ProtoControl/ProtoControl/38_ProtoControl_SD_Fall2023/Software Files/ProtoControlTraining/test/images/IMG_0676_jpg.rf.61e201d2a6559030aaa2d4f4d18f1fff.jpg

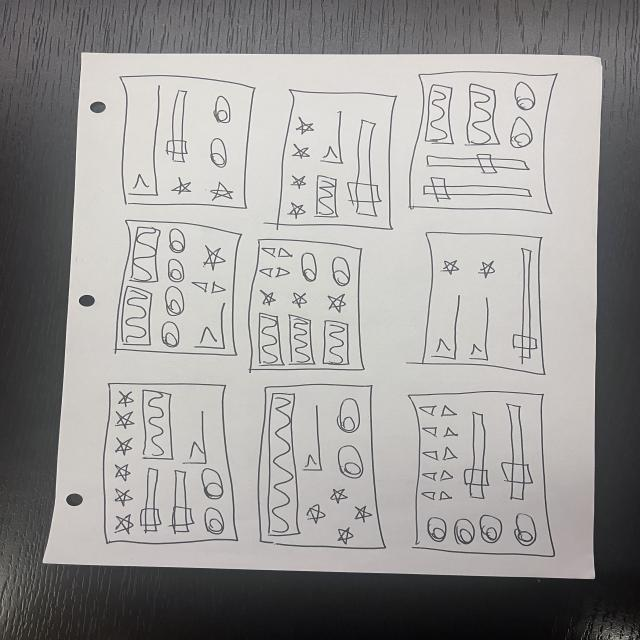
38_ProtoControl_SD_Fall2023/Software Files/ProtoControlTraining/test/images/IMG_0676_jpg.rf.61e201d2a6559030aaa2d4f4d18f1fff.jpg
