ProtoControl/ProtoControl/38_ProtoControl_SD_Fall2023/Software Files/ProtoControlTraining/train/images/IMG_0674_jpg.rf.0b7a89d2eb10f9125c6ddc7b88505ba1.jpg

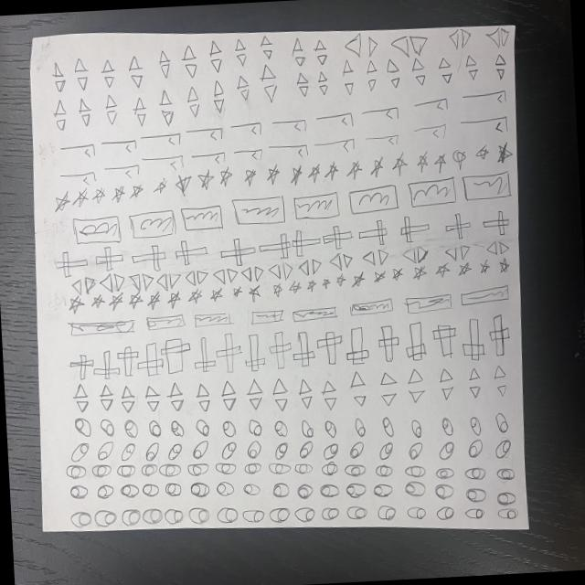
38_ProtoControl_SD_Fall2023/Software Files/ProtoControlTraining/train/images/IMG_0674_jpg.rf.0b7a89d2eb10f9125c6ddc7b88505ba1.jpg
