ProtoControl/ProtoControl/38-Protocontrol-main/SEM 1/README.md

**ProtoControl Website**
- Current Features:
    - Basic HTML/CSS/JS webpage to serve as proof of concept
    - Angular app in early stages of development
