ProtoControl/ProtoControl/38-Protocontrol-main/SEM 1/BasicSite/v1/README.md

*Currently a work in progress!!*
- Canvas logic needs polishing
- Exists to serve as proof of concept
