ProtoControl/ProtoControl/38_ProtoControl_SD_Fall2023/DEMO DAY POSTER/Poster_485_38_Protocontrol.pptx

Problem Statement

User Interfaces are one of the most expensive and time-consuming part of product development and have a steep learning curve.

A plug and play panel with a start-to-finish user interface development experience
Team: Parker Sexton, Kelly Mae Allen, Will Wood, Nida Kosedagi, Abisha Fenn
Mentors: Professor Jim Carlson

System Requirements

- Two wire user interface
- Touchscreen Display
- Interchangeable tactile buttons, knobs, and sliders
- Protective enclosure
- Wide MCU compatibility
- Custom PCB for Main Board and Peripherals
- Cost ~ $100

User Flow

User Designs Layout

Website Generates String

Device requests profile

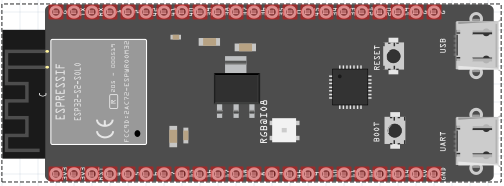
[picture p8: figure]

ESP 32

String decoded into components

User
System

System Architecture Diagram

Draw components from website

Register input from i2c and touchscreen

Send output data

Receive input data

Send status over UART

Website

Design Challenges

- Dynamic Code Structure
- Customizability
- Sharing Profile over Wifi
- Refreshing Profiles on Touchscreen
- Minimal/Intuitive Coding for User
- Hot Swapability of I2C Components
- Compatibility of Arduino Libraries
- Pogo Pin Enclosure

UART

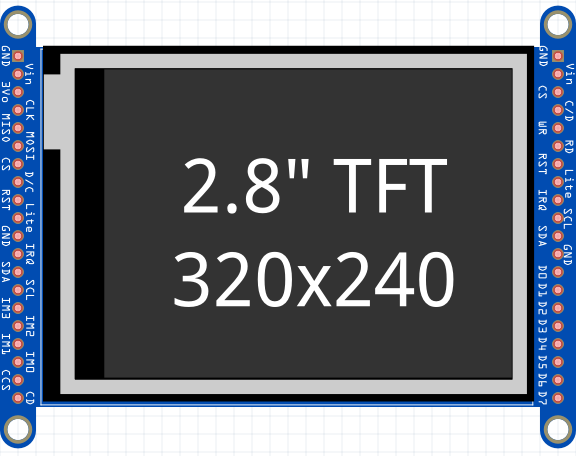
[picture p9: figure]

Peripherals

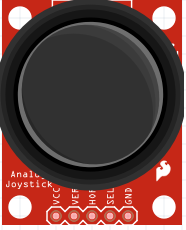
[picture p10: figure]
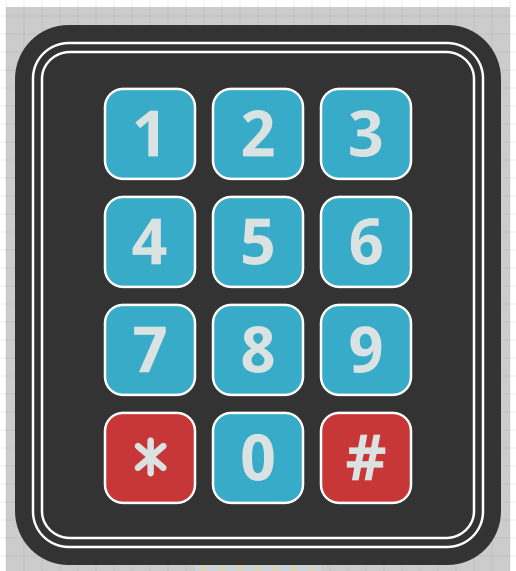
[picture p11: figure]

Embedded System

Notes:
Key Features → System Requirements
