ProtoControl/ProtoControl/38_ProtoControl_SD_Fall2023/Hardware Files/Peripheral Panels Documentation.docx

### Rotary Encoder

Trial 1:

Chip: PCF8574

Arduino Library: (library name)

Breadboard schematic: (fritzing file name)

Arduino Script Name:

References:

Results:

Conclusion:

Trial 2:

Holding all things the same since trial 1

Change:

References:

Results:

Conclusions:
