ProtoControl/ProtoControl/38_ProtoControl_SD_Fall2023/Review-Demos Presentations/HoF Poster Layout.pptx

A plug and play panel with a start-to-finish user interface development experience

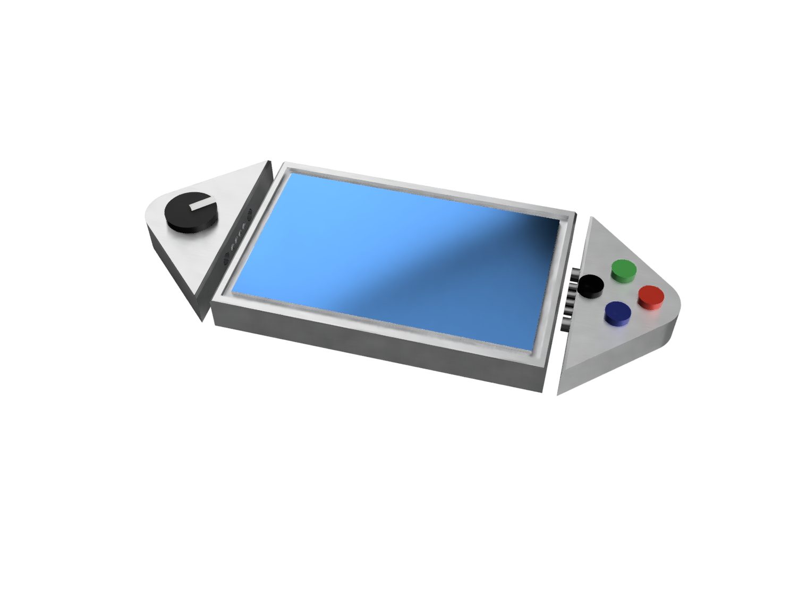
[picture p15: figure]

Key features
- Napkin-to-UI
- No embedded knowledge needed
- Plug and Play design
- Serial communication protocol
- Interchangeable tactile buttons, knobs, and sliders
- Dedicated power supply

Software Support

User Designs Layout

Convert to embedded code

Communicate with device

Interface with user

Design Challenges
- Compatibility with multiple MCUs
- Generating working embedded code
- Controlling user system

Embedded System

Init Components

Draw Static Images

Init Components

Poll Auxiliary Components

Update Console
