ProtoControl/ProtoControl/38_ProtoControl_SD_Fall2023/IDEAS.docx

IDEAS

- Power consumption control by putting processor to sleep 😴
- Custom cable and port design for UART port
- App for UI design
- Output i2c components
