ProtoControl/ProtoControl/38_ProtoControl_SD_Fall2023/TEAM 33 System reqs and utilized features.docx

Parker Sexton

Team 33 colab

Overall system design:

What they need out of a UI:

Multiple profiles

Pic32 mz wfi3e01

5 buttons for pins

Test start button

Pinch test

Slider for cat weight - 0 - 20 - display slider value on slider

Profiles

Using: buttons, sliders, UART,
