ProtoControl/ProtoControl/38_ProtoControl_SD_Fall2023/Serial Communication/Criteria and Constraints.docx

What must the chip + pcb do

- Regular i/o components (not i2c qwicc, no breakout board) must connect to the chip + pcb
- Each input must be addressable once connected to the chip + pcb
  - Can we buy registers/memory
  - Do we want to control which component goes with which address
- If we have a set of 4 components
  - We need to identify which component has control of the sda/scl
- We only need to create the peripheral part of i2c (the master is the mcu)

Links because I can’t find anything on Chrome any more

- https://ww1.microchip.com/downloads/aemDocuments/documents/APID/ProductDocuments/DataSheets/MCP23017-Data-Sheet-DS20001952.pdf
- https://www.microchip.com/en-us/product/mcp23017
- https://www.microchip.com/en-us/products/memory
- https://www.microchip.com/en-us/search?searchQuery=memory&category=ALL&fq=start%3D0%26rows%3D10
- https://www.digikey.com/en/products/detail/adafruit-industries-llc/4648/12751859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
- https://www.digikey.com/en/products/detail/microchip-technology/MCP3427-E-UN/2179259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
- https://www.iascaled.com/store/I2C-MCP3427
- https://ww1.microchip.com/downloads/en/DeviceDoc/22226a.pdf

Resources Document

Parts Spreadsheet

List of Questions and Answers

List of Ideas

List of Tasks presented neatly

Immediate

Long term

Depdendencies

Tabs (10/23)

- https://github.com/adafruit/Adafruit-MCP23017-Arduino-Library/blob/master/examples/mcp23xxx_interrupt/mcp23xxx_interrupt.ino
- https://github.com/adafruit/Adafruit-MCP23017-Arduino-Library/issues/58
- https://github.com/mathertel/RotaryEncoder/blob/master/examples/SimplePollRotator/SimplePollRotator.ino
- https://stackoverflow.com/questions/53457467/arduino-uno-serial-monitor-printing-garbage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,the%20COM%20port%20at%20speed.
- https://www.circuitbasics.com/programming-with-classes-and-objects-on-the-arduino/
- https://forum.arduino.cc/t/how-to-use-pin-4-and-5-for-rotary-encoder-in-arduino-ono/1111326/5
- https://github.com/maxgerhardt/rotary-encoder-over-mcp23017/commit/1699a61b68c2da5667a394357467b778fea39044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
- https://github.com/maxgerhardt/rotary-encoder-over-mcp23017
- https://github.com/maxgerhardt/rotary-encoder-over-mcp23017/blob/master/lib/Rotary-master/Rotary.h
- https://www.simplilearn.com/tutorials/cpp-tutorial/guide-to-understand-cpp-header-files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,cpp%20extension.
