ProtoControl/ProtoControl/38_ProtoControl_SD_Fall2023/Serial Communication/PCF8574 Resources.docx

https://github.com/MSZ98/PCF8574

https://www.instructables.com/PCF8574-GPIO-Extender-With-Arduino-and-NodeMCU/#imadeits

https://github.com/RobTillaart/PCF8574

https://learn.adafruit.com/adafruit-pcf8574/arduino

https://chat.openai.com/c/f145367c-0152-4f5f-8561-aa4d82802014

https://forum.arduino.cc/t/pcf8574a-pushbutton-current-consumption/961533

https://rocelec.widen.net/view/pdf/zsmwgcsqj9/scps068j.pdf?t.download=true&u=5oefqw

https://www.digikey.com/en/products/detail/texas-instruments/PCF8574N/484957

https://learn.adafruit.com/adafruit-pcf8574/downloads
