ProtoControl/ProtoControl/38_ProtoControl_SD_Fall2023/Software Files/Website Update.docx

Add two distinct fields for the user to input

Device Name - a text box for the user to input their custom name for their device, which we have stored on flash memory, gotten from wifi setup via access point

Profile # - a drop down menu (for now) with 1 - 5 options that selects which profile on a given device that you are creating

Example string

Device name - “WillsUI”

Profile - selected 3

String - “WillsUI,3,component_name,component id, etc

The red is the string as is

No new endpoint needed yet, just append to the beginning of the string we already have. We will only change the device profile if we see a matching device name, and will update all profiles at once
