ProtoControl/ProtoControl/38_ProtoControl_SD_Fall2023/UserDocumentation/DemoDayOutline.docx

Intro (Parker)

- Introduce self as Sponsor and assembling the team
- The need for the project
- Engineering Tool!

Everyone Introduces Themselves (Parker → Kelly Mae → Whoever)

Basic Difference b/w User System and ProtoControl (3D Printer Demo) (Kelly Mae)

User Flow (Abisha)

- Device connects to wi-fi
- Drag and Drop (up to 5 profiles)
- Hot Swappable (Prototyping)
- Process the String
- Power

Website (Will)

- Visual Aid of going through the steps of creating a profile

Embedded (Parker)

Hardware Peripherals–Embedded Side (Abisha)

PCB Design (Nida)

Integration (Kelly Mae)

- Testing with Brendan
- Team 33
- Team 18

End with a Demo (Arduino or 306 Car or SPIFFS)

Next Steps
