ProtoControl/ProtoControl/38_ProtoControl_SD_Fall2023/UserDocumentation/Protocontrol Wiki - Planning and Brainstorming.docx

Deliverables:

- User guide/manual
  - Would be provided to every user
  - Covers everything needed to know to use protocontrol
  - Needs to be able to be embedded within website, but also a physical copy should be a priority
  - Iteration 2: Fritzing Diagram,
- Technical Documentation
  - Contains very technical explanations & documentation
  - Wouldn’t be provided standard to users
  - Is useful for providing to instructors, judges, etc., to provide a highly technical overview
  - Shouldn’t be nearly as wordy as the user guide, because it should be largely graphic (UML diagrams, table, schematics, drawings, design justifications)
  - Dimensions/2D CAD Drawings for all the enclosures DONE
  - PCB schematic x2 DONE
  - Fritzing Diagram of what ProtoControl is made of (Main Board + Digital Hardware + Analog Hardware) (SKIP)
  - BILL OF MATERIALS DONE

User Manual Notes:

1. I think one example system that is built on throughout the manual is the best option. But it is important that this system exhibits a need for all the features it will be used to demonstrate. We shouldn't have to force features to work with/be necessary in the demo system
2. The organization of the manual is subject to change, but for now, the overall structure is to begin with all the general info (Part 1), organized chronologically by when it would be relevant to a user, then the second and final 30-50% of the book should be the actual step by step setup guide (Part 2)
3. For sections such as troubleshooting info, this is relevant for each section but doesn’t need to be included in each section. Most users won’t need to troubleshoot in regular use cases, so we should probably just have one section dedicated to all of troubleshooting, and we simply reference that section/subsection throughout the manual whenever it may be helpful

### User Manual:

Sections:

1. Preface
  a. Title Pages
  b. Table of Contents
2. Getting Started (about Protocontrol)
  a. What is needed from the user
  b. What is provided by protocontrol
  c. How it works
  d. Example system??
3. The Web interface
  a. Designing a layout
    i. What are the components
    ii. How to place/configure components
    iii. Example System??
  b. Generating a layout
    i. Image processing overview
    ii. Load previous layout (feature is WIP)
    iii. Generate current design
4. The Protocontrol system
  a. Overview
    i. Brief description of parts
    ii. Protocontrol Setup (Wifi, power, etc.)
  b. Assembling Physical components
    i. What are the components
    ii. Limitations
    iii. Example System??
  c. Retrieving your layout
