ProtoControl/ProtoControl/38_ProtoControl_SD_Fall2023/UserDocumentation/BoM.pdf

Bill of Materials
Part description | Part number | Footprint | Qty | Unit Price | Total Price | Vendor | Link
PCBs [1]
Main PCB | -- | | 1 | $1.40 | $1.40 | JLCPCB | https://jlcpcb.com/user-center/orders/?url=https%3A%2F%2Fjlcpcb.com%2Fuser-center%2Forders%2F&_t=1701177920164
Compinent PCB | -- | | 4 | $1.40 | $5.60 | JCLPCB | https://jlcpcb.com/user-center/orders/?url=https%3A%2F%2Fjlcpcb.com%2Fuser-center%2Forders%2F&_t=1701177920164
ICs
PCF8574 SM Chip | 296-13108-1-ND - Cut Tape (CT) | | 3 | $1.86 | $5.58 | Digikey | https://www.digikey.com/en/products/detail/texas-instruments/PCF8574DWR/484579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
ADS1115 Chip | 1528-1461-ND | | 1 | $14.95 | $14.95 | Digikey | https://www.digikey.com/en/products/detail/adafruit-industries-llc/1085/5761229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
Enclosure
Magnetic Connectors | 5358 | | 2 | $6.50 | $13.00 | Adafruit | https://www.adafruit.com/product/5358
Pogo Pins | ED8180-ND | | 16 | $0.42 | $6.72 | Digikey | https://www.digikey.com/en/products/detail/mill-max-manufacturing-corp/0906-0-15-20-76-14-11-0/1147048
3D Print (Main Board,
Joystick, Keypad, Rotary
Encoder) | -- | | 0.33 | $30.00 | $9.90 | Prusament | https://prusament.com/materials/pla/
Solder | KE1101-ND | | 0.3 | $54.00 | $16.20 | Digikey | https://www.digikey.com/en/products/detail/kester-solder/24-6337-0039/31099
Stranded Wire | 1175-1015-24-1-2000-004-1-TS-DS-ND | | 1 | $0.58 | $0.58 | Digikey | https://www.digikey.com/en/products/detail/cnc-tech/1015-24-1-2000-004-1-TS/17799199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
Crimp | WM18889TR-ND - Tape & Reel (TR) | | 4 | $0.08 | $0.31 | Digikey | https://www.digikey.com/en/products/detail/molex/0008701039/765268
Main Panel
ESP 32-S3 | 5477 | https://learn.adafruit.com/adafruit-esp32-s3-feather/downloads 1 | $19.95 | $19.95 | Digikey | https://www.adafruit.com/product/5477
Capacitive Touchscreen | 1528-2848-ND | | 1 | $29.95 | $29.95 | Digikey | https://www.digikey.com/en/products/detail/adafruit-industries-llc/2090/9919535
LED | 732-5008-ND | | 1 | $0.15 | $0.15 | Digikey | https://www.digikey.com/en/products/detail/w%C3%BCrth-elektronik/151031VS06000/4489988
Buttons | EG5455-ND | | 2 | $0.36 | $0.72 | Digikey | https://www.digikey.com/en/products/detail/e-switch/TL1105YF160Q/514438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
Barrel Jack Connector | 839-54-00166-ND | | 1 | $0.74 | $0.74 | Digikey | https://www.digikey.com/en/products/detail/tensility-international-corp/54-00166/10459294
4x1 Header, | S1131EC-20-ND | | 1 | $0.56 | $0.56 | Digikey | https://www.digikey.com/en/products/detail/sullins-connector-solutions/PRPC020SACN-RC/2776086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
20x1 Header | 732-61302011821-ND | | 2 | $0.93 | $1.86 | Digikey | https://www.digikey.com/en/products/detail/w%C3%BCrth-elektronik/61302011821/16608603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
I2C Components
Rotary Encoder | 377 | | 1 | $4.50 | $4.50 | Adafruit | https://www.adafruit.com/product/377
Keypad | 3845 | | 1 | $6.50 | $6.50 | Adafruit | https://www.adafruit.com/product/3845
Joystick | 512 | | 1 | $5.95 | $5.95 | Adafruit | https://www.adafruit.com/product/512
Wiring
Barrel Jack to USB Cable | 1528-2429-ND | | 1 | $6.50 | $6.50 | Digikey | https://www.digikey.com/en/products/detail/adafruit-industries-llc/2777/7807992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
UART (4-wire) Cable* | -- | | 1 | $1.00 | $1.00 | Custom
Total Cost: | | | | | $152.62

[1] These are example categories. Look at the example.
