ProtoControl/ProtoControl/38_ProtoControl_SD_Fall2023/Design Documents/Protocontrol V1 Action Items _ tasks.xlsx

Hardware
Embedded code for Cap screen | Getting screen to display interactable icons, defining reigons of touch, and creating an interactable demo
Panel Interface | Passthrough panel that sits between the screen and arduino, intercepting unused digital pins to allow for additonal hardware components
Enclosure | 3D printed enclosure that holds the screen and provides sockets for physical hardware components from panel
Example device | Creation of an example device that uses the protocontrol user interface to demonstrate its functionality. possibly a tempreture monitor, or servo array, must feature digital and analog outputs
Software
YOLO (Multiple Object Detection Algorithm)\ | Local program that can identify UI components from a list of pre defined and trained drawings
Web Drag and Drop interface | One stop shop website with intuitive navigation that hosts the angular algoritham and walkthrough guides, schematics, datasheets and tutorials
Other
PDF guides | High level walkthrough of how to assemble and implement protocontrol
Video walkthrough | Full low level stepthrough at a middle school level
