ProtoControl/ProtoControl/38_ProtoControl_SD_Fall2023/Review-Demos Presentations/Poster for Hall of Fame.pptx

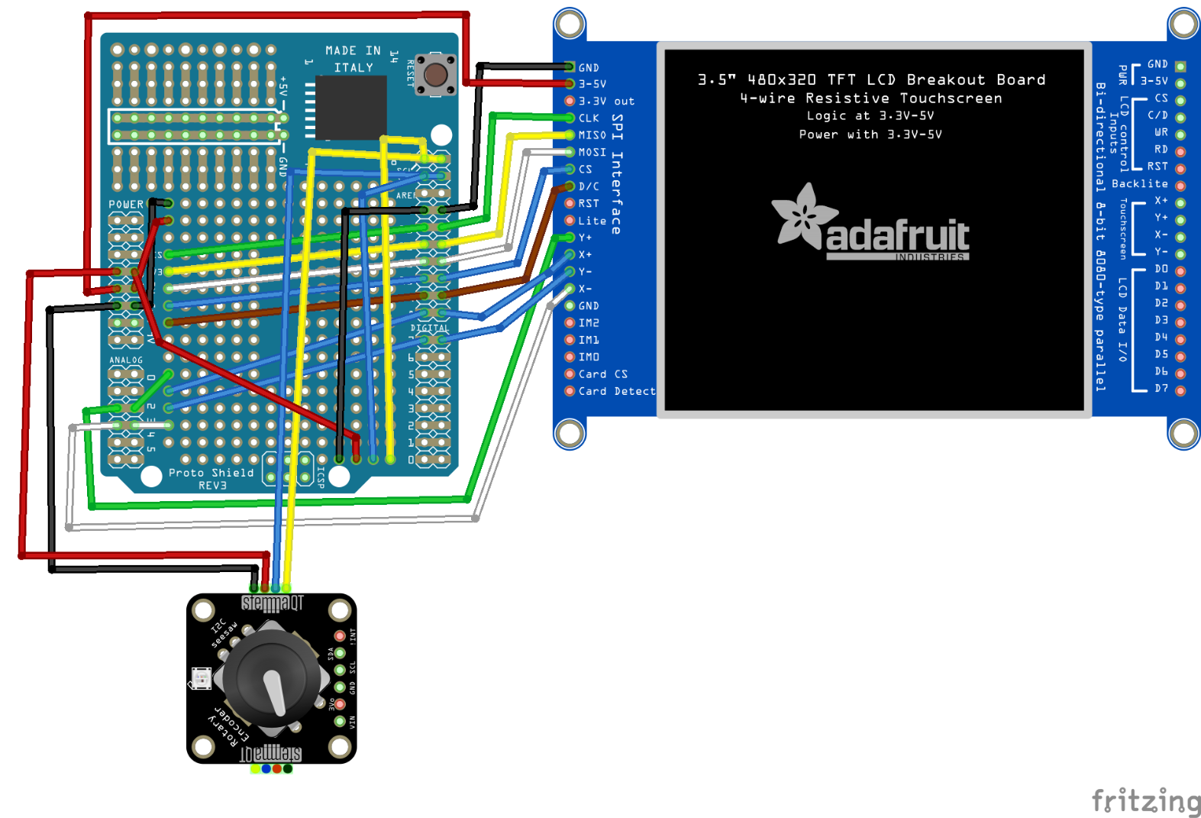
[picture p26: figure]
