ProtoControl/ProtoControl/38_ProtoControl_SD_Fall2023/Serial Communication/Design Principles & Ideas to Incorporate.docx

- Pipeline Control to be more efficient
- Have resources busy each clock cycle
- Identify Critical BottleNecks, synthesize and see what we can need clock-wise; check data sheets
- Make smaller, parameterized modules (for the sake of re-usability)
  - -include a file that includes all parameters
- Would we ever need to switch clocks midway (for reset purposes)?
- Keep always @ posedge clocks block with reset separate from those without reset
