ProtoControl/ProtoControl/38_ProtoControl_SD_Fall2023/Review-Demos Presentations/PDR/PLAYGROUND_ Preliminary_Design_Review_ProtoControl_Group_38.pptx

## ProtoControl

Kelly Mae Allen, Abisha Fenn, Nida Kosedagi, Parker Sexton, William Wood

## Overview

I. Project Introduction
II. System Design
III. Tech Demo Plans
IV. Project Plan
V. Mock-up/ Product Demo

Notes: https://24slides.com/templates/view/corporate-business-models/company-profile-presentation-template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

https://24slides.com/templates/view/corporate-business-models/strategic-action-plan-ppt-template

https://24slides.com/templates/featured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

## What is PROTOControl?

## System Design

## System Concept Drawing

## System Functional Block Diagram

## User Flow Chart

## Software

## Software Introduction

3 prong approach to software:
1. Website - Angular, Front End, User Interface
2. AI/Cloud Computing - Back End, AWS, YOLOv5
3. Embedded Code - Auto generated, Design UI for ProtoControl

## Website

## Software Introduction

3 prong approach to software:
1. Website - Angular, Front End, User Interface
2. AI/Cloud Computing - Back End, AWS, YOLOv5
3. Embedded Code - Auto generated, Design UI for ProtoControl

## Slide 12

## AI/Cloud Computing

## Software Introduction

3 prong approach to software:
1. Website - Angular, Front End, User Interface
2. AI/Cloud Computing - Back End, AWS, YOLOv5
3. Embedded Code - Auto generated, Design UI for ProtoControl

## Embedded Code Generation

## Embedded Software

## ProtoPad Icons

Pre defined functions

Press

Off

## Custom PCB Design

## Serial Communication IC and Physical Connection

## Enclosure Modeling + Aesthetics

## Tech Demo Plans

## Project Plan

## Roles and Responsibilities

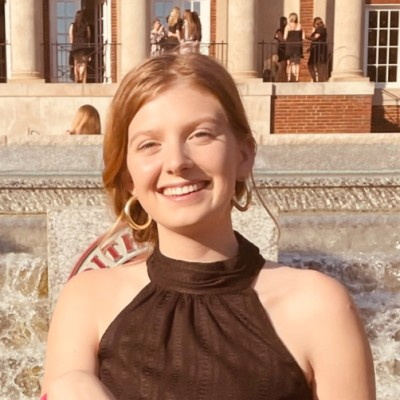
[picture p27: figure]

Kelly Mae Allen (Project Lead)
Primary:
Secondary:

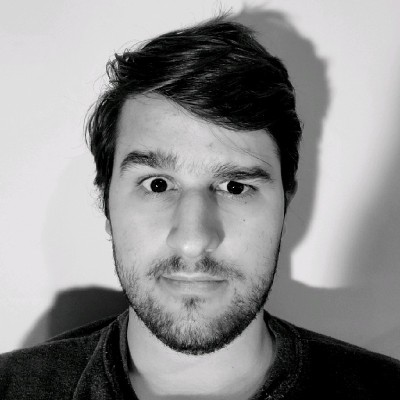
[picture p28: figure]

Parker Sexton (Project Sponsor)
Primary
Secondary

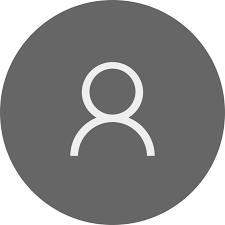
[picture p29: figure]

Will Wood
Primary
Secondary

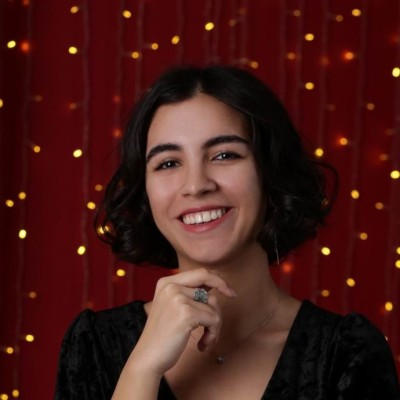
[picture p30: figure]

Nida Kosedagi
Primary
Secondary

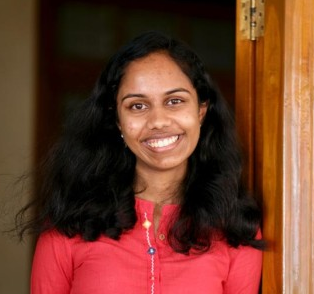
[picture p31: figure]

Abisha Fenn
Primary
Secondary

## Project Timeline

## Cost Estimate

## Mock-up and Product Demo

## Slide 27

## Slide 28
