ProtoControl/ProtoControl/38_ProtoControl_SD_Fall2023/Branding/TEMPLATE.pptx

## THIS IS YOUR PRESENTATION TITLE

Notes: https://24slides.com/presentbetter/ultimate-powerpoint-template-guide

https://blog.hubspot.com/blog/tabid/6307/bid/6012/17-examples-of-great-presentation-design.aspx

## Instructions for use

EDIT IN POWERPOINT®
Click on the button under the presentation preview that says "Download as PowerPoint template". You will get a .pptx file that you can edit in PowerPoint.
Remember to download and install the fonts used in this presentation (you’ll find the links to the font files needed in the Presentation design slide)

EDIT IN GOOGLE SLIDES
Click on the button under the presentation preview that says "Use as Google Slides Theme".
You will get a copy of this document on your Google Drive and will be able to edit, add or delete slides.
You have to be signed in to your Google account.

More info on how to use this template at www.slidescarnival.com/help-use-presentation-template
This template is free to use under Creative Commons Attribution license (http://www.slidescarnival.com/copyright-and-legal-information). You can keep the Credits slide or mention SlidesCarnival and other resources used in a slide footer.

## HELLO!

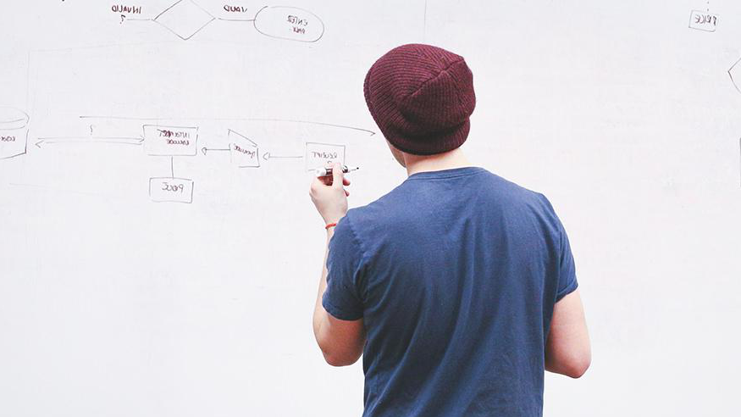
[picture p32: figure]

I am Jayden Smith
I am here because I love to give presentations.
You can find me at @username

## Slide 4

## 1. Transition headline

Let’s start with the first set of slides

## Slide 6

Quotations are commonly printed as a means of inspiration and to invoke philosophical thoughts from the reader.

## This is a slide title

- Here you have a list of items
- And some text
- But remember not to overload your slides with content
Your audience will listen to you or read the content, but won’t do both.

## BIG CONCEPT

Bring the attention of your audience over a key concept using icons or illustrations

## You can also split your content

White
Is the color of milk and fresh snow, the color produced by the combination of all the colors of the visible spectrum.

Black
Is the color of ebony and of outer space. It has been the symbolic color of elegance, solemnity and authority.

## In two or three columns

Yellow
Is the color of gold, butter and ripe lemons. In the spectrum of visible light, yellow is found between green and orange.

Blue
Is the colour of the clear sky and the deep sea. It is located between violet and green on the optical spectrum.

Red
Is the color of blood, and because of this it has historically been associated with sacrifice, danger and courage.

## Slide 11

## A picture is worth a thousand words

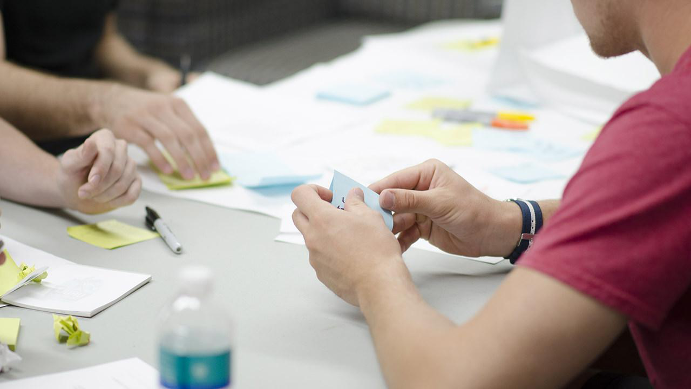
[picture p33: figure]

A complex idea can be conveyed with just a single still image, namely making it possible to absorb large amounts of data quickly.

## Want big impact? USE BIG IMAGE

## Use charts to explain your ideas

White

Gray

Black

## And tables to compare data

| A | B | C
Yellow | 10 | 20 | 7
Blue | 30 | 15 | 10
Orange | 5 | 24 | 16

## Maps

our office

## 89,526,124

Whoa! That’s a big number, aren’t you proud?

## 89,526,124$ 100% 185,244 users

That’s a lot of money

And a lot of users

Total success!

## Our process is easy

first

second

last

## Let’s review some concepts

Yellow
Is the color of gold, butter and ripe lemons. In the spectrum of visible light, yellow is found between green and orange.

Blue
Is the colour of the clear sky and the deep sea. It is located between violet and green on the optical spectrum.

Red
Is the color of blood, and because of this it has historically been associated with sacrifice, danger and courage.

Yellow
Is the color of gold, butter and ripe lemons. In the spectrum of visible light, yellow is found between green and orange.

Blue
Is the colour of the clear sky and the deep sea. It is located between violet and green on the optical spectrum.

Red
Is the color of blood, and because of this it has historically been associated with sacrifice, danger and courage.

## Slide 21

4000
3000
2000
1000
0

You can insert graphs from Excel and Google Sheets

## Slide 22

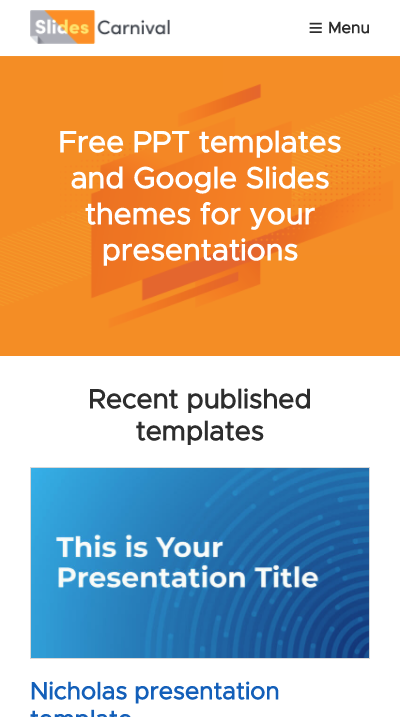
[picture p34: figure]

MOBILE
PROJECT
Show and explain your web, app or software projects using these gadget templates.

## Slide 23

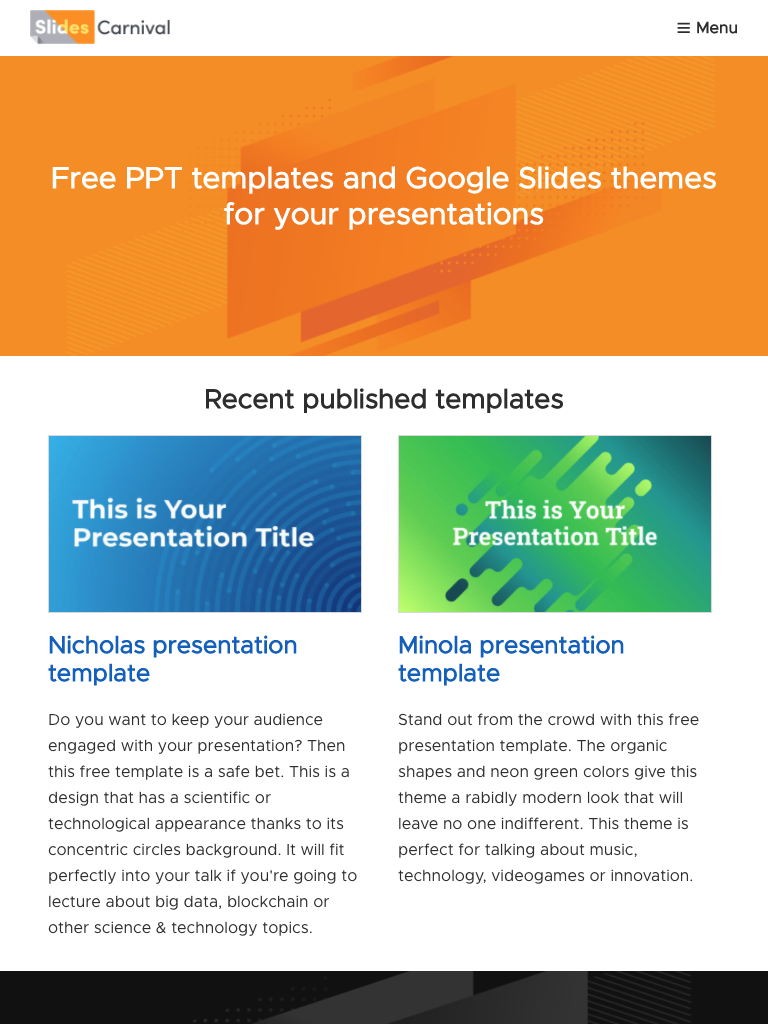
[picture p35: figure]

TABLET
PROJECT
Show and explain your web, app or software projects using these gadget templates.

## Slide 24

DESKTOP PROJECT
Show and explain your web, app or software projects using these gadget templates.

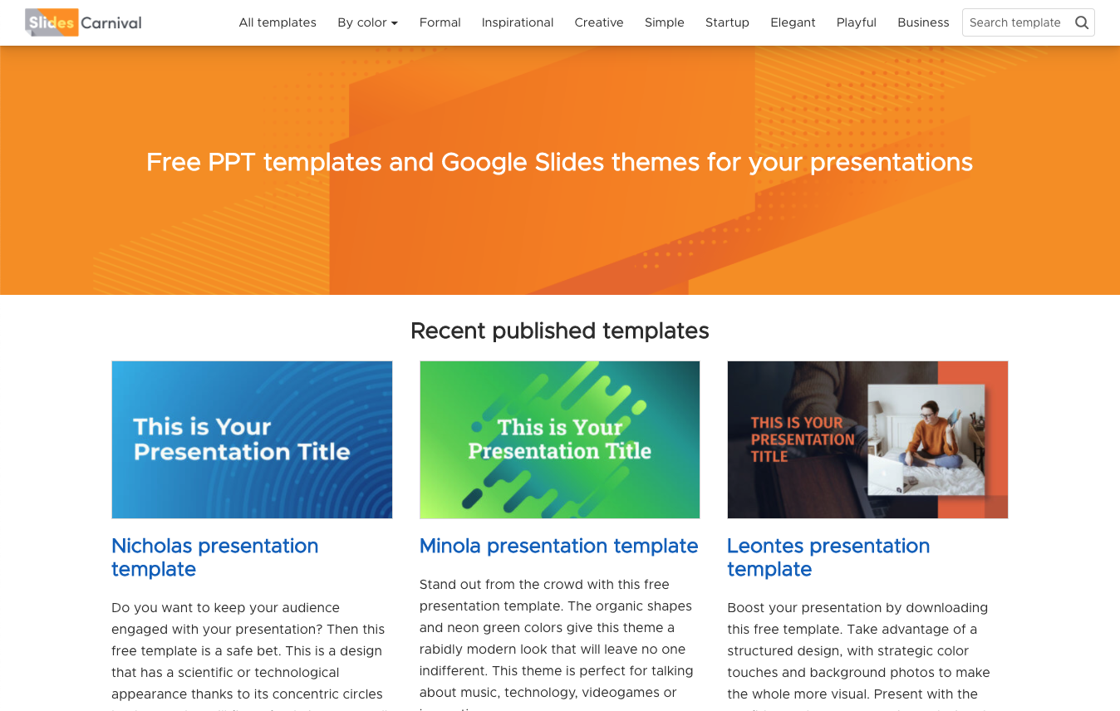
[picture p36: figure]

## THANKS!

Any questions?
You can find me at @username & user@mail.me

## Credits

Special thanks to all the people who made and released these awesome resources for free:
- Presentation template by SlidesCarnival (http://www.slidescarnival.com/)
- Photographs by Startupstockphotos (http://startupstockphotos.com/)

## Presentation design

This presentation uses the following typographies and colors:
- Titles: Dosis
- Body copy: Roboto
You can download the fonts on these pages:
https://www.fontsquirrel.com/fonts/dosis
https://material.google.com/resources/roboto-noto-fonts.html
- Orange #ff8700

You don’t need to keep this slide in your presentation. It’s only here to serve you as a design guide if you need to create new slides or download the fonts to edit the presentation in PowerPoint®

## 2. Extra Resources

For Business Plans, Marketing Plans, Project Proposals, Lessons, etc

## Timeline

Blue is the colour of the clear sky and the deep sea

Red is the colour of danger and courage

Black is the color of ebony and of outer space

Yellow is the color of gold, butter and ripe lemons

White is the color of milk and fresh snow

Blue is the colour of the clear sky and the deep sea

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
Yellow is the color of gold, butter and ripe lemons

White is the color of milk and fresh snow

Blue is the colour of the clear sky and the deep sea

Red is the colour of danger and courage

Black is the color of ebony and of outer space

Yellow is the color of gold, butter and ripe lemons

## Roadmap

Blue is the colour of the clear sky and the deep sea

Red is the colour of danger and courage

Black is the color of ebony and of outer space

1

3

5

2

4

6

Yellow is the color of gold, butter and ripe lemons

White is the color of milk and fresh snow

Blue is the colour of the clear sky and the deep sea

## Gantt chart

| Week 1 | | | | | | | Week 2
| 1 | 2 | 3 | 4 | 5 | 6 | 7 | 8 | 9 | 10 | 11 | 12 | 13 | 14
Task 1
Task 2 | | | | | | ◆
Task 3
Task 4 | | | | | | | | | | | ◆
Task 5 | | | | | | | | | ◆
Task 6
Task 7
Task 8

## SWOT Analysis

STRENGTHS
Blue is the colour of the clear sky and the deep sea

Black is the color of ebony and of outer space
OPPORTUNITIES

WEAKNESSES
Yellow is the color of gold, butter and ripe lemons

White is the color of milk and fresh snow
THREATS

S

W

O

T

## Business Model Canvas

Key Partners
Insert your content

Key Activities
Insert your content

Key Resources
Insert your content

Value Propositions
Insert your content

Customer Relationships
Insert your content

Channels
Insert your content

Customer Segments
Insert your content

Cost Structure
Insert your content

Revenue Streams
Insert your content

## Funnel

AWARENESS

DISCOVERY

EVALUATION

INTENT

PURCHASE

LOYALTY

Insert your content

Insert your content

Insert your content

Insert your content

Insert your content

Insert your content

## Team Presentation

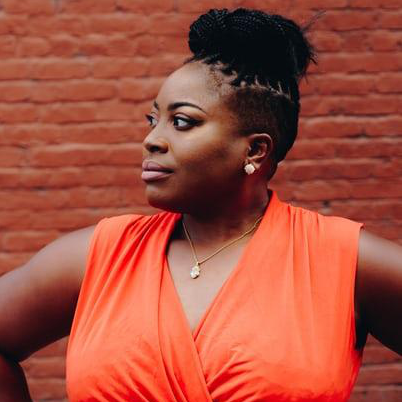
[picture p37: figure]

Imani Jackson
JOB TITLE
Blue is the colour of the clear sky and the deep sea

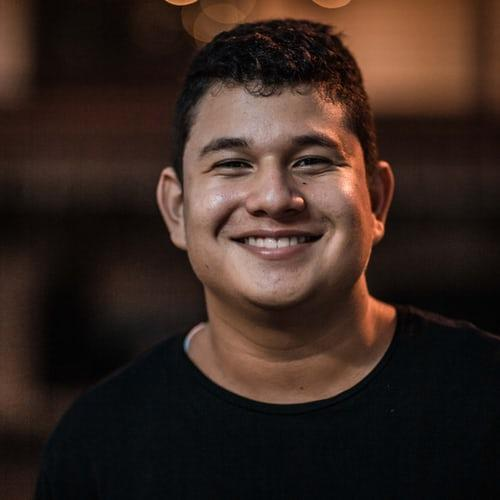
[picture p38: figure]

Marcos Galán
JOB TITLE
Blue is the colour of the clear sky and the deep sea

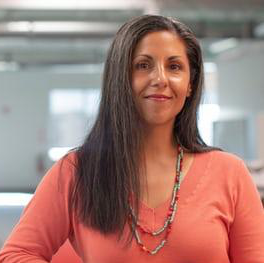
[picture p39: figure]

Ixchel Valdía
JOB TITLE
Blue is the colour of the clear sky and the deep sea

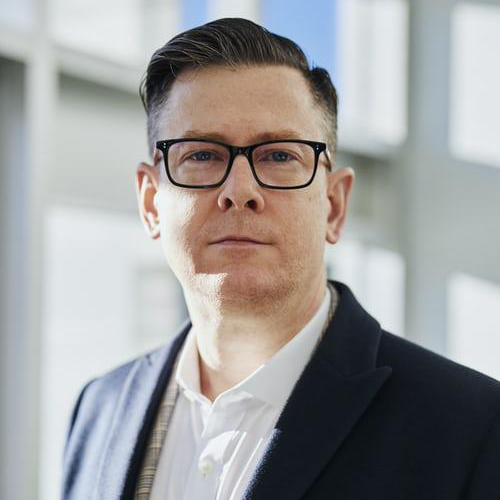
[picture p40: figure]

Nils Årud
JOB TITLE
Blue is the colour of the clear sky and the deep sea

## Competitor Matrix

HIGH VALUE 2

Competitor

Competitor

Our company

Competitor

LOW VALUE 1

HIGH VALUE 1

Competitor

Competitor

Competitor

LOW VALUE 2

## Weekly Planner

| SUNDAY | MONDAY | TUESDAY | WEDNESDAY | THURSDAY | FRIDAY | SATURDAY
9:00 - 9:45 | Task | Task | Task | Task | Task | Task | Task
10:00 - 10:45 | Task | Task | Task | Task | Task | Task | Task
11:00 - 11:45 | Task | Task | Task | Task | Task | Task | Task
12:00 - 13:15 | ✔ Free time | ✔ Free time | ✔ Free time | ✔ Free time | ✔ Free time | ✔ Free time | ✔ Free time
13:30 - 14:15 | Task | Task | Task | Task | Task | Task | Task
14:30 - 15:15 | Task | Task | Task | Task | Task | Task | Task
15:30 - 16:15 | Task | Task | Task | Task | Task | Task | Task

## Slide 38

SlidesCarnival icons are editable shapes.
This means that you can:
- Resize them without losing quality.
- Change line color, width and style.
Isn’t that nice? :)
Examples:

## Diagrams and infographics

## Slide 40

You can also use any emoji as an icon!
And of course it resizes without losing quality.
How? Follow Google instructions https://twitter.com/googledocs/status/730087240156643328

✋👆👉👍👤👦👧👨👩👪💃🏃💑❤😂😉😋😒😭👶😸🐟🍒🍔💣📌📖🔨🎃🎈🎨🏈🏰🌏🔌🔑 and many more...

## Slide 41

Free templates for all your presentation needs

For PowerPoint and Google Slides

100% free for personal or commercial use

Ready to use, professional and customizable

Blow your audience away with attractive visuals

## Slide 42

## Slide 43

## Slide 44

## Slide 45

## Slide 46

## Slide 47

## Slide 48

## Slide 49

## Slide 50

## Slide 51

## Slide 52

## Slide 53

1

Lorem ipsum dolor sit amet nec at adipiscing

- Lorem ipsum dolor sit
- amet nec at adipiscing
- risus at dolor porta

1

Lorem ipsum dolor sit amet nec at adipiscing

- Lorem ipsum dolor sit
- amet nec at adipiscing
- risus at dolor porta

Lorem ipsum

Lorem ipsum

Dolor nec

Dolor nec

Ipsum dolor amet dolor

Ipsum dolor amet dolor

2

Lorem ipsum dolor sit amet nec at adipiscing

- Lorem ipsum dolor sit
- amet nec at adipiscing
- risus at dolor porta

2

Lorem ipsum dolor sit amet nec at adipiscing

- Lorem ipsum dolor sit
- amet nec at adipiscing
- risus at dolor porta

3

Lorem ipsum dolor sit amet nec at adipiscing

- Lorem ipsum dolor sit
- amet nec at adipiscing
- risus at dolor porta

3

Lorem ipsum dolor sit amet nec at adipiscing

- Lorem ipsum dolor sit
- amet nec at adipiscing
- risus at dolor porta

## Slide 54

Lorem ipsum

Lorem ipsum

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
Lorem ipsum

Lorem ipsum

Lorem ipsum

LOREM

## Slide 55

07

W1

W2

W3

W4

Lorem ipsum

08

W1

W2

W3

W4

Lorem ipsum

09

W1

W2

W3

W4

Lorem ipsum

10

W1

W2

W3

W4

Lorem ipsum

Lorem ipsum

LOREM

## Slide 56

## Slide 57
