ProtoControl/ProtoControl/38_ProtoControl_SD_Fall2023/Review-Demos Presentations/Project Introduction_38Protocontrol_Fall_2023.pptx

## Project Introduction <Project number> <Project Title>, <team members>, <sponsors>

Project Need:
- Consistent and easy way to inspect
- Automated and better way to detect faults
- Easy way to log and learn from faults
Key Requirements:
- Inexpensive
- Easy to Reproduce
- Automated
- Efficient
Target Customer:
How will they use it
Basic system design / operation

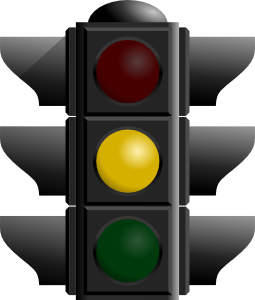
[picture p44: figure]
Traffic Light: Yellow Clip Art

Concept Drawing/ Picture / Video which can be used as a prop to explain your project.

Notes: Think of describing the problem and what you are doing, to someone of a non-technical background. Think of a way to tell a short story that engages the audience. This speaks to the validating the Project Need, then Key Requirements, followed by your customers and how they use it, and finally a brief high level description of how the system works. Try to refrain from “Jargon.” This is all supported by the “Cartoon.”Remember that this is also getting you ready for Design Day when you have just a few minutes to describe your project to the judges/public.

Notes: Think of describing the problem and what you are doing to someone of a non-technical background. Think of a way to tell a short story that engages the audience. This speaks to the validating the Project Need, then Key Requirements, followed by your customers and how they use it, and finally a brief high level description of how the system works. Try to refrain from “Jargon.” This is all supported by the “Cartoon.”
Remember that this is also getting you ready for Design Day when you have just a few minutes to describe your project to the judges/public.
