ProtoControl/ProtoControl/38_ProtoControl_SD_Fall2023/Review-Demos Presentations/Program Reviews/NOtes.docx

NOtes

Need:

Block digram (system)

Introduction slides

Link to team charter

TODO

Update project abstract - parker

Update subsystem timeline - all

B,C,D,E,F everyone add one line to the team charter

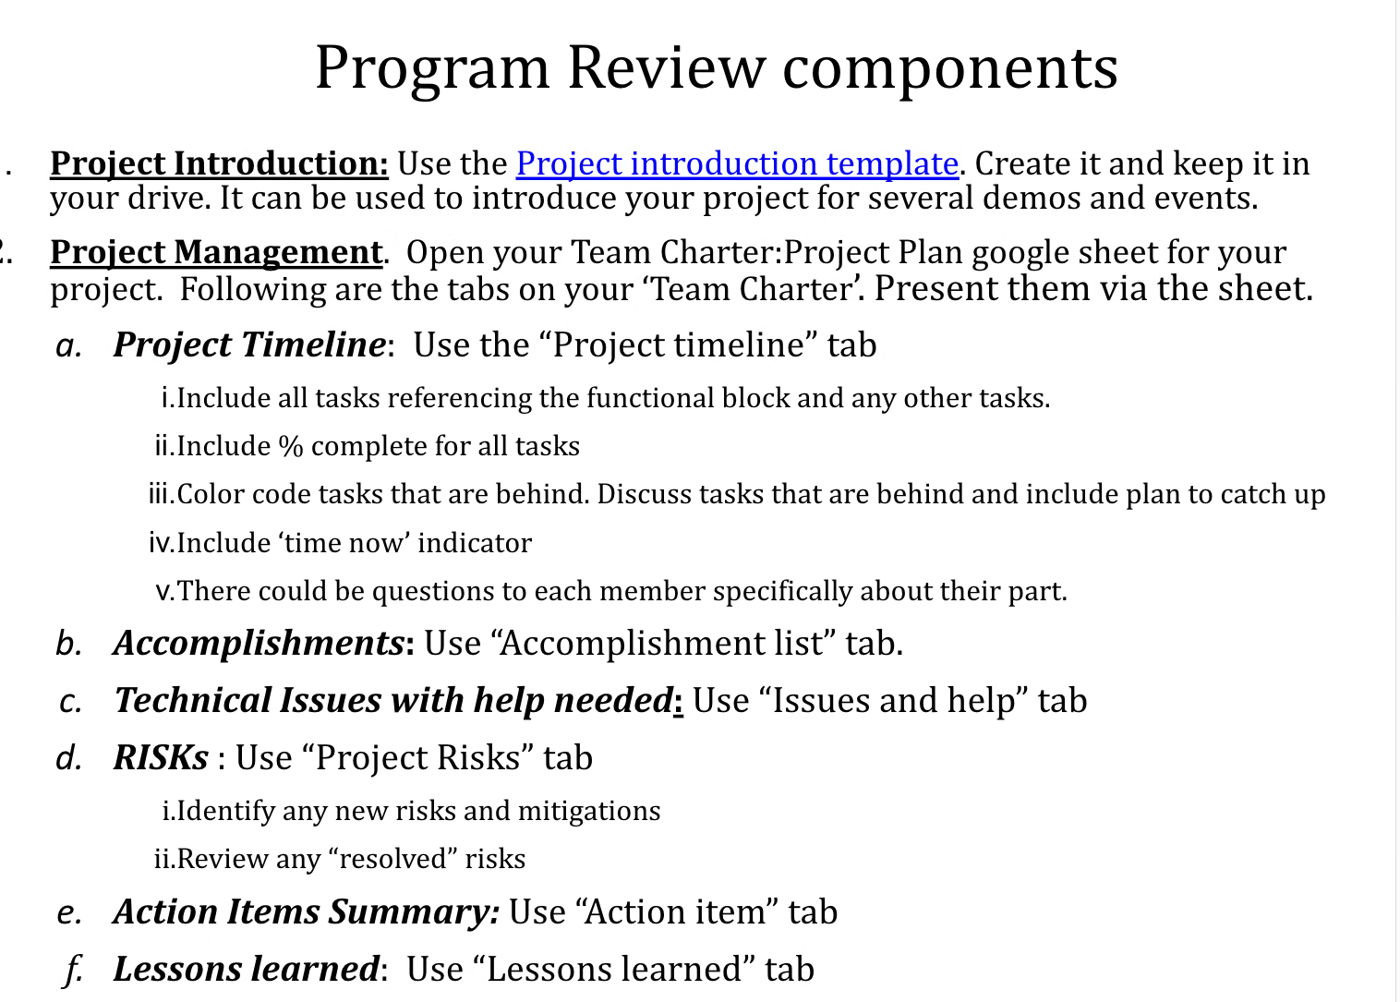
[picture p45: figure]
