ProtoControl/ProtoControl/38-Protocontrol-main/SEM 1/Proto_white.jpg

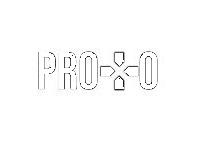
38-Protocontrol-main/SEM 1/Proto_white.jpg
