ProtoControl/ProtoControl/38_ProtoControl_SD_Fall2023/Branding/Color Scheme (9-30).jpg

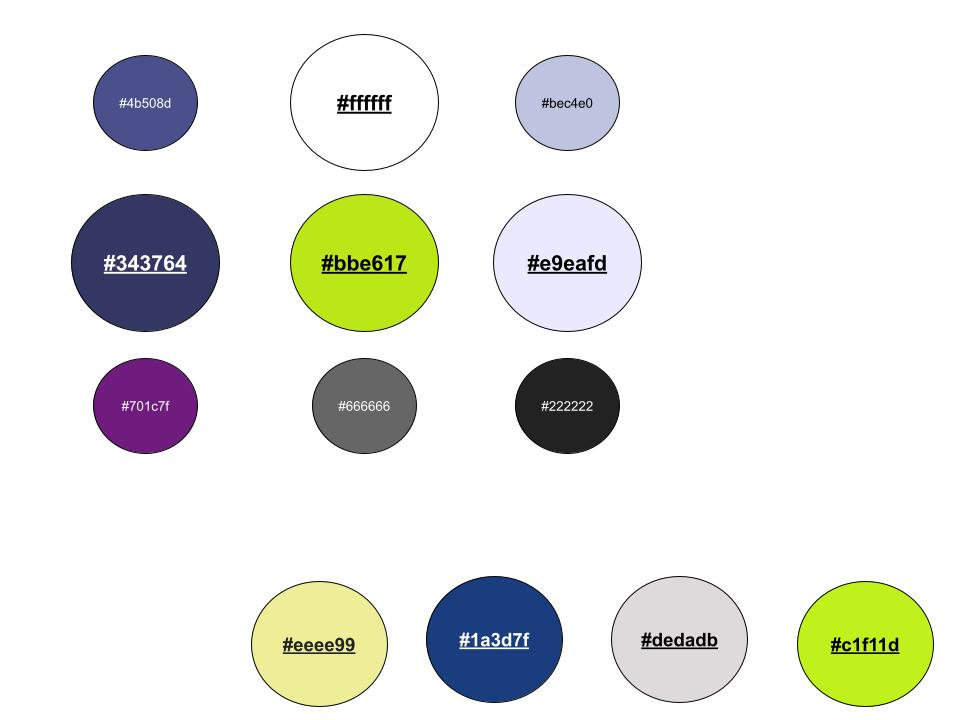
38_ProtoControl_SD_Fall2023/Branding/Color Scheme (9-30).jpg
