ProtoControl/ProtoControl/38_ProtoControl_SD_Fall2023/DEMO DAY POSTER/Poster_485_38_Protocontrol (1).jpg

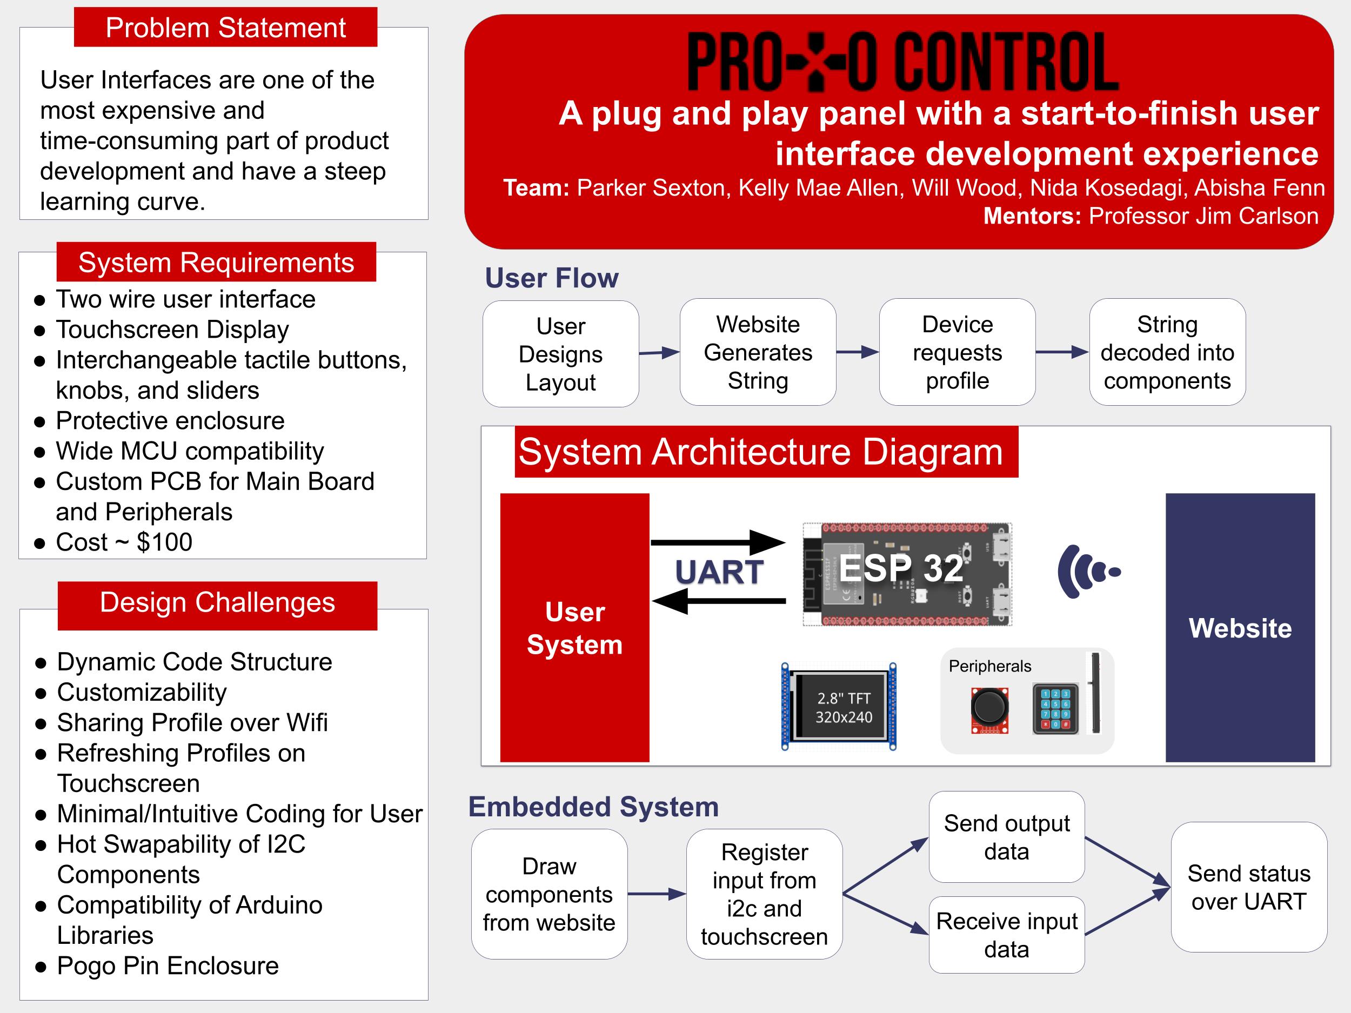
38_ProtoControl_SD_Fall2023/DEMO DAY POSTER/Poster_485_38_Protocontrol (1).jpg
