ProtoControl/ProtoControl/38_ProtoControl_SD_Fall2023/Design Documents/System Architecture Drawings-Diagrams/SystemArchitectureDiagrams-Functional Block Diagram 2.jpg

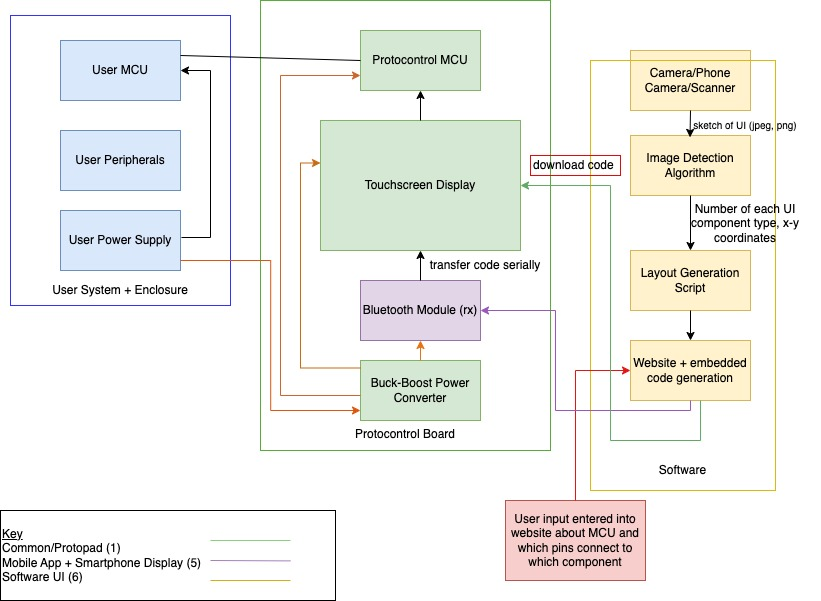
38_ProtoControl_SD_Fall2023/Design Documents/System Architecture Drawings-Diagrams/SystemArchitectureDiagrams-Functional Block Diagram 2.jpg
