ProtoControl/ProtoControl/38_ProtoControl_SD_Fall2023/Design Documents/System Architecture Drawings-Diagrams/SystemArchitectureDiagrams-Functional Block Diagram 3(1).jpg

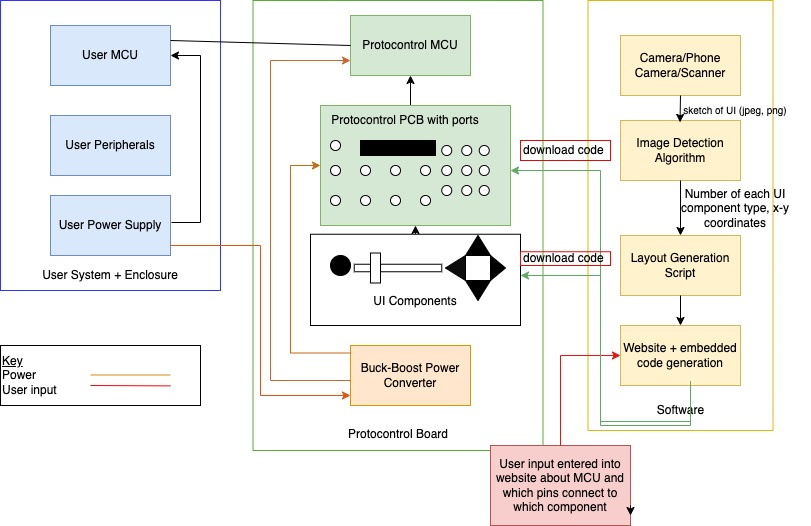
38_ProtoControl_SD_Fall2023/Design Documents/System Architecture Drawings-Diagrams/SystemArchitectureDiagrams-Functional Block Diagram 3(1).jpg
