ProtoControl/ProtoControl/38_ProtoControl_SD_Fall2023/Design Documents/System Architecture Drawings-Diagrams/SystemArchitectureDiagrams-Physical2 UI.jpg

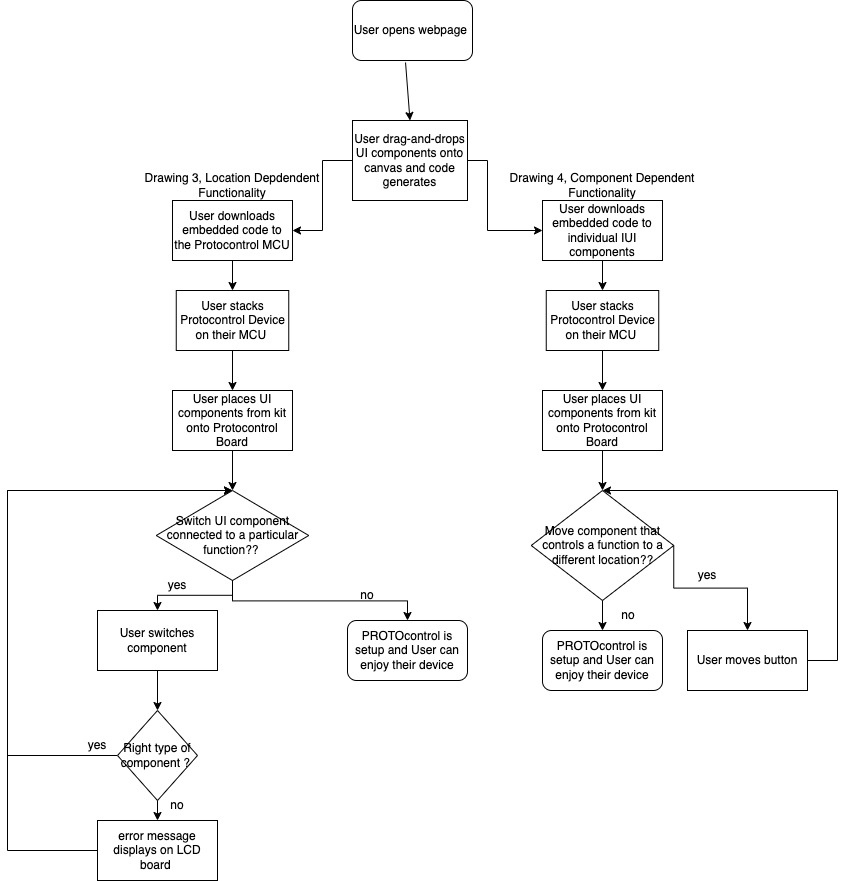
38_ProtoControl_SD_Fall2023/Design Documents/System Architecture Drawings-Diagrams/SystemArchitectureDiagrams-Physical2 UI.jpg
