ProtoControl/ProtoControl/38_ProtoControl_SD_Fall2023/Hardware Files/Schematic_PCB_CAD Files/adafruit_products_35bobschem.png

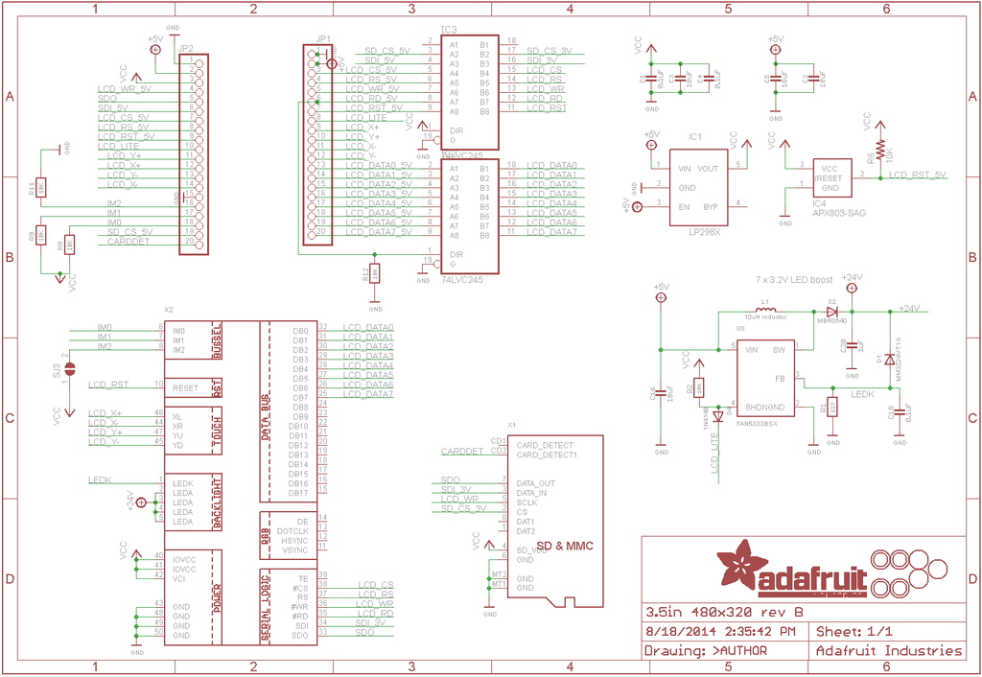
38_ProtoControl_SD_Fall2023/Hardware Files/Schematic_PCB_CAD Files/adafruit_products_35bobschem.png
