ProtoControl/ProtoControl/38_ProtoControl_SD_Fall2023/Hardware Files/Schematic_PCB_CAD Files/ProtoControl Ptype_bb.png

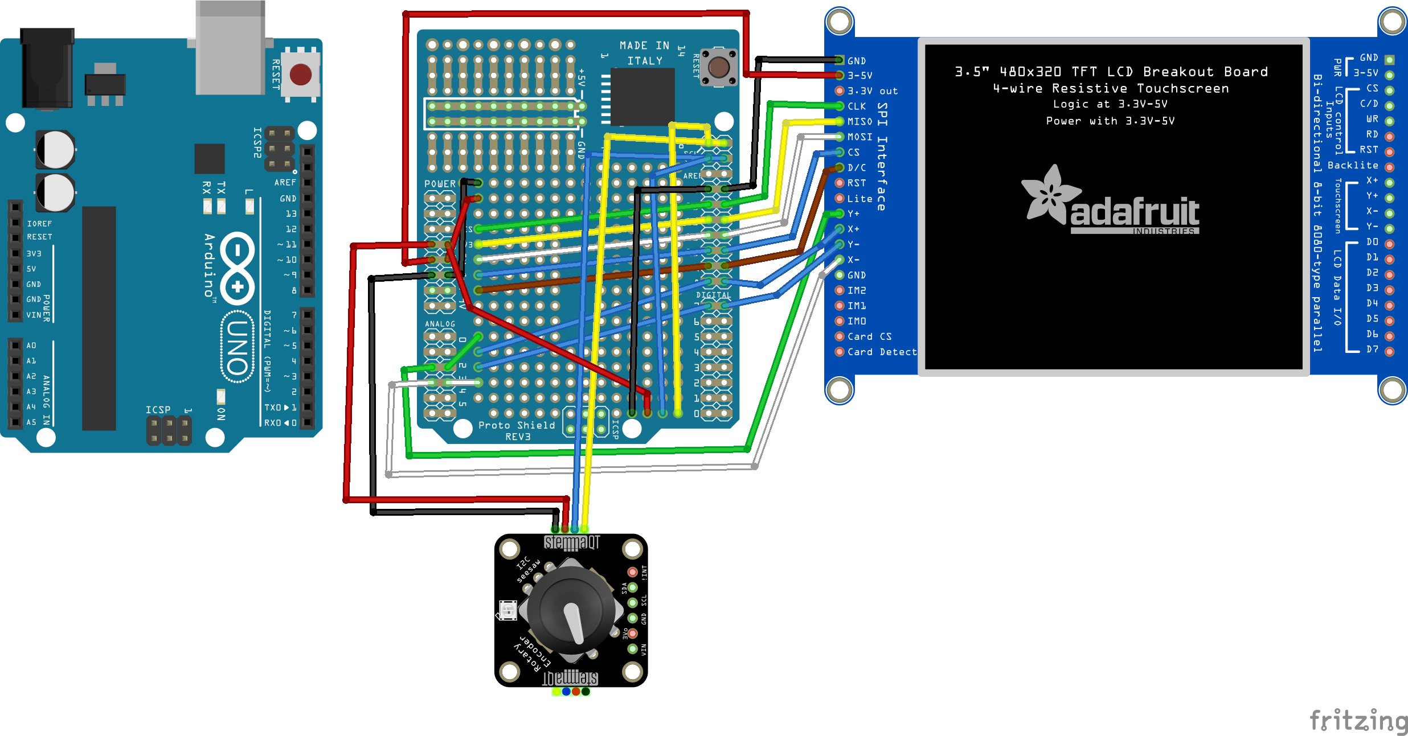
38_ProtoControl_SD_Fall2023/Hardware Files/Schematic_PCB_CAD Files/ProtoControl Ptype_bb.png
