ProtoControl/ProtoControl/38_ProtoControl_SD_Fall2023/Photos and Videos/first_kellymae_enclosure.jpg

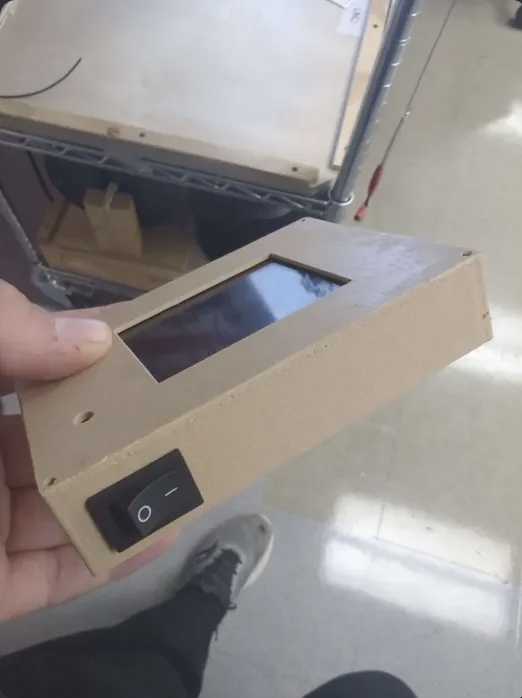
38_ProtoControl_SD_Fall2023/Photos and Videos/first_kellymae_enclosure.jpg
