ProtoControl/ProtoControl/38_ProtoControl_SD_Fall2023/Photos and Videos/image0.jpg

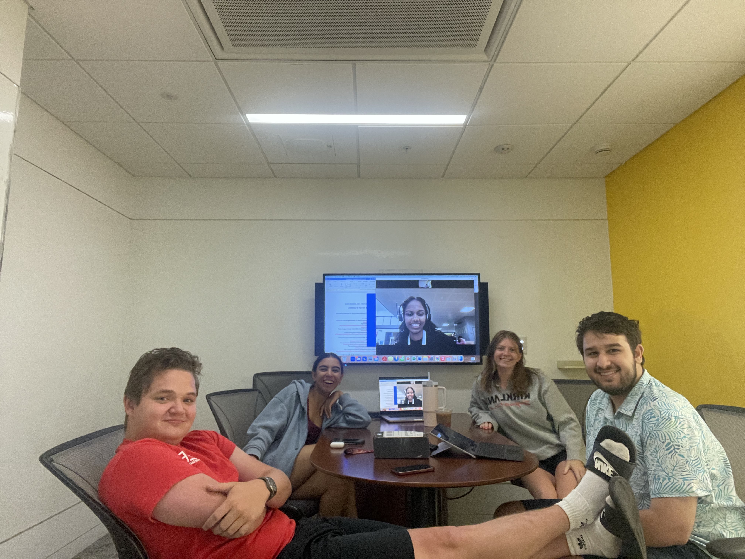
38_ProtoControl_SD_Fall2023/Photos and Videos/image0.jpg
