ProtoControl/ProtoControl/38_ProtoControl_SD_Fall2023/Review-Demos Presentations/CDR/JuliaUserSystem-Alpha.drawio.png

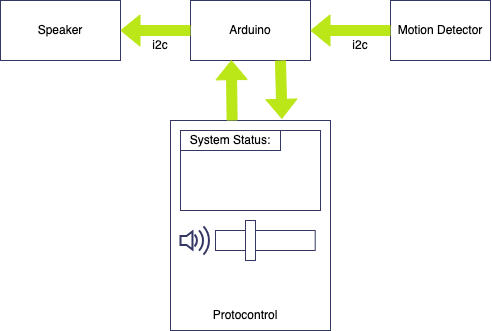
38_ProtoControl_SD_Fall2023/Review-Demos Presentations/CDR/JuliaUserSystem-Alpha.drawio.png
