ProtoControl/ProtoControl/38_ProtoControl_SD_Fall2023/Review-Demos Presentations/Open House/Poster_485_38_Protocontrol.jpg

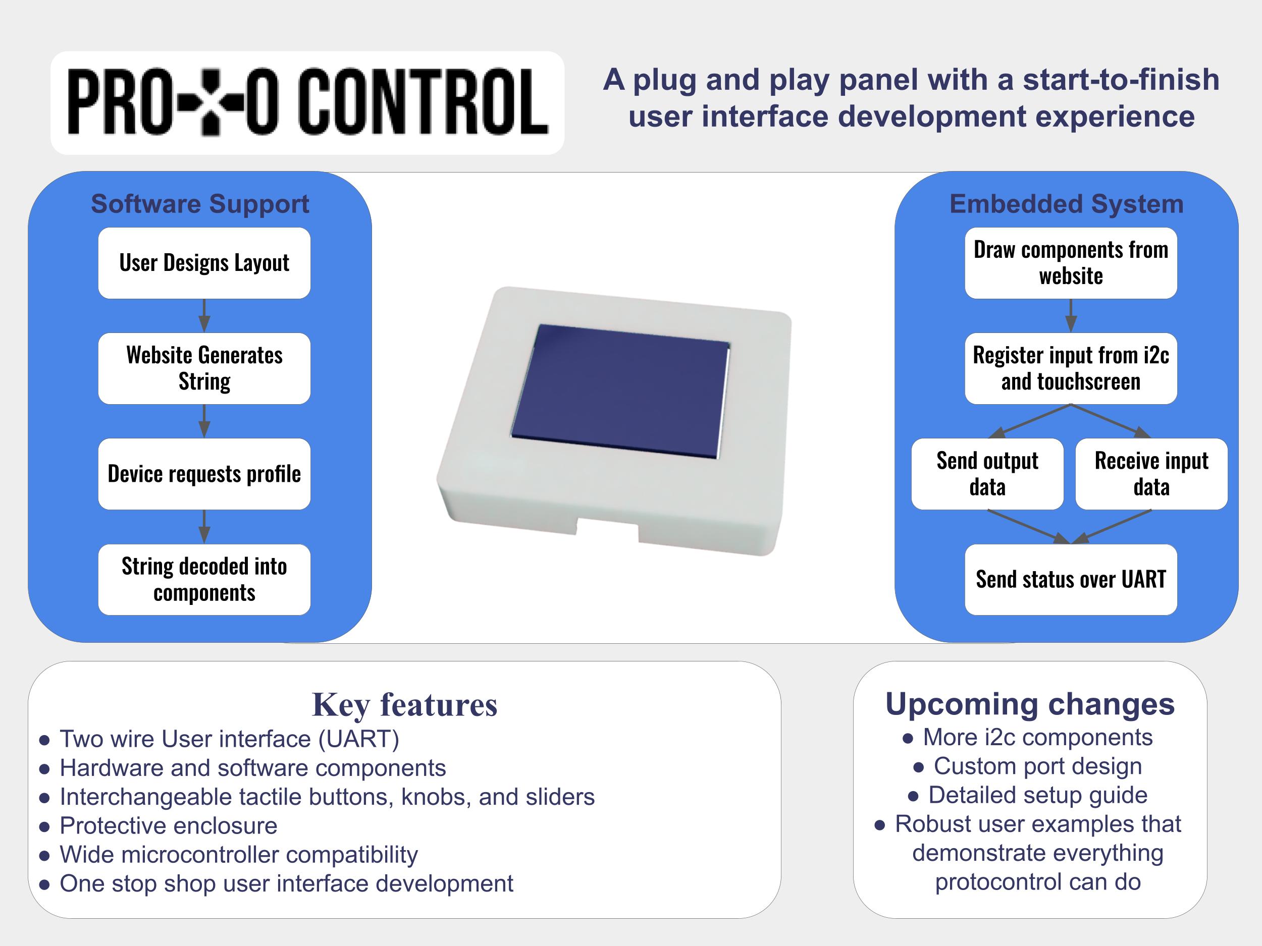
38_ProtoControl_SD_Fall2023/Review-Demos Presentations/Open House/Poster_485_38_Protocontrol.jpg
