ProtoControl/ProtoControl/38_ProtoControl_SD_Fall2023/Review-Demos Presentations/PDR/FormattedImages/ConceptDrawingNKClearBackground.jpg

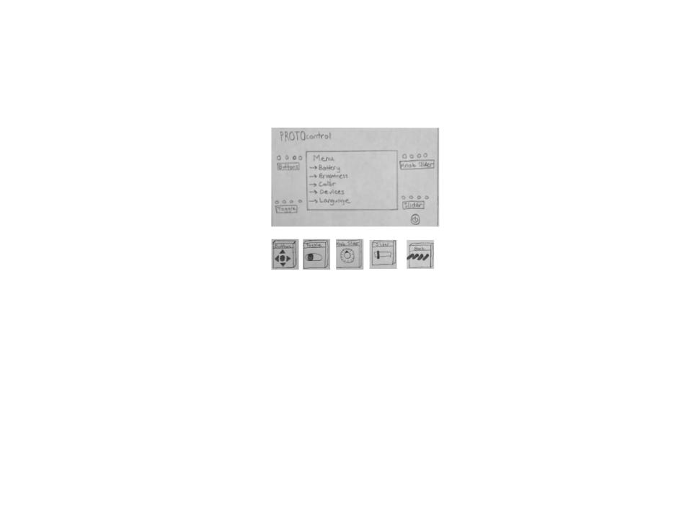
38_ProtoControl_SD_Fall2023/Review-Demos Presentations/PDR/FormattedImages/ConceptDrawingNKClearBackground.jpg
