ProtoControl/ProtoControl/38_ProtoControl_SD_Fall2023/Review-Demos Presentations/PDR/PDR_FunctionalBlockDiagramClearBackground.drawio.png

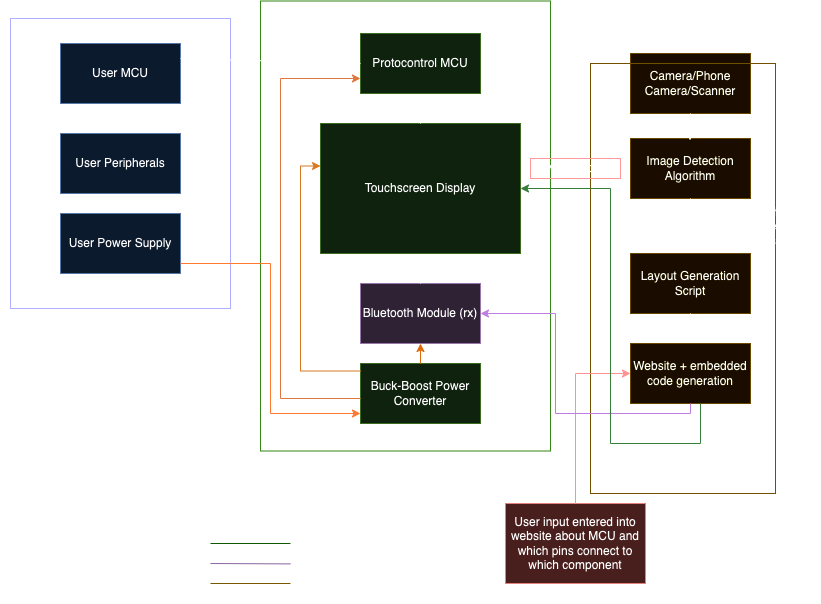
38_ProtoControl_SD_Fall2023/Review-Demos Presentations/PDR/PDR_FunctionalBlockDiagramClearBackground.drawio.png
