ProtoControl/ProtoControl/38_ProtoControl_SD_Fall2023/Review-Demos Presentations/PDR/SystemArchitectureDiagrams-PDR_Functional Block Diagram 1.drawio(1).png

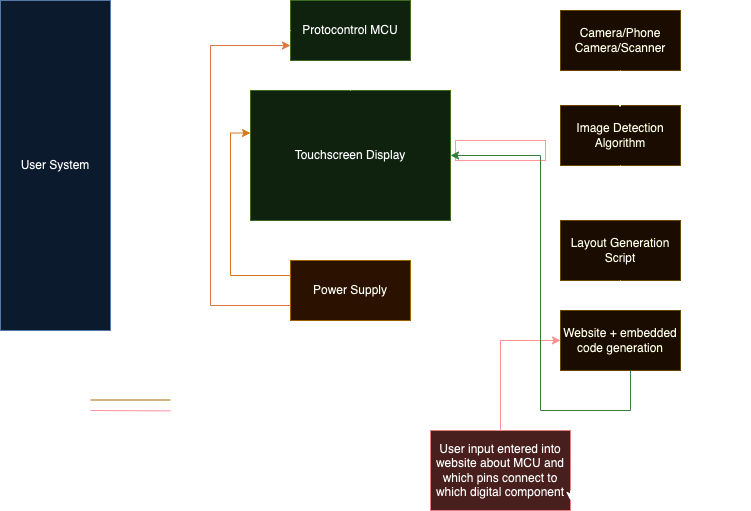
38_ProtoControl_SD_Fall2023/Review-Demos Presentations/PDR/SystemArchitectureDiagrams-PDR_Functional Block Diagram 1.drawio(1).png
