ProtoControl/ProtoControl/38_ProtoControl_SD_Fall2023/Review-Demos Presentations/PDR/TopLevelBlockDiagramIC-Second-Level.drawio.png

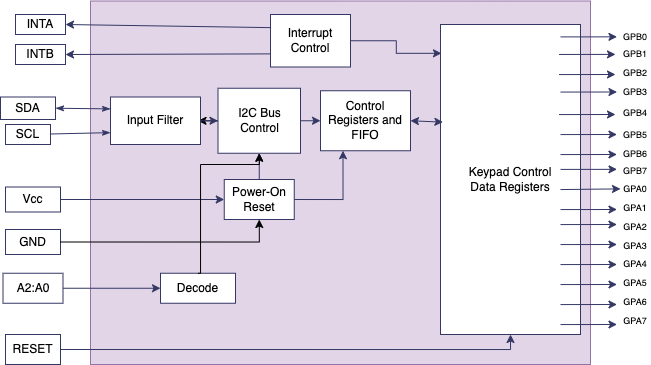
38_ProtoControl_SD_Fall2023/Review-Demos Presentations/PDR/TopLevelBlockDiagramIC-Second-Level.drawio.png
