ProtoControl/ProtoControl/38_ProtoControl_SD_Fall2023/Software Files/ProtoControlTraining/IMG_0700.jpg

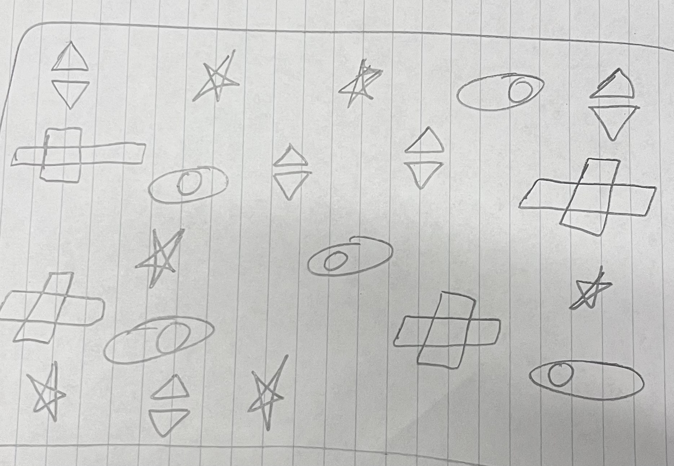
38_ProtoControl_SD_Fall2023/Software Files/ProtoControlTraining/IMG_0700.jpg
