ProtoControl/ProtoControl/38_ProtoControl_SD_Fall2023/Software Files/ProtoControlTraining/train/images/71749046706__D132D4A1-969E-4E4E-A061-FF9AB574110D_jpeg.rf.2be08fca899f130ee9acb10ba4dd1d9d.jpg

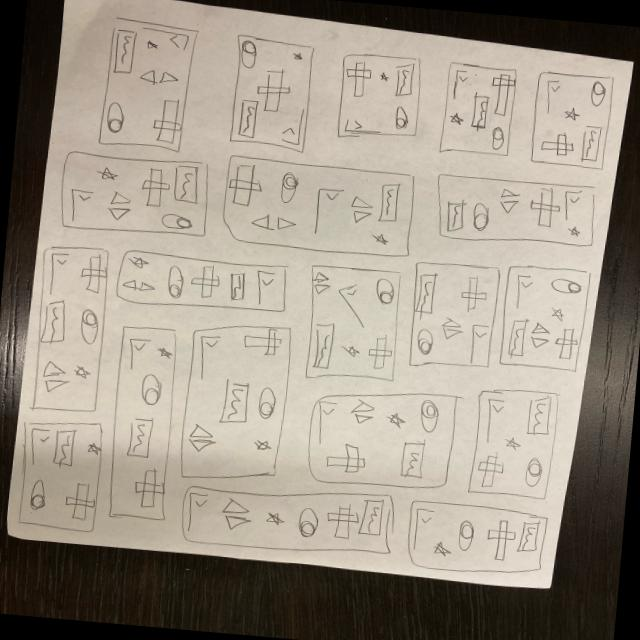
38_ProtoControl_SD_Fall2023/Software Files/ProtoControlTraining/train/images/71749046706__D132D4A1-969E-4E4E-A061-FF9AB574110D_jpeg.rf.2be08fca899f130ee9acb10ba4dd1d9d.jpg
