ProtoControl/ProtoControl/38_ProtoControl_SD_Fall2023/Software Files/ProtoControlTraining/train/images/71749046706__D132D4A1-969E-4E4E-A061-FF9AB574110D_jpeg.rf.3d96d882a7a509a444d29c50a5c08ca8.jpg

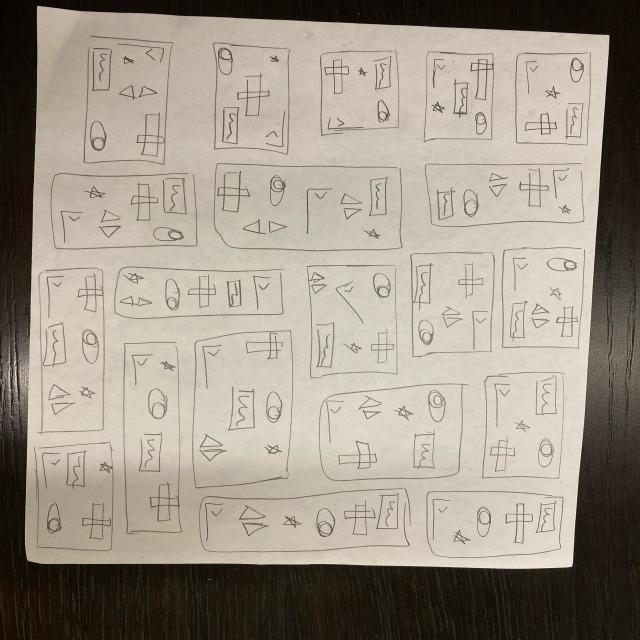
38_ProtoControl_SD_Fall2023/Software Files/ProtoControlTraining/train/images/71749046706__D132D4A1-969E-4E4E-A061-FF9AB574110D_jpeg.rf.3d96d882a7a509a444d29c50a5c08ca8.jpg
