ProtoControl/ProtoControl/38_ProtoControl_SD_Fall2023/Software Files/ProtoControlTraining/train/images/71749046706__D132D4A1-969E-4E4E-A061-FF9AB574110D_jpeg.rf.5accf3b269d91a7bd48af952d2b6620e.jpg

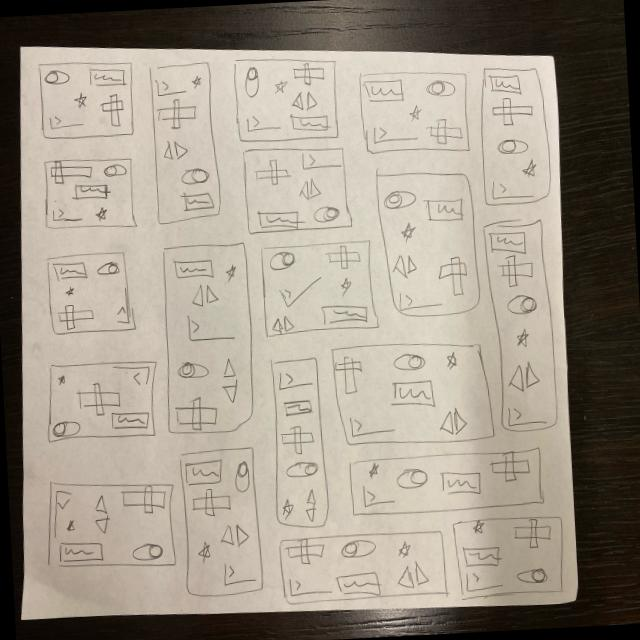
38_ProtoControl_SD_Fall2023/Software Files/ProtoControlTraining/train/images/71749046706__D132D4A1-969E-4E4E-A061-FF9AB574110D_jpeg.rf.5accf3b269d91a7bd48af952d2b6620e.jpg
