ProtoControl/ProtoControl/38_ProtoControl_SD_Fall2023/Software Files/ProtoControlTraining/train/images/IMG_0672_jpg.rf.08c7f2a7422471d36107900a27397885.jpg

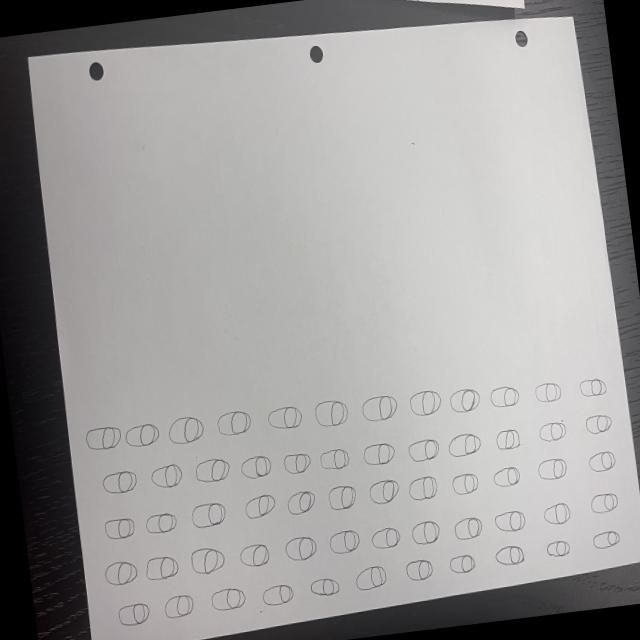
38_ProtoControl_SD_Fall2023/Software Files/ProtoControlTraining/train/images/IMG_0672_jpg.rf.08c7f2a7422471d36107900a27397885.jpg
