ProtoControl/ProtoControl/38_ProtoControl_SD_Fall2023/Software Files/ProtoControlTraining/train/images/IMG_0672_jpg.rf.811f6c49a8234cc980e32f17cb4ca560.jpg

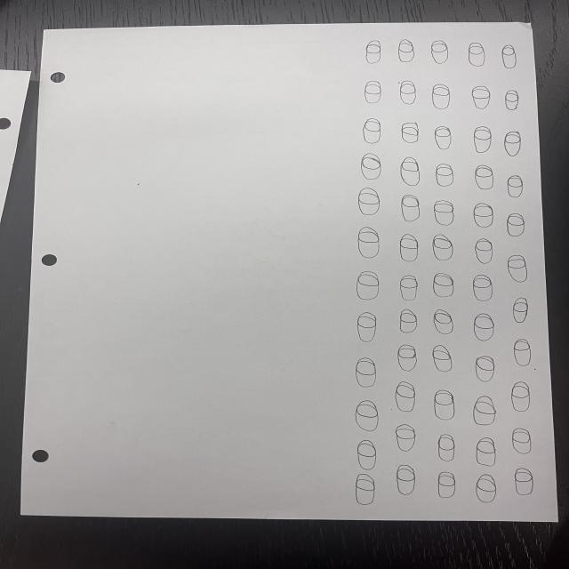
38_ProtoControl_SD_Fall2023/Software Files/ProtoControlTraining/train/images/IMG_0672_jpg.rf.811f6c49a8234cc980e32f17cb4ca560.jpg
