ProtoControl/ProtoControl/38_ProtoControl_SD_Fall2023/Software Files/ProtoControlTraining/train/images/IMG_0672_jpg.rf.e2744f1cf14fb9e50b04ed8e910940b2.jpg

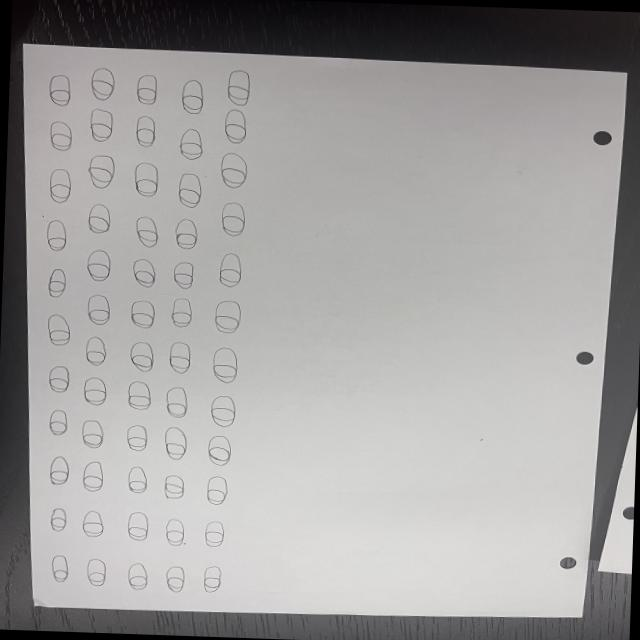
38_ProtoControl_SD_Fall2023/Software Files/ProtoControlTraining/train/images/IMG_0672_jpg.rf.e2744f1cf14fb9e50b04ed8e910940b2.jpg
