ProtoControl/ProtoControl/38_ProtoControl_SD_Fall2023/Software Files/ProtoControlTraining/train/images/IMG_0673_jpg.rf.287e680a90b6b4718ec076ed803272fe.jpg

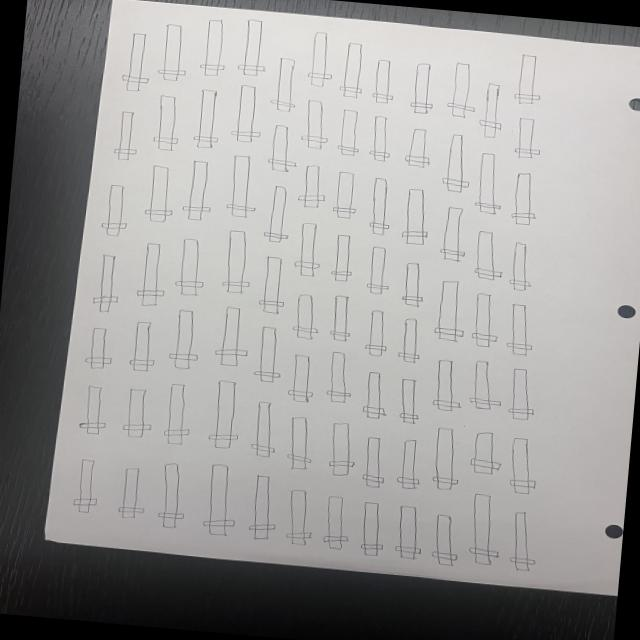
38_ProtoControl_SD_Fall2023/Software Files/ProtoControlTraining/train/images/IMG_0673_jpg.rf.287e680a90b6b4718ec076ed803272fe.jpg
