ProtoControl/ProtoControl/38_ProtoControl_SD_Fall2023/Software Files/ProtoControlTraining/train/images/IMG_0673_jpg.rf.af3f85257367a303dcfa2e47fedff3ed.jpg

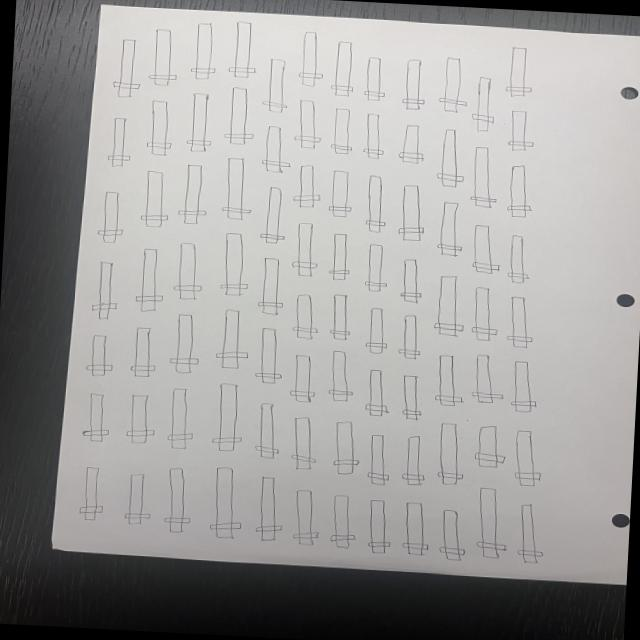
38_ProtoControl_SD_Fall2023/Software Files/ProtoControlTraining/train/images/IMG_0673_jpg.rf.af3f85257367a303dcfa2e47fedff3ed.jpg
