ProtoControl/ProtoControl/38_ProtoControl_SD_Fall2023/Software Files/ProtoControlTraining/train/images/IMG_0673_jpg.rf.de4fd494ce2220c2914eb1a589a67266.jpg

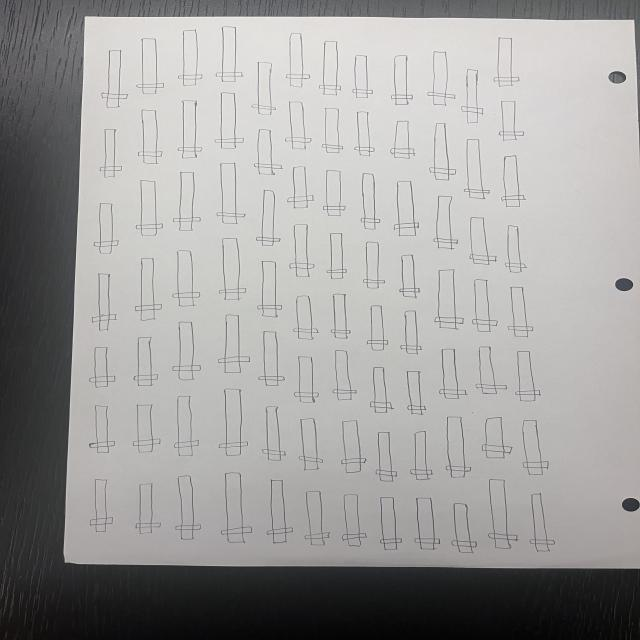
38_ProtoControl_SD_Fall2023/Software Files/ProtoControlTraining/train/images/IMG_0673_jpg.rf.de4fd494ce2220c2914eb1a589a67266.jpg
