ProtoControl/ProtoControl/38_ProtoControl_SD_Fall2023/Software Files/ProtoControlTraining/train/images/IMG_0674_jpg.rf.6ab2dda6e814d7fc030296cb2232515b.jpg

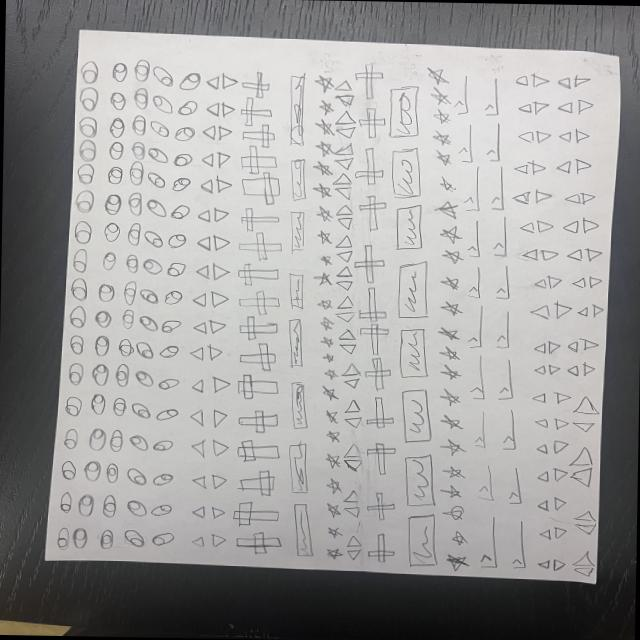
38_ProtoControl_SD_Fall2023/Software Files/ProtoControlTraining/train/images/IMG_0674_jpg.rf.6ab2dda6e814d7fc030296cb2232515b.jpg
