ProtoControl/ProtoControl/38_ProtoControl_SD_Fall2023/Software Files/ProtoControlTraining/train/images/IMG_0677_jpg.rf.9e586a852af2f67dbaeed69abb801fe2.jpg

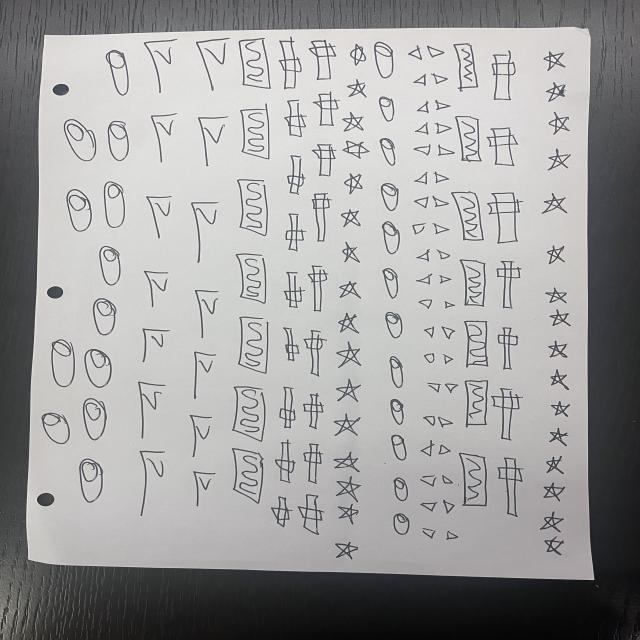
38_ProtoControl_SD_Fall2023/Software Files/ProtoControlTraining/train/images/IMG_0677_jpg.rf.9e586a852af2f67dbaeed69abb801fe2.jpg
