ProtoControl/ProtoControl/38_ProtoControl_SD_Fall2023/Software Files/ProtoControlTraining/train/images/IMG_0677_jpg.rf.186c9c0234b2b29c26806880c0baffd9.jpg

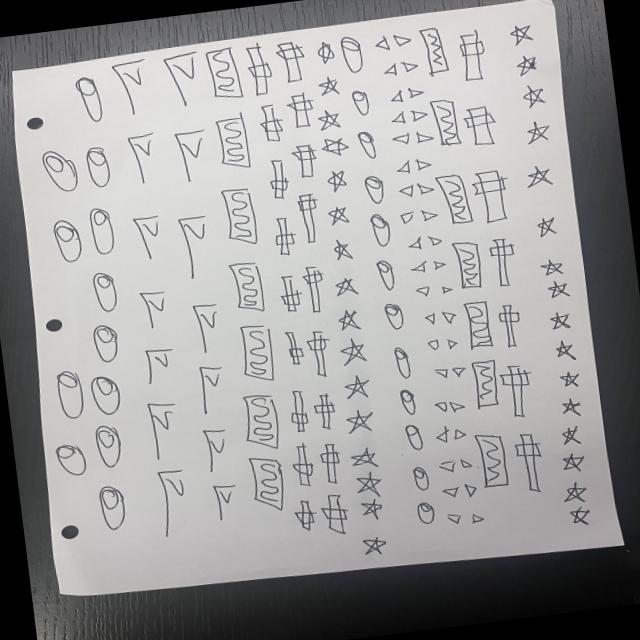
38_ProtoControl_SD_Fall2023/Software Files/ProtoControlTraining/train/images/IMG_0677_jpg.rf.186c9c0234b2b29c26806880c0baffd9.jpg
