ProtoControl/ProtoControl/38_ProtoControl_SD_Fall2023/Software Files/ProtoControlTraining/train/images/IMG_0677_jpg.rf.a590ecdab1afb53a88a96506e0b42f15.jpg

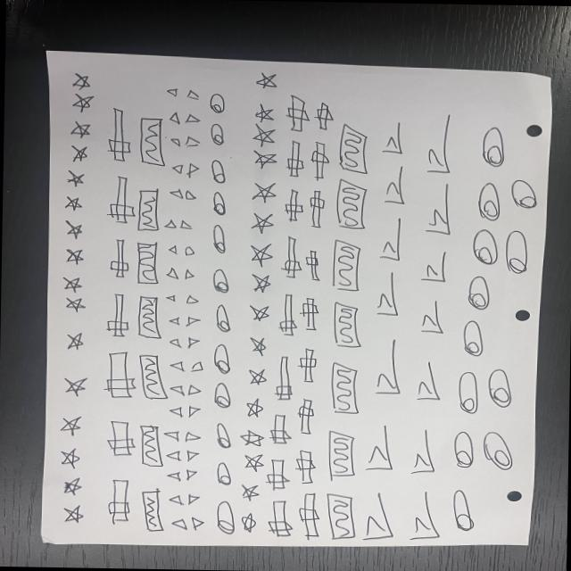
38_ProtoControl_SD_Fall2023/Software Files/ProtoControlTraining/train/images/IMG_0677_jpg.rf.a590ecdab1afb53a88a96506e0b42f15.jpg
