ProtoControl/ProtoControl/38_ProtoControl_SD_Fall2023/Software Files/ProtoControlTraining/train/images/IMG_0678_jpg.rf.1f5e625d635075513f89d6edf60b972a.jpg

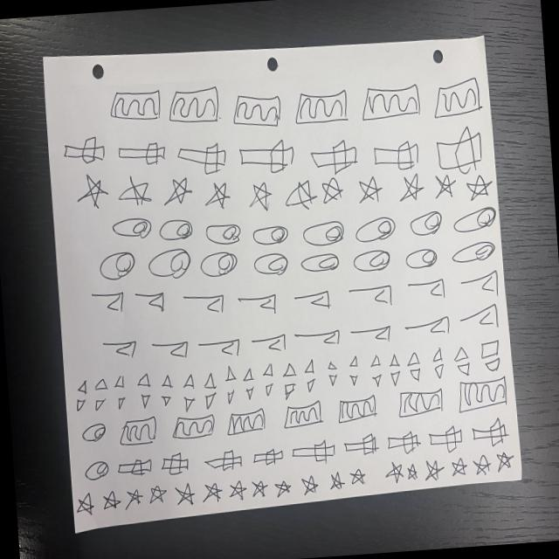
38_ProtoControl_SD_Fall2023/Software Files/ProtoControlTraining/train/images/IMG_0678_jpg.rf.1f5e625d635075513f89d6edf60b972a.jpg
