ProtoControl/ProtoControl/38_ProtoControl_SD_Fall2023/Software Files/ProtoControlTraining/train/images/IMG_0678_jpg.rf.779582be2e4c87f2c585866fb6617079.jpg

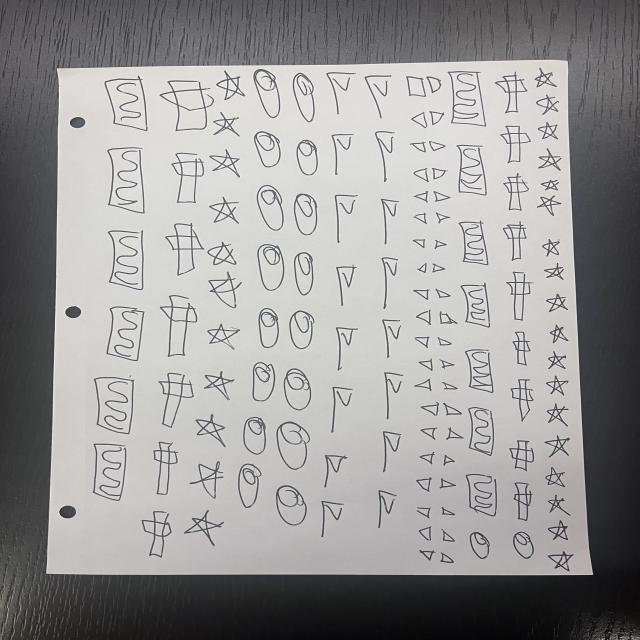
38_ProtoControl_SD_Fall2023/Software Files/ProtoControlTraining/train/images/IMG_0678_jpg.rf.779582be2e4c87f2c585866fb6617079.jpg
