ProtoControl/ProtoControl/38_ProtoControl_SD_Fall2023/Software Files/ProtoControlTraining/train/images/IMG_0678_jpg.rf.1930190b39ffc89a660292ecf241640c.jpg

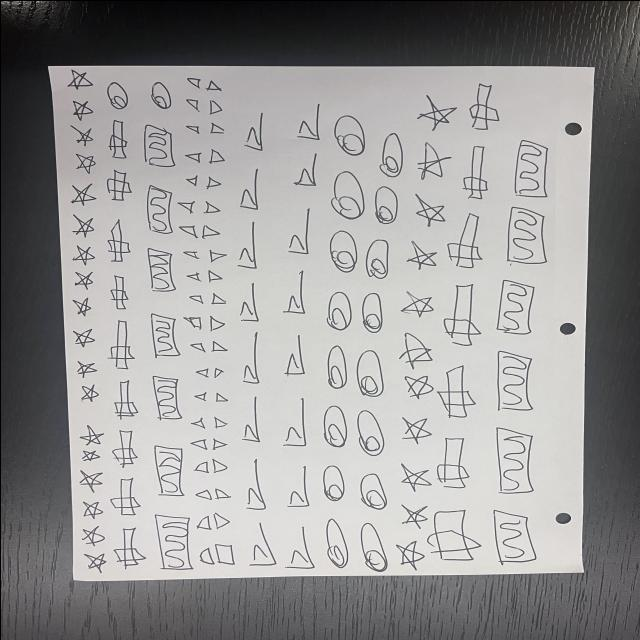
38_ProtoControl_SD_Fall2023/Software Files/ProtoControlTraining/train/images/IMG_0678_jpg.rf.1930190b39ffc89a660292ecf241640c.jpg
