ProtoControl/ProtoControl/38_ProtoControl_SD_Fall2023/Software Files/ProtoControlTraining/train/images/IMG_0679_jpg.rf.3b4ac3ee5bf2eeaf9eb36143e3516e43.jpg

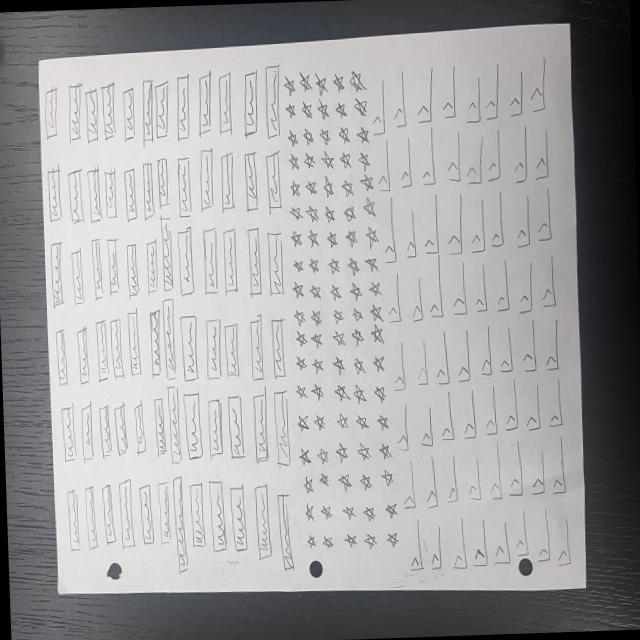
38_ProtoControl_SD_Fall2023/Software Files/ProtoControlTraining/train/images/IMG_0679_jpg.rf.3b4ac3ee5bf2eeaf9eb36143e3516e43.jpg
