ProtoControl/ProtoControl/38_ProtoControl_SD_Fall2023/Software Files/ProtoControlTraining/train/images/IMG_0679_jpg.rf.8e4893ff5206e8f5c9b1f0c47b2eade2.jpg

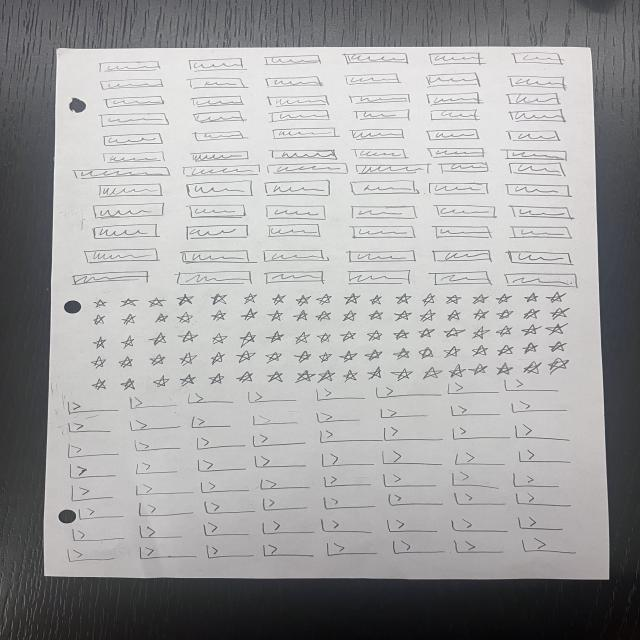
38_ProtoControl_SD_Fall2023/Software Files/ProtoControlTraining/train/images/IMG_0679_jpg.rf.8e4893ff5206e8f5c9b1f0c47b2eade2.jpg
