ProtoControl/ProtoControl/38_ProtoControl_SD_Fall2023/Software Files/ProtoControlTraining/train/images/IMG_0679_jpg.rf.b765913d0ba04235e9a204562cb786b9.jpg

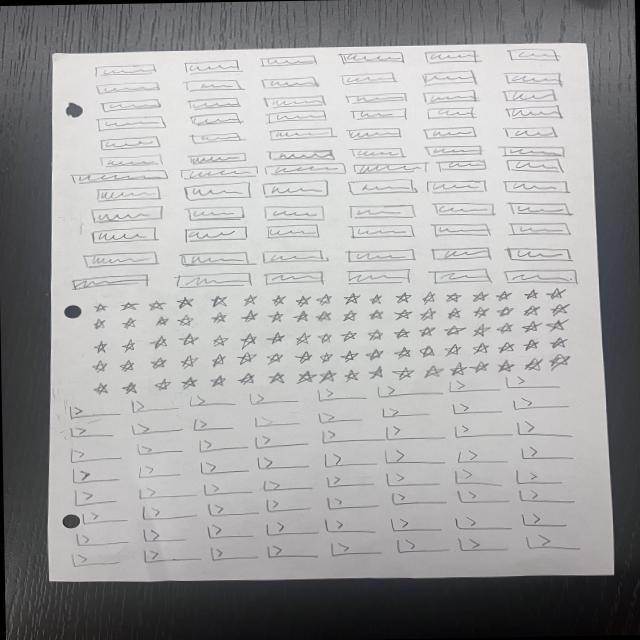
38_ProtoControl_SD_Fall2023/Software Files/ProtoControlTraining/train/images/IMG_0679_jpg.rf.b765913d0ba04235e9a204562cb786b9.jpg
