ProtoControl/ProtoControl/38_ProtoControl_SD_Fall2023/Software Files/ProtoControlTraining/train/images/sliders-1_jpg.rf.1df9cb8dec2129fe06fd5855b157daac.jpg

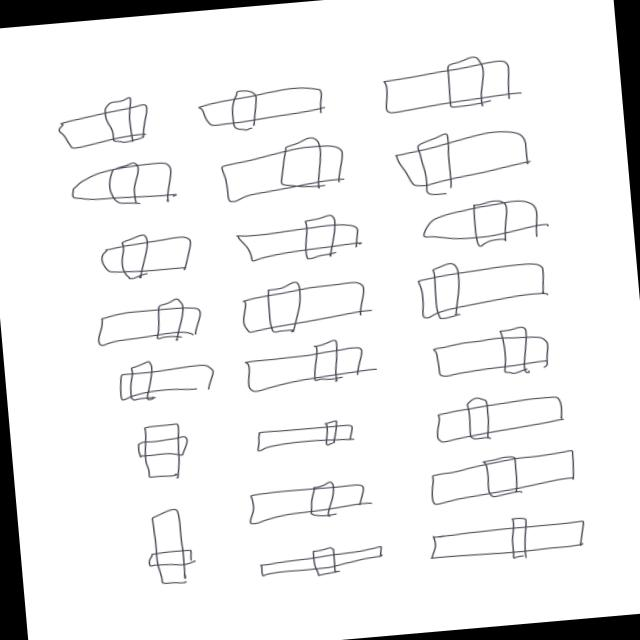
38_ProtoControl_SD_Fall2023/Software Files/ProtoControlTraining/train/images/sliders-1_jpg.rf.1df9cb8dec2129fe06fd5855b157daac.jpg
