ProtoControl/ProtoControl/38_ProtoControl_SD_Fall2023/Software Files/ProtoControlTraining/train/images/sliders-1_jpg.rf.5ec16082c38791e1822eb480bba7a706.jpg

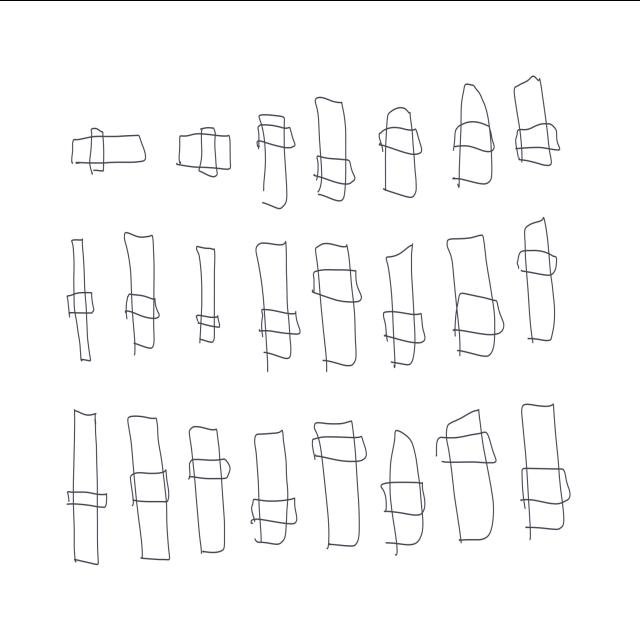
38_ProtoControl_SD_Fall2023/Software Files/ProtoControlTraining/train/images/sliders-1_jpg.rf.5ec16082c38791e1822eb480bba7a706.jpg
