ProtoControl/ProtoControl/38_ProtoControl_SD_Fall2023/Software Files/ProtoControlTraining/train/images/sliders-1_jpg.rf.fa4bc0b86112f359edf677fc162b2532.jpg

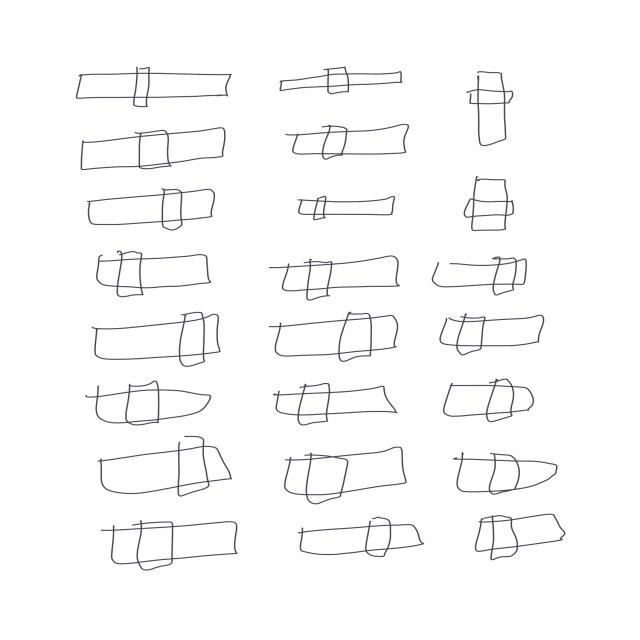
38_ProtoControl_SD_Fall2023/Software Files/ProtoControlTraining/train/images/sliders-1_jpg.rf.fa4bc0b86112f359edf677fc162b2532.jpg
