ProtoControl/ProtoControl/38_ProtoControl_SD_Fall2023/Software Files/ProtoControlTraining/train/images/sliders-3_jpg.rf.9a159175c0e6950f02108b13fdca3fba.jpg

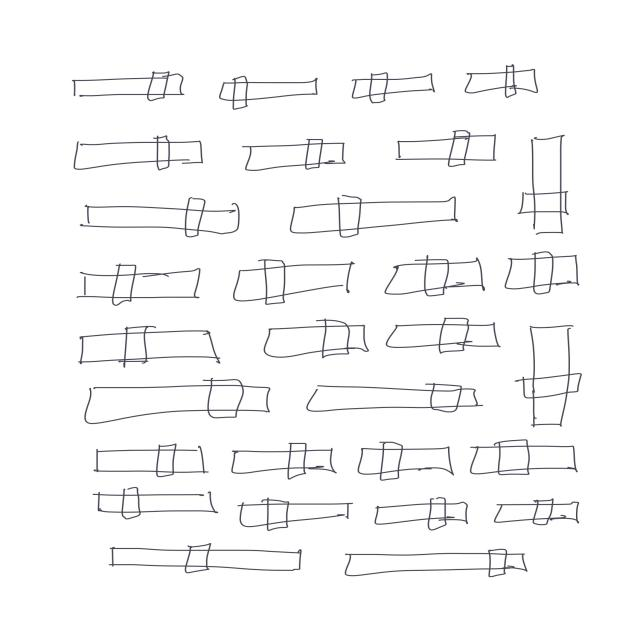
38_ProtoControl_SD_Fall2023/Software Files/ProtoControlTraining/train/images/sliders-3_jpg.rf.9a159175c0e6950f02108b13fdca3fba.jpg
