ProtoControl/ProtoControl/38_ProtoControl_SD_Fall2023/Software Files/ProtoControlTraining/train/images/sliders-3_jpg.rf.38049523a57e84987b5087ee75aa55f8.jpg

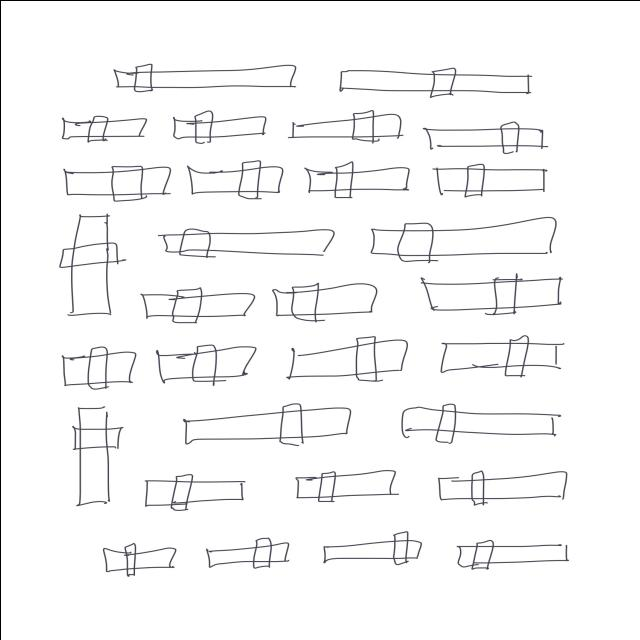
38_ProtoControl_SD_Fall2023/Software Files/ProtoControlTraining/train/images/sliders-3_jpg.rf.38049523a57e84987b5087ee75aa55f8.jpg
