ProtoControl/ProtoControl/38_ProtoControl_SD_Fall2023/Software Files/ProtoControlTraining/train/images/sliders-3_jpg.rf.f8daee229e6d45566aa2cac8ea6c4c9c.jpg

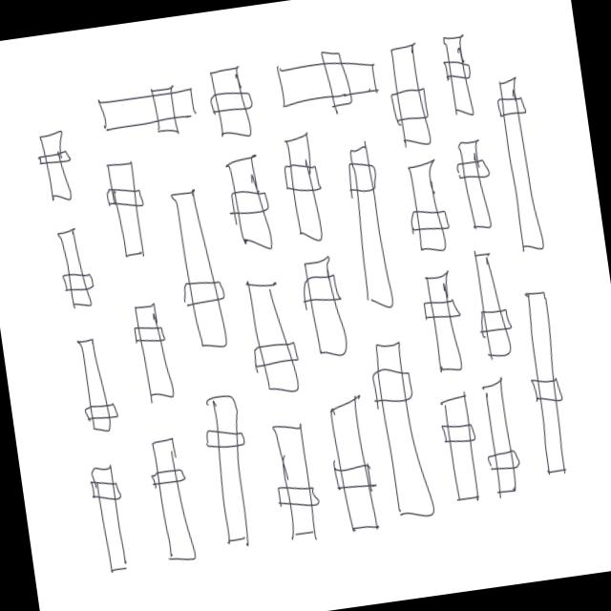
38_ProtoControl_SD_Fall2023/Software Files/ProtoControlTraining/train/images/sliders-3_jpg.rf.f8daee229e6d45566aa2cac8ea6c4c9c.jpg
