ProtoControl/ProtoControl/38_ProtoControl_SD_Fall2023/Software Files/ProtoControlTraining/train/images/sliders-4_jpg.rf.7cd1e8f68c81021d39057b097162fe82.jpg

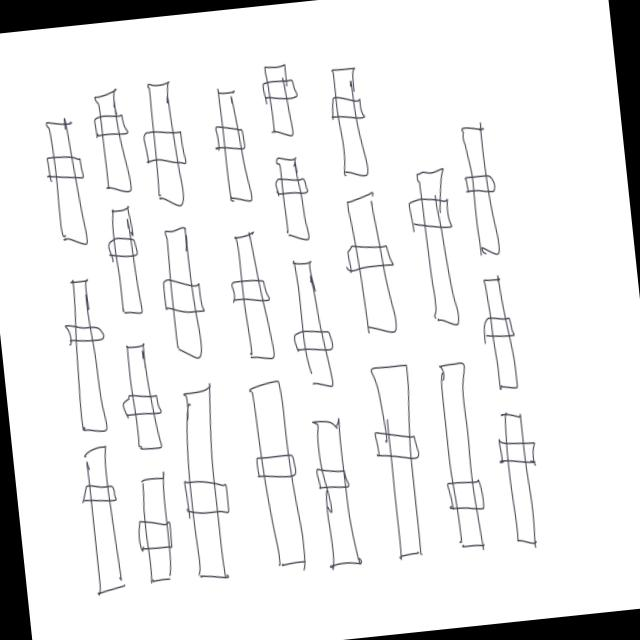
38_ProtoControl_SD_Fall2023/Software Files/ProtoControlTraining/train/images/sliders-4_jpg.rf.7cd1e8f68c81021d39057b097162fe82.jpg
