ProtoControl/ProtoControl/38_ProtoControl_SD_Fall2023/Software Files/ProtoControlTraining/train/images/sliders-4_jpg.rf.7f252558c053120dd02132210dda64c0.jpg

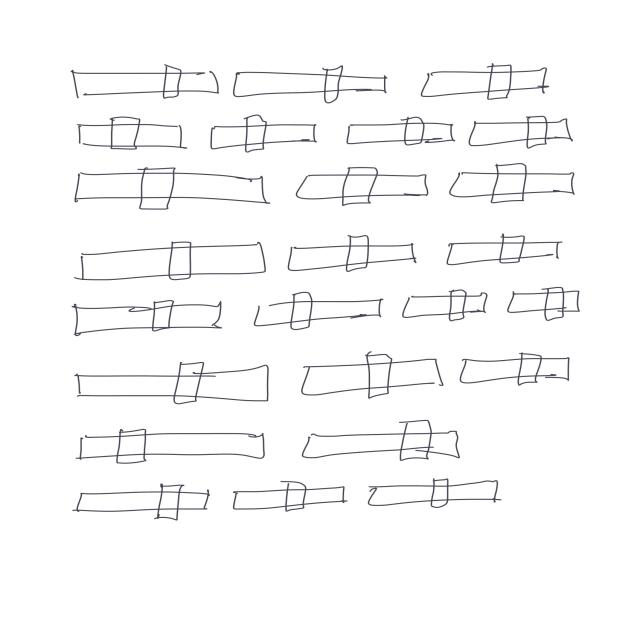
38_ProtoControl_SD_Fall2023/Software Files/ProtoControlTraining/train/images/sliders-4_jpg.rf.7f252558c053120dd02132210dda64c0.jpg
