ProtoControl/ProtoControl/38_ProtoControl_SD_Fall2023/Software Files/ProtoControlTraining/train/images/sliders-4_jpg.rf.516fa48fd5151b6c0d0d937cb075694b.jpg

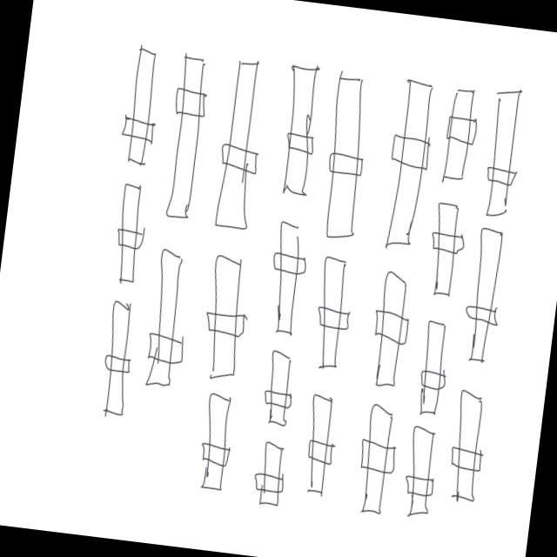
38_ProtoControl_SD_Fall2023/Software Files/ProtoControlTraining/train/images/sliders-4_jpg.rf.516fa48fd5151b6c0d0d937cb075694b.jpg
