ProtoControl/ProtoControl/38_ProtoControl_SD_Fall2023/Software Files/ProtoControlTraining/train/images/terminal-watch-window-1_jpg.rf.6e1268ccaf4eae3eed03ac79f04de2f6.jpg

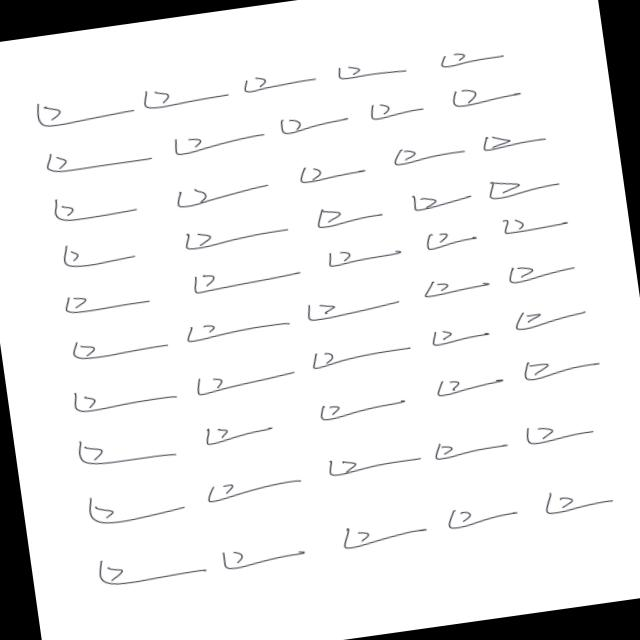
38_ProtoControl_SD_Fall2023/Software Files/ProtoControlTraining/train/images/terminal-watch-window-1_jpg.rf.6e1268ccaf4eae3eed03ac79f04de2f6.jpg
