ProtoControl/ProtoControl/38_ProtoControl_SD_Fall2023/Software Files/ProtoControlTraining/train/images/terminal-watch-window-1_jpg.rf.170f262c867d763475af8688c9b882f0.jpg

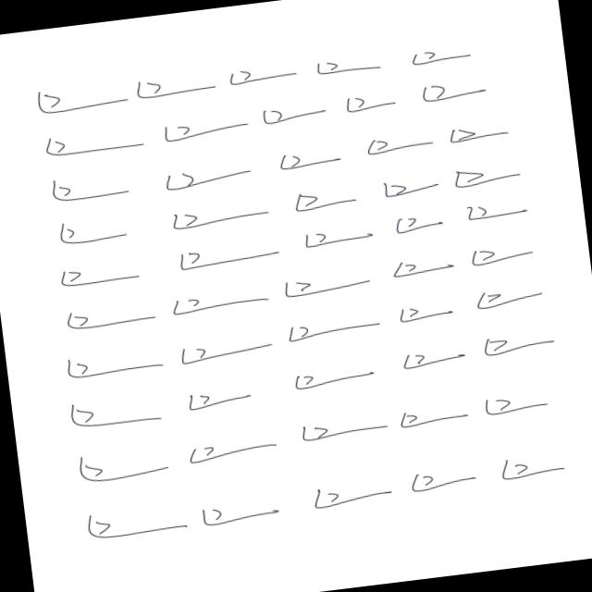
38_ProtoControl_SD_Fall2023/Software Files/ProtoControlTraining/train/images/terminal-watch-window-1_jpg.rf.170f262c867d763475af8688c9b882f0.jpg
