ProtoControl/ProtoControl/38_ProtoControl_SD_Fall2023/Software Files/ProtoControlTraining/train/images/terminal-watch-window-1_jpg.rf.296fdae120b9be87c8948b7d7b43555c.jpg

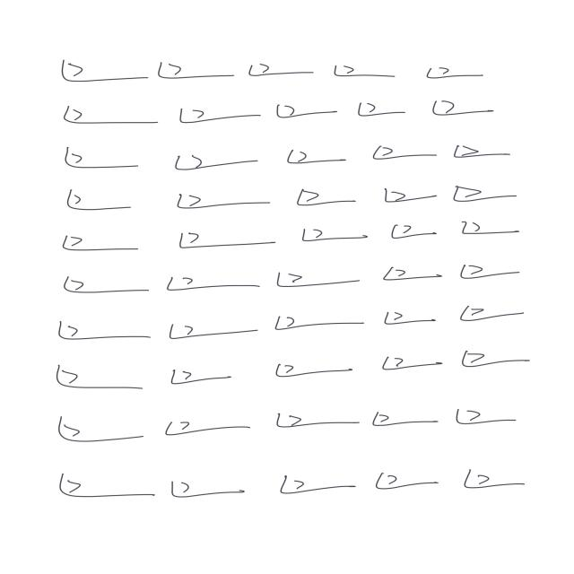
38_ProtoControl_SD_Fall2023/Software Files/ProtoControlTraining/train/images/terminal-watch-window-1_jpg.rf.296fdae120b9be87c8948b7d7b43555c.jpg
