ProtoControl/ProtoControl/38_ProtoControl_SD_Fall2023/Software Files/ProtoControlTraining/train/images/terminal-watch-window-2_jpg.rf.4707901eb7cc6478683fba6d50535461.jpg

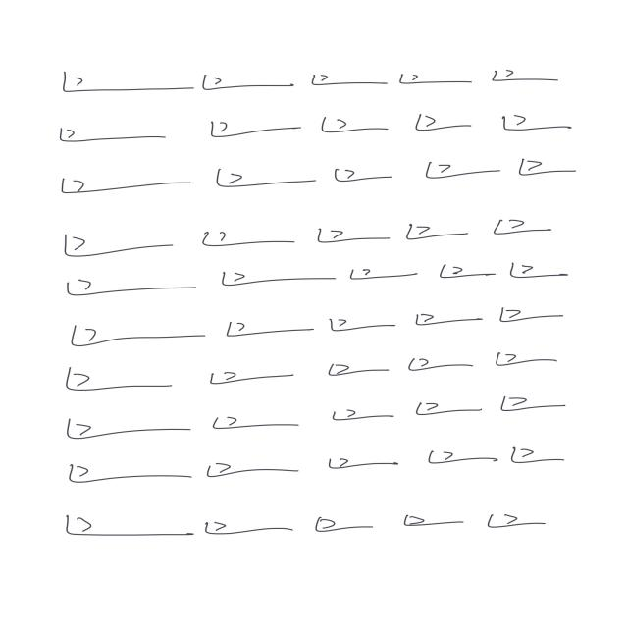
38_ProtoControl_SD_Fall2023/Software Files/ProtoControlTraining/train/images/terminal-watch-window-2_jpg.rf.4707901eb7cc6478683fba6d50535461.jpg
