ProtoControl/ProtoControl/38_ProtoControl_SD_Fall2023/Software Files/ProtoControlTraining/train/images/terminal-watch-window-2_jpg.rf.acda1e183e4815c246e974b6e52a0311.jpg

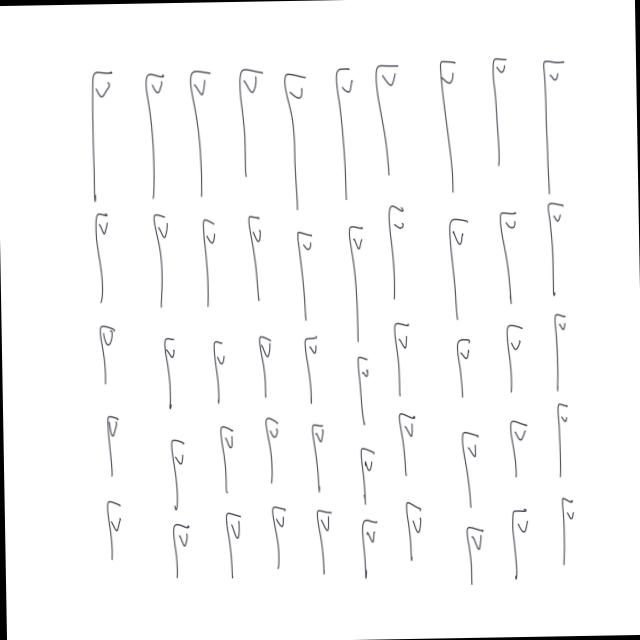
38_ProtoControl_SD_Fall2023/Software Files/ProtoControlTraining/train/images/terminal-watch-window-2_jpg.rf.acda1e183e4815c246e974b6e52a0311.jpg
