ProtoControl/ProtoControl/38_ProtoControl_SD_Fall2023/Software Files/ProtoControlTraining/train/images/terminal-watch-window-2_jpg.rf.d587c654149120785fa5d955bfe62859.jpg

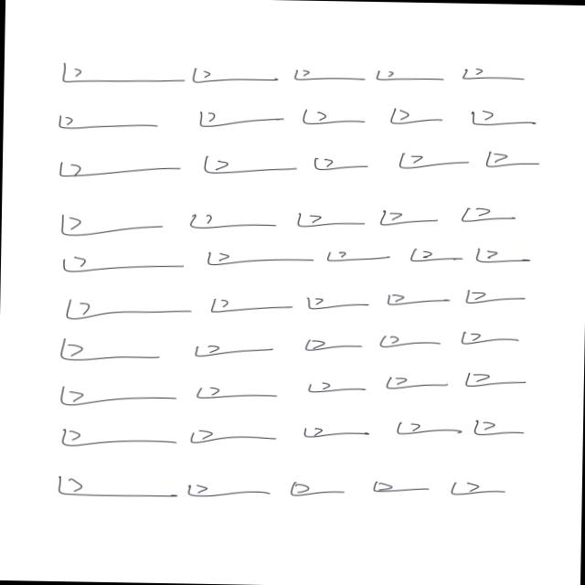
38_ProtoControl_SD_Fall2023/Software Files/ProtoControlTraining/train/images/terminal-watch-window-2_jpg.rf.d587c654149120785fa5d955bfe62859.jpg
