ProtoControl/ProtoControl/38_ProtoControl_SD_Fall2023/Software Files/ProtoControlTraining/train/images/textbox-1_jpg.rf.215dbbc3f81a587372ed752623fa3aa8.jpg

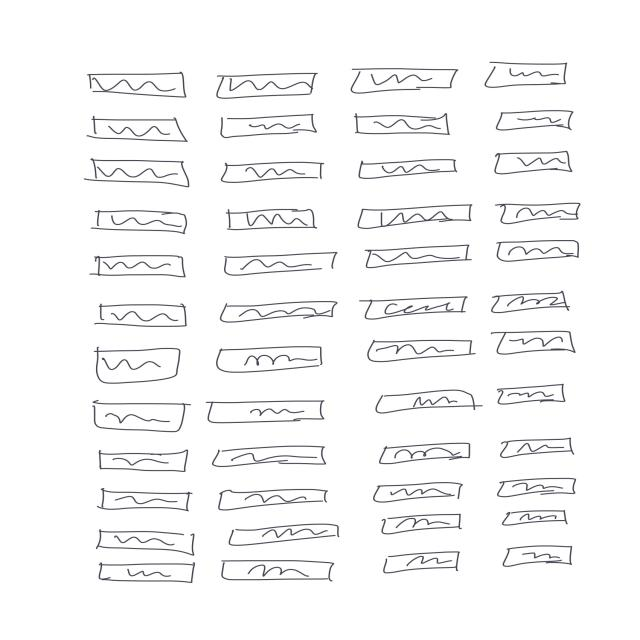
38_ProtoControl_SD_Fall2023/Software Files/ProtoControlTraining/train/images/textbox-1_jpg.rf.215dbbc3f81a587372ed752623fa3aa8.jpg
