ProtoControl/ProtoControl/38_ProtoControl_SD_Fall2023/Software Files/ProtoControlTraining/train/images/textbox-1_jpg.rf.616b1854846621cc70520a696da29f18.jpg

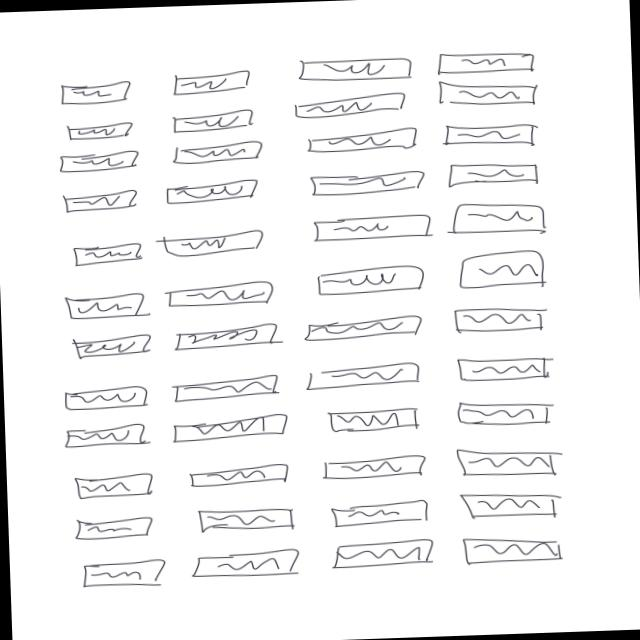
38_ProtoControl_SD_Fall2023/Software Files/ProtoControlTraining/train/images/textbox-1_jpg.rf.616b1854846621cc70520a696da29f18.jpg
