ProtoControl/ProtoControl/38_ProtoControl_SD_Fall2023/Software Files/ProtoControlTraining/train/images/textbox-1_jpg.rf.2528a8aa3bacb7643213f1d728e887ad.jpg

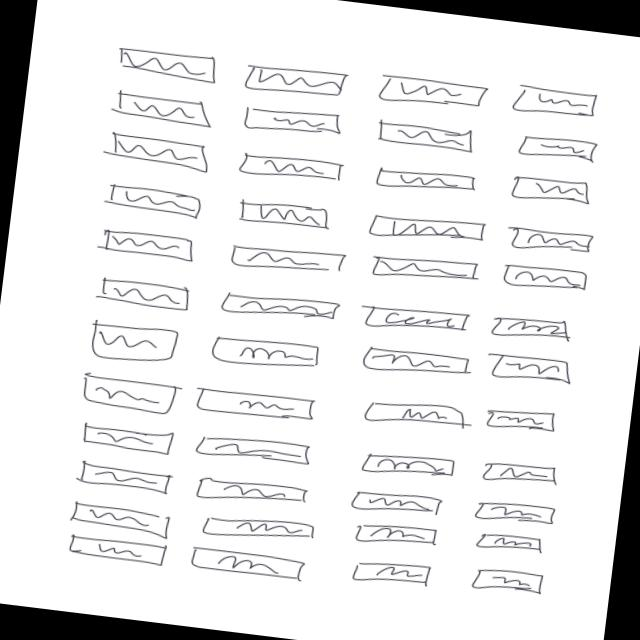
38_ProtoControl_SD_Fall2023/Software Files/ProtoControlTraining/train/images/textbox-1_jpg.rf.2528a8aa3bacb7643213f1d728e887ad.jpg
