ProtoControl/ProtoControl/38_ProtoControl_SD_Fall2023/Software Files/ProtoControlTraining/train/images/textbox-2_jpg.rf.8e7ac50363b6514c19d1c432bf948309.jpg

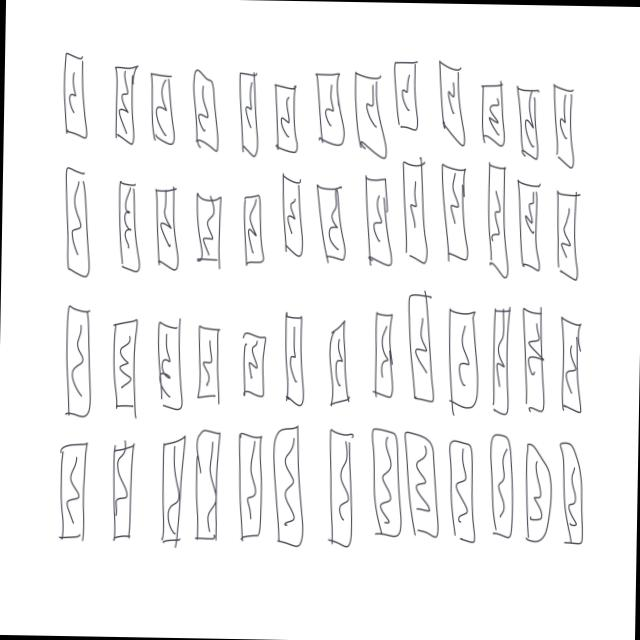
38_ProtoControl_SD_Fall2023/Software Files/ProtoControlTraining/train/images/textbox-2_jpg.rf.8e7ac50363b6514c19d1c432bf948309.jpg
