ProtoControl/ProtoControl/38_ProtoControl_SD_Fall2023/Software Files/ProtoControlTraining/train/images/textbox-2_jpg.rf.22f04e03c282d8125e68e6cac7eaf030.jpg

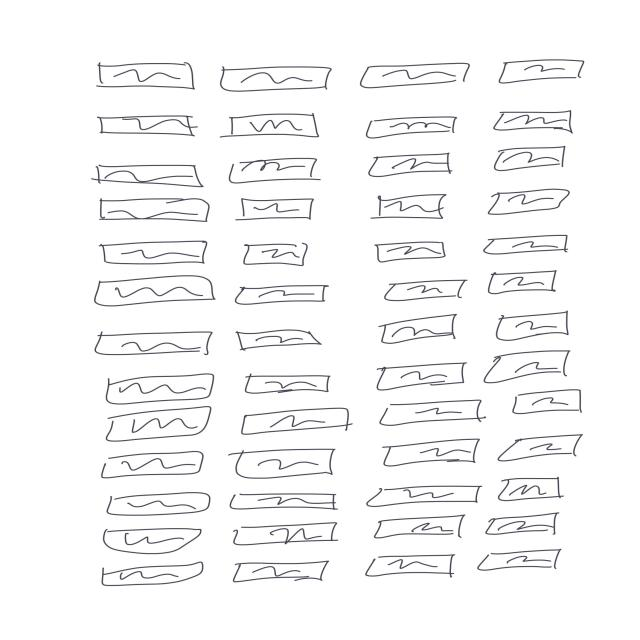
38_ProtoControl_SD_Fall2023/Software Files/ProtoControlTraining/train/images/textbox-2_jpg.rf.22f04e03c282d8125e68e6cac7eaf030.jpg
