ProtoControl/ProtoControl/38_ProtoControl_SD_Fall2023/Software Files/ProtoControlTraining/train/images/textbox-2_jpg.rf.36ff6594d1400f254c91546afe8746bc.jpg

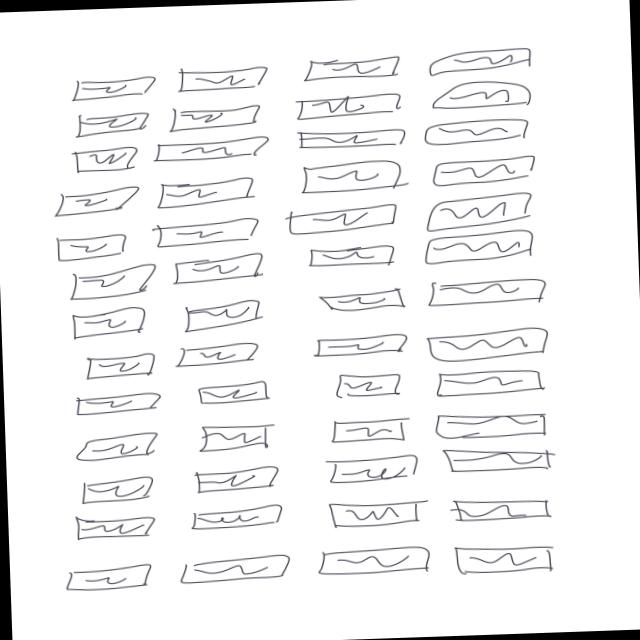
38_ProtoControl_SD_Fall2023/Software Files/ProtoControlTraining/train/images/textbox-2_jpg.rf.36ff6594d1400f254c91546afe8746bc.jpg
