ProtoControl/ProtoControl/38_ProtoControl_SD_Fall2023/Software Files/ProtoControlTraining/train/images/toggle-1_jpg.rf.88dccc18f616b3b8663271b514211235.jpg

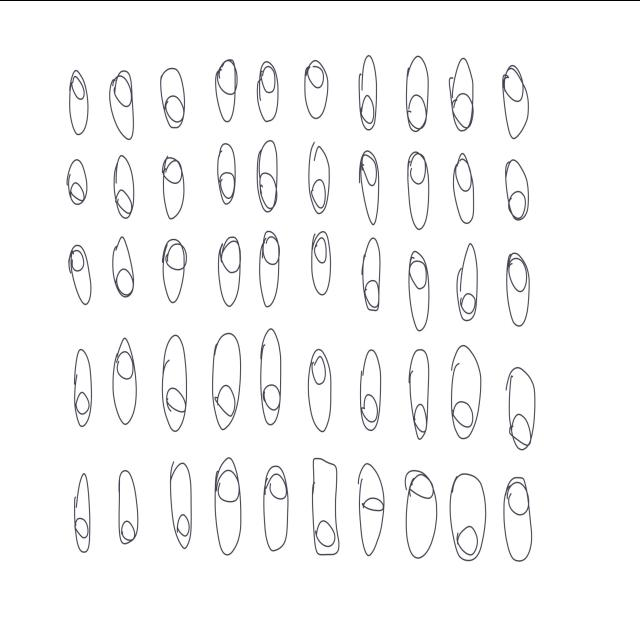
38_ProtoControl_SD_Fall2023/Software Files/ProtoControlTraining/train/images/toggle-1_jpg.rf.88dccc18f616b3b8663271b514211235.jpg
