ProtoControl/ProtoControl/38_ProtoControl_SD_Fall2023/Software Files/ProtoControlTraining/train/images/toggle-1_jpg.rf.37597a22cb797f277698b6951f99a599.jpg

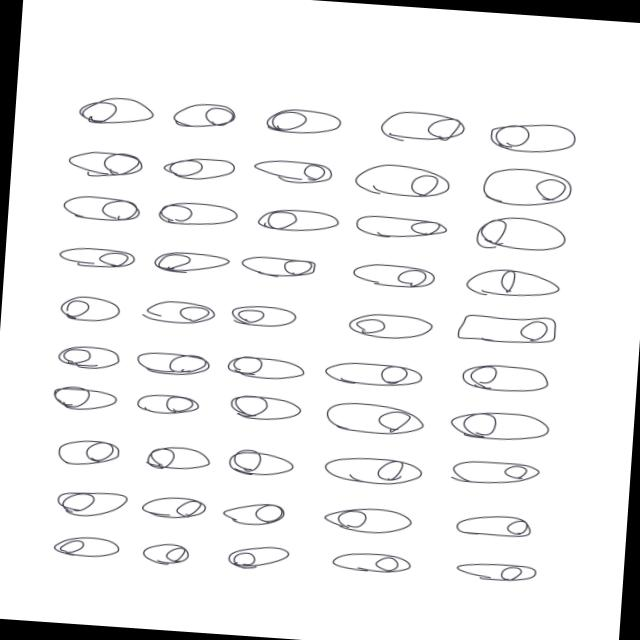
38_ProtoControl_SD_Fall2023/Software Files/ProtoControlTraining/train/images/toggle-1_jpg.rf.37597a22cb797f277698b6951f99a599.jpg
