ProtoControl/ProtoControl/38_ProtoControl_SD_Fall2023/Software Files/ProtoControlTraining/train/images/toggle-1_jpg.rf.e7aa30523f6bc7c561f14120662a96fd.jpg

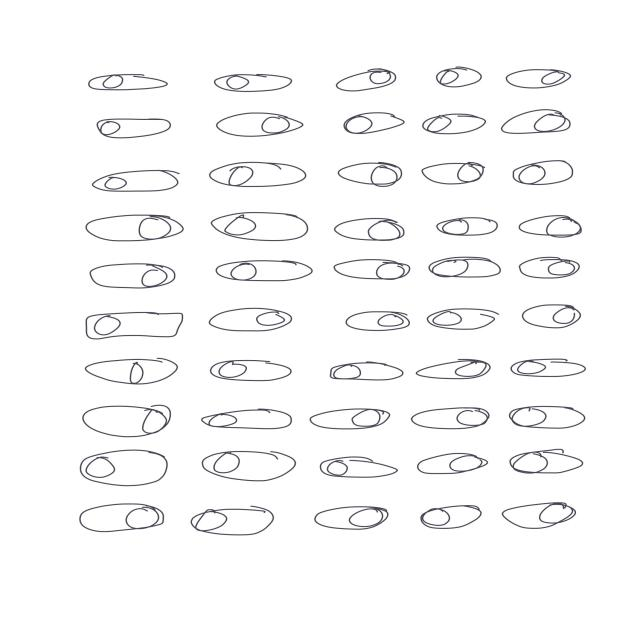
38_ProtoControl_SD_Fall2023/Software Files/ProtoControlTraining/train/images/toggle-1_jpg.rf.e7aa30523f6bc7c561f14120662a96fd.jpg
