ProtoControl/ProtoControl/38_ProtoControl_SD_Fall2023/Software Files/ProtoControlTraining/train/images/toggle-2_jpg.rf.2ecb5bde375f7f4fbb42b703cd96383f.jpg

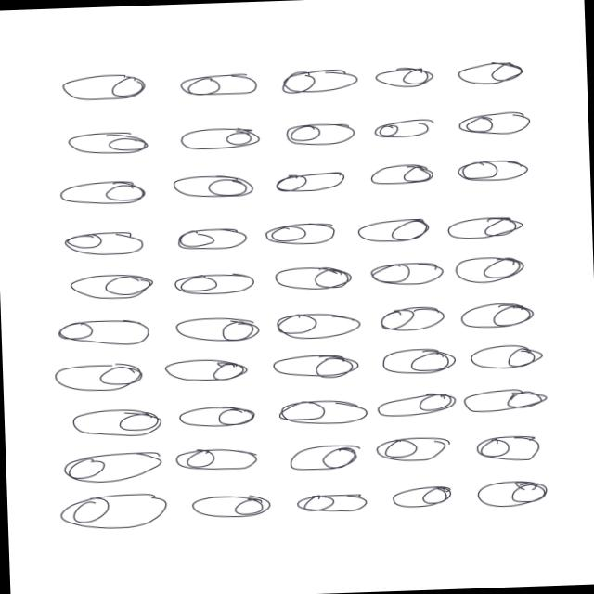
38_ProtoControl_SD_Fall2023/Software Files/ProtoControlTraining/train/images/toggle-2_jpg.rf.2ecb5bde375f7f4fbb42b703cd96383f.jpg
