ProtoControl/ProtoControl/38_ProtoControl_SD_Fall2023/Software Files/ProtoControlTraining/train/images/toggle-2_jpg.rf.39c41fe324ece10c0f062d9f52b66f17.jpg

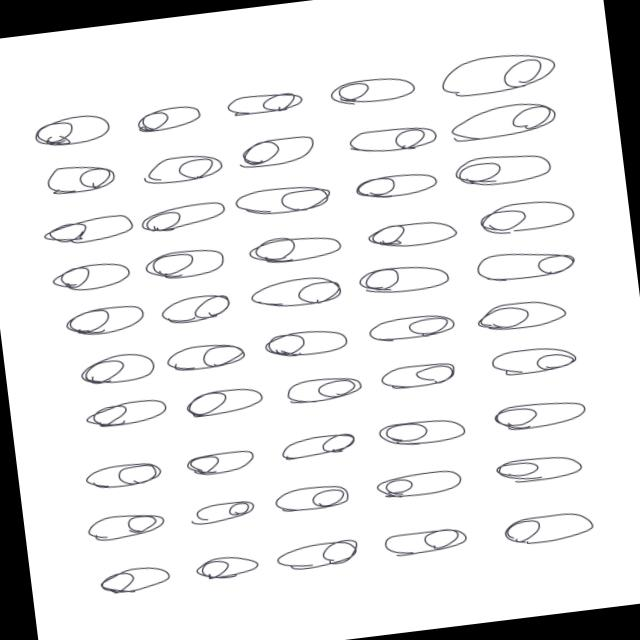
38_ProtoControl_SD_Fall2023/Software Files/ProtoControlTraining/train/images/toggle-2_jpg.rf.39c41fe324ece10c0f062d9f52b66f17.jpg
