ProtoControl/ProtoControl/38_ProtoControl_SD_Fall2023/Software Files/ProtoControlTraining/train/images/toggle-2_jpg.rf.e9cc418400f22f4bc4be4530c896cdda.jpg

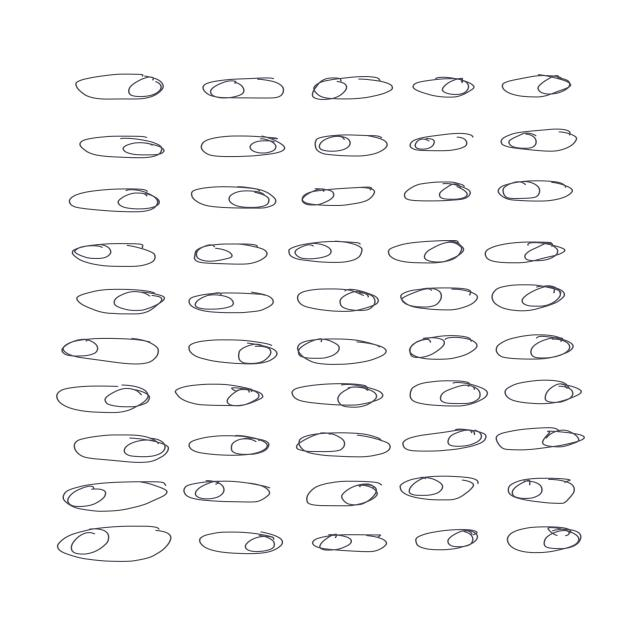
38_ProtoControl_SD_Fall2023/Software Files/ProtoControlTraining/train/images/toggle-2_jpg.rf.e9cc418400f22f4bc4be4530c896cdda.jpg
