ProtoControl/ProtoControl/38_ProtoControl_SD_Fall2023/Software Files/ProtoControlTraining/train/images/UI-Training-01_jpg.rf.a73c11b7bbe55e8a12d057fba47fc5a7.jpg

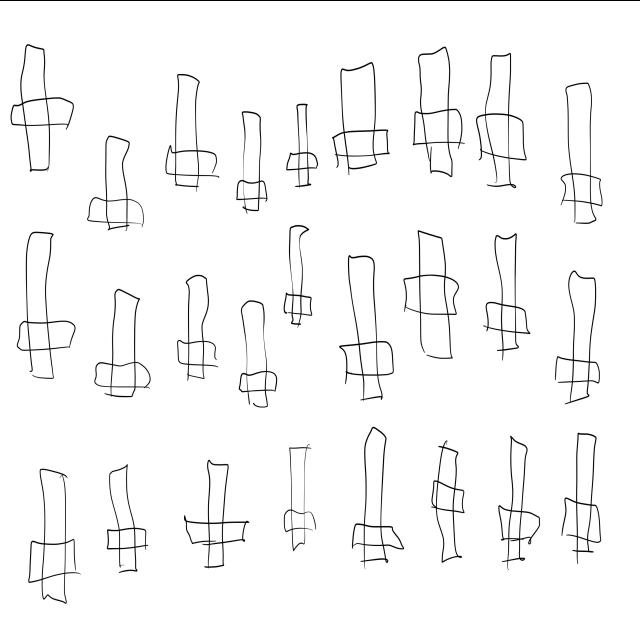
38_ProtoControl_SD_Fall2023/Software Files/ProtoControlTraining/train/images/UI-Training-01_jpg.rf.a73c11b7bbe55e8a12d057fba47fc5a7.jpg
