ProtoControl/ProtoControl/38_ProtoControl_SD_Fall2023/Software Files/ProtoControlTraining/train/images/UI-Training-01_jpg.rf.cd6a8c26bab29d1a1c58af74ad75099d.jpg

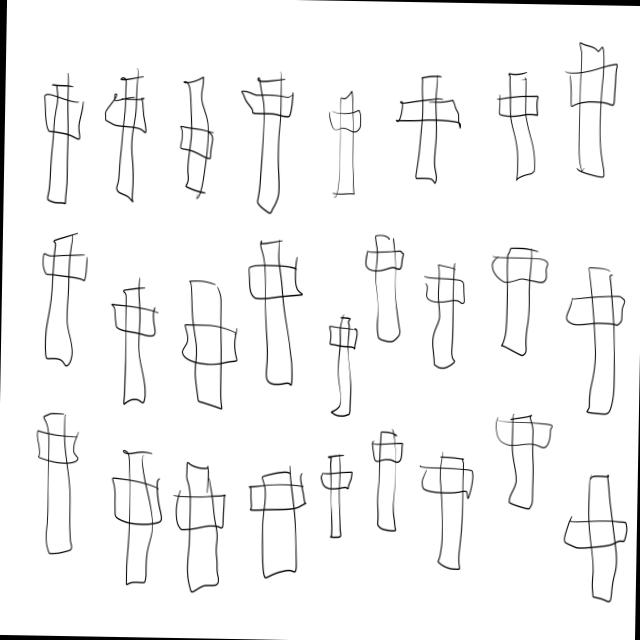
38_ProtoControl_SD_Fall2023/Software Files/ProtoControlTraining/train/images/UI-Training-01_jpg.rf.cd6a8c26bab29d1a1c58af74ad75099d.jpg
