ProtoControl/ProtoControl/38_ProtoControl_SD_Fall2023/Software Files/ProtoControlTraining/train/images/UI-Training-01_jpg.rf.eb6a1f9c41f2232419afcd8fa9329821.jpg

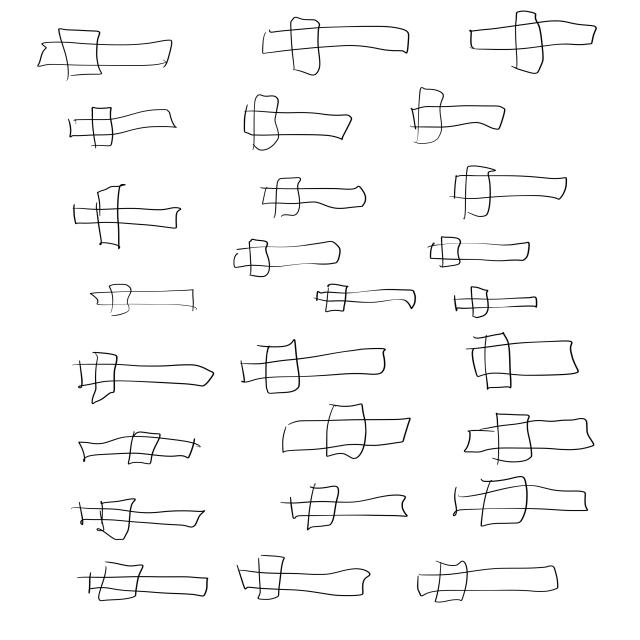
38_ProtoControl_SD_Fall2023/Software Files/ProtoControlTraining/train/images/UI-Training-01_jpg.rf.eb6a1f9c41f2232419afcd8fa9329821.jpg
