ProtoControl/ProtoControl/38_ProtoControl_SD_Fall2023/Software Files/ProtoControlTraining/train/images/UI-Training-03_jpg.rf.6c1f5df29376c94318cf2b7fe9e5ac49.jpg

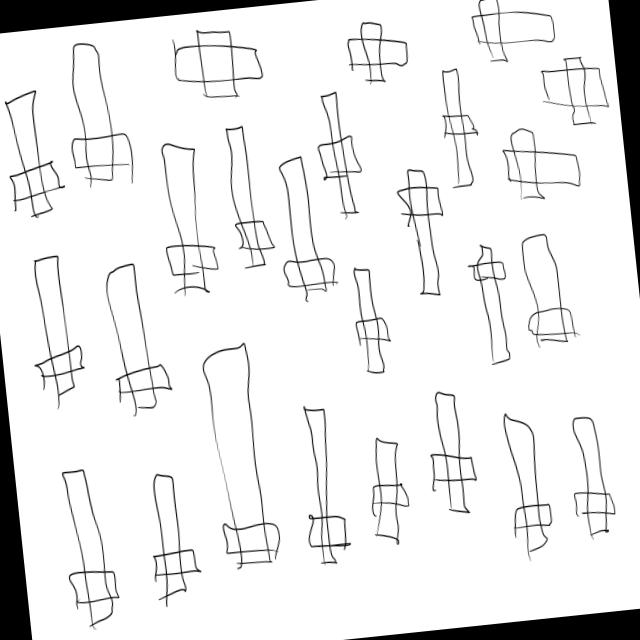
38_ProtoControl_SD_Fall2023/Software Files/ProtoControlTraining/train/images/UI-Training-03_jpg.rf.6c1f5df29376c94318cf2b7fe9e5ac49.jpg
