ProtoControl/ProtoControl/38_ProtoControl_SD_Fall2023/Software Files/ProtoControlTraining/train/images/UI-Training-03_jpg.rf.07f0bfed724ceac3165e358daef922f0.jpg

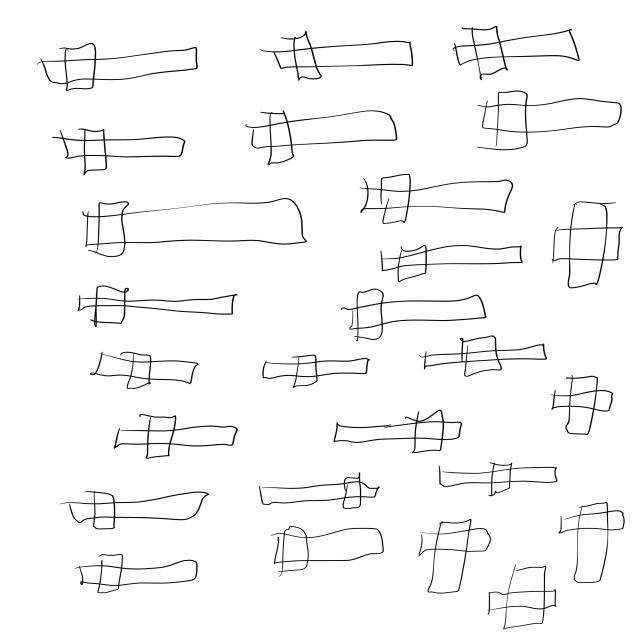
38_ProtoControl_SD_Fall2023/Software Files/ProtoControlTraining/train/images/UI-Training-03_jpg.rf.07f0bfed724ceac3165e358daef922f0.jpg
