ProtoControl/ProtoControl/38_ProtoControl_SD_Fall2023/Software Files/ProtoControlTraining/train/images/UI-Training-03_jpg.rf.548529a8f6e88acc2596b0b869392b86.jpg

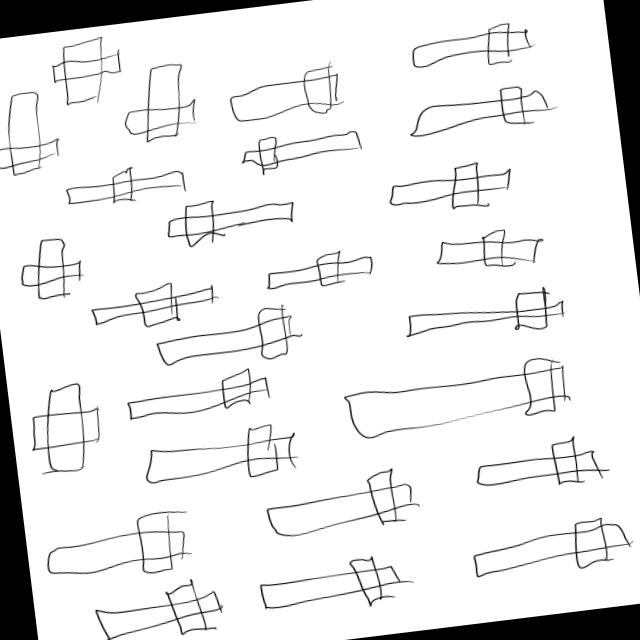
38_ProtoControl_SD_Fall2023/Software Files/ProtoControlTraining/train/images/UI-Training-03_jpg.rf.548529a8f6e88acc2596b0b869392b86.jpg
