ProtoControl/ProtoControl/38_ProtoControl_SD_Fall2023/Software Files/ProtoControlTraining/train/images/UI-Training-05_jpg.rf.8387de9a485024f388a59321ec5fb363.jpg

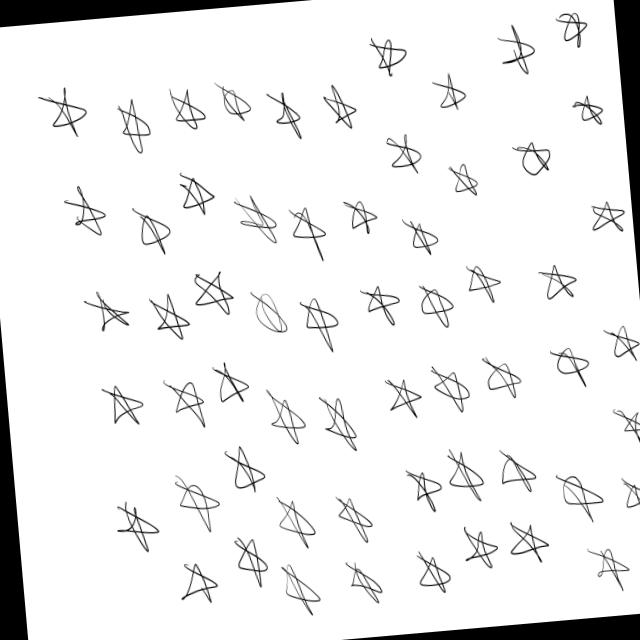
38_ProtoControl_SD_Fall2023/Software Files/ProtoControlTraining/train/images/UI-Training-05_jpg.rf.8387de9a485024f388a59321ec5fb363.jpg
