ProtoControl/ProtoControl/38_ProtoControl_SD_Fall2023/Software Files/ProtoControlTraining/train/images/UI-Training-05_jpg.rf.66055a369a95e63565ae5355b13ce492.jpg

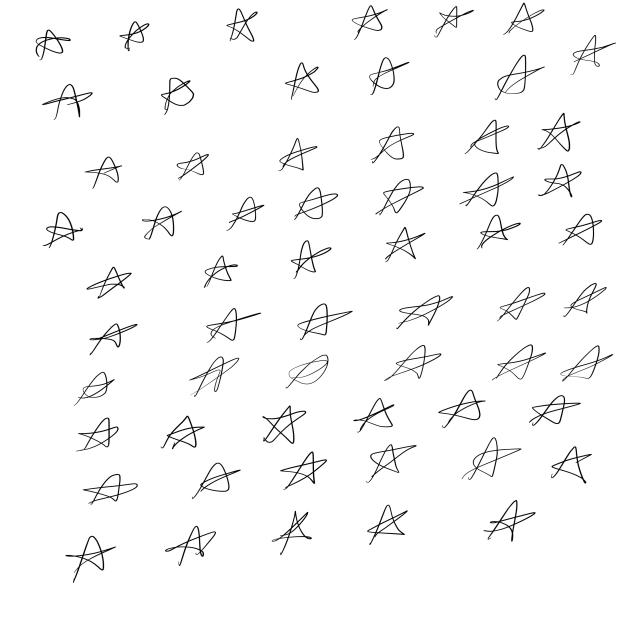
38_ProtoControl_SD_Fall2023/Software Files/ProtoControlTraining/train/images/UI-Training-05_jpg.rf.66055a369a95e63565ae5355b13ce492.jpg
