ProtoControl/ProtoControl/38_ProtoControl_SD_Fall2023/Software Files/ProtoControlTraining/train/images/UI-Training-05_jpg.rf.efa29a00b9458255d42c6e23f0d9185e.jpg

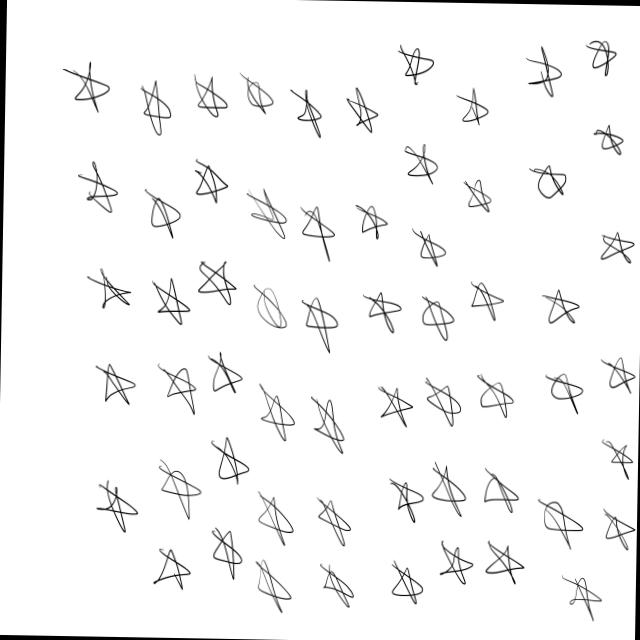
38_ProtoControl_SD_Fall2023/Software Files/ProtoControlTraining/train/images/UI-Training-05_jpg.rf.efa29a00b9458255d42c6e23f0d9185e.jpg
