ProtoControl/ProtoControl/38_ProtoControl_SD_Fall2023/Software Files/ProtoControlTraining/train/images/UI-Training-06_jpg.rf.1dbd970f3ac4a6fe4c64162d532824fa.jpg

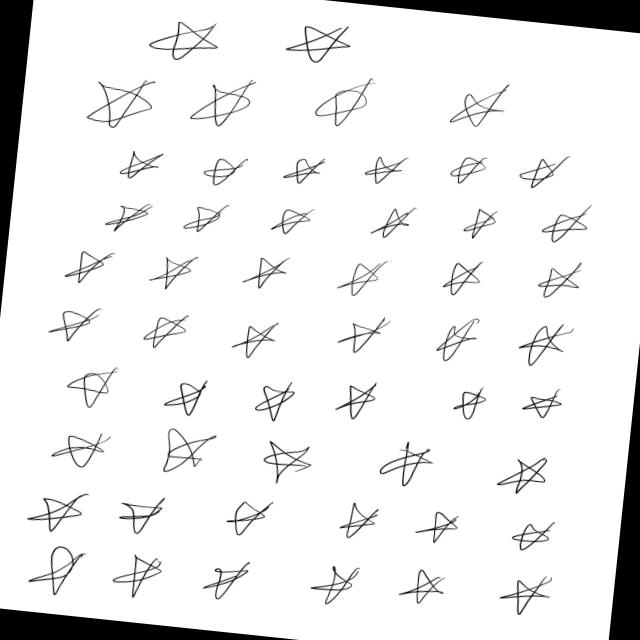
38_ProtoControl_SD_Fall2023/Software Files/ProtoControlTraining/train/images/UI-Training-06_jpg.rf.1dbd970f3ac4a6fe4c64162d532824fa.jpg
