ProtoControl/ProtoControl/38_ProtoControl_SD_Fall2023/Software Files/ProtoControlTraining/train/images/UI-Training-06_jpg.rf.30e89e842297456788e477797330e440.jpg

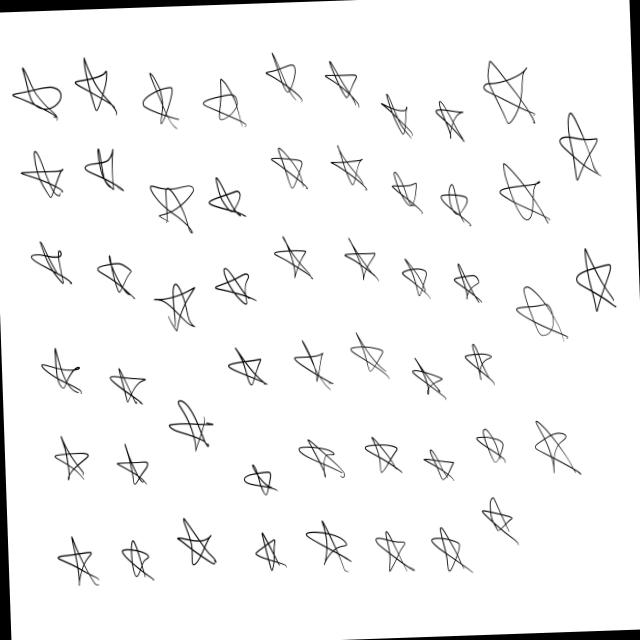
38_ProtoControl_SD_Fall2023/Software Files/ProtoControlTraining/train/images/UI-Training-06_jpg.rf.30e89e842297456788e477797330e440.jpg
