ProtoControl/ProtoControl/38_ProtoControl_SD_Fall2023/Software Files/ProtoControlTraining/train/images/UI-Training-06_jpg.rf.bb8aaf4f050d9eac44af6e1c11f6102e.jpg

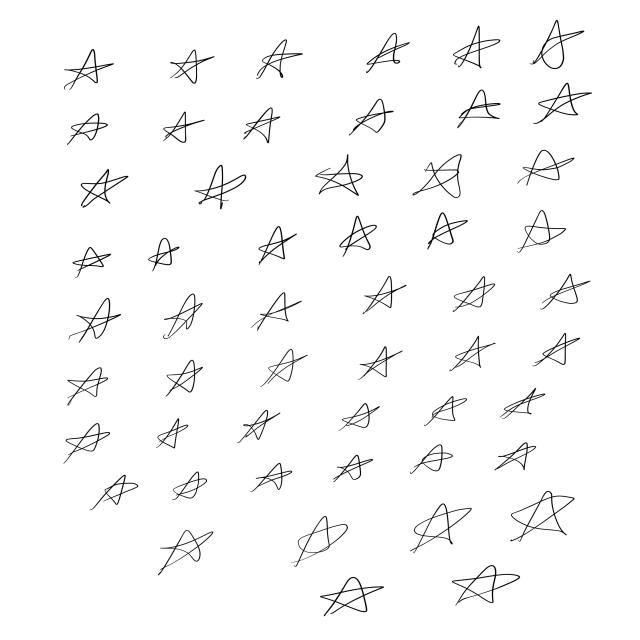
38_ProtoControl_SD_Fall2023/Software Files/ProtoControlTraining/train/images/UI-Training-06_jpg.rf.bb8aaf4f050d9eac44af6e1c11f6102e.jpg
