ProtoControl/ProtoControl/38_ProtoControl_SD_Fall2023/Software Files/ProtoControlTraining/train/images/UI-Training-07_jpg.rf.1b80edbc653513ac140ff90008b9bc3e.jpg

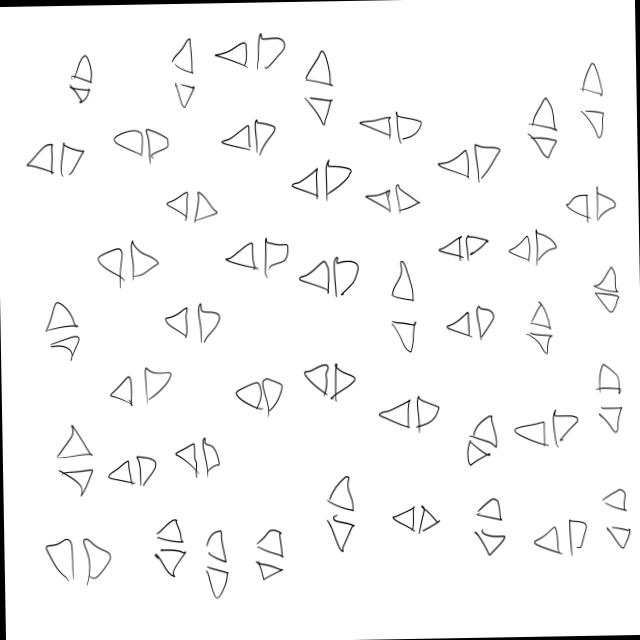
38_ProtoControl_SD_Fall2023/Software Files/ProtoControlTraining/train/images/UI-Training-07_jpg.rf.1b80edbc653513ac140ff90008b9bc3e.jpg
