ProtoControl/ProtoControl/38_ProtoControl_SD_Fall2023/Software Files/ProtoControlTraining/train/images/UI-Training-07_jpg.rf.8e3bca59e2ee4d4ab6f2fcb6759cd641.jpg

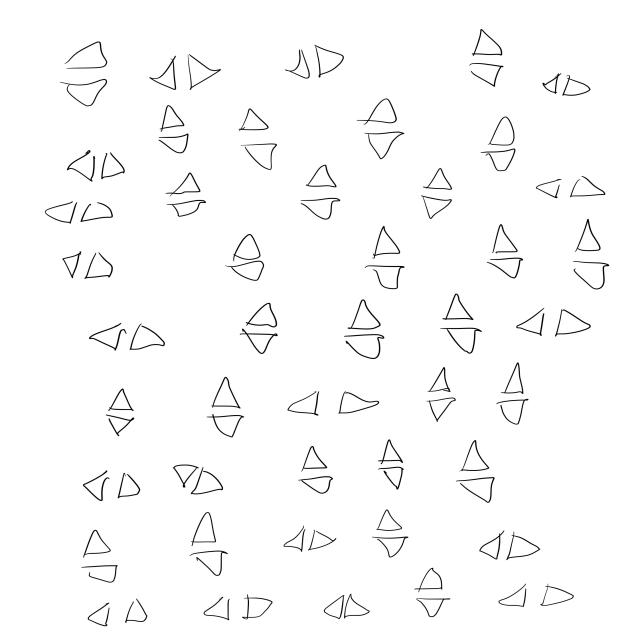
38_ProtoControl_SD_Fall2023/Software Files/ProtoControlTraining/train/images/UI-Training-07_jpg.rf.8e3bca59e2ee4d4ab6f2fcb6759cd641.jpg
