ProtoControl/ProtoControl/38_ProtoControl_SD_Fall2023/Software Files/ProtoControlTraining/train/images/UI-Training-07_jpg.rf.884df20b67a111a04bdb8240f82d44d2.jpg

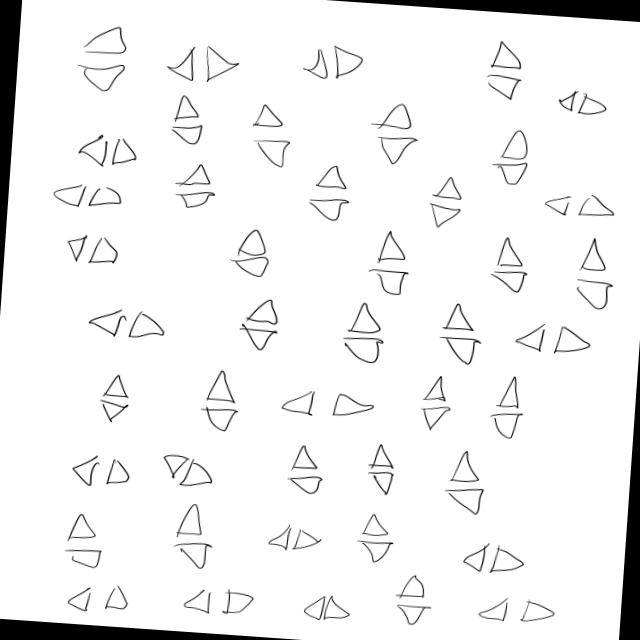
38_ProtoControl_SD_Fall2023/Software Files/ProtoControlTraining/train/images/UI-Training-07_jpg.rf.884df20b67a111a04bdb8240f82d44d2.jpg
