ProtoControl/ProtoControl/38_ProtoControl_SD_Fall2023/Software Files/ProtoControlTraining/train/images/UI-Training-08_jpg.rf.a4b4adca392de862f360990ed2a67c07.jpg

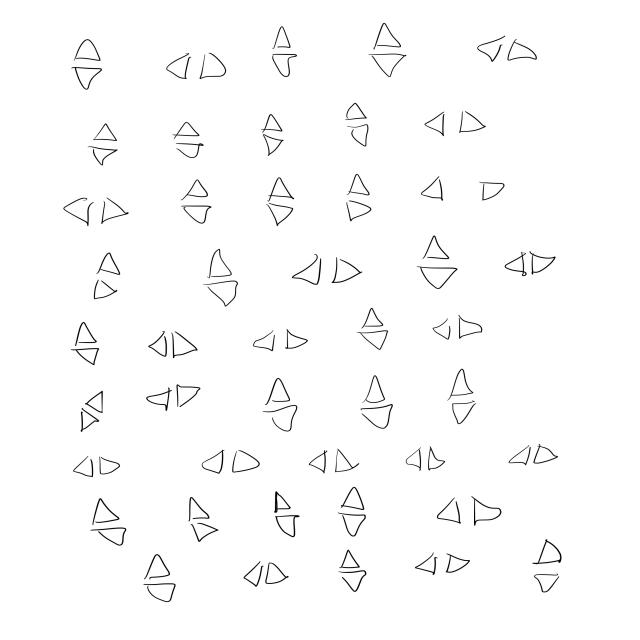
38_ProtoControl_SD_Fall2023/Software Files/ProtoControlTraining/train/images/UI-Training-08_jpg.rf.a4b4adca392de862f360990ed2a67c07.jpg
