ProtoControl/ProtoControl/38_ProtoControl_SD_Fall2023/Software Files/ProtoControlTraining/train/images/UI-Training-08_jpg.rf.dca3dc928bf204979b75c414f134fa45.jpg

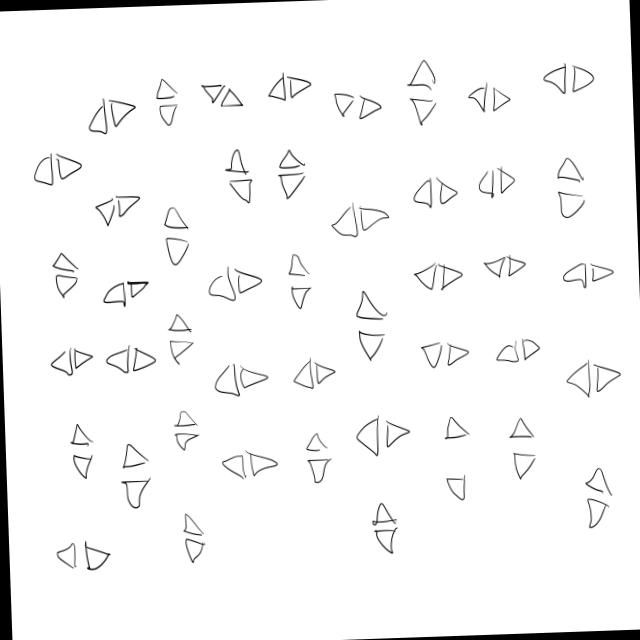
38_ProtoControl_SD_Fall2023/Software Files/ProtoControlTraining/train/images/UI-Training-08_jpg.rf.dca3dc928bf204979b75c414f134fa45.jpg
