ProtoControl/ProtoControl/38_ProtoControl_SD_Fall2023/Software Files/ProtoControlTraining/train/images/UI-Training-08_jpg.rf.dd5a87e624dbeea574bf070392fd8f03.jpg

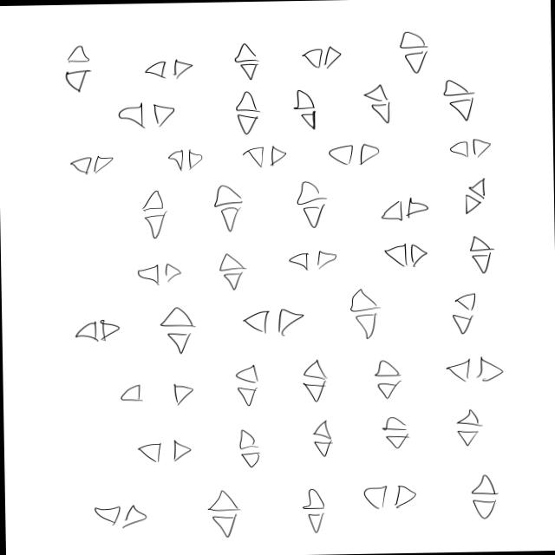
38_ProtoControl_SD_Fall2023/Software Files/ProtoControlTraining/train/images/UI-Training-08_jpg.rf.dd5a87e624dbeea574bf070392fd8f03.jpg
