ProtoControl/ProtoControl/38_ProtoControl_SD_Fall2023/Software Files/ProtoControlTraining/train/images/UI-Training-09_jpg.rf.173705ebb5365015af8aea0760777ad7.jpg

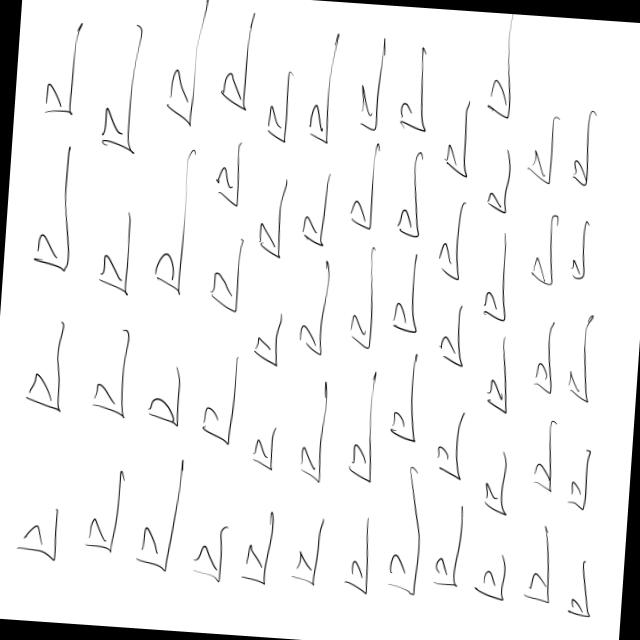
38_ProtoControl_SD_Fall2023/Software Files/ProtoControlTraining/train/images/UI-Training-09_jpg.rf.173705ebb5365015af8aea0760777ad7.jpg
