ProtoControl/ProtoControl/38_ProtoControl_SD_Fall2023/Software Files/ProtoControlTraining/train/images/UI-Training-09_jpg.rf.af72fcf52ea3c2921b3cdfc8ed7f5d8f.jpg

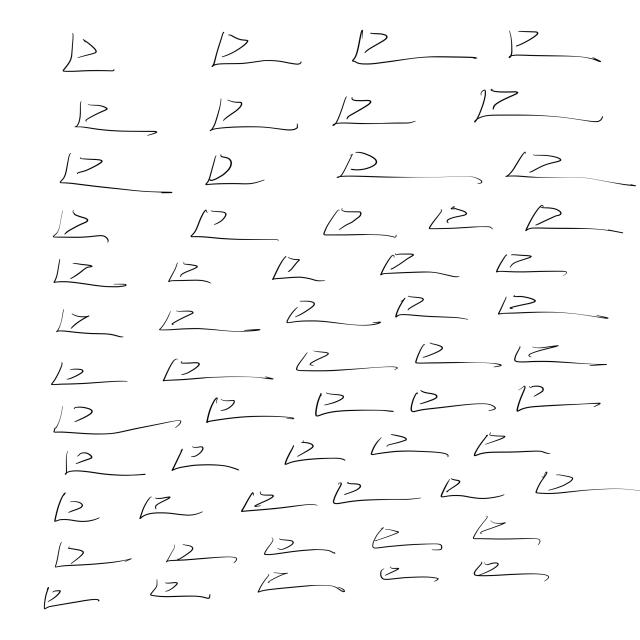
38_ProtoControl_SD_Fall2023/Software Files/ProtoControlTraining/train/images/UI-Training-09_jpg.rf.af72fcf52ea3c2921b3cdfc8ed7f5d8f.jpg
