ProtoControl/ProtoControl/38_ProtoControl_SD_Fall2023/Software Files/ProtoControlTraining/train/images/UI-Training-09_jpg.rf.c54783383dfddde493c897bee3e83af6.jpg

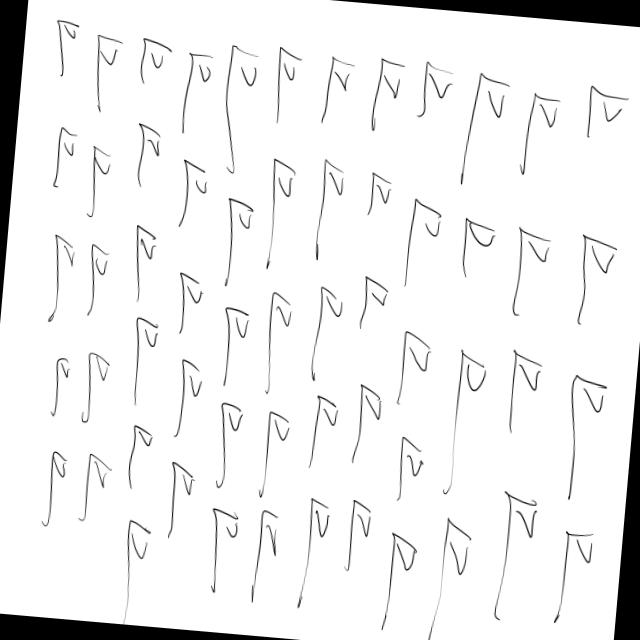
38_ProtoControl_SD_Fall2023/Software Files/ProtoControlTraining/train/images/UI-Training-09_jpg.rf.c54783383dfddde493c897bee3e83af6.jpg
