ProtoControl/ProtoControl/38_ProtoControl_SD_Fall2023/Software Files/ProtoControlTraining/train/images/UI-Training-10_jpg.rf.4e374c3ebb956c1f28a9b91f40a39e60.jpg

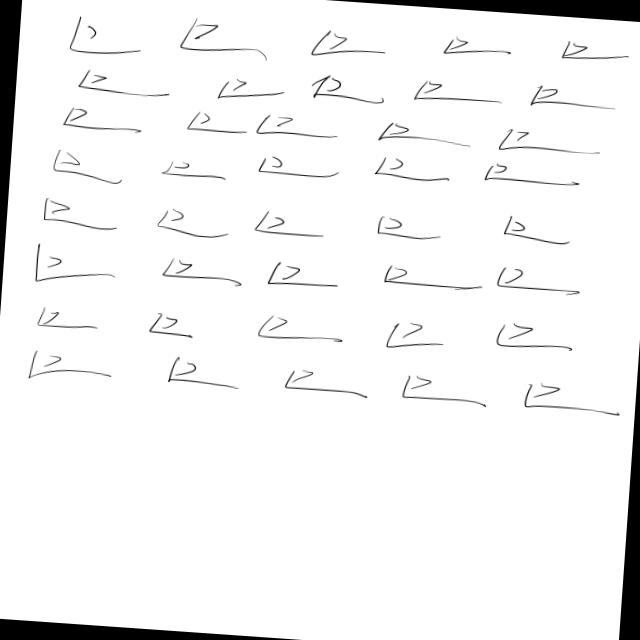
38_ProtoControl_SD_Fall2023/Software Files/ProtoControlTraining/train/images/UI-Training-10_jpg.rf.4e374c3ebb956c1f28a9b91f40a39e60.jpg
