ProtoControl/ProtoControl/38_ProtoControl_SD_Fall2023/Software Files/ProtoControlTraining/train/images/UI-Training-10_jpg.rf.61e00713e47efb6812b8c1e5dcecaac6.jpg

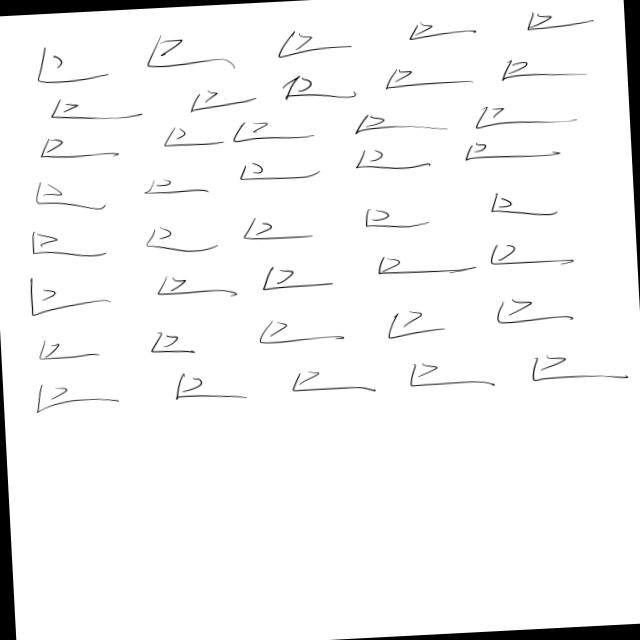
38_ProtoControl_SD_Fall2023/Software Files/ProtoControlTraining/train/images/UI-Training-10_jpg.rf.61e00713e47efb6812b8c1e5dcecaac6.jpg
