ProtoControl/ProtoControl/38_ProtoControl_SD_Fall2023/Software Files/ProtoControlTraining/train/images/UI-Training-10_jpg.rf.aa53f5977f9e74117db36fe156e7b08e.jpg

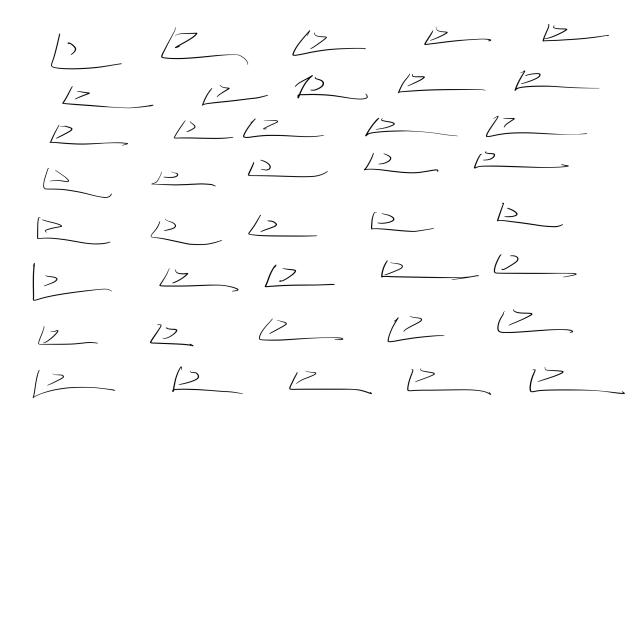
38_ProtoControl_SD_Fall2023/Software Files/ProtoControlTraining/train/images/UI-Training-10_jpg.rf.aa53f5977f9e74117db36fe156e7b08e.jpg
