ProtoControl/ProtoControl/38_ProtoControl_SD_Fall2023/Software Files/ProtoControlTraining/train/images/UI-Training-11_jpg.rf.09b8646980cce0f1a9749926b3250461.jpg

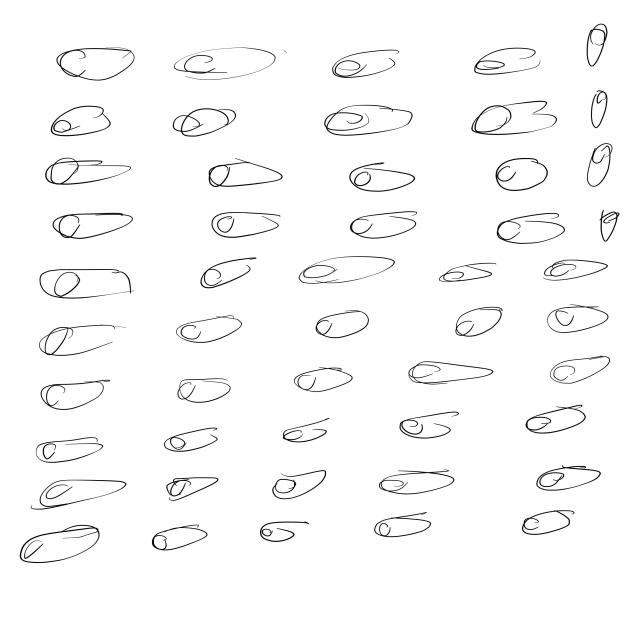
38_ProtoControl_SD_Fall2023/Software Files/ProtoControlTraining/train/images/UI-Training-11_jpg.rf.09b8646980cce0f1a9749926b3250461.jpg
