ProtoControl/ProtoControl/38_ProtoControl_SD_Fall2023/Software Files/ProtoControlTraining/train/images/UI-Training-11_jpg.rf.22944117f3f5f9d0723a9396e7efa3bf.jpg

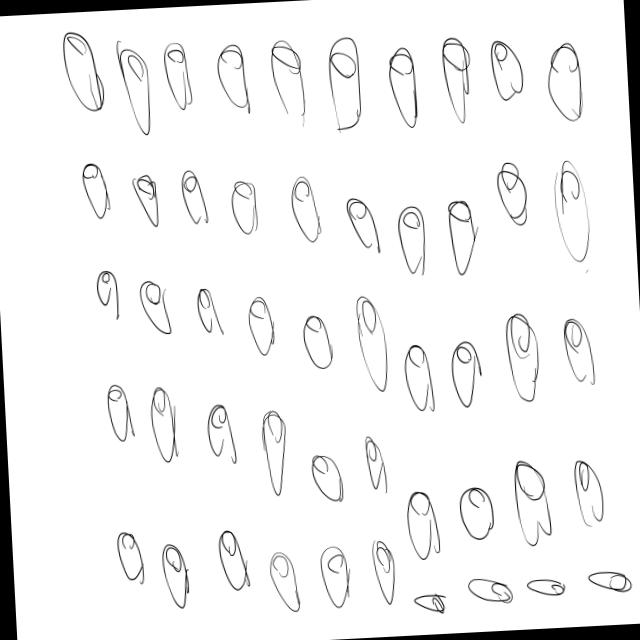
38_ProtoControl_SD_Fall2023/Software Files/ProtoControlTraining/train/images/UI-Training-11_jpg.rf.22944117f3f5f9d0723a9396e7efa3bf.jpg
