ProtoControl/ProtoControl/38_ProtoControl_SD_Fall2023/Software Files/ProtoControlTraining/train/images/UI-Training-11_jpg.rf.63003734a94f0ca444ce9c9d83a7aa0f.jpg

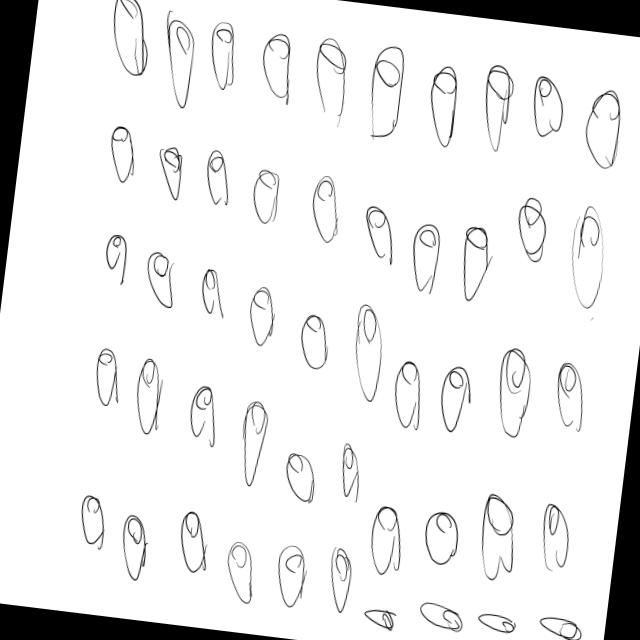
38_ProtoControl_SD_Fall2023/Software Files/ProtoControlTraining/train/images/UI-Training-11_jpg.rf.63003734a94f0ca444ce9c9d83a7aa0f.jpg
