ProtoControl/ProtoControl/38_ProtoControl_SD_Fall2023/Software Files/ProtoControlTraining/train/images/UI-Training-12_jpg.rf.4b1f82015e7b3a3d3e12694e8a497efb.jpg

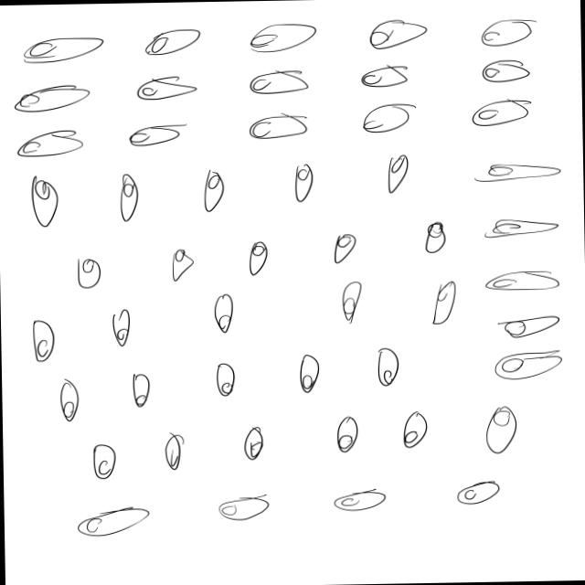
38_ProtoControl_SD_Fall2023/Software Files/ProtoControlTraining/train/images/UI-Training-12_jpg.rf.4b1f82015e7b3a3d3e12694e8a497efb.jpg
