ProtoControl/ProtoControl/38_ProtoControl_SD_Fall2023/Software Files/ProtoControlTraining/train/images/UI-Training-12_jpg.rf.fcc94ea20a1cc41d70cc09cd17d77ac3.jpg

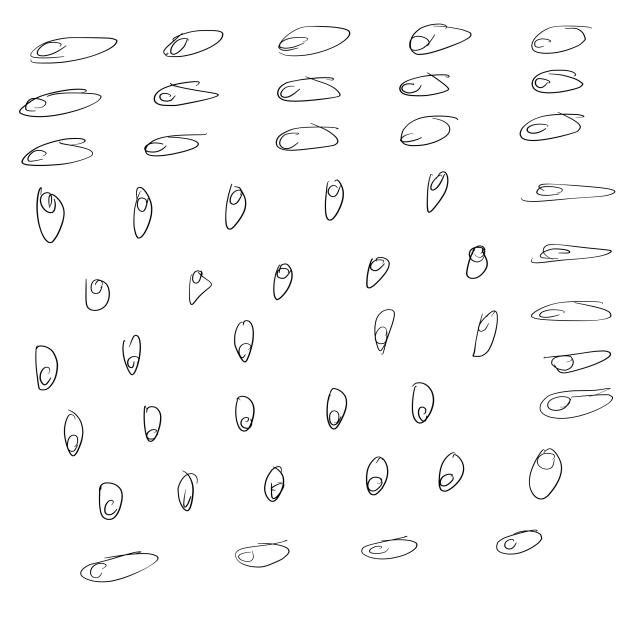
38_ProtoControl_SD_Fall2023/Software Files/ProtoControlTraining/train/images/UI-Training-12_jpg.rf.fcc94ea20a1cc41d70cc09cd17d77ac3.jpg
