ProtoControl/ProtoControl/38_ProtoControl_SD_Fall2023/Software Files/ProtoControlTraining/train/images/UI-Training-13_jpg.rf.80d752e73bb081299614fc4b9a82c79d.jpg

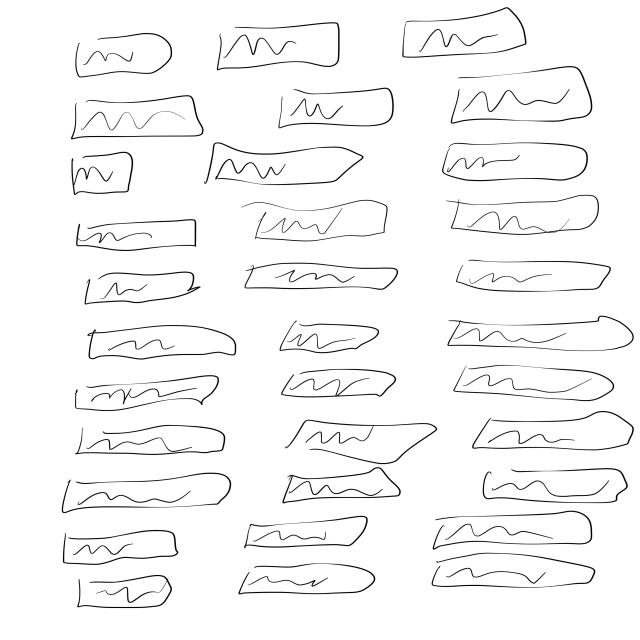
38_ProtoControl_SD_Fall2023/Software Files/ProtoControlTraining/train/images/UI-Training-13_jpg.rf.80d752e73bb081299614fc4b9a82c79d.jpg
