ProtoControl/ProtoControl/38_ProtoControl_SD_Fall2023/Software Files/ProtoControlTraining/train/images/UI-Training-13_jpg.rf.351429df7c9fe443548180dafe590464.jpg

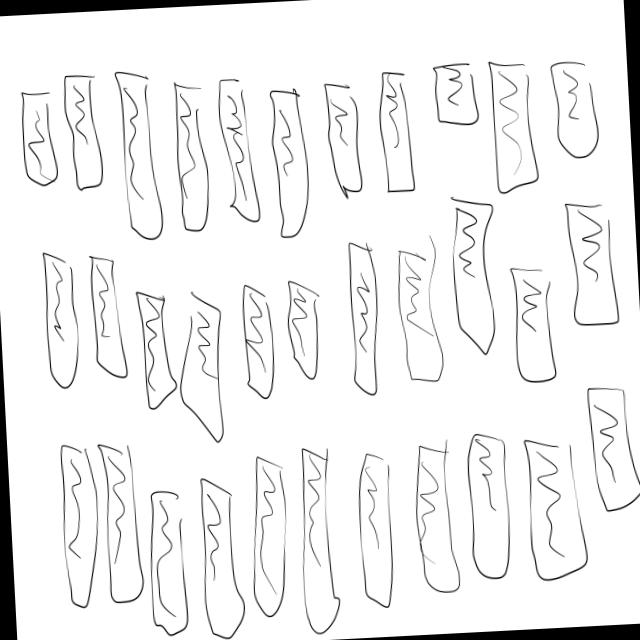
38_ProtoControl_SD_Fall2023/Software Files/ProtoControlTraining/train/images/UI-Training-13_jpg.rf.351429df7c9fe443548180dafe590464.jpg
