ProtoControl/ProtoControl/38_ProtoControl_SD_Fall2023/Software Files/ProtoControlTraining/train/images/UI-Training-13_jpg.rf.a7798710c65d01ea8d85c98c3dfcedff.jpg

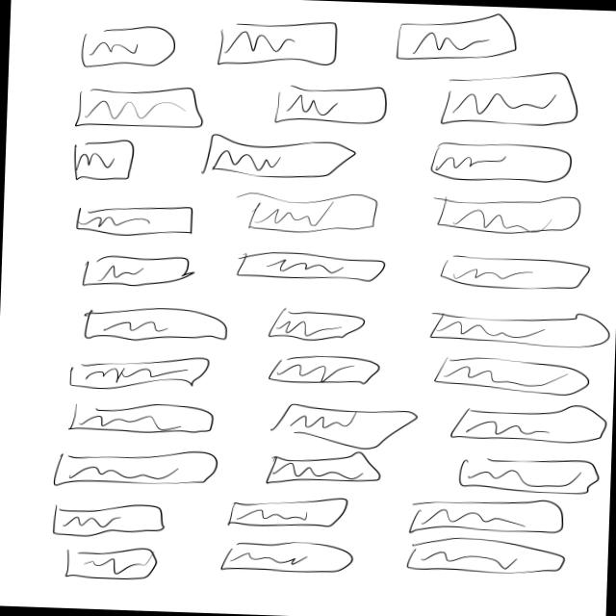
38_ProtoControl_SD_Fall2023/Software Files/ProtoControlTraining/train/images/UI-Training-13_jpg.rf.a7798710c65d01ea8d85c98c3dfcedff.jpg
