ProtoControl/ProtoControl/38_ProtoControl_SD_Fall2023/Software Files/ProtoControlTraining/train/images/UI-Training-15_jpg.rf.0b2422c38f2640dc607d0ea6dcc1b8a3.jpg

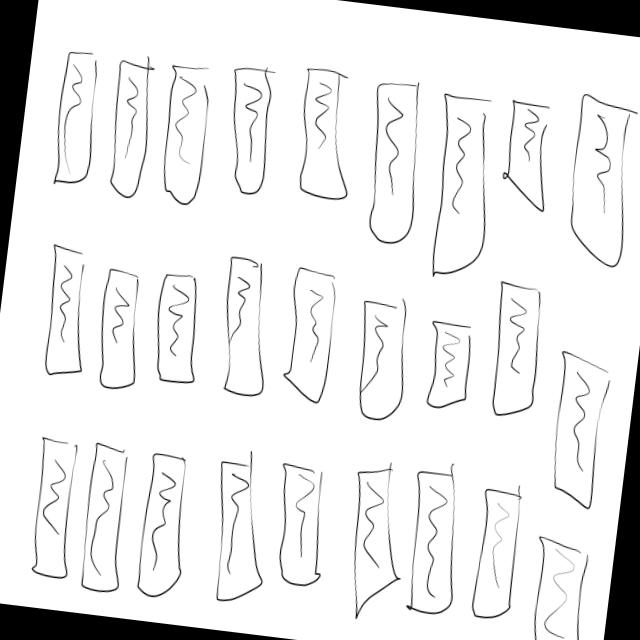
38_ProtoControl_SD_Fall2023/Software Files/ProtoControlTraining/train/images/UI-Training-15_jpg.rf.0b2422c38f2640dc607d0ea6dcc1b8a3.jpg
