ProtoControl/ProtoControl/38_ProtoControl_SD_Fall2023/Software Files/ProtoControlTraining/train/images/UI-Training-15_jpg.rf.2baf9716bf600f950df88d8673cdd8ed.jpg

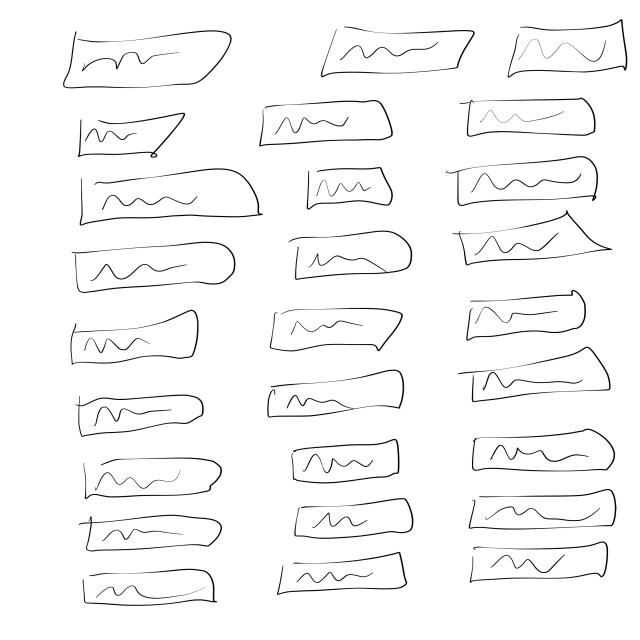
38_ProtoControl_SD_Fall2023/Software Files/ProtoControlTraining/train/images/UI-Training-15_jpg.rf.2baf9716bf600f950df88d8673cdd8ed.jpg
