ProtoControl/ProtoControl/38_ProtoControl_SD_Fall2023/Software Files/ProtoControlTraining/train/images/UI-Training-15_jpg.rf.e52e0b2011940676849d8fc3334d046f.jpg

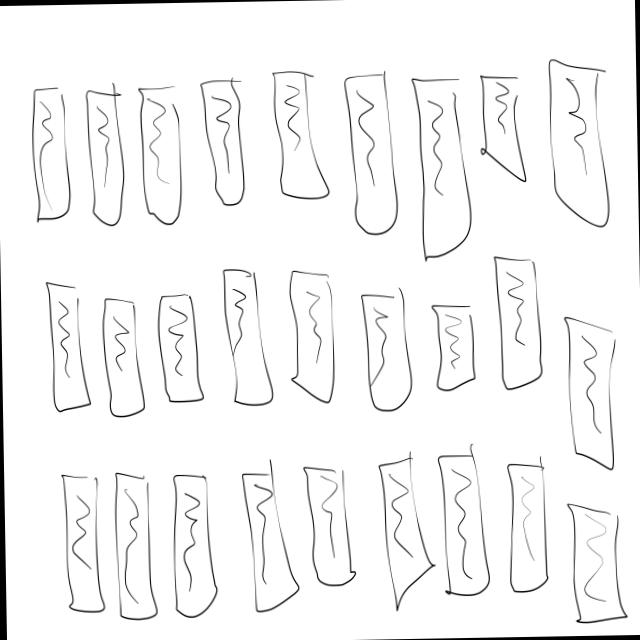
38_ProtoControl_SD_Fall2023/Software Files/ProtoControlTraining/train/images/UI-Training-15_jpg.rf.e52e0b2011940676849d8fc3334d046f.jpg
