ProtoControl/ProtoControl/38_ProtoControl_SD_Fall2023/Software Files/ProtoControlTraining/valid/images/buttons-1_jpg.rf.147ab917a7b304e584bc18045bd8ad36.jpg

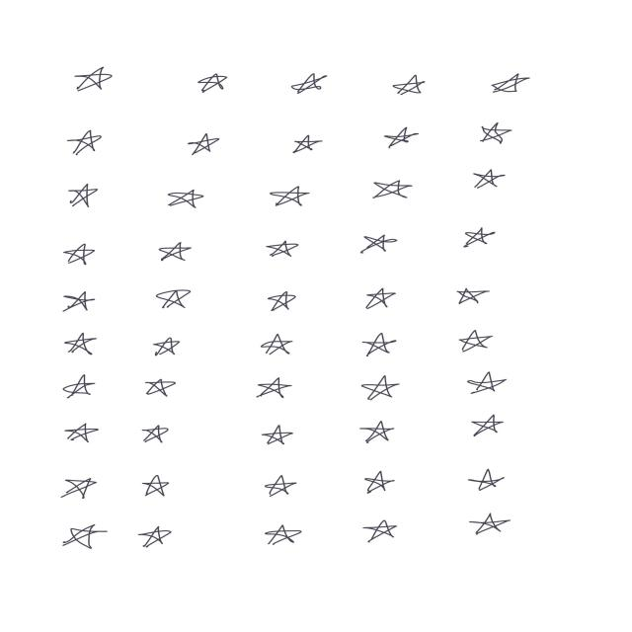
38_ProtoControl_SD_Fall2023/Software Files/ProtoControlTraining/valid/images/buttons-1_jpg.rf.147ab917a7b304e584bc18045bd8ad36.jpg
