ProtoControl/ProtoControl/38_ProtoControl_SD_Fall2023/Software Files/ProtoControlTraining/valid/images/buttons-2_jpg.rf.25f1f07fa08480e3b67a43ab2761a31f.jpg

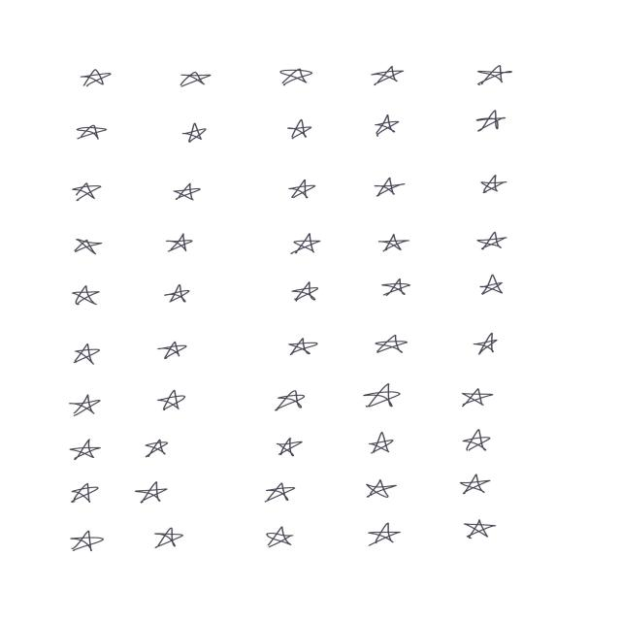
38_ProtoControl_SD_Fall2023/Software Files/ProtoControlTraining/valid/images/buttons-2_jpg.rf.25f1f07fa08480e3b67a43ab2761a31f.jpg
