ProtoControl/ProtoControl/38_ProtoControl_SD_Fall2023/Software Files/ProtoControlTraining/valid/images/IMG_0675_jpg.rf.a2ad40356863ea8b1c8d005c97be3af1.jpg

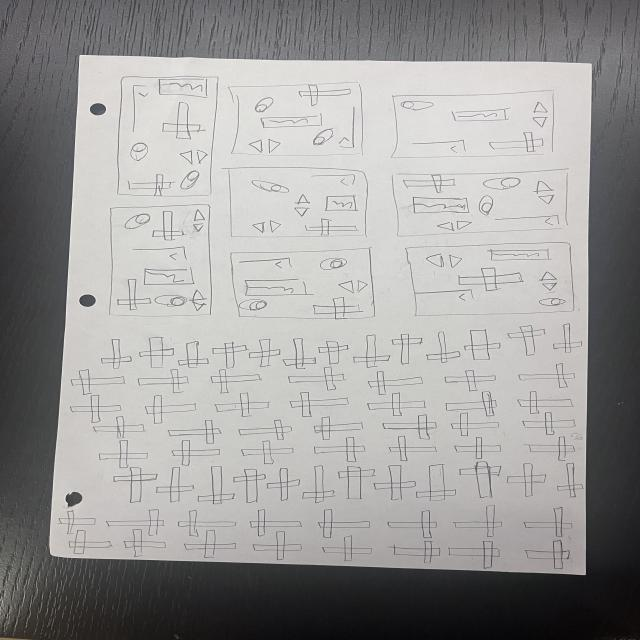
38_ProtoControl_SD_Fall2023/Software Files/ProtoControlTraining/valid/images/IMG_0675_jpg.rf.a2ad40356863ea8b1c8d005c97be3af1.jpg
