ProtoControl/ProtoControl/38_ProtoControl_SD_Fall2023/Software Files/ProtoControlTraining/valid/images/increment-_-decrement-1_jpg.rf.2bb0af30e95ad210bfebd492a4ea590c.jpg

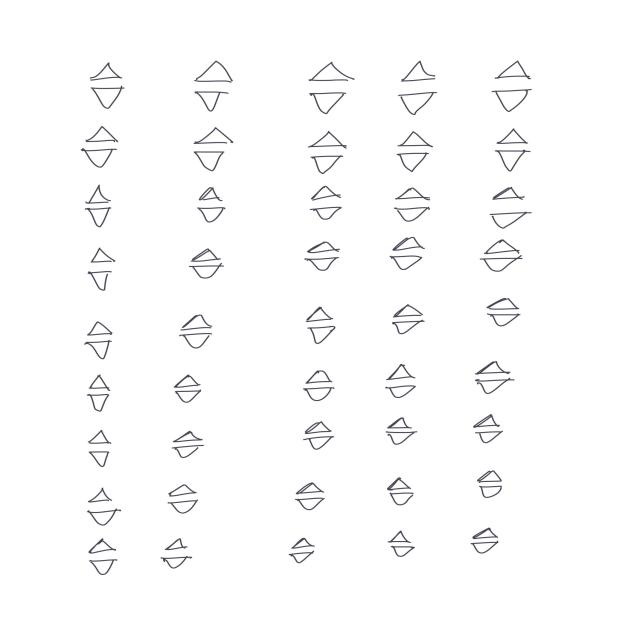
38_ProtoControl_SD_Fall2023/Software Files/ProtoControlTraining/valid/images/increment-_-decrement-1_jpg.rf.2bb0af30e95ad210bfebd492a4ea590c.jpg
