ProtoControl/ProtoControl/38_ProtoControl_SD_Fall2023/Software Files/ProtoControlTraining/valid/images/increment-_-decrement-2_jpg.rf.58d179de4ad76a87497aee014ea6b0aa.jpg

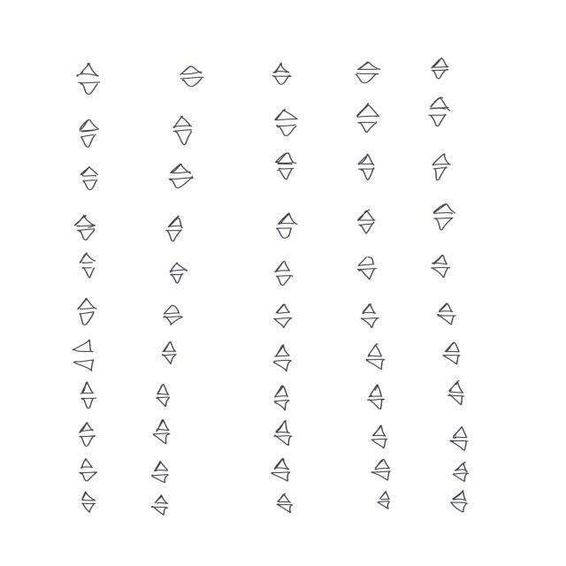
38_ProtoControl_SD_Fall2023/Software Files/ProtoControlTraining/valid/images/increment-_-decrement-2_jpg.rf.58d179de4ad76a87497aee014ea6b0aa.jpg
