ProtoControl/ProtoControl/38_ProtoControl_SD_Fall2023/Software Files/ProtoControlTraining/valid/images/sliders-2_jpg.rf.2cefc31af24146cd6571ef055da08859.jpg

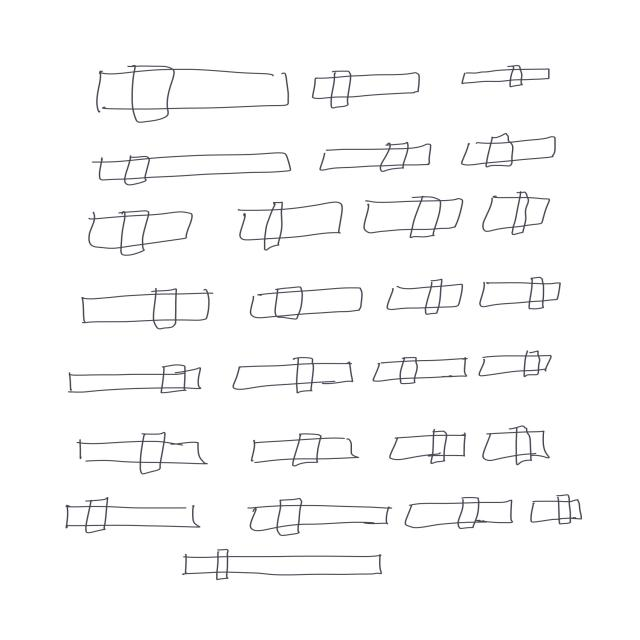
38_ProtoControl_SD_Fall2023/Software Files/ProtoControlTraining/valid/images/sliders-2_jpg.rf.2cefc31af24146cd6571ef055da08859.jpg
