ProtoControl/ProtoControl/38_ProtoControl_SD_Fall2023/Software Files/ProtoControlTraining/valid/images/UI-Training-02_jpg.rf.5865df4bdebf6bb003de01f8c9970a0e.jpg

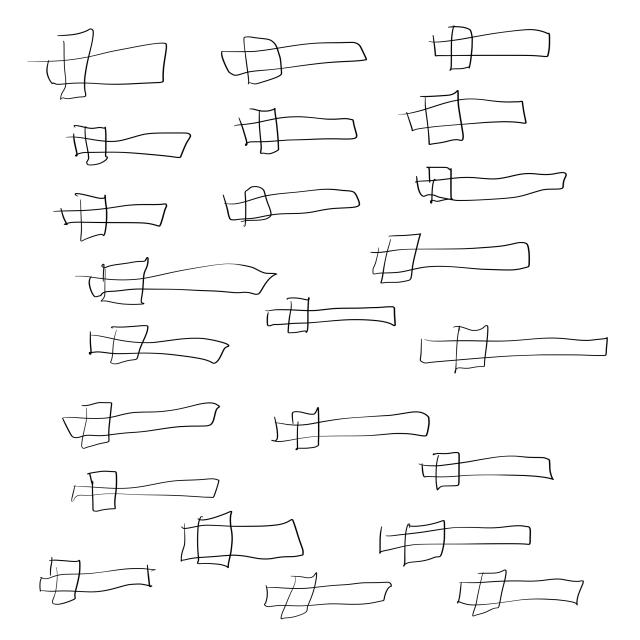
38_ProtoControl_SD_Fall2023/Software Files/ProtoControlTraining/valid/images/UI-Training-02_jpg.rf.5865df4bdebf6bb003de01f8c9970a0e.jpg
