ProtoControl/ProtoControl/38_ProtoControl_SD_Fall2023/Software Files/ProtoControlTraining/valid/images/UI-Training-04_jpg.rf.01a556bed02c47bb7be118f18a16a22f.jpg

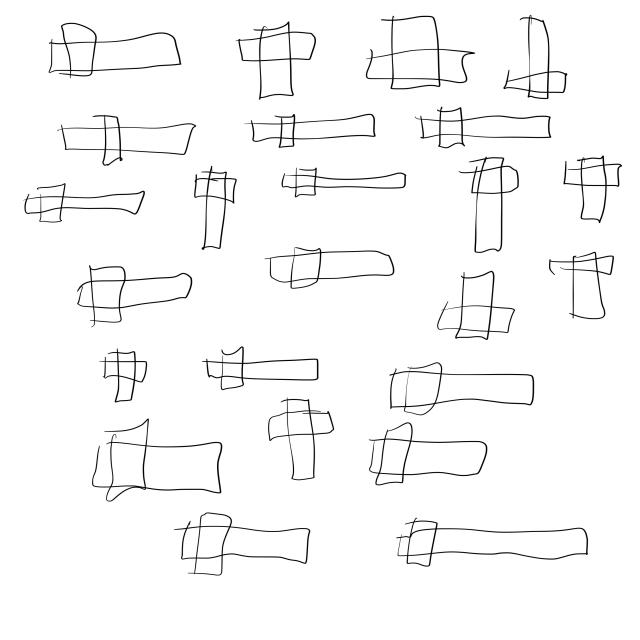
38_ProtoControl_SD_Fall2023/Software Files/ProtoControlTraining/valid/images/UI-Training-04_jpg.rf.01a556bed02c47bb7be118f18a16a22f.jpg
