ProtoControl/ProtoControl/38_ProtoControl_SD_Fall2023/Software Files/ProtoControlTraining/valid/images/UI-Training-14_jpg.rf.7bacd66ef9ac014f8a6b675510871136.jpg

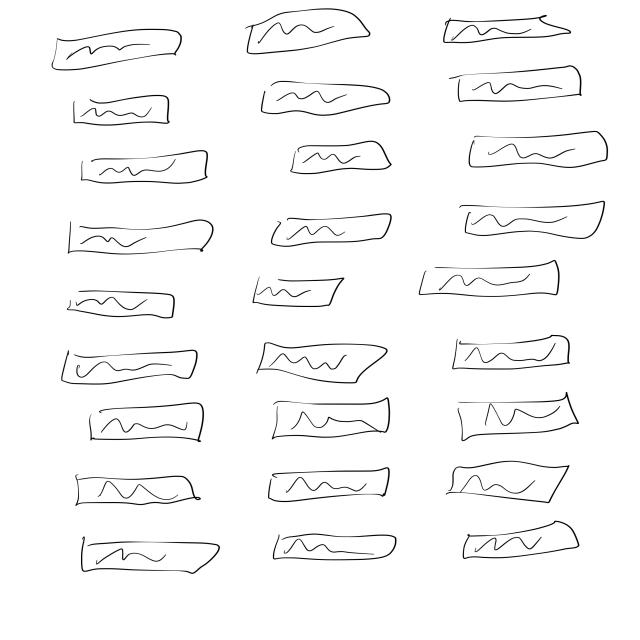
38_ProtoControl_SD_Fall2023/Software Files/ProtoControlTraining/valid/images/UI-Training-14_jpg.rf.7bacd66ef9ac014f8a6b675510871136.jpg
