ProtoControl/ProtoControl/38_ProtoControl_SD_Fall2023/Software Files/Training Photos/buttons -2.jpg

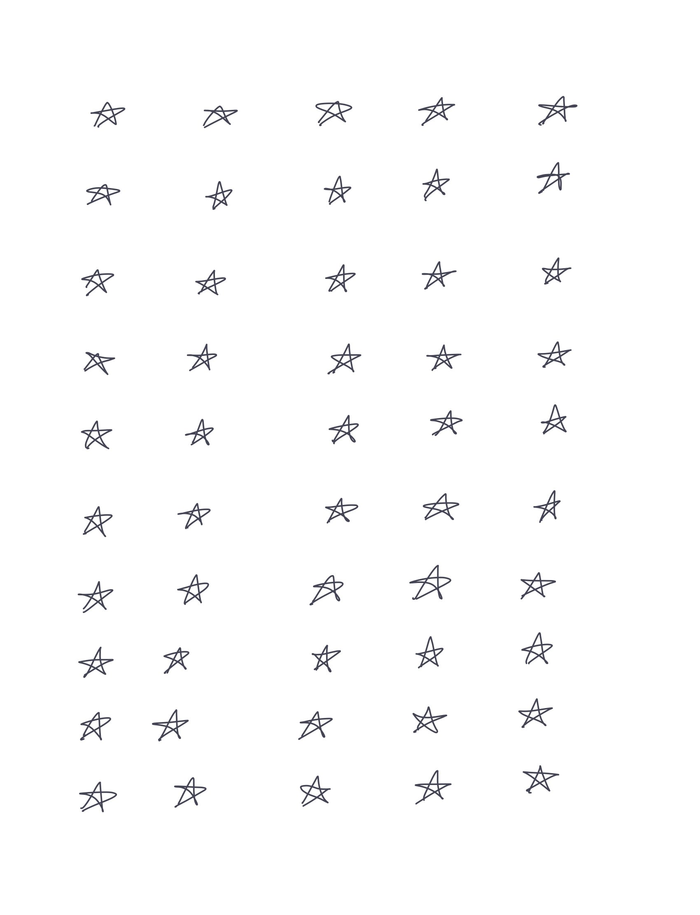
38_ProtoControl_SD_Fall2023/Software Files/Training Photos/buttons -2.jpg
