ProtoControl/ProtoControl/38_ProtoControl_SD_Fall2023/Software Files/Training Photos/terminal watch window -1.jpg

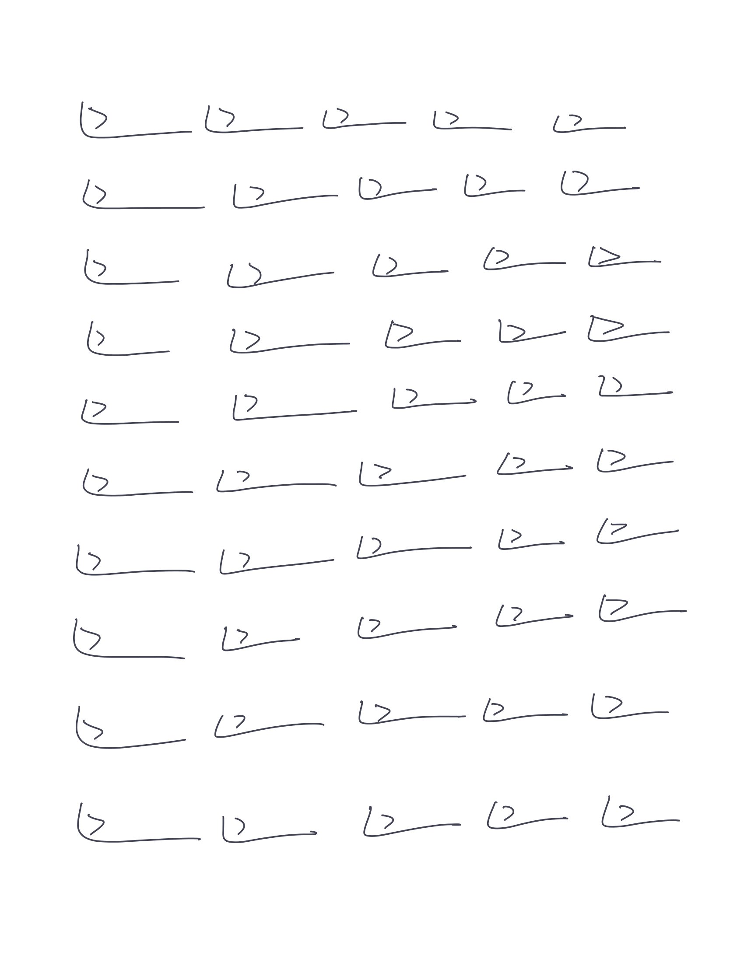
38_ProtoControl_SD_Fall2023/Software Files/Training Photos/terminal watch window -1.jpg
