ProtoControl/ProtoControl/38_ProtoControl_SD_Fall2023/Software Files/Training Photos/UI Training-09.jpg

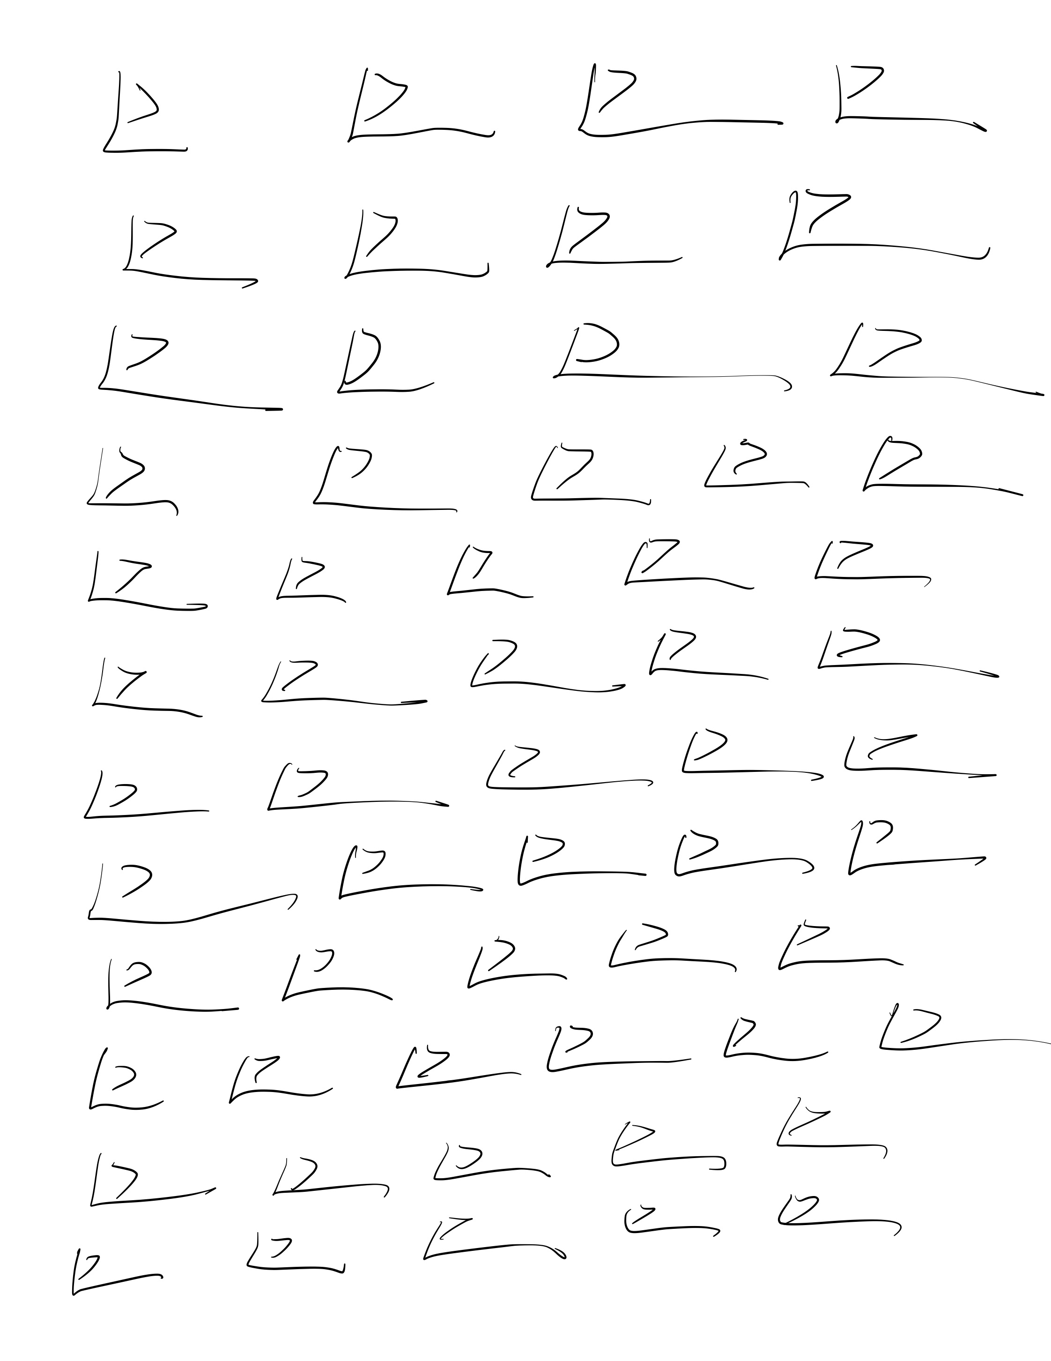
38_ProtoControl_SD_Fall2023/Software Files/Training Photos/UI Training-09.jpg
