ProtoControl/ProtoControl/38_ProtoControl_SD_Fall2023/Hardware Files/Hardware Inventory and spec sheets.xlsx

Inventory we already Have: |  |  |  |  | Inventory to Purchase:
Name: | Ditributor: | Link: | Price: | Tutorial: | Item: | Description: | Cost: | Quantity: | Vendor: | Justification: | Link: | Tutorial: | ALSO ON DIGIKEY
Rotary Breakout I2c |  |  |  |  | UNO OLED shield | 2.8" TFT Touch Shield for Arduino with Capacitive Touch | $44.00 | 1.00 | Adafruit | UI component necessary for 1st Demo (Hardware section). I2C protocol compliant. We are planning on creating an enclosure for each component and connecting it to the main panel with LCD display. | https://www.adafruit.com/product/1947 |  | https://www.digikey.com/en/products/detail/adafruit-industries-llc/1651/4990776
 |  |  |  |  | I2C Slider | Adafruit NeoSlider I2C QT Slide Potentiometer with 4 NeoPixels - STEMMA QT / Qwiic | $9.95 | 1.00 | Adafruit (5295) | UI component necessary for 1st Demo (Hardware section). I2C protocol compliant. We are planning on creating an enclosure for each component and connecting it to the main panel with LCD display. | https://www.adafruit.com/product/5295
 |  |  |  |  | I2C Joystick | SparkFun Qwiic Joystick | $11.50 | 1.00 | Sparkfun (com-15168) | UI component necessary for 1st Demo (Hardware section). I2C protocol compliant. We are planning on creating an enclosure for each component and connecting it to the main panel with LCD display. | https://www.sparkfun.com/products/15168
 |  |  |  |  | I2C Button Pad | SparkFun Qwiic Keypad - 12 Button | $11.50 | 1.00 | Sparkfun (com-15290) | UI component necessary for 1st Demo (Hardware section). I2C protocol compliant. We are planning on creating an enclosure for each component and connecting it to the main panel with LCD display. | https://www.sparkfun.com/products/15290
 |  |  |  |  | I2C Rotary Encoder | SparkFun Qwiic Twist - RGB Rotary Encoder Breakout | $24.95 | 1.00 | Sparkfun (dev-15083) | UI component necessary for 1st Demo (Hardware section). I2C protocol compliant. We are planning on creating an enclosure for each component and connecting it to the main panel with LCD display. | https://www.sparkfun.com/products/15083
