ProtoControl/ProtoControl/38_ProtoControl_SD_Fall2023/Design Documents/Product Requirements_DemoAndTest Plan_Proj38_Protocontrol_Fall2023.xlsx

Sheet: Project Information
Project Title | Protocontrol
Team Members | Abisha Fenn | * Team Leader
 | Nida Kosedagi
 | Parker Sexton
 | Will Wood
 | Kelly Mae Allen*
Sponsor | Parker Sexton
Mentor | N/A
Project Background | Developing a user interface is often the most tedious and time consuming part of the prototypeing process. With Protocontrol, that time could go from months to days with the easy to use, plug and play design of Protocontrol. The end user will be able to drag and drop their desired design onto a virtual display and easily create menus to streamline the user interface design process all without having to write a single line of code.
The goal of this project is to streamline user interface design. To achieve this goal the final system as a whole shall fulfill the requirements in tab ""
Notes:
Requirements shall use the word “shall”, shall be NUMBERED, and shall include only one reqt per number. Every requirement shall have a unique ID/number. See example below
Optional Requirements: Use the word “MAY” instead of “SHALL”

Sheet: Product Requirement Main plan
Keywords / Acronyms: |  |  |  |  |  | I: Inspection, A: Analysis, D: Demo, T: Testing
UI | User Interface
Panel | Custom PCB that hardware sits upon
Enclosure | 3D printed Enclosure
Controller | Arduino Microcontroller
The ones listed here are examples. Do not copy them as is. Fill this column with requirements for your project after you make a copy of this. Do not list duplicate requirements under multiple sections |  |  |  |  |  |  | Quantitative
Item # | Product Requirements and Test cases | I | A | D | T | Test Case and Method | Pass case scenario | Fail case scenario | Test Results | Comments
0 | User definition and assumptions about the user:
1.1 | User shall have basic understanding of electronic components |  |  |  | x | In our Beta Demo we will provide an ECE senior design team with Protocontrol and all associated documentation and collect feedback on the setup process (total time required, ease of use, previously unconsidered edge cases, intuitiveness). | Sample group can setup device as desired with minimal assistance in a reasonable amount of time (<10 hours) | Sample group is unable to integrate Protocontrol with their system (even with assistance) OR process takes over 10 hours.
1.2 | User shall have a device that requires a user interface, or at least a plan to build one |  |  |  |  | In the test detailed above, our sample group will be using one of the following MCUs (Arduino, R-PI, MSP430. ESP 32 feather) and have some variables in their system that can be controlled and/or displayed on Protocontrol.
1 | Product’s core requirements
2.1 | The device shall have I/O capabilities |  |  |  | x | Osiliscope used to verify Serial Communication
2.2 | The device shall have a companion software |  |  |  |  | User Trials
2.3 | The device shall have its own dedicated microcontroller | x |  |  |  | We are using the ESP 32
2 | General Operational Requirements and Features
A | User interaction/operation
A.1 | User interface design process shall be simple enough for our user base to understand easily |  |  |  | x | We will provide Protocontrol and all related documentaiton to an interested Senior Design team. We will note down the total time required for setup, level of assitance required, and overal compatibility.
A.2 | The device shall have options for the addition of modular components |  |  | X | X | In out Beta Demo we will demonstrate that components are effectively hot-swappable. When a peripheral is replaced, the website will prompt the user to update the parameters for the new peripheral and map it to the corresponding user-system variable. The whole process should take <=5 minutes.
A.3 | The moduar components shall include, but not limited to, a rotary encoder, buttons, and D-pad |  |  |  | X | We will first test components/their respective script in isolation on a separate Arduino and then on the ESP32/touchscreen system
B | Operating Environment
B.1 | Shall connect to a variety of example devices |  |  |  |  | Three example systems working
B.2 | Device shall be able to withstand mild drops and vibrations
B.3 | Device shall provide overcurrent protection for itself
B.4 | Device shall be able to withstand average levels of dust and humidity |  |  |  |  | Varety of user environment tests
C | System size/weight/look and feel features
C.1 | The device shall be no more than 5lbs |  |  |  | x | Integration: We will weigh the total system (electronics and enclosure together)
C.2 | The device shall have a hard enclosure that can withstand the heat generated by its components
C.3 | The device's modular components shall be easily connected and disconnected
3 | System/Device/Unit Constraint requirements
D | Compatibility or interfacing constraints
D.1 | Device shall be compatable with multiple digital I/O |  |  |  | x
E | Robustness Constraints
E.1 | Device shall pass a drop test (to be created) |  |  |  | x | Integration: We will drop Protocontrol from a height of 1.5 feet. We expect the side peripheral panels to snap off and bounce to the side. We expect the central peripheral panels to either be slightly displaced or stay within is bounds. Some abrasive damage to the enclosure is expected and allowed but cracks on the enclosure as well as damage to electronic components is not expected/desired.
E.2 | Device shall function properly at 25 degrees C at average humdity levels for this climate
F | Cost constraints
1.2 | The software cost shall be under $150 for duration of the development process independant of the prototyping budget
1.3 | The prototyping budget for the project shall be $500
G | Safety / Security Constraints
G.1 | The device shall have no unneccesary metal contacts on the outside of the device | x |  |  |  | Pre-Integration: There will be a finite/limited number of metal contacts on outside of the device
G.2 | The enclosure shall stay at a comfortable temperature to hold with bare hands | x |  |  |  | During integration of user systems with Protocontrol, we will note any abnormal spikes in temperature and note if the enclosure is allowing for ventilation or contributing to heat buildup.
G.3 | The enclosure shall have no sharp edges | x |  |  |  | Preintegration: The user will be able to hold Protocontrol and by inspection note that there are no sharp edges.
4 | Other needs (You can rename this section as needed)
H | Setup/Installation needs
H.1 | The system will not need any initial setup other than downloading auto generated code and plugging in. |  |  | X | X | Integration: We will run through the initialization process for two specific user systems and collect data on the extent of information the user is responsible for having as well as the total time for initialization. PreIntegration: Use Main panel of protocontrol to see if all the code that runs it can be broken up into modular section of code that are automatically generated. | The user system can be setup in <= 20 minutes (assuming that the user system is a known system that is independently functional) | The user systems requires > 20 minutes of setup time in order to connect to protocontrol
H.2 | The device shall be installable using no equipment
H.3 | Software once downloaded can be installed on any Windows OS.
I | Maintenance Needs
I.1 | The microcontroller shall run without crashing for 12 hours continuous use
I.2 | The power system shall be easily accessible for simple maintenance (I.e. replcing a capacitor or battery)
J | Supporting accessories
J.1 | Installation software
J.2 | Physical installation manual
J.3 | Modular components (see above)
K | Any extra features
 | Data logging feature

Sheet: Tech Demo
This is presented during your Preliminary design review in ECE 484. Create your tech demo plan in the following format base don the examples below. There are 2 examples. You need only one plan for your tech demo. |  |  | First Goal: Define ProtoControl V1
 |  | Responsible Team Member | Parts list for device function - pick a common design and run
Tech demo 1: breadboarded | One Breadboarded device will demonstrate an example of the build process, and will work to control a simple system |  | breadboard parts together and get a system working
1.1 | Device will have a screen that displays a read value
1.2 | Device will take an input that can be seen on screen
1.3 | Device will provide some semblence of a unique design with custom hardware
1.4 | Enclosure if possible
Tech Demo 2 | Enclosure prototype with two working applications | Responsible Team Member
1.1 | Same user interface panel with enclosure closer to final design
1.2 | Two panels working with different test systems
1.3 | The process to build both panels is well documented and simpler than before
Tech Demo 3 | Design User interface from drawings
1.1 | test a live demo of Image recognition of user interface components
2023-01-02 | website frontend

Sheet: Alpha Demo
 | This is presented during your Critical design review and Alpha demo in ECE 485 |  |  |  |  | I: Inspection, A: Analysis, D: Demo, T: Testing
 | Alpha Demo test plan | I | A | D | T | Test Case and Method | Test Results | Notes
 |  |  |  |  |  | User Trials
1.1 | Sucessful Update from website |  |  |  |  | User is able to acess the website and intuitivly understand how to use it
1.2 | Connects to IOT Device |  |  |  |  | Connection and acnowlagment is made
1.2 | Sends update to IOT in correct format |  |  |  |  | layout profile is sucsessfully send across IOT
1.3
1.4
2 | Sucessful control of user device |  |  |  |  | Plug into example system
2.1 | Can send and receive data from user device over UART |  |  |  |  | User is able to connect up UART port without instructions
2.2 | Can correctly parse received data |  |  |  |  | Information is sent after being set up by user
2.3 | Can change variables with data received |  |  |  |  | display is changed
2.4
3 | Functional Prototyping PCB |  |  |  |  | PCB works
3.1 | Power in and power out are as expected |  |  |  | x | Power pins are used to test with a multimeter/oscilloscope
3.2 | No solder bridges, components installed correctly |  |  |  | x | test edge cases and highest load voltage
3.3 | There is continuity across connected pins |  |  |  | x | multimeter testing (check continuity)
3.4 | SD card recognition |  |  |  | x | Upload data to the SD card and test it with the microcontroller
4 | Working I2C Peripherial Component
4.1 | Peripheral panels can communicate with main panel (touchscreen, pcb, esp32) of protocontrol |  |  | x | x | Input is recognized after being attached) 1) Demonstrate that the pcf8574 is recognized by scanning for its address (in the initialization function) and printing its address to the serial monitor 2) Demonstrate that the peripheral communicates with the main panel by displaying the value of Rotary Encoder on the touchscreen 3) Test that Peripheral devices provided stable data ( Use Arduino Uno, apart from main Protocontrol panel, to print data read from peripherals and confirm it is appropriately sensitive) 4) Demonstrate that the component can be removed from system and reattached with no loss of function (the same component without powering of the system)
4.2 | 1 Digital and 1 analog comonent function |  |  | x | x | Demonstrate that the Rotary Encoder modulates volume of the speaker that is in the user system and displays the volume on the touchscreen (D) Test that the Button pad (arrows) can be used to modulate the volume of the speaker that is in the user system and volume value is displayed the touchscreen (D) Since reconfiguring Protocontrol for multiple peripherals will take some time (at this phase of the project, the second demo will not be conducted live)
4.3 | Both ports function with analog and digital types of peripheral components | x |  | x |  | Demonstrate that a part can attach to either i2c port (swap the buttons from one set of i2c connectors to the other).
4.4 | User creates i2C component configuration on website |  |  | x |  | Demonstrate how the user configures layout (drag and drop icons) on website and enters peripheral parameters. To test that the correct code has been auto-generated we will demonstrate that the rotary encoder and keypad control the user system and update screen as expected.

Sheet: Beta Demo
 | This is presented during your Critical design review and Alpha demo in ECE 485 |  |  |  |  | I: Inspection, A: Analysis, D: Demo, T: Testing
 | Beta Demo plan (Integrated subsystem) | I | A | D | T | Test Case and Method | Test Results | Notes
 |  |  |  |  |  | User Trials round two
1.1 | Working website
1.2 | Can update Protocontrol repeatidly without error |  |  |  |  | Seamless communication | Working
1.2 | User can design a simple user interface without programming |  |  |  |  | No contact for start to finish setup with only instructions | Working
1.3 | live updates component position |  |  |  |  | under 30s update time
2 | Working prototype
2.1 | Connects to more than one I2C component at a time |  |  | X | X | Demonstrate that two hardware peripherals (rotary encoder and button pad) can connect to the system at the same time and control two different variables (speaker volume, light color) | Verified to connect to keypad and encoder
2.2 | displays user system information |  |  | x |  | Demonstrate that the speaker volume and current light color and displayed on Protocontrol's screen | Console works
2.3 | controls user system |  |  | x | x | Demonstrate that two hardware peripherals (rotary encoder and button pad) can connect to the system at the same time and control two different variables (speaker volume, light color) | Working to control RGB led, wheel speed, LED state, and many other components
2.4 | enclosure with ports | x |  |  |  | The system will have and enclosure and multiple i2c ports
2.5 | Hot Swapability |  |  |  |  | Demonstrate that when the user changes out a hardware component, a pop-up will appear on the website indicating that a new devices has been added. The user will enter the address of the new peripheral, what variable it controls, and any other salient parameter. | Tested on two different user systems
3 | PCB
3.1 | new PCB that includes all needed functonality: power port, UART |  |  | x | x | test barreljack with power supplies in the lab and Parker's laptop, UART port tested with 306 car | Yes | Test: components can be swapped out by going through the website and redesigning the layout to have a button pad instead of a rotary encoder (we will measure how long the whole process takes) (D,T)
3.2 | 2 layer only (no internal layers) | x |  |  |  | flood a part of the PCB with ground to avoid needing inner layers, test continuity and functioning with the screen | Yes
3.3 | adapt to a possibly new enclosure |  | x |  |  |  | Yes | discussion on a thinner enclosure is ongoing, PCB might be redesigned with the changes in mind
3.4 | Component PCB and more pull-up resistors to be added |  |  | x | x | test with the main board and I2C components, check continuity with a multimeter | Yes
3.5 | Switches added to the main board |  |  |  | x | test on the serial monitor (button pressed) | Yes
4 | Documentation
4.1 | Rough Draft of our User Manual (link) (https://docs.google.com/document/d/1kyVKtgaTI5ugEXL2CMWLoRHKPVhOs50bv1ftMQZnubg/edit) |  |  |  | x | We will provide a rough draft of our user manual to our next user demo. It will include the following topics: What protocontrol comes with, Accessing the Website, Setting up Arduino, Setup, From Website to Upload, What exactly is the string from the database/server, Sending Data, Receiving Data, UART Basics, I2C Basics, Common Issues | In Progress. Will be truly tested on Friday 4/5 when we do our User Trial with Team 33.
