ProtoControl/ProtoControl/38_ProtoControl_SD_Fall2023/Hardware Files/484_001_Grp38_Protocontrol_Request1.xlsx

Project ID / Purchasing account | 673877 | PI name | Jeremy Edmondson |  | Instructions
PI Phone Number |  | PI email | jedmond2@ncsu.edu
Submitted to purchasing on: | 2023-09-23 | Purchasing order #: | 001 |  | Make sure you copy this template as is to another google spreadhseet and edit it for your purchase list. Make sure you keep the nomenclature format of the sheet and update if for your purposes, E.g. 484_002_Grp3_TimeMachine_Request1
 |  |  |  |  | Grey cells are filled in by TAs and Instructors and the staff. Do not submit this unless these fields are populated by them. This is an example sheet so please delete the extra rows and vendor names if you are not using them.
Total: | $65.35 | Business Justification to be submitted in the purchaisng form: | Parts request for ECE484 group 38 Protocontrol for prototype build in Troxler lab.
 |  |  |  |  | Green cells can be filled by students if there is extra comment about the order. Look at examples. Delete the example rows and keep only the items and vendors you are ordering from. Everything in italics is an example and should be deleted or replaced by your vendors, links, numbers, etc.
 |  | Design justification: | STEMMA slider: This slider is equipped with I2C communication ports, and comes with software support and libraries to easily integrate on Arduino. Rotary Encoder: This rotary encoder is not unique, however it is the raw part ready to be soldered to a board. We already have the board that enables i2c communication on this form factor, linked here https://www.adafruit.com/product/4991 UNO OLED capacitive shield: This part is key to our ProtoPad design. It slots directly on top of any Arduino Uno, with no soldering, and works as a touchscreen allowing our custom digital inputs to be displayed anywhere. Lab replacements offered were either not a touchscreen and far too small, or designed for a rasbery pi (lacking the Uno shield capacity) as well as being resistive touch and not I2C. GPIO expander: This is the part that allows us to use simple digital input devices and convert it to I2c. It is not that we are running out of pins, rather that we want to maintain a standard of communcatuon when interfacing with input devices, to allow the ports to all be equivalent. |  | Set the sharing permission to "Anyone at NCSU with the link can edit."
 |  |  |  |  | Remember to rename the sheet name on the bottom (the "YYYY-MM-DD" thing). Just add more sheets whenever you send a new order, and send us the new link.
Estimated Shipping
Vendor | Adafruit |  | Total
Estimated Shipping | $4.80 | $0.00 | $4.80
Group Name | ProtoControl | Primary Contact Name |  | Nida Kosedagi
Group Number | 38 | Primary Contact Email |  | nkoseda@ncsu.edu
 |  | Primary Contact Phone # |  | 9193081610
Adafruit |  |  | Should ship all as one package |  |  |  |  | Tracking link (if any) will show up in this grey cell
Part |  |  | Quantity | Manufacturer Part Number | Vendor Part Number | Price (for 1) | Total | Link to the specific item to be purchased
STEMMA Slider |  |  | 1 |  | 5295 | $9.95 | $9.95 | https://www.adafruit.com/product/5295
Rotary Encoder |  |  | 1 |  | 377 | $4.50 | $4.50 | https://www.adafruit.com/product/377
UNO OLED shield: 2.8" TFT Touch Shield for Arduino with Capacitive Touch |  |  | 1 |  | 1947 | $44.95 | $44.95 | https://www.adafruit.com/product/1947
Adafruit MCP23017 I2C GPIO Expander Breakout - STEMMA QT / Qwiic |  |  | 1 |  | 5346 | $5.95 | $5.95 | https://www.adafruit.com/product/5346
