ProtoControl/ProtoControl/38_ProtoControl_SD_Fall2023/Hardware Files/484_001_Grp38_Protocontrol_Request2.xlsx

Project ID / Purchasing account | 673877 | PI name | Jeremy Edmondson |  | Instructions
PI Phone Number |  | PI email | jedmond2@ncsu.edu
Submitted to purchasing on: | 2023-10-27 | Purchasing order #: | 002 |  | Make sure you copy this template as is to another google spreadhseet and edit it for your purchase list. Make sure you keep the nomenclature format of the sheet and update if for your purposes, E.g. 484_002_Grp3_TimeMachine_Request1
 |  |  |  |  | Grey cells are filled in by TAs and Instructors and the staff. Do not submit this unless these fields are populated by them. This is an example sheet so please delete the extra rows and vendor names if you are not using them.
Total: | $63.55 | Business Justification to be submitted in the purchaisng form: | Parts request for ECE484 group 38 Protocontrol for prototype build in Troxler lab.
 |  |  |  |  | Green cells can be filled by students if there is extra comment about the order. Look at examples. Delete the example rows and keep only the items and vendors you are ordering from. Everything in italics is an example and should be deleted or replaced by your vendors, links, numbers, etc.
 |  | Design justification: | The first two chips are to prototype the IC circuit for the components. the microcontroller m0 is a more powerful chip we want to switch to to move away from arduino. the gpio expander board is to build up more component prototypes, and the capacitive touchscreen has a different form factor and we want two to be able to build up two prototypes at a time. |  | Set the sharing permission to "Anyone at NCSU with the link can edit."
 |  |  |  |  | Remember to rename the sheet name on the bottom (the "YYYY-MM-DD" thing). Just add more sheets whenever you send a new order, and send us the new link.
Estimated Shipping
Vendor | Digikey
Vendor |  |  | Total
Estimated Shipping |  | $6.99 | $6.99
Group Name | ProtoControl | Primary Contact Name |  | Nida Kosedagi
Group Number | 38 | Primary Contact Email |  | nkoseda@ncsu.edu
 |  | Primary Contact Phone # |  | 9193081610
Digikey |  |  | Should ship all as one package |  |  |  |  | Tracking link (if any) will show up in this grey cell
Part |  |  | Quantity | Manufacturer Part Number | Vendor Part Number | Price (for 1) | Total | Link to the specific item to be purchased
TI GPIO expander |  |  | 3 | PCF8574N | 296-13109-5-ND | $2.57 | $7.71 | https://www.digikey.com/en/products/detail/texas-instruments/PCF8574N/484957
Microchip GPIO expander - ADC |  |  | 3 | MCP3427-E/UN | MCP3427-E/UN-ND | $3.68 | $11.04 | https://www.digikey.com/en/products/detail/microchip-technology/MCP3427-E-UN/2179259
GPIO expander adafruit |  |  | 3 | 5545 | 1528-5545-ND | $4.95 | $14.85 | https://www.digikey.com/en/products/detail/adafruit-industries-llc/5545/21283815
capacitive touchscreen |  |  | 1 | 2774 | 1528-2848-ND | $29.95 | $29.95 | https://www.digikey.com/en/products/detail/adafruit-industries-llc/2090/9919535
