ProtoControl/ProtoControl/38_ProtoControl_SD_Fall2023/Hardware Files/485_001_Grp38_Protocontrol_Request3.xlsx

Project ID / Purchasing account | 673877 | PI name | Jeremy Edmondson |  | Instructions
PI Phone Number |  | PI email | jedmond2@ncsu.edu
Submitted to purchasing on: | 2024-02-15 | Purchasing order #: | 003 |  | Make sure you copy this template as is to another google spreadhseet and edit it for your purchase list. Make sure you keep the nomenclature format of the sheet and update if for your purposes, E.g. 484_002_Grp3_TimeMachine_Request1
 |  |  |  |  | Grey cells are filled in by TAs and Instructors and the staff. Do not submit this unless these fields are populated by them. This is an example sheet so please delete the extra rows and vendor names if you are not using them.
Total: | $81.59 | Business Justification to be submitted in the purchaisng form: | Parts request for ECE484 group 38 Protocontrol for prototype build in Troxler lab.
 |  |  |  |  | Green cells can be filled by students if there is extra comment about the order. Look at examples. Delete the example rows and keep only the items and vendors you are ordering from. Everything in italics is an example and should be deleted or replaced by your vendors, links, numbers, etc.
 |  | Design justification: | the parts for a second prototype are to allow us to run user trials for alpha demo while continuing development on the device. The pogo pins are for our i2c port connectors to attach with magnets. |  | Set the sharing permission to "Anyone at NCSU with the link can edit."
 |  |  |  |  | Remember to rename the sheet name on the bottom (the "YYYY-MM-DD" thing). Just add more sheets whenever you send a new order, and send us the new link.
Estimated Shipping
Vendor | Digikey
Vendor |  |  | Total
Estimated Shipping |  | $6.99 | $6.99
Group Name | ProtoControl | Primary Contact Name |  | Nida Kosedagi
Group Number | 38 | Primary Contact Email |  | nkoseda@ncsu.edu
 |  | Primary Contact Phone # |  | 9193081610
Digikey |  |  | Should ship all as one package |  |  |  |  | Tracking link (if any) will show up in this grey cell
Part |  |  | Quantity | Manufacturer Part Number | Vendor Part Number | Price (for 1) | Total | Link to the specific item to be purchased
Pogo pins |  |  | 30 | 0906-0-15-20-76-14-11-0 | ED8180-ND | $0.56 | $16.80 | https://www.digikey.com/en/products/detail/mill-max-manufacturing-corp/0906-0-15-20-76-14-11-0/1147048
Screen |  |  | 1 | 2090 | 1528-2848-ND | $29.95 | $29.95 | https://www.digikey.com/en/products/detail/adafruit-industries-llc/2090/9919535
ESP32 Adafruit Microcontroller |  |  | 1 | 5400 | 1528-5400-ND | $19.95 | $19.95 | https://www.digikey.com/en/products/detail/adafruit-industries-llc/5400/16129667
Pogo Pin reciver |  |  | 30 | 1945-0-00-15-00-00-03-0 | ED1359-ND | $0.27 | $8.10 | https://www.digikey.com/en/products/detail/mill-max-manufacturing-corp/1945-0-00-15-00-00-03-0/5176095
Analog Slider |  |  | 2.00 | PTA4553-2010CIB103 | PTA4553-2010CIB103-ND | $1.98 | $3.96 | https://www.digikey.com/en/products/detail/bourns-inc./PTA4553-2010CIB103/3781211?gad_source=1
Surface mount gpio expanders |  |  | 5 | PCF8574ADWR | 296-13105-2-ND | $0.57 | $2.83 | https://www.digikey.com/en/products/detail/texas-instruments/PCF8574ADWR/484754
