ProtoControl/ProtoControl/38_ProtoControl_SD_Fall2023/Team Charter_Project Plan_38_Protocontrol_Fall_2023.xlsx

Sheet: Team agreement
Hello from notion
Ctreate a team google folder withe the name in the format <ProjectNumber_briefProjectTitle_SD_SemYear>. E.g. 02_IsolatedUSB_SD_Sp20. All team members, instructors, TAs and sponsors should have edit access. Create a copy of this sheet and put it in your project google folder as per the folder structure. Delete the notes and examples once you have filled it up. (https://docs.google.com/spreadsheets/d/1Qa_bUPsaPQKfxytWRHucTSk1W40RCmGsM3vghvE6P3M/edit)
Team Norms |  |  | Notes | Examples
Project Name: Protocontrol
Team project google folder link (https://drive.google.com/drive/folders/17YSy7kBSbAPFbn4YhTiKsoh3plEE-NCC)
Mode of regular team meetings |  |  | If you have members who will join virtually,create a group meeting link and put it here. | In person on campus, library meeting rooms, EB2
Mode for urgent communications |  |  | All team members should reachable in this mode within reasonable time | Text, Discord
Project management rules |  |  |  | Complete 24 hours ahead time for review.. Complete before sponsor meeting to get feedback | Discuss action items and agenda items before sponsor meetings
Meeting scheduling- How to resolve everybodies schedule conflicts |  |  |  | Discord channel with team members weekly schedule
How much notice should be given if a team member cannot attend a team meeting? |  |  |  | As soon as you find out you cannot make it, but not less than 24 hours
When is a team member late to a team meeting and what are the consequences? |  |  | Cone of shame | One minute after designated time is late unless previously noted
What to do when action items are not compete when agreed? |  |  | Lose a Star | Item is reassigned to another person and maked against previous person as incomplete. A score of ontime action items will be kept.
How long before assignments are due will the work be divided among team members? |  |  |  | One week before assignment is due the team will meet and divide up.
How long before the assignment is due will the draft be ready for team review? |  |  |  | 48 hours before sumbission/presentation
Project Management Roles |  |  |  | Technical roles
 | Team Leader |  | Kelly Mae Allen | Enclosure Modeling and Power System Design | Embedded software integration and design
 | 1. Meeting minutes taker and Agenda manager |  | Abisha Fenn | Serial Communication IC and physical connection | Enclosure Modeling and Power System Design
 | 2. Sponsor Contact and Meeting Scheduler |  | Parker | Embedded software integration and design | Software and website to design digital UI
 | 3. Purchasing contact |  | Nida | Custom PCB design | Serial Communication IC and physical connection
 | 4. Website and Google folder Manager |  | Will Wood | Software and website to design digital UI
Ideas and activities for getting to know each other
 | 1 | Happy Hour
 | 2 | A nice game of go fish
 | 3 | Poker Night
 | 4 | Potluck
 | 5 | Karaoke Bar

Sheet: Project abstract
Protocontrol is a plug and play panel with a start-to-finish user interface development experience. Protocontrol consists of a touchscreen display along with slots to attach hardware peripherals. Users customize the layout of the touchscreen and select their preferred peripherals via a website. Our user interface panel is compatible with commonly used microcontrollers such as Arduino and Raspberry Pi. This device is ideal for engineers who need to quickly develop a user interface to test their product and for hobbyists who need a system that is easy to use and can help manage complexity. Both the touch screen and hardware peripherals can be used as controllers for the user system and the touchcreen can also be used to display values from the user system.
Protocontrol is a plug and play panel with a start-to-finish user interface development experience. Protocontrol consists of a touchscreen display, four I2C ports for hardware peripherals, and a UART channel to communicate with the User's device. Customizing the touchscreen's layout is as simple as using the website to drag and drop icons onto a grid that maps to the touchscreen. Both the touch screen and hardware peripherals can be used as controllers for the user system and the touchcreen can also be used to display values from the user system. Protocontrol is compatible with commonly used microcontrollers such as Arduino. This device is ideal for engineers who need to quickly develop a user interface to test their product and for hobbyists who need a system that is easy to use and can help manage complexity.

Sheet: Task List
Project Name: | Protocontrol
Team Members: Parker, Abisha, NIda, Will, Kelly Mae
Subsystem | Task # | Task | Owner(s) | Date Due | Dependencies
Embedded software integration and design (lead - Parker, Support - Kelly Mae)
 | A-1 | PDR slides | Parker | 2023-10-03
 | A-2 | An instatnce | Parker | 2023-10-03
 | A-3 | Clases for digital components | Parker | 2023-11-20
 | A-4 | SD card reading and drawing | Parker
 | A-5 | code for i2c components | Parker | 11.25
 | A-6 | Serial communication protocal implementation | Parker
Software and website to design digital UI (lead - Will, Support - Parker)
 | B-1 | PDR Slides | Will | 2023-10-03
Serial Communication IC and physical connection (lead - Abisha, Support - Nida)
 | C-1 | PDR Slides | Abisha | 2023-10-03
 | C-2 | Design Component PCB | Abisha, Nida | 2024-02-21
 | C-3 | Figure out Robust way to connect components | Abisha | --
 | C-4 | Test Component PCB | Abisha, Nida | 2024-03-06 | C-2
 | C-5 | Keypad | Abisha | 2024-02-28
 | C-6 | Rotary Encoder | Abisha | 2024-02-28
 | C-7 | Slider | Nida
 | C-8 | Integrate code with Protocontrol | Abisha, Parker | 2024-03-07 | C-5, C-6, C-7
 | C-9 | Create user manual | Abisha | 2024-03-22
Custom PCB design (lead - Nida, Support - Parker)
 | D-1 | Choose PCB Design software | Nida |  | None
 | D-2 | PDR slides | Nida | 2023-10-03
Enclosure Modeling and Power System Design (lead - Kelly Mae, Support - Abisha)
 | E-1 | PDR Slides | Kelly Mae | 2023-10-03
 | E-2 | Develop power system block diagram | Kelly Mae | 2023-10-03 | none
 | E-3 | Design Enclosure for Peripheral Components | Kelly Mae | 2023-10-03 | none
 | E-4 | Design Enclosure for Arduino Sample System | Kelly Mae | 2024-01-08
 | E-5 | Measure Power Requirements of Full integrated system |  | 2024-02-29
Team Activities and/or Non-Subsystem Related Activities
 | T-1 | Develop Sample User System on Arduino | Kelly Mae, Abisha | 2023-11-28
 | T-2 | Develop Sample User System on Raspberry Pi | Kelly Mae, Abisha | 2024-01-08
 | T-3 | Develop Sample User System on MSP430 | Nida | 2024-01-08
 | T-4 | Develop Standard for User System to Communicate with Protocontrol and Vice Versa | Kelly Mae | 2023-11-28
 | T-5 | Document Custom Communication Commands for Arduino, Raspberry Pi, and MSP430 Systems |  | 2024-04-03
Key Milestones
 | M-1 | Preliminary Design Review | all | 2023-10-03
 | M-2 | Hall of Fame | all | 2023-10-13
 | M-3 | Hello World Demo | all | 2023-10-24
 | M-4 | Tech Demo | all | 2023-11-28

Sheet: Project Timeline_F23
PROJECT STATUS
PROJECT TITLE: |  | Protocontrol |  |  |  |  |  | Project Number: |  |  |  | 38 |  |  |  |  |  |  |  |  |  |  |  |  |  |  |  |  | * Estimated dates
Team leader: |  | Kelly Mae Allen |  |  |  |  |  | Revision Date: |  |  |  | 2023-11-28
 | Subsystem Name |  | Task ID | Task detail |  | Owner | Task Dependency |  |  |  |  |  |  |  |  |  |  |  | Q2 |  |  |  |  |  |  |  |  |  |  |  |  | Q3 |  |  |  |  |  |  |  |  |  |  |  | Q4
 |  |  |  |  | Month --> |  |  | AUG |  | SEPT |  |  |  | OCT |  |  |  |  | NOV |  |  |  | DEC |  |  |  | JAN |  |  |  |  | FEB |  |  |  | MAR |  |  |  | APR |  |  |  | MAY |  |  |  |  | JUN |  |  |  | JUL
 |  |  |  | PROJECT WEEK --> |  |  |  | 22 | 29 | 5 | 12 | 19 | 26 | 3 | 10 | 17 | 24 | 31 | 7 | 14 | 21 | 28 | 5 | 12 | 19 | 26 | 2 | 9 | 16 | 23 | 30 | 6 | 13 | 20 | 27 | 6 | 13 | 20 | 27 | 3 | 10 | 17 | 24 | 1 | 8 | 15 | 22 | 29 | 5 | 12 | 19 | 26 | 3 | 10 | 17 | 24 | 31
 |  |  |  | ECE Semester |  |  |  | FALL 2023 |  |  |  |  |  |  |  |  |  |  |  |  |  |  |  |  | WINTER Break |  |  | SPRING 2023 |  |  |  |  |  |  |  |  |  |  |  |  |  |  |  |  | SUMMER Break
1 | Class Milestones |  |  | Project agreement
 |  |  |  | Project Requirements Document & Market Slides
 |  |  |  | System Architecture Diagrams
 |  |  |  | Preliminary Design Review
 |  |  |  | Status review
 |  |  |  | Critical Review
 |  |  |  | CDR
 |  |  |  | Program Review 1
 |  |  |  | Program Review 2
 |  |  |  | Alpha Demo
 |  |  |  | Program Review 3
 |  |  |  | Beta Demo
 |  |  |  | Design Day
 |  |  |  | Final Docs and Return of Items
 |  |  | PS1 | Get Rotary Encoder working with GPIO pin expander breakout board |  | Abisha |  |  |  |  |  |  |  |  | 100%
2 | Peripheral Serial Communication (Abisha, Nida) |  | PS2 | Get Rotary Encoder Working with PCF8574N |  | Abisha |  |  |  |  |  |  |  |  |  |  |  |  |  |  | 40% |  |  |  |  |  |  |  |  |  |  |  |  |  |  | 100%
 |  |  | PS3 | Design Component PCB |  | Abisha, Nida |  |  |  |  |  |  |  |  |  |  |  |  |  | 15% |  |  |  |  |  |  |  |  |  |  |  | 67% | 100%
 |  |  | PS4 | Test Component PCB |  | Abisha, Nida |  |  |  |  |  |  |  |  |  |  |  |  |  |  |  |  |  |  |  |  |  |  |  |  |  |  |  |  |  |  |  |  | 100%
 |  |  | PS5 | Key Pad |  | Abisha |  |  |  |  |  |  |  |  |  |  |  |  |  |  |  |  |  |  |  |  |  |  |  |  |  | 50% | 100%
 |  |  | PS6 | Slider |  | Nida, Abisha |  |  |  |  |  |  |  |  |  |  |  |  |  |  |  |  |  |  |  |  |  |  |  |  |  |  |  |  |  |  |  |  | 50% |  | 100%
 |  |  | PS7 | User System 1 (Alpha Demo) |  | Abisha, |  |  |  |  |  |  |  |  |  |  |  |  |  |  |  |  |  |  |  |  |  |  |  |  |  | 30% | 70% | 100%
 |  |  | PS8 | Button Pad |  | Abisha, Will |  |  |  |  |  |  |  |  |  |  |  |  |  |  |  |  |  |  |  |  |  |  |  |  |  |  |  |  |  | 100
 |  |  | PS9 | Integrate Protcontrol with ADC chip (ADS1115 breakout board) |  | Abisha |  |  |  |  |  |  |  |  |  |  |  |  |  |  |  |  |  |  |  |  |  |  |  |  |  |  |  |  |  |  |  |  |  | 50% | 100%
3 | Embedded System Design |  | SC1 | Generate proof of concept |  | Parker |  |  | 100%
 |  |  | SC2 | Write arbitrary classes for digital components |  | Parker |  |  |  |  |  |  |  |  | 60% |  |  |  |  |  | 100%
 |  |  | SC3 | Create code to interface with all i2c physical components |  | Parker |  |  |  |  |  |  |  |  |  | 80% |  |  |  |  |  |  |  |  |  |  |  |  |  |  |  | 100%
 |  |  | SC4 | ~~Create software to read from SD card and generate UI arbitrarily~~ |  | Parker |  |  |  |  |  |  |  |  |  |  |  |  |  | 100%
 |  |  | SC5 | Connect IOT to wifi and integrate code |  |  |  |  |  |  |  |  |  |  |  |  |  |  |  | 50% |  |  | 100%
 |  |  | SC6 | Create code to implement serial communication protocal |  | Parker |  |  |  |  |  |  |  |  |  |  |  |  | 30% |  |  |  |  |  |  |  |  |  |  |  |  |  |  |  | 100%
 |  |  | SC7 | User System 1 (Alpha Demo) |  | Parker |  |  |  |  |  |  |  |  |  |  |  |  |  |  |  |  |  |  |  |  |  |  |  |  |  |  |  |  |  | 100%
 |  |  | SC8 | User System 2 (Beta Demo) |  | Parker |  |  |  |  |  |  |  |  |  |  |  |  |  |  |  |  |  |  |  |  |  |  |  |  |  |  |  |  |  |  |  |  |  | 100%
 |  |  | SC9 | Flag System to Initialize I2C Components |  | Parker, Abisha |  |  |  |  |  |  |  |  |  |  |  |  |  |  |  |  |  |  |  |  |  |  |  |  |  |  |  |  |  |  |  |  |  | 100%
4 | Integration related tasks |  | I1 | Develop Sample User System on Arduino (Servo V. 1) |  | Kelly Mae |  |  |  |  |  |  |  |  |  |  |  |  | 100%
 |  |  | I2 | ~~Develop Sample User System on Raspberry Pi~~ |  | Kelly Mae |  |  |  |  |  |  |  |  |  |  |  |  |  | 40%
 |  |  | I3 | Develop Sample User System on MSP430 |  | Parker |  |  |  |  |  |  |  |  |  |  |  |  |  |  |  |  |  |  |  |  |  |  |  |  |  |  |  |  |  |  |  |  |  | 100%
 |  |  | I4 | Develop Standard to Send Component State to User Device |  | Kelly Mae |  |  |  |  |  |  |  |  |  |  |  |  |  |  | 50% |  |  |  |  |  |  |  |  |  |  |  |  |  | 100%
 |  |  | I5 | Develop Standard to Send User Data to Protocontrol |  | Kelly Mae |  |  |  |  |  |  |  |  |  |  |  |  |  |  | 50% |  |  |  |  |  |  |  |  |  |  |  |  |  | 100%
 |  |  | I6 | Document Standard Commands for Arduino, Raspberry Pi, and MSP430 |  | Kelly Mae, Abisha |  |  |  |  |  |  |  |  |  |  |  |  |  |  |  |  |  |  |  |  |  |  |  |  |  |  |  |  |  |  |  |  |  | 50% | 100%
 |  |  | I7 | Develop Arduino Library for Protocontrol |  | Kelly Mae, Abisha |  |  |  |  |  |  |  |  |  |  |  |  |  |  |  |  |  |  |  |  |  |  |  |  |  |  |  |  | 5% |  |  |  | 30% |  | 100%
5 | Power System and Enclosure (Kelly Mae) |  | PE1 | Find and document power requirements for system |  | Kelly Mae |  |  |  |  |  |  |  |  |  |  |  |  |  |  |  |  |  |  |  |  |  |  |  |  | 10%
 |  |  | PE2 | Design Enclosure for Peripheral Components |  | Parker, Kelly Mae |  |  |  |  |  |  |  |  |  |  |  |  |  |  |  |  |  |  |  |  |  |  |  |  |  |  |  |  |  |  |  |  |  | 80%
 |  |  | PE3 | Design Final Enclosure |  | Parker, Kelly Mae |  |  |  |  |  |  |  |  |  |  |  |  |  |  |  | 25% |  |  |  |  |  |  |  |  |  |  |  |  |  | 40% |  |  |  | 80%
 |  |  | PE4 | ~~Desgin Power System~~ |  | Kelly Mae |  |  |  |  |  |  |  |  |  |  |  |  |  |  |  |  |  |  |  |  |  |  |  |  |  |  |  |  |  | 15%
 |  |  | PE5 | Design Enclosure for Pogo Pins and Magnetic Connector |  | Kelly Mae, Parker, Will |  |  |  |  |  |  |  |  |  |  |  |  |  |  |  |  |  |  |  |  |  |  |  |  |  |  |  |  |  |  |  |  |  | 90%
6 | PCB Design (Nida) |  | PD1 | Design PCB for capacitive touchscreen and arduino uno |  | Nida |  |  |  |  |  |  |  |  |  | 100%
 |  |  | PD2 | Design PCB for capacitive touchscreen and feather m0 |  | Nida |  |  |  |  |  |  |  |  |  |  |  | 100%
 |  |  | PD3 | Design component PCBs |  | Nida |  |  |  |  |  |  |  |  |  |  |  |  |  |  | 100% |  |  |  |  |  |  | 100%
 |  |  | PD4 | Add USB port |  | Nida |  |  |  |  |  |  |  |  |  |  |  |  |  |  |  |  |  |  |  |  |  |  |  |  |  |  |  |  | 100%
 |  |  | ~~PD5~~ | ~~Add port for SD card~~ |  | ~~Nida~~
 |  |  | PD6 | Redesign the main board |  | Nida |  |  |  |  |  |  |  |  |  |  |  |  |  |  |  |  |  |  |  |  |  |  |  |  |  |  |  |  |  |  |  | 100%
 |  |  | PD7 | Redesign the component PCB |  | Nida |  |  |  |  |  |  |  |  |  |  |  |  |  |  |  |  |  |  |  |  |  |  |  |  |  |  |  |  |  |  |  | 100%
 |  |  | PD8 | Test the component PCB with new main board |  | Nida |  |  |  |  |  |  |  |  |  |  |  |  |  |  |  |  |  |  |  |  |  |  |  |  |  |  |  |  |  |  |  |  |  | 100%
6 | Software (William Wood) |  | SW1 | Decide on communication protocol with feather board |  | William Wood |  |  |  |  |  |  |  |  |  |  |  |  | 100%
 |  |  | SW2 | Redesign website architecture |  | William Wood |  |  |  |  |  |  |  |  |  |  |  |  |  |  | 75%
 |  |  | SW3 | Research data persistance option |  | William Wood |  |  |  |  |  |  |  |  |  |  |  |  |  |  |  |  | 30%
 |  |  | SW4 | Update website with ID's |  | William Wood |  |  |  |  |  |  |  |  |  |  |  |  |  |  |  |  |  |  |  |  |  |  |  |  |  |  |  |  |  |  |  | 100%
 |  |  | SW5 | Added all digital components to website |  | William Wood |  |  |  |  |  |  |  |  |  |  |  |  |  |  |  |  |  |  |  |  |  |  |  |  | 100%
 |  |  | SW6 | Create Python Anywhere Database |  | William Wood |  |  |  |  |  |  |  |  |  |  |  |  |  |  |  |  |  |  |  |  |  |  |  |  |  |  |  |  |  |  |  | 100%
 |  |  | SW7 | Create Endpoints for system managment |  | William Wood |  |  |  |  |  |  |  |  |  |  |  |  |  |  |  |  |  |  |  |  |  |  |  |  |  |  |  |  |  |  |  |  |  | 50% | 100%
 |  |  | SW8 | Final Touchups |  | William Wood |  |  |  |  |  |  |  |  |  |  |  |  |  |  |  |  |  |  |  |  |  |  |  |  |  |  |  |  |  |  |  |  |  |  | 100%

Sheet: Accomplishments
Presented as part of Status review (ECE 484) and Program review (ECE 485)
Summarize any MAJOR accomplishments in the last 2 weeks - Successful functioning, Breakthroughs, Important Checkpoints completed, “Firsts”, Events affecting sponsors\mentors\external parties. List accomplishments and the responsible members for it. Include clear description of various accomplishments. Open a pictures or brief videos if relevant to better explain the accomplishment. Do not include too many technical details. Include funcitonal details.
Subsystem | Brief Accomplishment description | Date of accomplishment | Link to the video or picture describing | Next targetted accomplishment | Notes
Software and website to design digital UI (lead - Will, Support - Parker)
Software | Began OOP refactoring of web interface | 2023-11-15 |  | Redesign website to be more cohesive |  | 0
Software | Early data sync and data persistance testing on web app | 2023-11-20 |  | Nail down final plan for data management
Software | Automate build and deployments of website via github actions |  |  | Configure custom domain to host website
Software | Host database and build interface with flask |  |  | Clean up endpoints and add functionality
Software | Website is labeled with the component ID | 2024-04-03
Hardware Peripherals and I2C Communication (lead - Abisha, Support - Nida)
Hardware | Successful integration with PCF8574N | 2023-11-26 | Video in CDR Slide Deck | Integrate Other Components with the same IC | Digikey Order Fullfillment led to a setback
Hardware/Embedded | Incorporated I2C Scanner into the larger Embedded Code | 2024-01-31 |  | Figure out why we detect two addresses (theory: there are two sets of inputs that are I2C compatible on both Mircocontrollers)
Hardware/Embedded | Made a file that combines the pcf8574 library with the keypad library | 2024-02-18
Hardware/Embedded | The above file with a few modifications compiles with the larger Embedded Code | 2024-02-20 |  | Figure out Why the output of digitalRead for the pcf8574 is always 0.
Hardware/Embedded | Fully integrated with two hardware components (keypad and rotary encoder) | 2024-03-07 |  | Integrate the slider next
Hardware/Embedded | Slider works with ADS1115 breakout board | 2024-04-06 |  | Make Enclosure + Integrate with main protocontrol
Hardware/Embedded | Joystick works with ADS1115 breakout board | 2024-04-06 |  | Make Enclosure + Integrate with Main Protocontrol + Integrate with 3D Printer
Custom PCB design (lead - Nida, Support - Parker)
PCB | Designed and fabricated first PCB | 2023-11-24 | Picture in my slide | Test PCB and make any necessary changes
PCB | Demonstrate PCB in live demo | 2023-11-28
PCB | Designed the component PCB | 2024-02-07
PCB | Reviewed the component PCB with project mentor | 2024-02-13
PCB | Fixes/additions to the component PCB | 2024-02-21
PCB | Component PCB completed and ordered | 2024-03-19 | Picture in program review 3 slide | Test PCB and make any necessary changes
PCB | Changed UART to be UART + Power, Moved Barrel Jack, Connected two of the I2C ports to VCC, added 3 traces for the touchscreen | 2024-04-07 |  | Assemble Protocontrol with the New PCBs
Enclosure Modeling and Power System Design (lead - Kelly Mae, Support - Abisha)
enslosure | Figured out how to use Fusion 360 and printed first enclosure :) | 2023-10-25 | https://drive.google.com/file/d/1wK1TehvIK9QWXR-93yH2CzFdqIYvWsJL/view?usp=drive_link | continue to develop model
enslosure | Discovered pogo pin connectors exist and will work with our system | 2023-10-15 |  | design circuit to utilze pins
enclosure | Modeled new enclosure design from a sketch | 2024-02-12 |  | Model enclosure from imported PCB
enclosure | Modeled new enclosure design including pogo pins | 2024-03-19 |  | Test this design and make sure the holes are actually large enough
Power | Ran power analysis to collect data on Power consumption over time | 2024-04-03
enclosure | modeled new enclosure for joystick | 2024-04-02 |  | Use this style for other peripherals
enclosure | Finalized the main panel enclosure | 2024-04-05
Embedded software integration and design (lead - Parker, Support - Kelly Mae)
Embedded | Got screen working with Feather | 2023-11-20 |  | get components working
Embedded | Got communication with UART channels | 2023-11-26 |  | communicate with multiple components
Embedded | Got Classes fro digital components | 2023-10-10
Embedded | Got SD card drawing componends and live updating | 2024-02-06
Embedded | ESP 32 working with test flask server | 2024-01-30
Embedded | MicroController integration completed | 2024-01-12
Embedded | Wifi server and get request defined | 2024-02-06
Embedded | Got i2c components working on embedded system
Embedded | Fully integrated with two hardware components (keypad and rotary encoder) as well as user system (neopixel and servo) | 2024-03-07
Embedded | Touchscreen refreshes at the press of a button | 2024-04-08
Team accomplishments
 |  |  |  | Connect the PCB to the cloud system and send dat asuccessfully.
Integration | Successuful integration between Ardunino Sample User System | 2023-11-27 |  | Integration with Website | We were able to send data to and recieve data from the Arduino system. We displayed data from the Arduino system and controled the system with Protocontrol
Integration | Demo 1 (Arduino) | 2024-03-20
Integration | Demo 2 (306 Car) | 2024-04-03
Integration | Demo 3 (3D Printer with Raspberry Pi) | 2024-04-07

Sheet: Project Budget
Estimated Tech Demo cost
Part description | Qty | Unit Price | Total Price | Vendor | Link
STEMMA Slider | 1 | $9.95 | $9.95 | Adafruit | https://www.adafruit.com/product/5295
Rotary Encoder | 1 | $4.50 | $4.50 | Adafruit | https://www.adafruit.com/product/377
UNO OLED shield: 2.8" TFT Touch Shield for Arduino with Capacitive Touch | 1 | $44.95 | $44.95 | Adafruit | https://www.adafruit.com/product/1947
Adafruit MCP23017 I2C GPIO Expander Breakout - STEMMA QT / Qwiic | 1 | $5.95 | $5.95 | Adafruit | https://www.adafruit.com/product/5346
TI GPIO expander | 3 | $2.57 | $7.71 | Digikey | https://www.digikey.com/en/products/detail/texas-instruments/PCF8574N/484957
Microchip GPIO expander - ADC | 3 | $3.68 | $11.04 | Digikey | https://www.digikey.com/en/products/detail/microchip-technology/MCP3427-E-UN/2179259
GPIO expander adafruit | 3 | $4.95 | $14.85 | Digikey | https://www.digikey.com/en/products/detail/adafruit-industries-llc/5545/21283815
capacitive touchscreen | 1 | $29.95 | $29.95 | Digikey | https://www.digikey.com/en/products/detail/adafruit-industries-llc/2090/9919535
PCB |  |  | 3
Pogo Pins | 2 | $5.95 | $11.90 | Adafruit | https://www.adafruit.com/product/5360?gad_source=1
Feather Board | 1 | $11.95 | $11.95 | Adafruit | https://www.adafruit.com/product/4884?gad_source=1
TI GPIO expander | 3 | $2.57 | $7.71 | Digikey | https://www.digikey.com/en/products/detail/texas-instruments/PCF8574N/484957
 | 10
Estimated Final Protype cost
Part description | Qty | Unit Price | Total Price | Vendor | Link
Power components | 1 | 15 | 15
MCU | 1 | 30 | 30
GPS | 1 | 35 | 35
Display | 1 | 50 | 50
Enclosure | 1 | 5 | 5
DSP Chip | 1 | 10 | 10
PCB | 1 | 5 | 5
 |  |  | 150
Project expense so far
Order number | Link to purchasing sheet | Number of items | Cost
1 | https://docs.google.com/spreadsheets/d/1SQVx7yKf8Xss9ndAQgiuou-BZUZp4-EZRz05iheJmvI/edit | 4 | $70.15
2 | https://docs.google.com/spreadsheets/d/1DjrUUlJBctv7Y5ZM86rbUXgc5vGRXjOrX8itZ_7kZYM/edit | 10 | $70.54
3 | https://docs.google.com/spreadsheets/d/1iulGBPITr7QQ97KEDcgbRYHYbjjw5HnNFeRQSSY8wLE/edit | 5 | $128.66

Sheet: Issues and Help
An issue is an unexpected state or unsettled matter in the present. An issue is not a future concern (that is a risk). Could be technical or project management issue. Do affect project progress. Make sure you describe the issue well. If you do not know the solution then you can say that, there should be an action to find a solution or resolve. Add an extra slide if pictures/diagrams assist you in explaing complex issues.
Issue ID | Responsible person | Date of issue occurence | Issue Description | Potential Solution | Target Date | Help Required? (By Who) | Resolved?
1 | Parker Sexton | 1-/24/23 | Arduino reserts in loop in response to class taking another class as a field | remove class as input ans passed instence when needed |  | no | yes
2 | Parker Sexton/Will Wood | 2023-10-25 | Communication between software output and embedded input | USB uart, SD card, NFC chip, reupload |  | research | tentatively
3 | Abisha Fenn | 2023-10-20 | Rotary Encoder example from Arduino does not work with MCP23017 | Find a solution that configures MCP pins to be interrupt mode | 2023-10-21 | no | yes (see issue 4)
4 | Abisha Fenn | 2023-10-21 | RotaryEncoder Class file is not compatible with MCP23017 | Github Repository found to override this issue (link) (https://github.com/maxgerhardt/rotary-encoder-over-mcp23017/tree/master/lib/Rotary-master) | 2023-10-22 | teammates, potentially | yes (see issue 5
5 | Abisha Fenn | 2023-10-21 | Previous solution is not well documented and library will not upload to multiple computers | Find a script that does not use any additional libraries (preferrably without interrupts) | 2023-10-24 | teammates, potentially | yes (see issue 6)
6 | Abisha Fenn | 2023-10-24 | Solutions that work directly with the Arduino still do not work with the MCP23017 | Use PCF8574 instead | 2023-10-24 | Parker | yes (see lessons learned #2)
7 | Nida Kosedagi | 2023-10-25 | Close traces on the PCB | Autorouting | 2023-10-31 | Documentation, Dr. Nguyen, Instructors (during PCB review) | In progress
8 | Abisha Fenn | 2023-11-26 | Rotary Encoder Has Odd Behavior with PCF8574N | Compare to HelloWorld Code (see what gets read from ENCA and ENCB using the breakoutboard). Try PullUp Resistors? | 2023-12-05 | Looking for examples online | No
9 | Abisha Fenn | 2023-11-27 | How do we interface analog components? How does the specific analog rotary encoder we have work? | Look for solutions online, find an easy to use ADC | 2023-12-07 | Looking for examples online | No
10 | Abisha Fenn | 2023-11-28 | The Hello World Demo didn't work upon recreation | PCF8574N and Rotary Encoder must be connected to the same ground | 2023-11-28 | Nida had a stroke of genius | Yes
11 | Parker | 2023-11-25 | One of each component working | creating factory parent class to call touch function |  | wILL | NO
12 | Kelly Mae | 2023-11-26 | Need guidence on how to take power requirements and what to do with them | Talk to mentor, Google research | 2024-01-08 | Mentor or other wise person | Yes
13 | Abisha Fenn | 2024-01-31 | Why do we scan two addresses when only one pin expander is connected? | Check if it is detecting SDA/SCL as well as A4/A5 (Result, it is reading an extra bit that tells us r/w) | 2024-02-07 | teammates, potentially | Yes
14 | Kelly Mae | 2024-02-07 | Power test with and without wifi connection have the same current draw and cannot figure out why | Remove various aspects of program until a differnce is found (maybe?) | 2024-02-14 | teammates, mentor, classmates ect | No
15 | Abisha Fenn | 2024-02-18 | The pcf8574 is always reading 0 with regards to the keypad |  | 2024-02-23 | chatgpt | No
16 | William Wood | 2024-03-02 | Sending location character in string | tie character to a specific coordinate | 2024-03-10 | Internet | Yes
17 | Kelly Mae | 2024-03-06 | Integrating I2C hardware with user system | Give a specific location value to each component | 2024-03-20 | Abisha | Yes
18 | Nida Kosedagi | 2024-03-18 | Pins getting overloaded on PCB | Use a ground plane | 2024-03-25 | Carlson | Yes
19 | Parker | 2024-04-01 | Cannot switch profiles without resetting the board | use a button? | 2024-04-08 | Arduino Forums | Yes

Sheet: Project Risks
Color coding: Yellow: medium impact risk, orange: Medium to high, Red: High and Green: very low impact. Make sure you include correct risk response type: Accept, Transfer, Mitigate or something else. Have the newest and open risks on the top of the list.
Risk ID | Date identified | Description | Risk Category | Risk Response | GO/NO-GO Deadline | Status
~~1~~ |  | ~~3D printer in the makerspace might be too busy near the deadline~~ | ~~Resources~~ | ~~Mitigate: Try to finish the CAD earlier or sign up for a lot earlier~~ |  | ~~Open~~
~~2~~ |  | ~~Components needed for user system demonstration may take a long time to arrive. Delay from PCB manufacturers.~~ | ~~Supply chain~~ | ~~Accept: We will order parts and our PCBs as early as possible and then accomodate with parts available in the lab/our personal supply if we find we need something~~ |  | ~~Open~~
~~3~~ |  | ~~We may run out of memory on the SD card~~ | ~~Technical~~ | ~~Mitigate: Try to condense script when possible~~ |  | ~~Open~~
1 | 2024-03-20 | If protocontrol is difficult to understand/integrate users may feel as though it is not worth their time/may find it frustrating | Technical/presentation | Create a User Manual |  | Open
2 | 2024-02-19 | Overuse of the UART channel | Technical | Mitigate: Reduce message length |  | Open

Sheet: Action Items
Remember: Action items are not the scheduled projects tasks. All project related technical tasks should be on your “project schedule sheet.” All action items ideally start with a verb describing correctly what needs to be done. Maintain list, keeping OPEN actions and NEW actions at the top. Once the action items are closed and presented, they don't need to be presented again. A unique action ID, responsible person, and a target date are very important.
CreationDate + Action ID | Resp. | Description of the action item (person responsible - target completion date) | Status | Target Completion Date
2024-01-20 | Kelly Mae | Design enclosure | Open | 2024-02-09
2023-10-01 |  | Color Selection for User Design Process | Open | n/a
2024-02-07 | Nida | Add power and SD port to the main PCB | Open | 2024-02-22
2024-02-07 | Nida | Finish redesigning the main board | Open | 2024-02-29
 | Parker | connect to web server to unsderstand commands
2024-01-18 | Parker | Switch Microcontroller to ESP32 | Closed
2024-02-07 | Abisha | Start User System 1 with Arduino and lights | Open | 1/8-9/24
2024-01-31 | Abisha | Double check the whole double address situation (it is not a result of two I2C ports on Arduino, it's probably looking at the R/W bit) | closed | 2024-01-07
2024-02-02 | Abisha | read through the entire library file for the keypad | Closed | 2024-01-06
2024-02-02 | Abisha | Try online keypad script using ONLY digital read | Closed | 2024-01-05
2024-02-05 | Abisha | Try online keypad script using pull-up resistors, pull-down resistors, no resistors (along with writing HIGH to the columns) | Closed | 2024-01-05
2024-02-07 | Kelly Mae | Figure out why power test results were weird | Open | 2024-02-15
2024-02-18 | Abisha | Circle back to the rotary encoder and try it with the pcf8574 library that we know works | Closed | 2024-02-23
2024-02-18 | Abisha | Write pseudocode to go with the usersystem and what information/format it expects from protocontrol | Closed | 2024-02-26
2024-03-20 | Abisha | Write Rough Draft of User Manual | Open | 2024-03-22
2024-03-20 | Nida | Integrate slider with pcf chip | Open | 2024-03-22
2024-03-20 | Parker | Work on integrating protocontrol with other senior design teams | Open | 2024-03-27
2024-03-20 | Will | Work on creating enclosure with pogo pins | Open | 2024-03-27
2024-03-20 | Kelly Mae | Work on integrating protocontrol with other senior design teams | Open | 2024-03-27
2024-04-10 | Parker, Will, Kelly Mae | Enclosure Done (Peripherals and Main board) | Open | 2024-04-10
2024-04-10 | Parker, Will | 3D Printer Demo | Open | 2024-04-10
2024-04-10 | Kelly Mae | Fixing Flash Memory | Open | 2024-04-10
2024-04-10 | All | Setup Team 33 | Open | 2024-04-12
2024-04-10 | Abisha | Poster | Open | 2024-04-12
2024-04-10 | All | Assembly Day (4 Protocontrols needed for 4 Demos) | Open | 2024-04-14
2024-04-10 | Kelly Mae, Nida | Test Wifi at McKimmon | Open | TBD
2024-04-10 | Abisha | User Manual (to be printed 4/17) | Open | 2024-04-15
2024-04-10 | Abisha | Technical Spec. Sheet | Open | 2024-04-17
2024-04-10 | Abisha | Polish Arduino User System | Open | 2024-04-17
2024-04-10 | Will | Polish 306 Car Demo | Open | 2024-04-17
2024-04-10 | Will, Nida | Enclosure for 3D Printer | Open | 2024-04-17
2024-04-10 | All | Final Document Package | Open | 2024-04-23

Sheet: Lessons Learned
 |  | Add the "Lessons learned" tab in your team charter based on the template here.This is to document what went well and not so well for each team. This tab is to document to yourselves and future projects how you have handled issues you have encountered and resolved.
Lessons Learned
ID | Date Created | Lesson | Impact on Project | Work Around | Experience Gained | Root Cause | Proposed Receiver | Lesson Category (Process, Project Management, Tech/Product) | Comment | Issuer
1 | 2023-10-20 | How to Debug "can't open device "/dev/cu.usbmodem1411": No such file or directory" Error | Some time (~30 minutes) lost debugging this issue | Solution found on Arduino Forum (link) (https://forum.arduino.cc/t/missing-port/305798/7) | Can much quickly move past this error as it shows up | Using a port adapter with multiple USB-A ports | Abisha, also of benefit to team | Tech/Arduino |  | Abisha Fenn
2 | 2023-10-24 | Agressively trying different solutions quickly is a good debugging strategy AND MCP 23017 is not compatible with libraryless solutions either | Time ( ~9 hours) lost debugging this issue | Use the PCF8574 instead of the MCP23017 | Learned how to read Arduino Class files, Libraries, and how to poll a rotary encoder | 1. Rotary Encoder had no way of knowing it was connected to pin expander (it was looking for a signal from the Arduino Uno) 2. Currently no idea why the library failed 3. We *think* that mcp.digitalWrite is fundamentally different than the arduino digitalWrite | Abisha, also of benefit to team | Tech/Arduino/PinExpanders |  | Abisha Fenn
3 | 2023-11-16 | Always check the id on components as soon as I receive them in the mail | Time ( ~6 hours) lost debugging this issue and 5 working days lost | Reorder parts from Digikey | Will not make this mistake again | Digikey fulfilled the order incorrectly | Abisha, also of benefit to team | Purchasing |  | Abisha Fenn
4 | 2023-11-27 | Importance of test points | No time lost | PCB review with Carlson | Useful to have reference points on the board |  | Nida and Parker | Process/Tech |  | Nida Kosedagi
5 | 2023-10-27 | Avoiding 90 degree angles | 1 day lost | PCB review with Carlson | Good practice for signal integrity and to avoid impedance mismatch |  | Nida and Parker | Process/Tech |  | Nida Kosedagi
6 | 2023-10-27 | Ground travelling parallel to clock traces | No time lost | PCB review with Carlson | Good practice to avoid electromagnetic interference |  | Nida and Parker | Process/Tech |  | Nida Kosedagi
7 | 2023-11-17 | Flooding a part of the PCB with ground plane | Had an inner layer in the PCB which was hard to justify | PCB review with Dr.Gupta | Will flood certain areas of the PCB with ground or any needed pin connection to avoid overlapping traces instead of using inner layers |  | Nida and Parker | Process/Tech |  | Nida Kosedagi
8 | 2024-02-07 | Adding vias to the PCB | Made working with surface mount components easier | Got help from a friend with experience | I learned how to add a via to a PCB on KiCad to switch layers while keeping the connection consistent |  | Nida, also benefit to the team | Process/Tech | It would have been very useful to have just one lecture last semester on PCB design | Nida Kosedagi
9 | 2024-01-31 | The wire library is not accessible to the main code so we need and I2C scanner that doesn't require this library | We lost some time (~30 minutes) and are now a little skeptical of using libraries in our main code | We used a different scanner script | I will be cautious about using library files in the future | The Wire library was inaccessible to our main system (either method of using the library or a subset of that library, we're still not 100% sure) | Abisha, Nida, Parker | Tech/Arduino |  | Abisha Fenn
10 | 2024-02-17 | It is important to keep a clean file setup. I had 4 different types of pcf8574 libraries which led to confusion | Old progress ceased to work | No work around needed, just some time to organize my files | I will organize my files more neatly in the future | Too many library files with the same name | Abisha | Process/File System |  | Abisha Fenn
11 | 2024-02-28 | Try as many libraries as possible as quickly as possible | Lost time with non-functioning old library | Use the new keypad library | More experience with Arduino IDE | tbd | Abisha, Will | Arduino |  | Will Wood
12 | 2024-03-07 | How to put ground pads and vias in KiCad | Saved time! | No issues here | More experience with KiCad | n/a | Nida | KiCad |  | Nida Kosedagi
13 | 2024-03-20 | Our old rotary encoder is the worst | Lost timeeee | Use the more standard rotary encoder | More experience with Arduino IDE | tbd | Abisha | Arduino |  | Abisha
14 | 2024-03-25 | Had to reset target directly to regenerate drill files on PCB | Late to order final PCB | Had to reset target directly to regenerate drill files on PCB | More experience with KiCad | directories | Parker | KiCad |  | Parker

Sheet: BoM
Bill of Materials
Part description | Part number | Footprint | Qty | Unit Price | Total Price | Vendor | Link
PCBs
Main PCB | -- |  | 1 | $1.40 | $1.40 | JLCPCB | https://jlcpcb.com/user-center/orders/?_t=1701177920164
Compinent PCB | -- |  | 4 | $1.40 | $5.60 | JCLPCB | https://jlcpcb.com/user-center/orders/?_t=1701177920164
ICs
PCF8574 SM Chip | 296-13108-1-ND - Cut Tape (CT) |  | 3 | $1.86 | $5.58 | Digikey | https://www.digikey.com/en/products/detail/texas-instruments/PCF8574DWR/484579?gad_source=1
ADS1115 Chip | 1528-1461-ND |  | 1 | $14.95 | $14.95 | Digikey | https://www.digikey.com/en/products/detail/adafruit-industries-llc/1085/5761229?gad_source=1
Enclosure
Magnetic Connectors | 5358 |  | 2 | $6.50 | $13.00 | Adafruit | https://www.adafruit.com/product/5358
Pogo Pins | ED8180-ND |  | 16 | $0.42 | $6.72 | Digikey | https://www.digikey.com/en/products/detail/mill-max-manufacturing-corp/0906-0-15-20-76-14-11-0/1147048
3D Print (Main Board, Joystick, Keypad, Rotary Encoder) | -- |  | 0.33 | $30.00 | $9.90 | Prusament | https://prusament.com/materials/pla/
Solder | KE1101-ND |  | 0.3 | $54.00 | $16.20 | Digikey | https://www.digikey.com/en/products/detail/kester-solder/24-6337-0039/31099
Stranded Wire | 1175-1015-24-1-2000-004-1-TS-DS-ND |  | 1 | $0.58 | $0.58 | Digikey | https://www.digikey.com/en/products/detail/cnc-tech/1015-24-1-2000-004-1-TS/17799199?gad_source=1
Crimp | WM18889TR-ND - Tape & Reel (TR) |  | 4 | $0.08 | $0.31 | Digikey | https://www.digikey.com/en/products/detail/molex/0008701039/765268
Main Panel
ESP 32-S3 | 5477 | https://learn.adafruit.com/adafruit-esp32-s3-feather/downloads | 1 | $19.95 | $19.95 | Digikey | https://www.adafruit.com/product/5477
Capacitive Touchscreen | 1528-2848-ND |  | 1 | $29.95 | $29.95 | Digikey | https://www.digikey.com/en/products/detail/adafruit-industries-llc/2090/9919535
LED | 732-5008-ND |  | 1 | $0.15 | $0.15 | Digikey | https://www.digikey.com/en/products/detail/w%C3%BCrth-elektronik/151031VS06000/4489988
Buttons | EG5455-ND |  | 2 | $0.36 | $0.72 | Digikey | https://www.digikey.com/en/products/detail/e-switch/TL1105YF160Q/514438?gad_source=1
Barrel Jack Connector | 839-54-00166-ND |  | 1 | $0.74 | $0.74 | Digikey | https://www.digikey.com/en/products/detail/tensility-international-corp/54-00166/10459294
4x1 Header, | S1131EC-20-ND |  | 1 | $0.56 | $0.56 | Digikey | https://www.digikey.com/en/products/detail/sullins-connector-solutions/PRPC020SACN-RC/2776086?gad_source=1
20x1 Header | 732-61302011821-ND |  | 2 | $0.93 | $1.86 | Digikey | https://www.digikey.com/en/products/detail/w%C3%BCrth-elektronik/61302011821/16608603?gad_source=1
I2C Components
Rotary Encoder | 377 |  | 1 | $4.50 | $4.50 | Adafruit | https://www.adafruit.com/product/377
Keypad | 3845 |  | 1 | $6.50 | $6.50 | Adafruit | https://www.adafruit.com/product/3845
Joystick | 512 |  | 1 | $5.95 | $5.95 | Adafruit | https://www.adafruit.com/product/512
Wiring
Barrel Jack to USB Cable | 1528-2429-ND |  | 1 | $6.50 | $6.50 | Digikey | https://www.digikey.com/en/products/detail/adafruit-industries-llc/2777/7807992?gad_source=1
UART (4-wire) Cable* | -- |  | 1 | $1.00 | $1.00 | Custom
Total Cost: |  |  |  |  | $152.62

Sheet: Manufact&EoL
Follow the format from the tab "Lessons learned" in the team charter template to document the following: -How do you plan on making (process) your device prototype? -How to you see your device being made in high volume? -What will happen at teh devive end of life? -What steps have you taken to minimize the negative effects on the planet for end of life?

Sheet: Final Proj Cost
Not for ECE484, Needs to be updated at the end of ECE 485. What you see below is an example.
Part |  | Quantity | Manufacturer Part Number | Vendor Part Number | Price (for 1) | Total | Link to the specific item to be purchased
Order 1
STEMMA Slider |  | 1 |  | 5295 | $9.95 | $9.95 | https://www.adafruit.com/product/5295
Rotary Encoder |  | 1 |  | 377 | $4.50 | $4.50 | https://www.adafruit.com/product/377
UNO OLED shield: 2.8" TFT Touch Shield for Arduino with Capacitive Touch |  | 1 |  | 1947 | $44.95 | $44.95 | https://www.adafruit.com/product/1947
Adafruit MCP23017 I2C GPIO Expander Breakout - STEMMA QT / Qwiic |  | 1 |  | 5346 | $5.95 | $5.95 | https://www.adafruit.com/product/5346
Order 2
TI GPIO expander |  | 3 | PCF8574N | 296-13109-5-ND | $2.57 | $7.71 | https://www.digikey.com/en/products/detail/texas-instruments/PCF8574N/484957
Microchip GPIO expander - ADC |  | 3 | MCP3427-E/UN | MCP3427-E/UN-ND | $3.68 | $11.04 | https://www.digikey.com/en/products/detail/microchip-technology/MCP3427-E-UN/2179259
GPIO expander adafruit |  | 3 | 5545 | 1528-5545-ND | $4.95 | $14.85 | https://www.digikey.com/en/products/detail/adafruit-industries-llc/5545/21283815
capacitive touchscreen |  | 1 | 2774 | 1528-2848-ND | $29.95 | $29.95 | https://www.digikey.com/en/products/detail/adafruit-industries-llc/2090/9919535
Other Orders
PCB |  | 3
Pogo Pins |  | 2 | 5360 | 5360 | $5.95 | $11.90 | https://www.adafruit.com/product/5360?gad_source=1
Feather Board |  | 1 | 4884 | 4884 | $11.95 | $11.95 | https://www.adafruit.com/product/4884?gad_source=1
TI GPIO expander |  | 3 | PCF8574N | 296-13109-5-ND | $2.57 | $7.71 | https://www.digikey.com/en/products/detail/texas-instruments/PCF8574N/484957
 | Parts: | 20 |  |  | Parts Cost: | $101.06
 |  |  |  |  | Shipping Costs For All orders | $12 | (approximately)
 |  |  |  |  | Total Cost | $113.06
