ProtoControl/ProtoControl/38_ProtoControl_SD_Fall2023/Serial Communication/Serial Communication Tasks.xlsx

Sheet: Tasks
Task
Look through all of the chips (from PDR)
Read the verilog module found online (upload to github and write comments)
FPGA Led Demo
Timing Diagram (for i2c)
Verilog module converting to i2c
verilog module communicating to i2c (one master multiple peripherals)
Verilog module communicating

Sheet: Off-the-Shelf Components
"i2c slave chip" |  | "analog to digital converter i2c" |  |  | " i2c expander with serial interface"
 |  | component name | price | link
24CS256-I/SN | link (https://www.digikey.com/en/products/detail/microchip-technology/24CS256-I%2FSN/16709724) | 2-Channel 16-Bit I2C/Qwiic Analog to Digital Converter | 15 | https://www.iascaled.com/store/I2C-MCP3427
P3T1755DPZ | link (https://www.digikey.com/en/products/detail/nxp-usa-inc./P3T1755DPZ/19525728) |  |  | link (https://cdn-learn.adafruit.com/downloads/pdf/adafruit-pcf8591-adc-dac.pdf)
