ProtoControl/ProtoControl/38_ProtoControl_SD_Fall2023/Serial Communication/Coordinates for components.docx

PushButton but = PushButton(5,10,ILI9341_GREEN,ILI9341_WHITE,"PUSH");

PushButton but2 = PushButton(110,10,ILI9341_BLUE,ILI9341_WHITE,"PUSH");

PushButton but3 = PushButton(215,10,ILI9341_BLUE,ILI9341_BLACK,"PUSH");

PushButton but4 = PushButton(5,65,ILI9341_BLUE,ILI9341_BLACK,"PUSH");

PushButton but5 = PushButton(5,120,ILI9341_BLUE,ILI9341_BLACK,"PUSH");

PushButton but6 = PushButton(5,180,ILI9341_BLUE,ILI9341_BLACK,"PUSH");

These are init commands that init the table below

Button dimensions are 100 by 50 px

5,10 | 110,10 | 215,10
5,65
5,120
5,180
