ProtoControl/ProtoControl/38_ProtoControl_SD_Fall2023/UserDocumentation/Assembly.docx

Joystick Assembly (0x48)

3v sda scl ground

You will need:

- X inches of Xmm Stranded Wire
- Wire cutter
- Wire stripper
1. Verify your circuit works on the bread board
2. Cut and strip 8 X” long pieces of the stranded wire
3. Solder the wires to the ADS1115
