ProtoControl/ProtoControl/38_ProtoControl_SD_Fall2023/Software Files/ProtoControlTraining/Test_Image.jpg

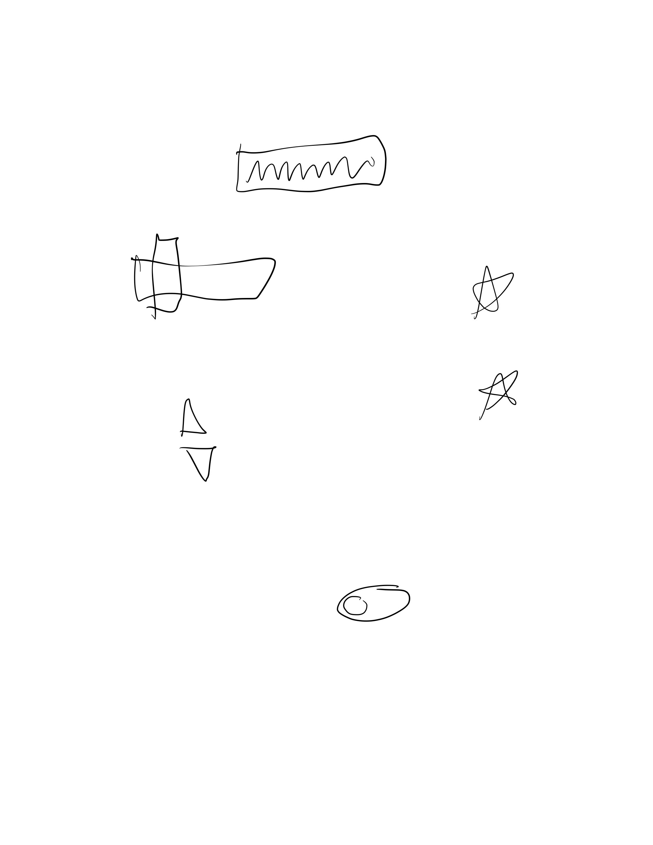
38_ProtoControl_SD_Fall2023/Software Files/ProtoControlTraining/Test_Image.jpg
