ProtoControl/ProtoControl/38_ProtoControl_SD_Fall2023/DEMO DAY POSTER/Poster_485_38_Protocontrol (2).pdf

## A plug and play panel with a start-to-finish user interface development experience

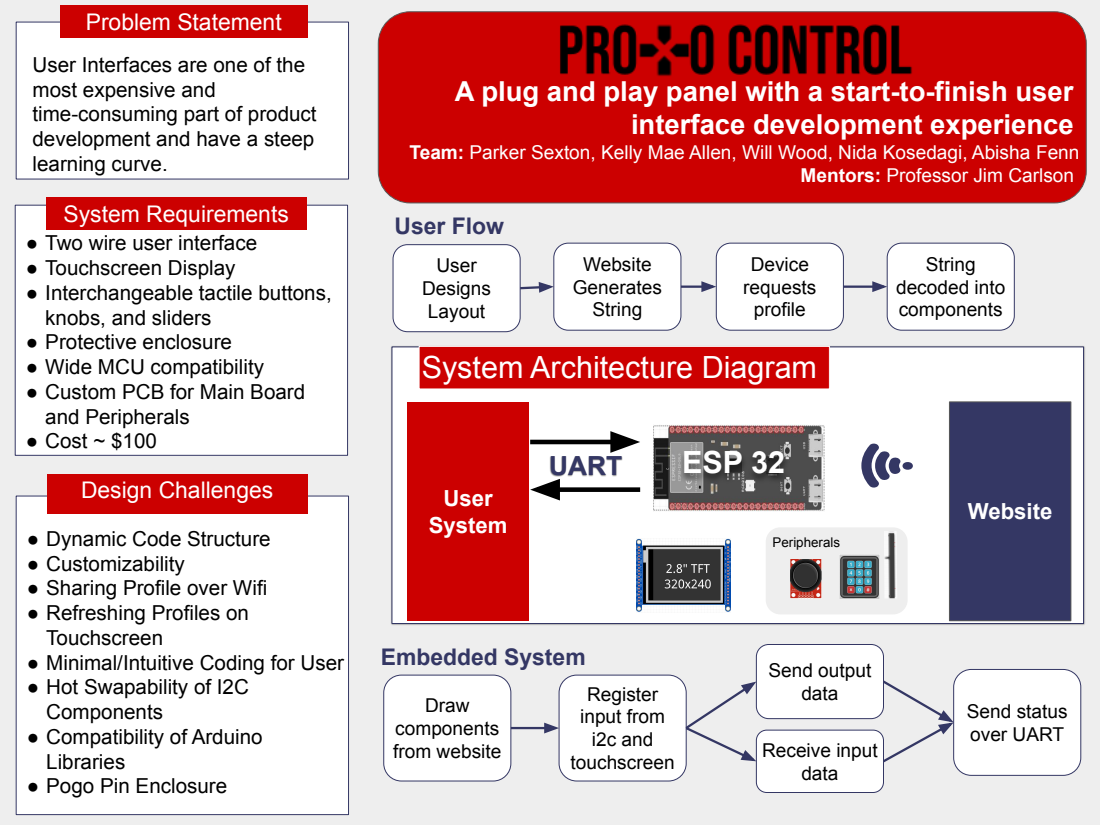
[picture p167: page 1]
Draw components from website; Register input from i2c and touchscreen; Send output data; Receive input data; Send status over UART; Embedded System; User Flow; Website Generates String; Device requests profile; String decoded into components; Problem Statement; Design Challenges; User; System; Website; ESP 32; Peripherals; UART

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

Team: Parker Sexton, Kelly Mae Allen, Will Wood, Nida Kosedagi, Abisha Fenn

Mentors: Professor Jim Carlson

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

User
Designs
Layout
System Architecture Diagram

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
