ProtoControl/ProtoControl/38_ProtoControl_SD_Fall2023/Design Documents/First Concept Diagrams/Concept Design William Wood.pdf

⑧ | Protolontro | -

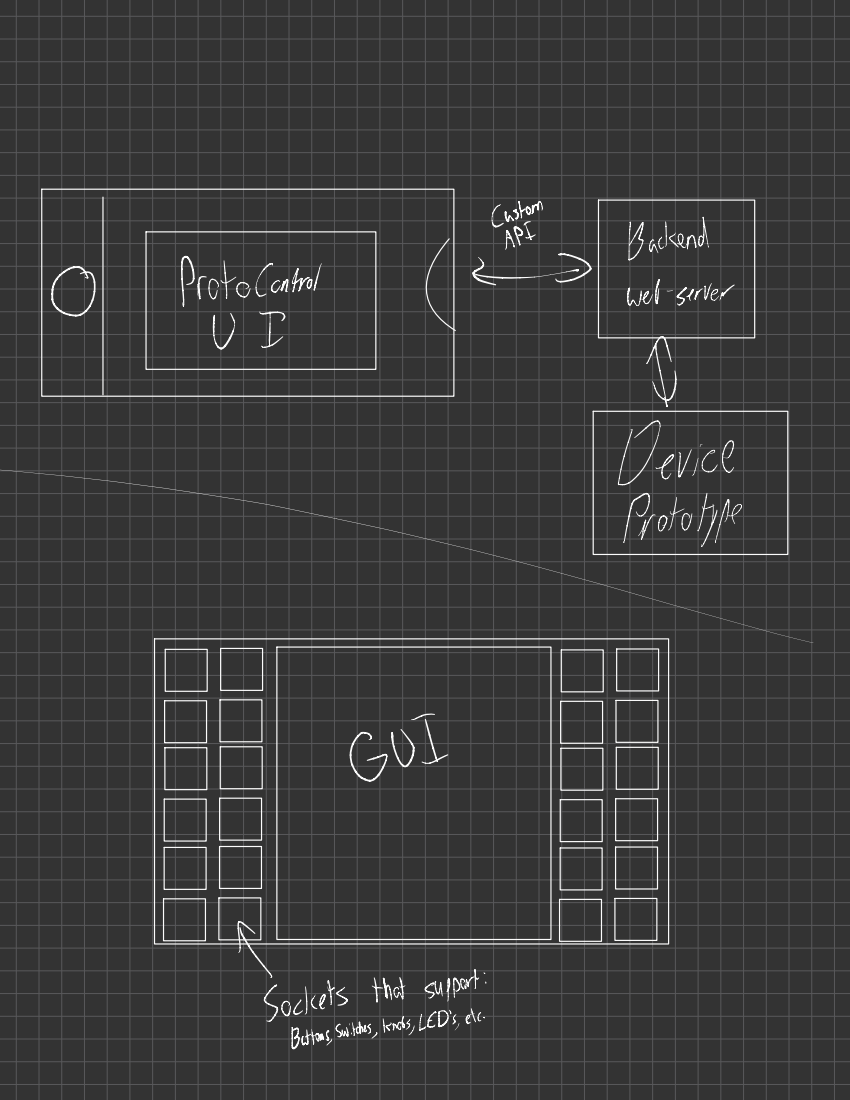
[picture p168: page 1]
Custom; Dackend; web-server; Device Notofte; GUI

Sons,wines,tos,e

↑

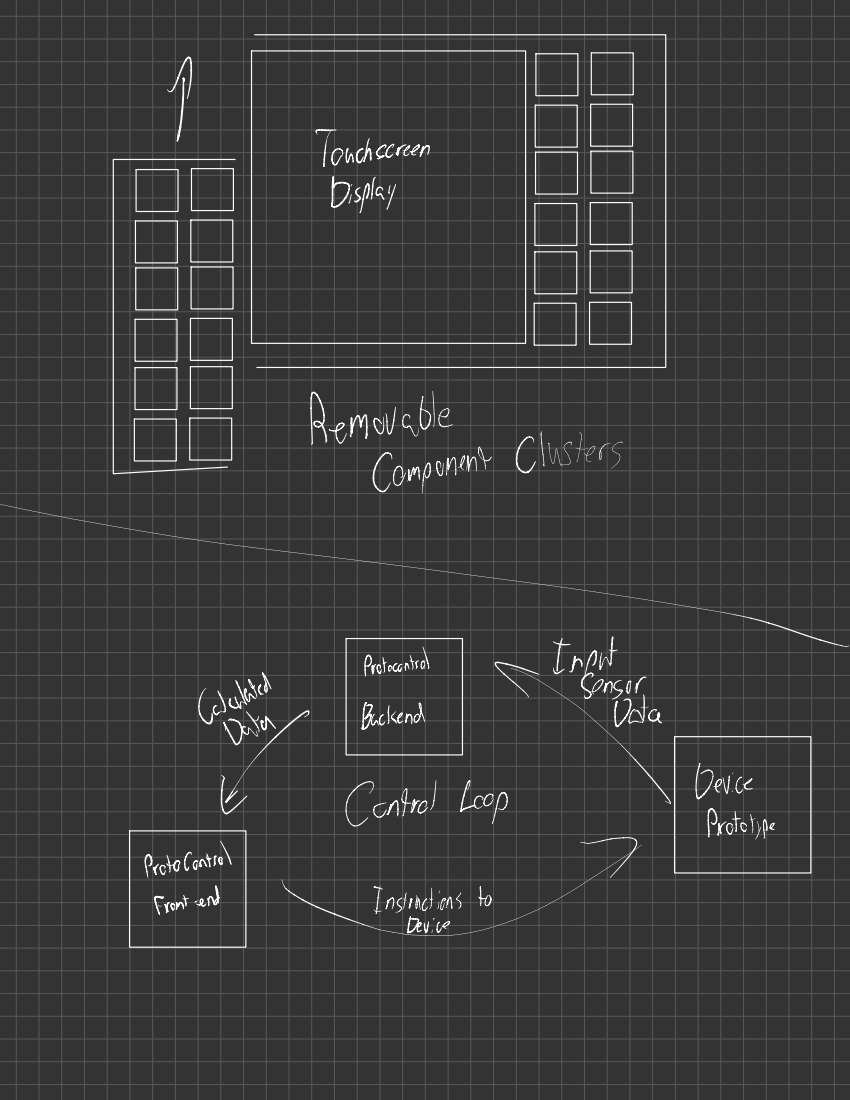
[picture p169: page 2]
Touchscreen Display; Removable treerecruiter; Prototype; PretoControl; Front-end; isto

Custom | Librar
Values | Device Protocontral

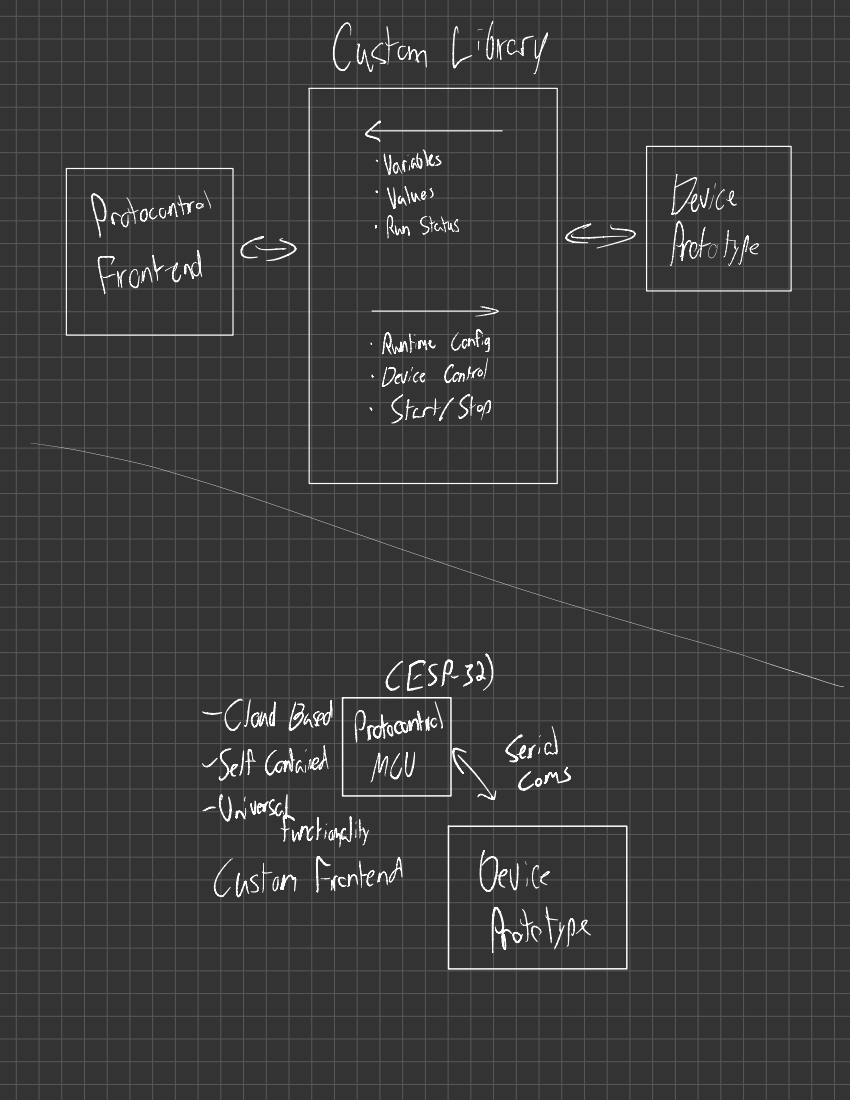
[picture p170: page 3]
Variables; Run Status; =>Prefofie; Front-end; Runtime; config ·; Device; Control; Start/sto; (ESP-32) -; Cloud; based; Protocontra; Serie ~; Self contained; MCU; come; Universa Functionality; Custom; Frontend; Protetie

## Transmitter g

>

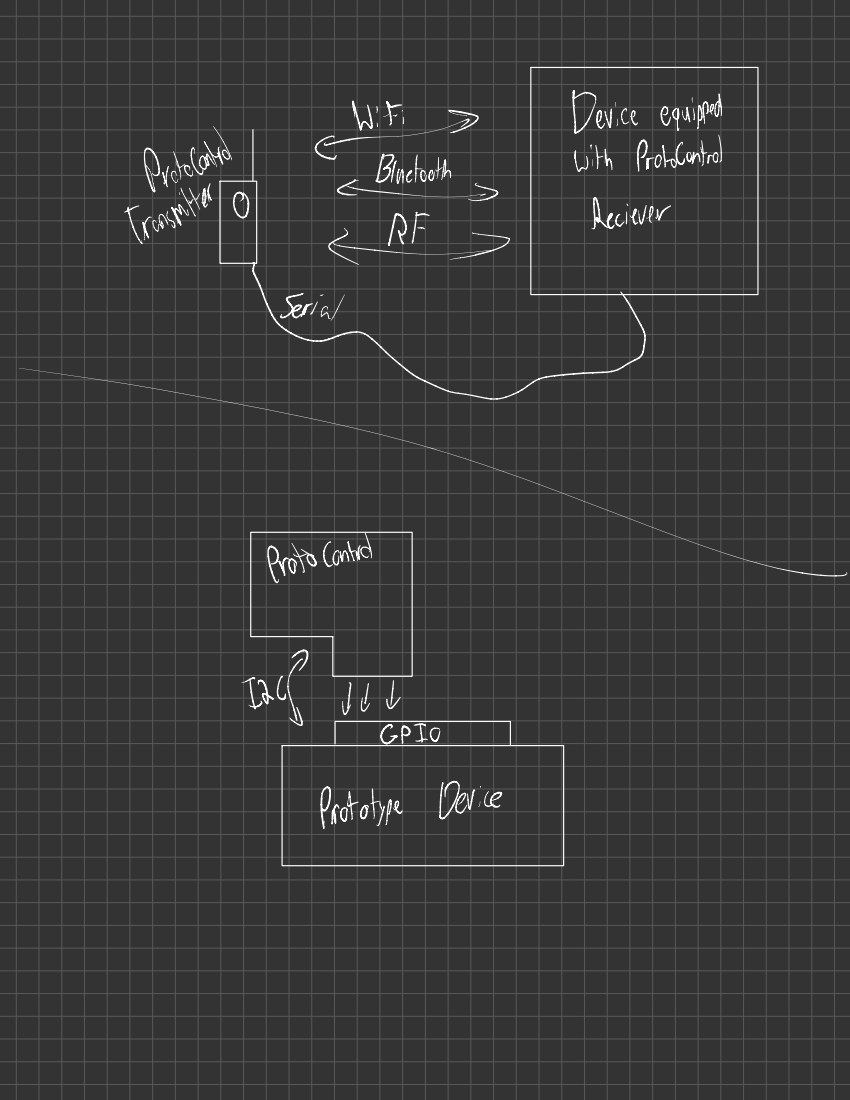
[picture p171: page 4]
Firs; Device; equipped; Protolott; With; Prokolontel foote; Reciever -; Proto Contro; Fat; tota; Prototype

↓

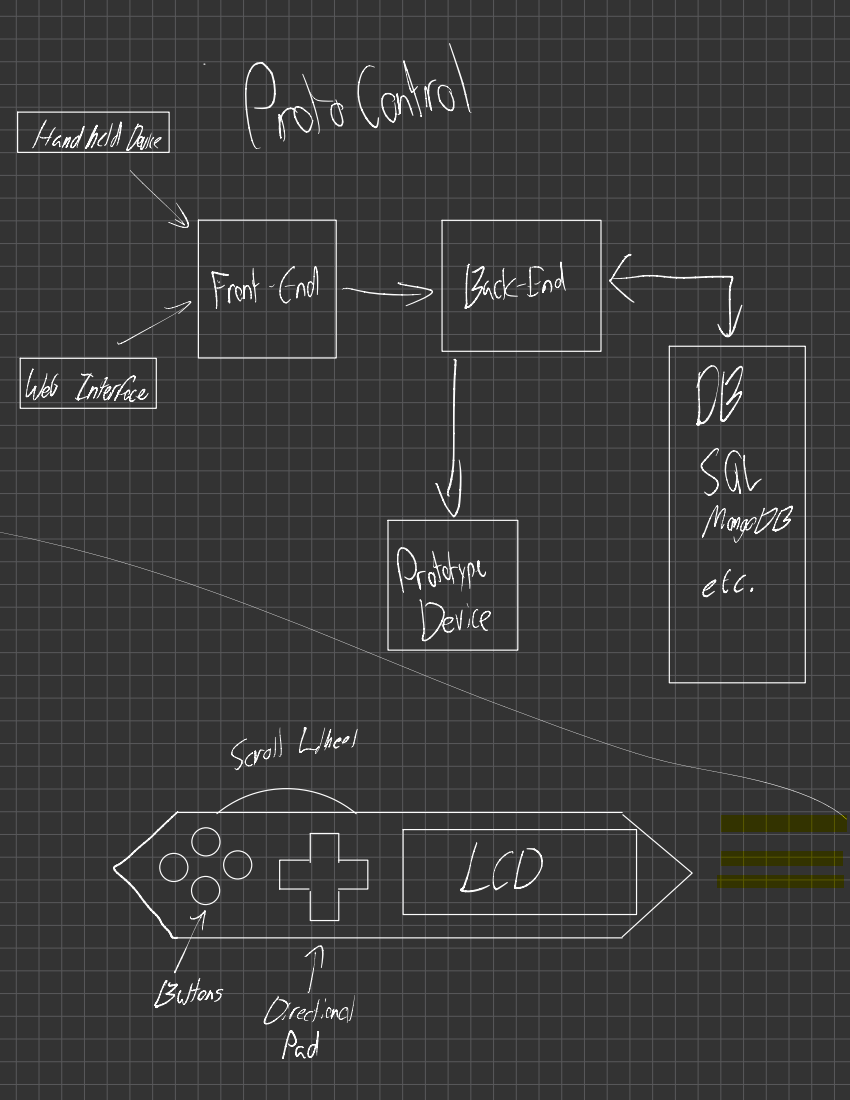
[picture p172: page 5]
Kandherders; Proto Control; Front-End; Far-End; Web; Interface; SQL MangobE e etc.; Scholl; Liber; ↑ Bufens; Directional; Pad
