ProtoControl/ProtoControl/38_ProtoControl_SD_Fall2023/Review-Demos Presentations/Open House/Poster_485_38_Protocontrol.pdf

### A plug and play panel with a start-to-finish user interface development experience

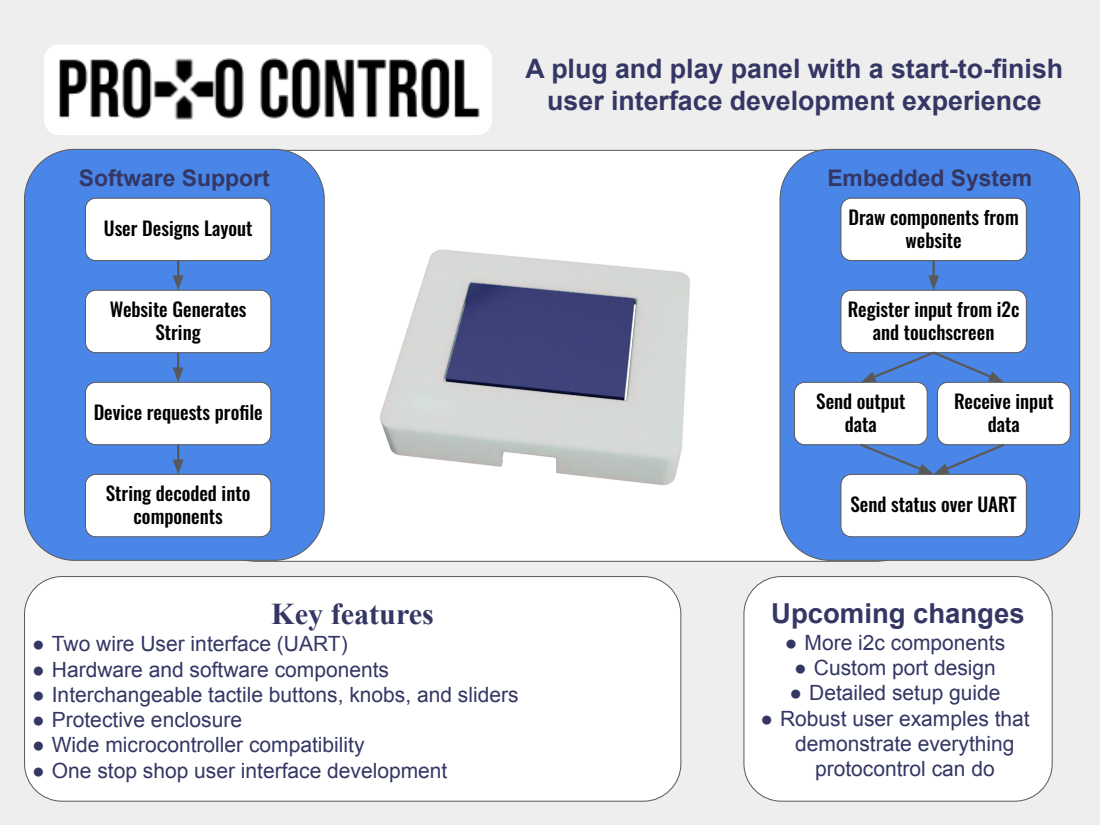
[picture p173: page 1]
Key features; Send output data; Receive input data; Software Support; Embedded System; Website Generates String

User Designs Layout

Draw components from
website

Register input from i2c
and touchscreen

Device requests profile

String decoded into
components

Send status over UART

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
