ProtoControl/ProtoControl/38_ProtoControl_SD_Fall2023/UserDocumentation/EnclosureDrawings/KeypadEnclosureDrawings.pdf

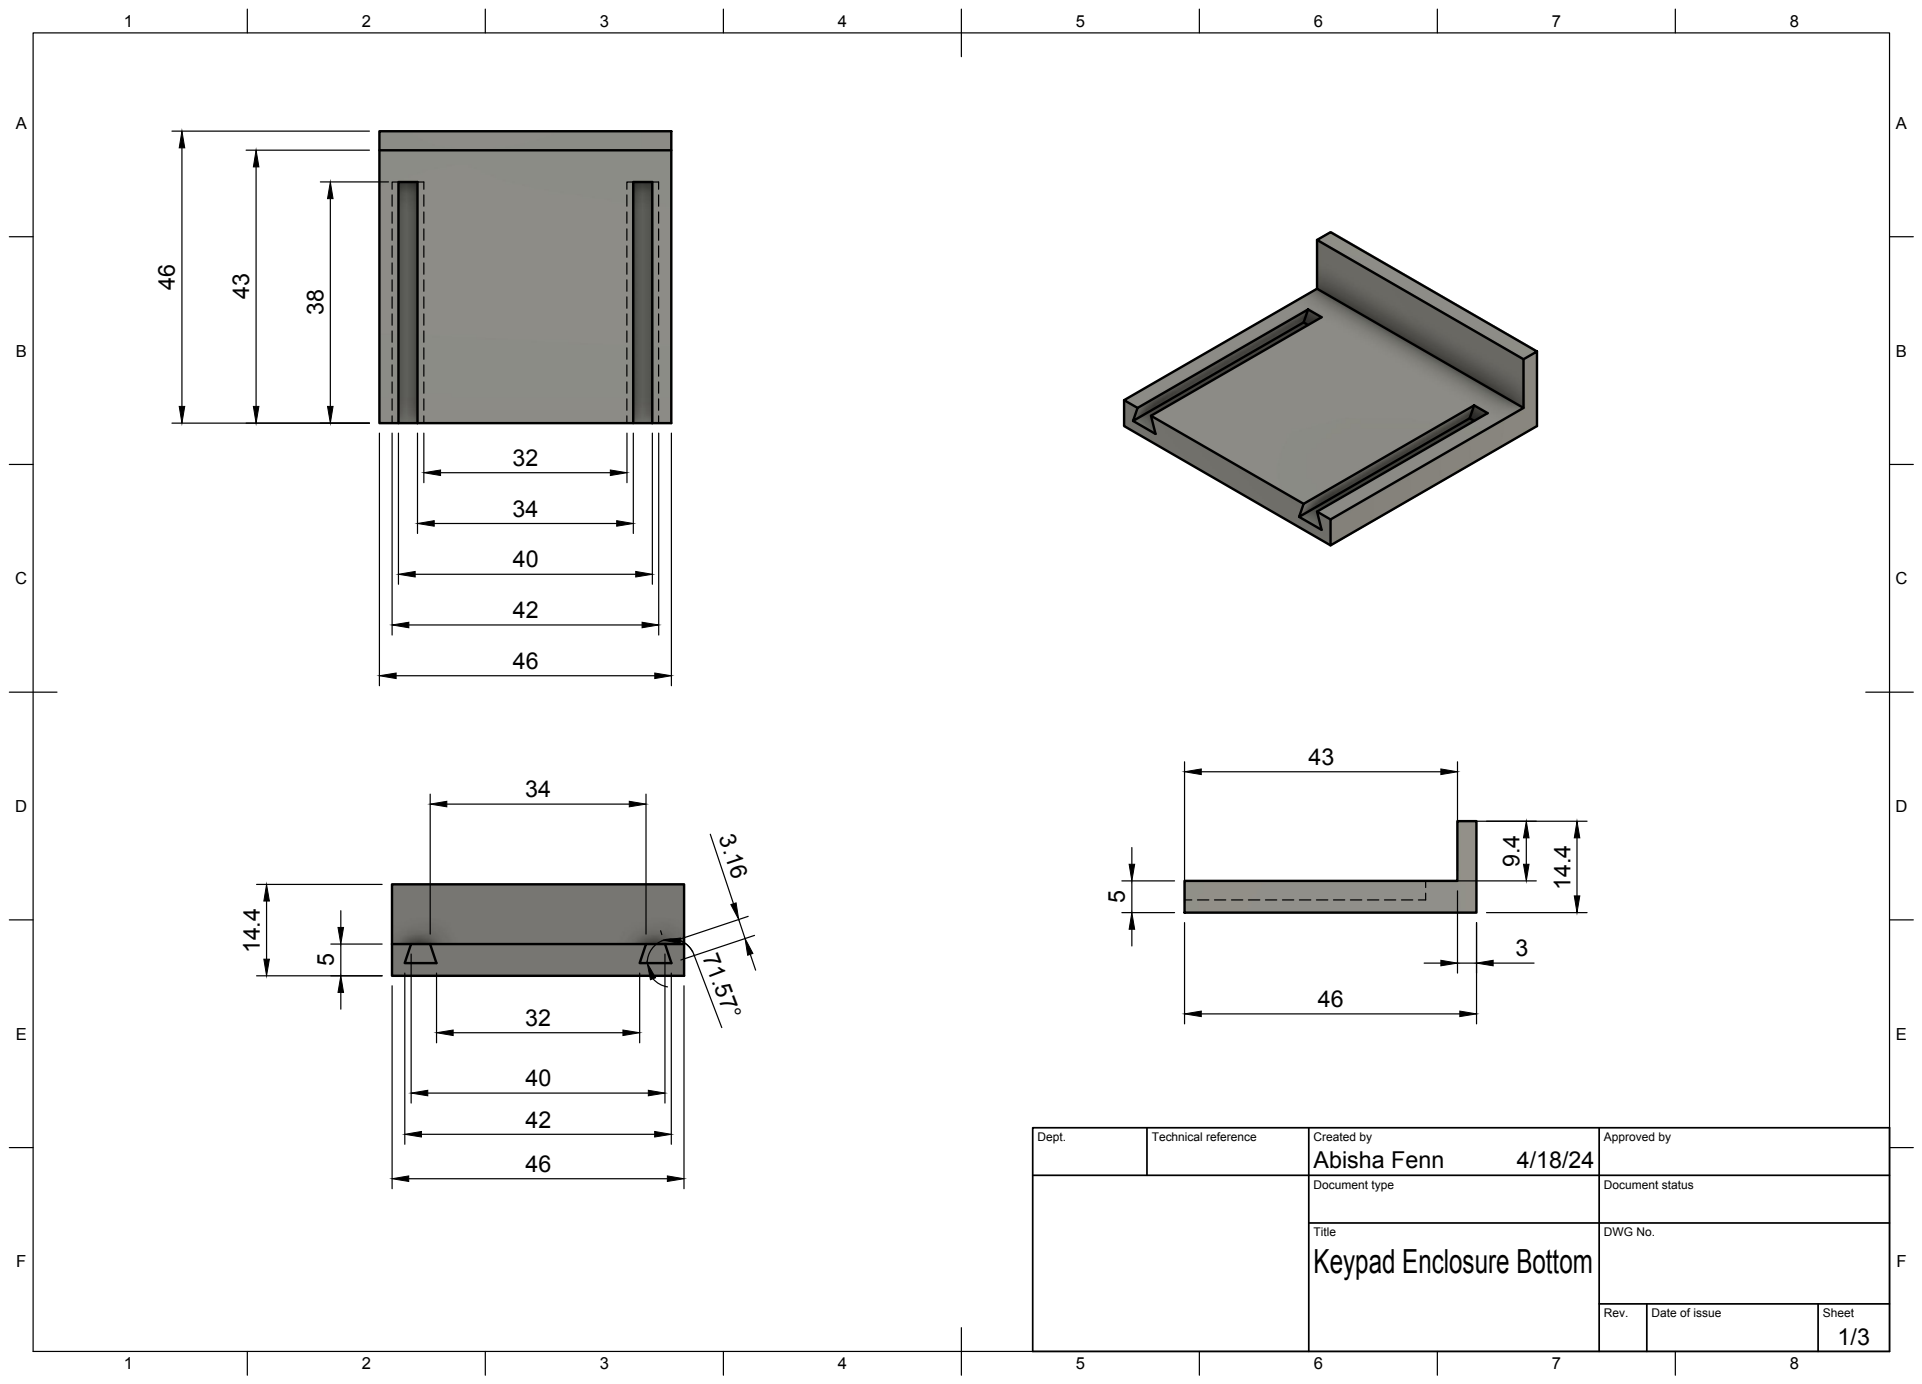
[picture p174: page 1]
Title; DWG No.; Rev.; Date of issue; Sheet

Dept. | Technical reference | Created by Abisha Fenn 4/18/24 | Approved by

Document type | Document status

Keypad Enclosure Bottom

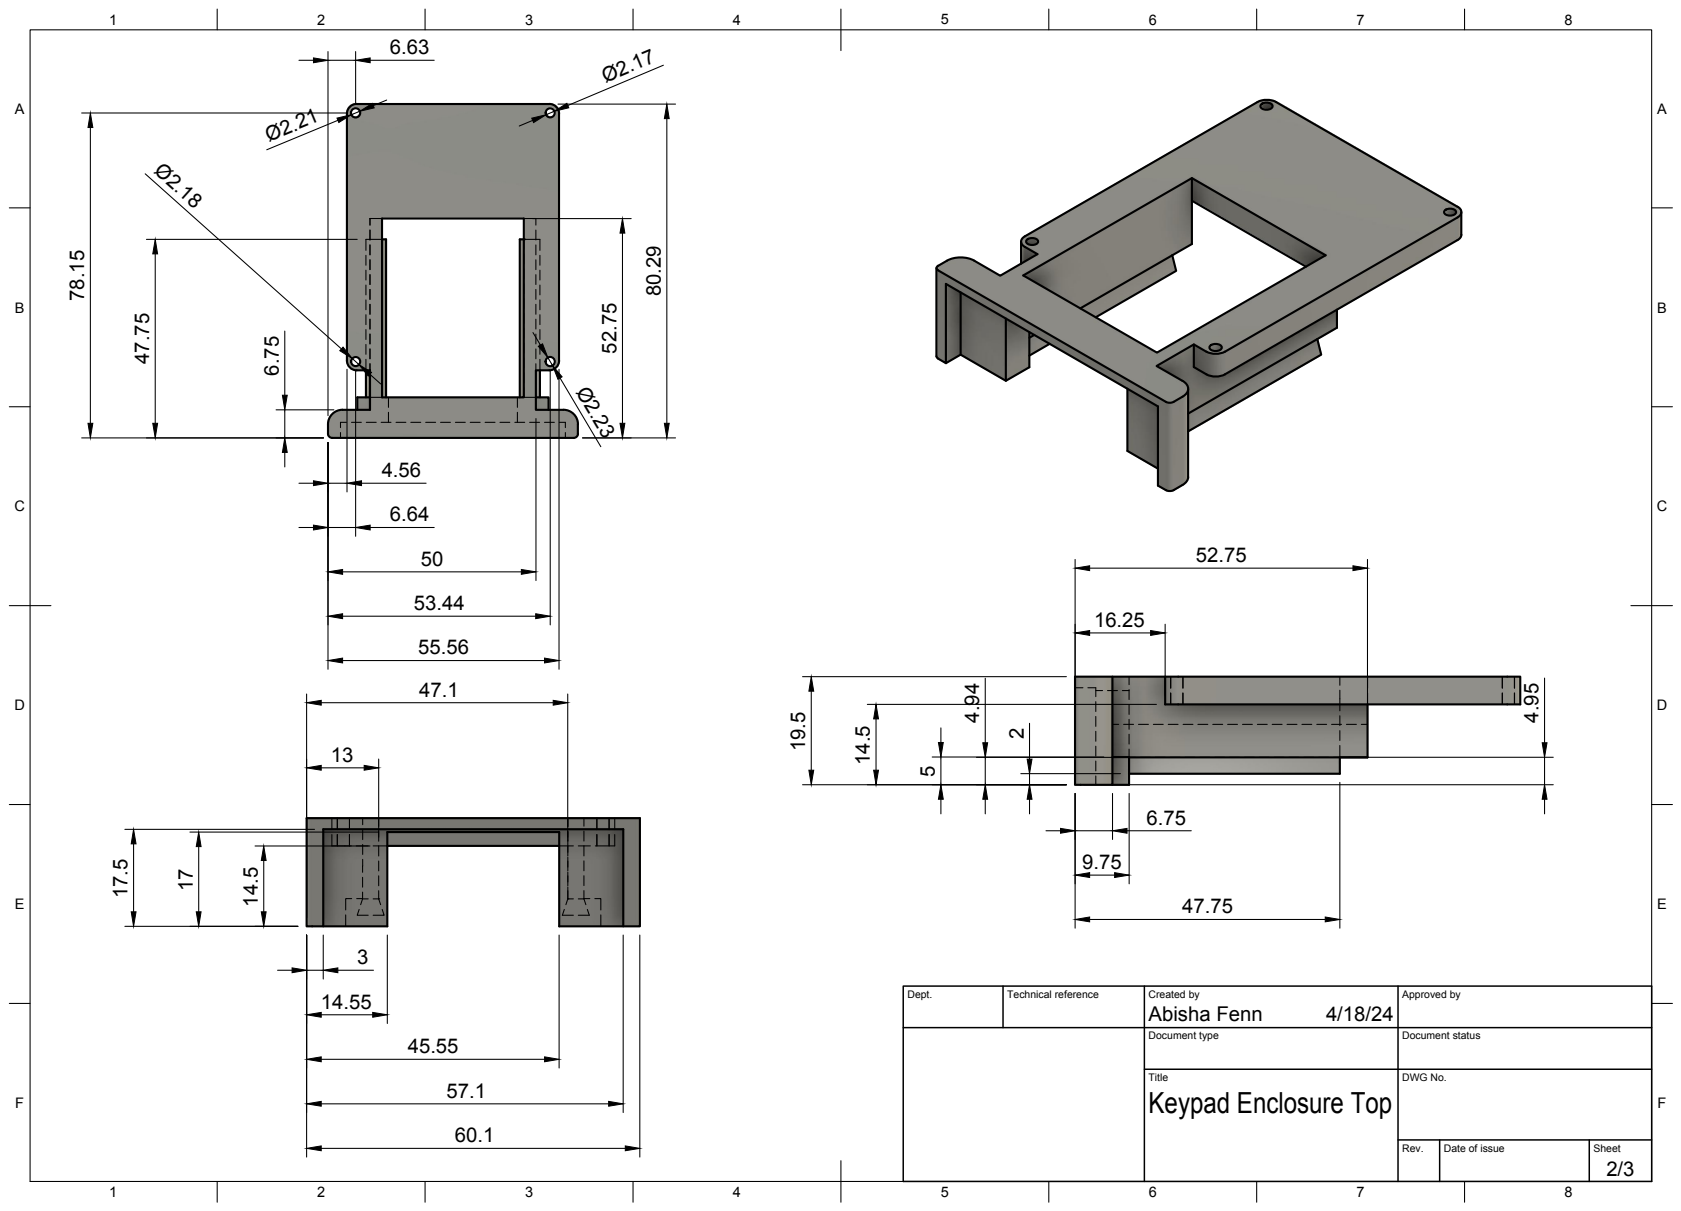
[picture p175: page 2]
Title; DWG No.; Abisha Fenn 80.29

Dept. | Technical reference | Created by 4/18/24 | Approved by

Document type | Document status

Keypad Enclosure Top

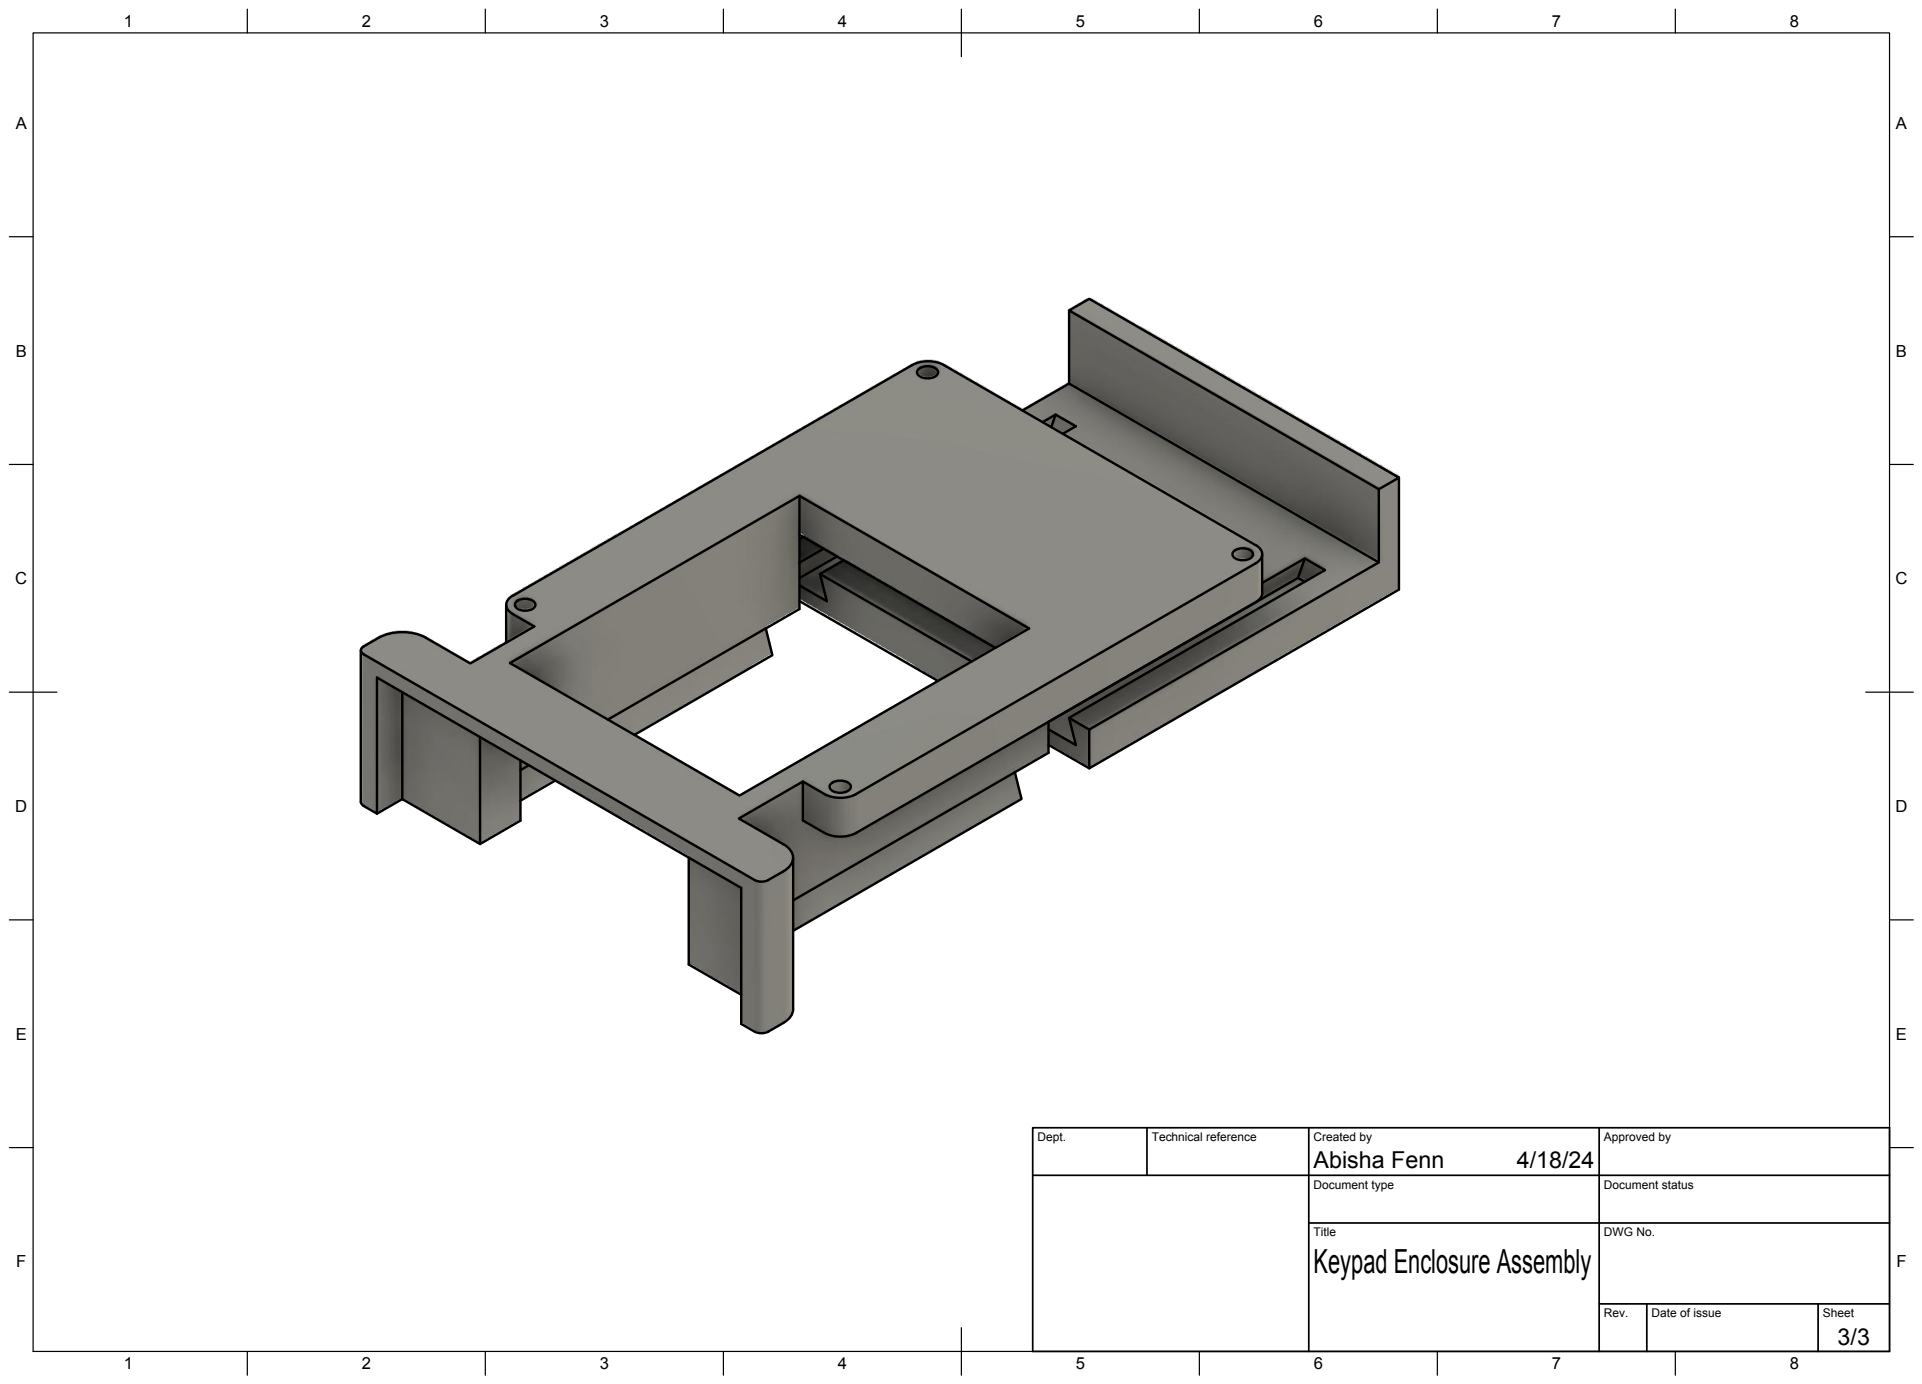
[picture p176: page 3]
Title; DWG No.

Dept. | Technical reference | Created by Abisha Fenn 4/18/24 | Approved by

Document type | Document status

Keypad Enclosure Assembly
