ProtoControl/ProtoControl/38_ProtoControl_SD_Fall2023/UserDocumentation/EnclosureDrawings/MainEnclosure Drawing.pdf

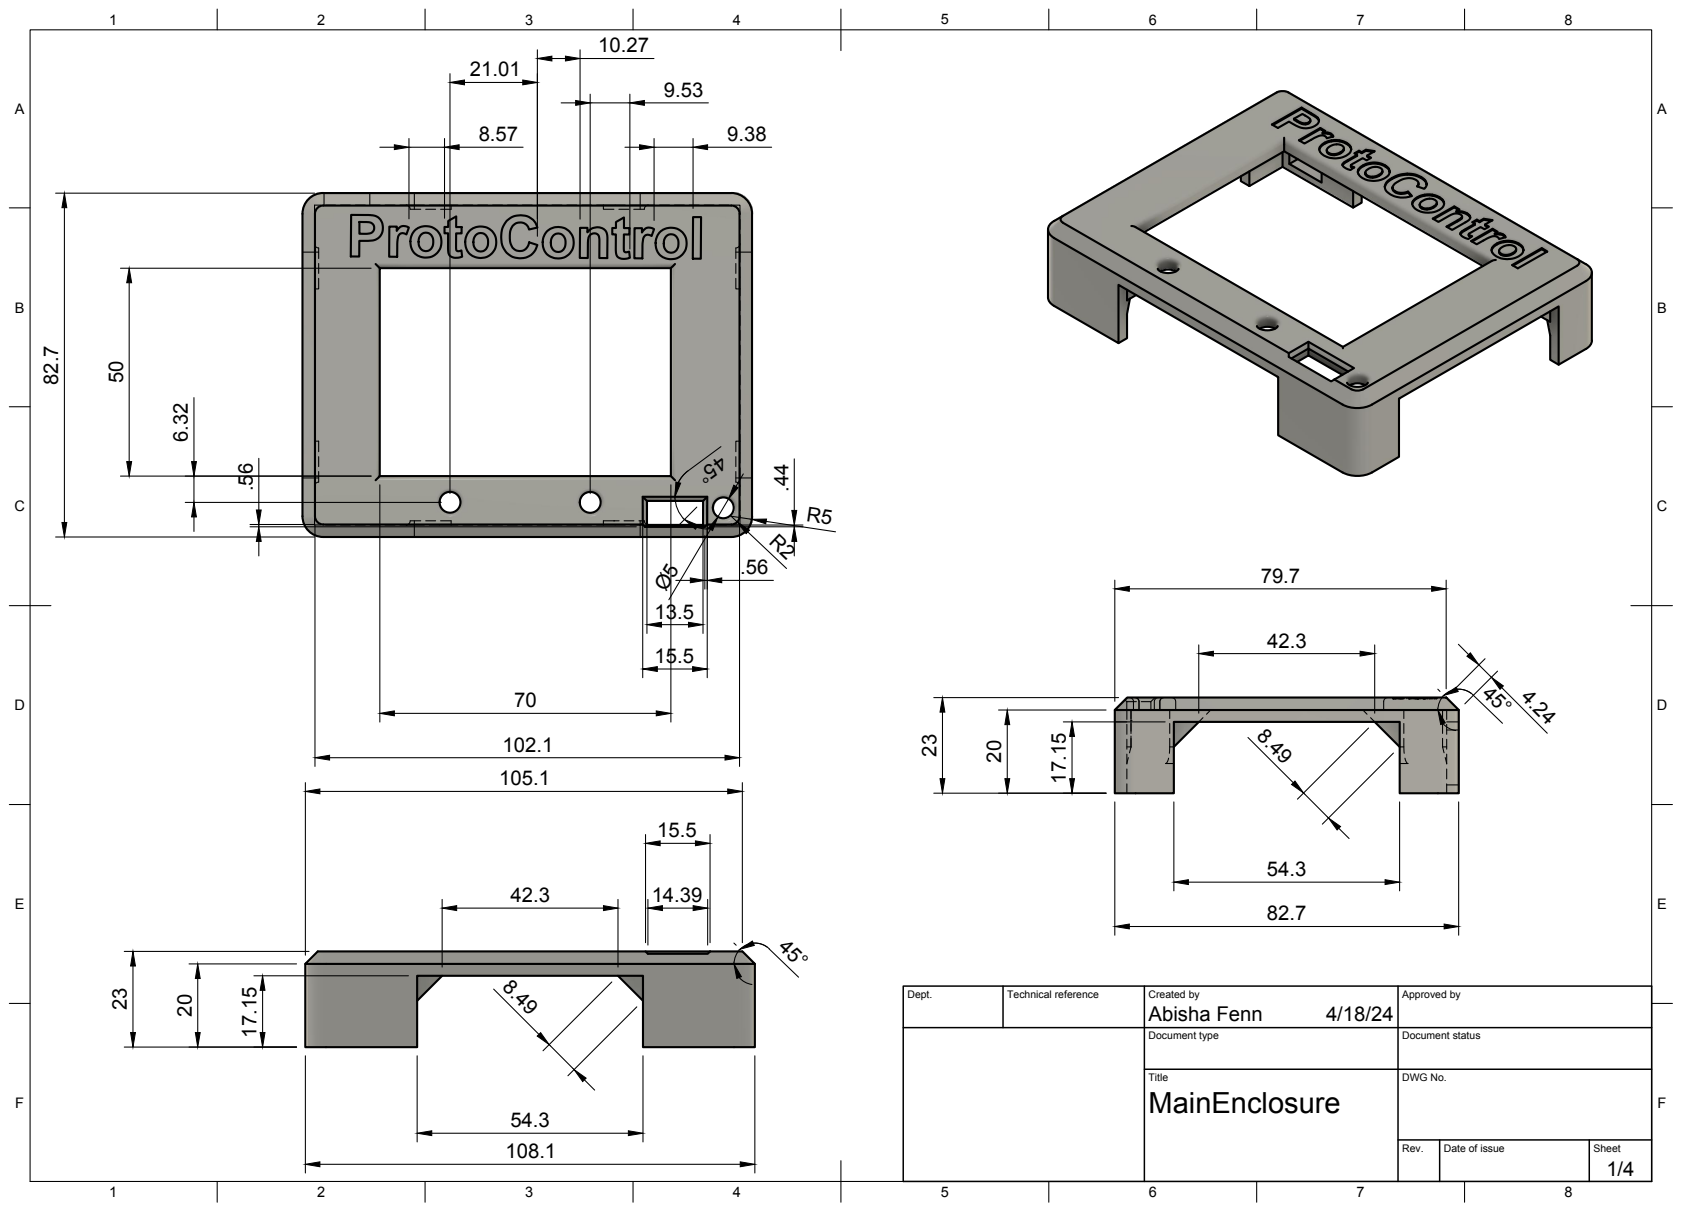
[picture p177: page 1]
Title; DWG No.; Rev.; Date of issue; Sheet; Abisha Fenn 82.7

Dept. | Technical reference | Created by 4/18/24 | Approved by

Document type | Document status

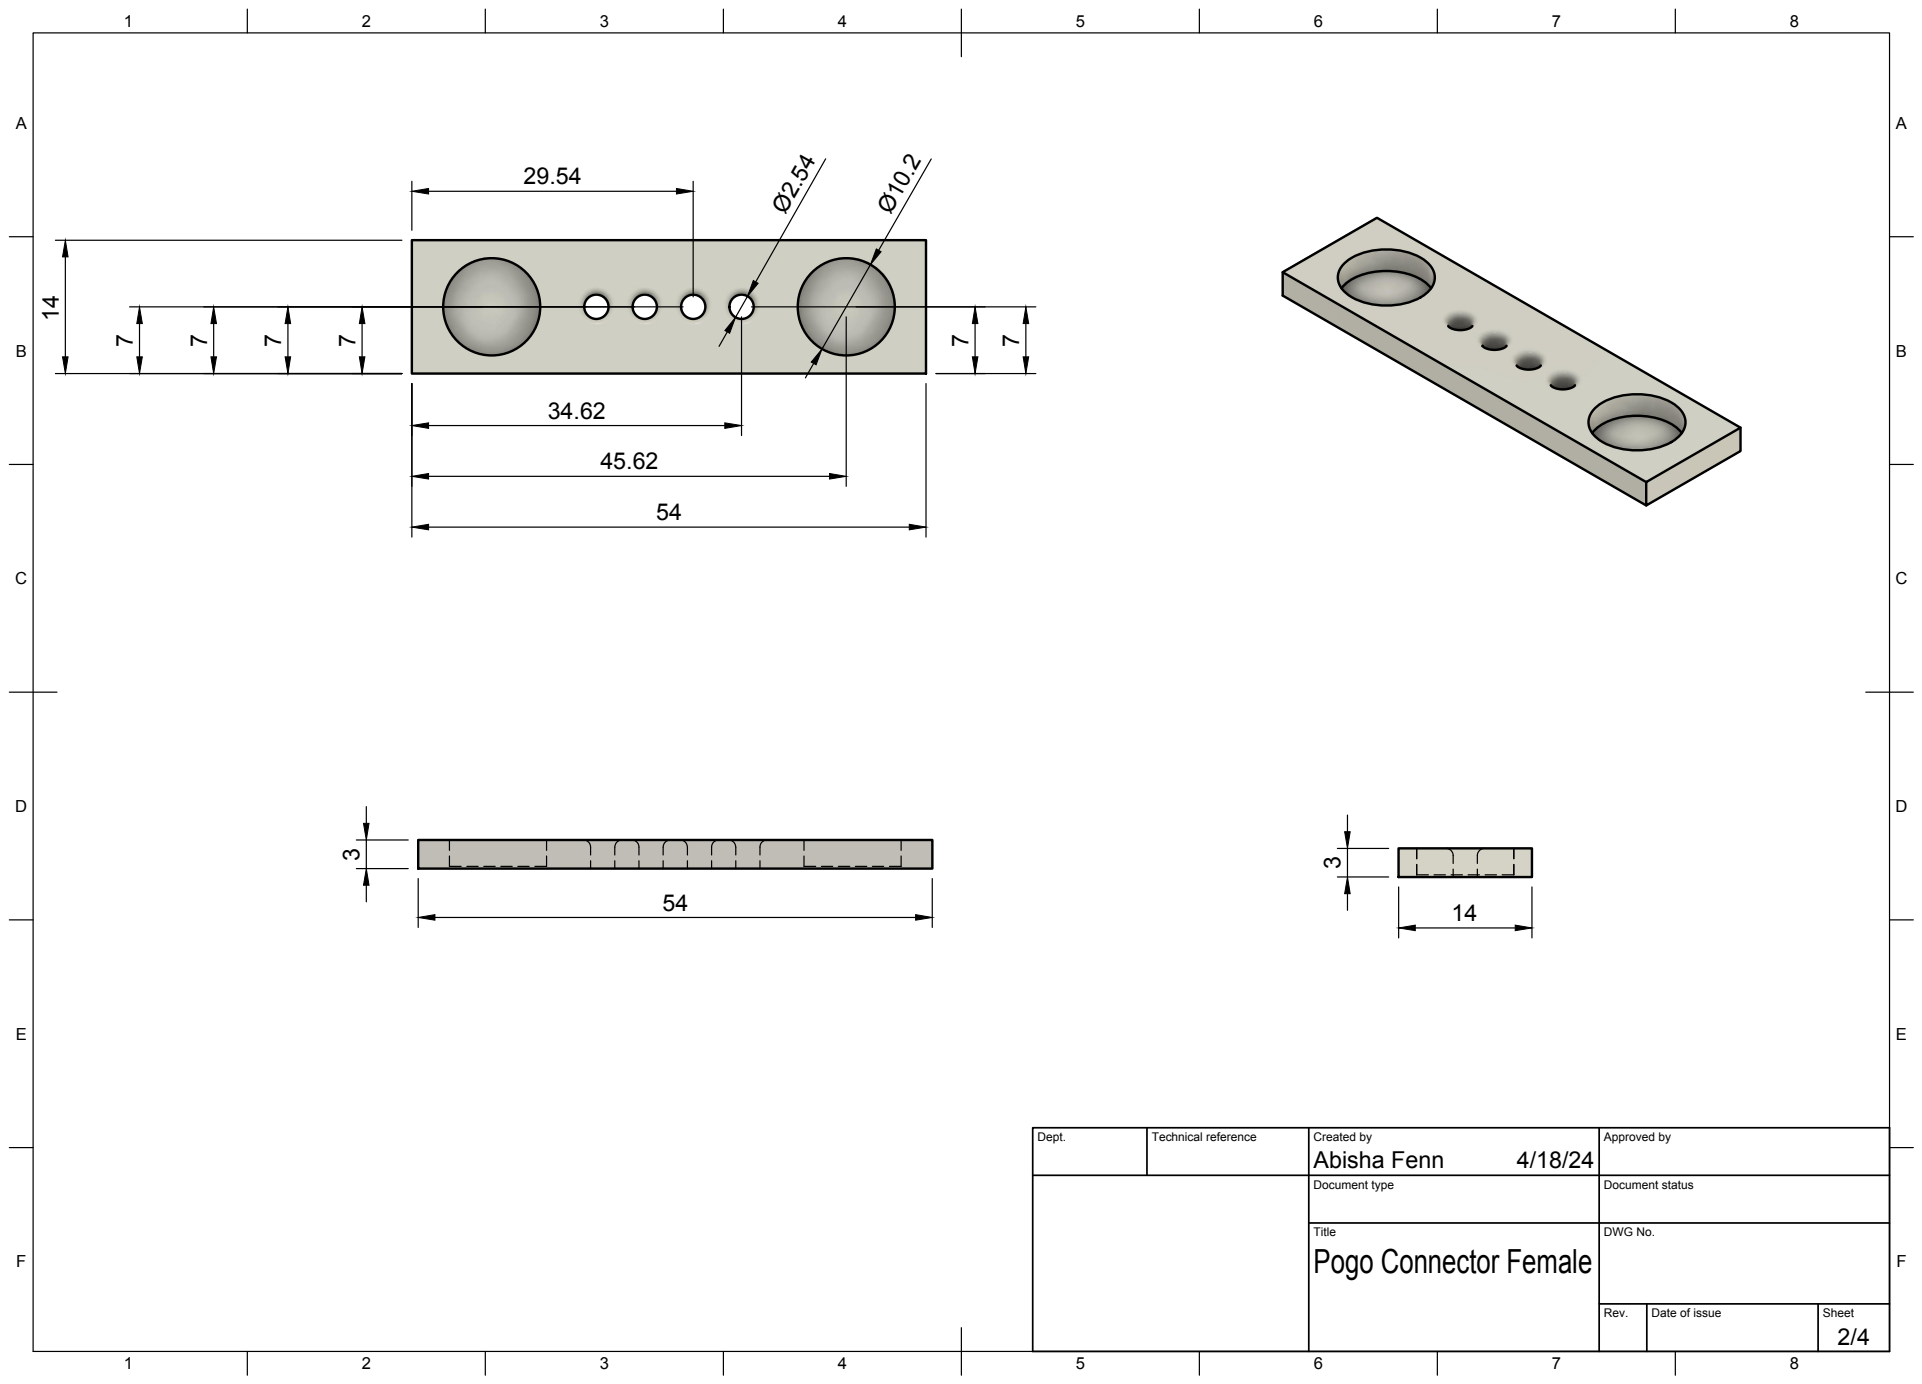
[picture p178: page 2]
Title; DWG No.

Dept. | Technical reference | Created by Abisha Fenn 4/18/24 | Approved by

Document type | Document status

Pogo Connector Female

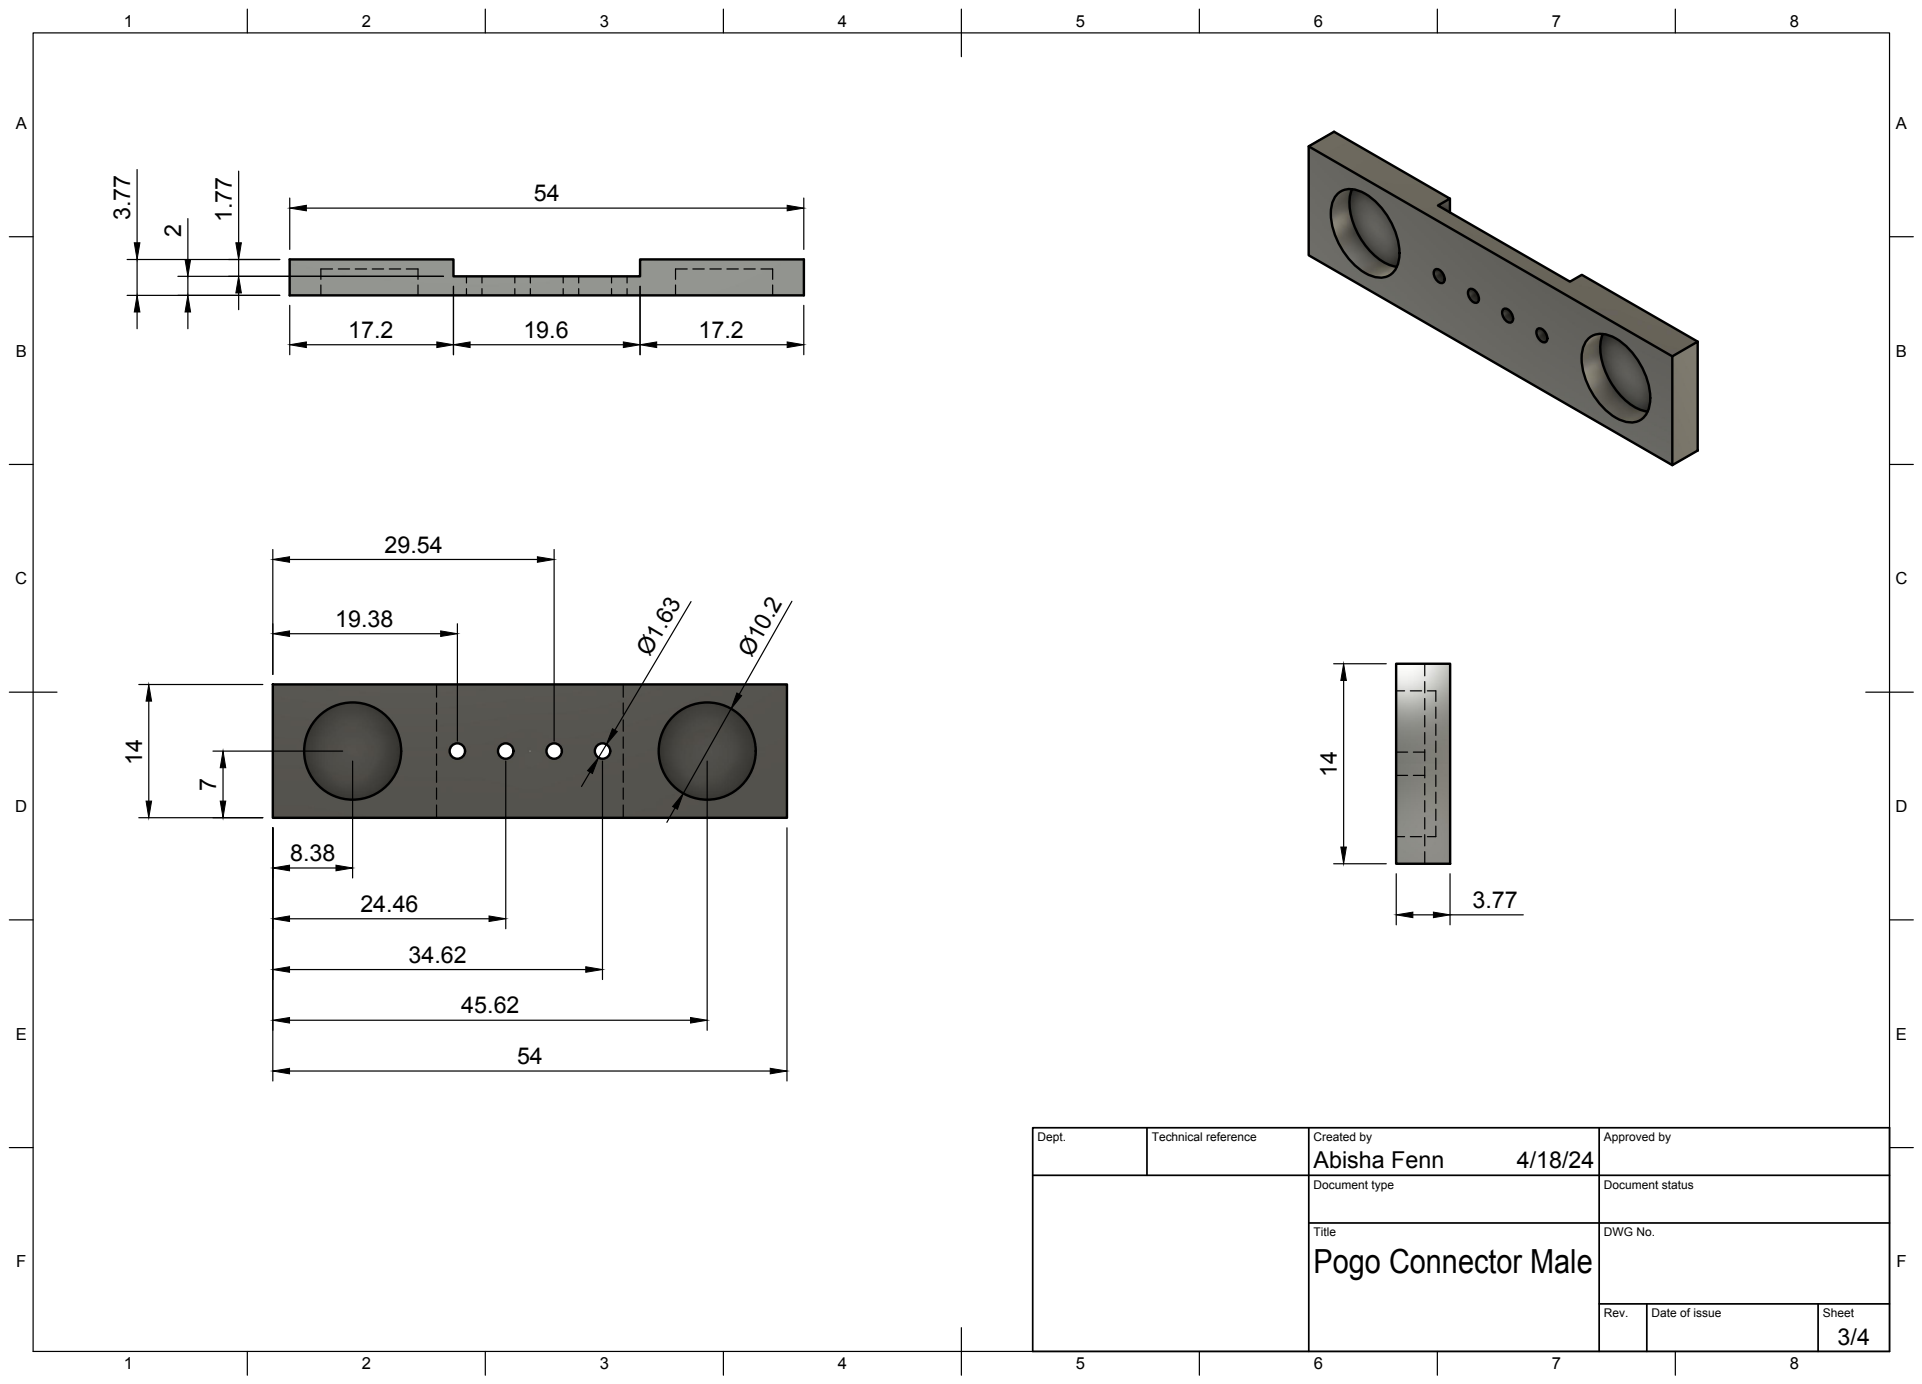
[picture p179: page 3]
Title; DWG No.

Dept. | Technical reference | Created by Abisha Fenn 4/18/24 | Approved by

Document type | Document status

Pogo Connector Male

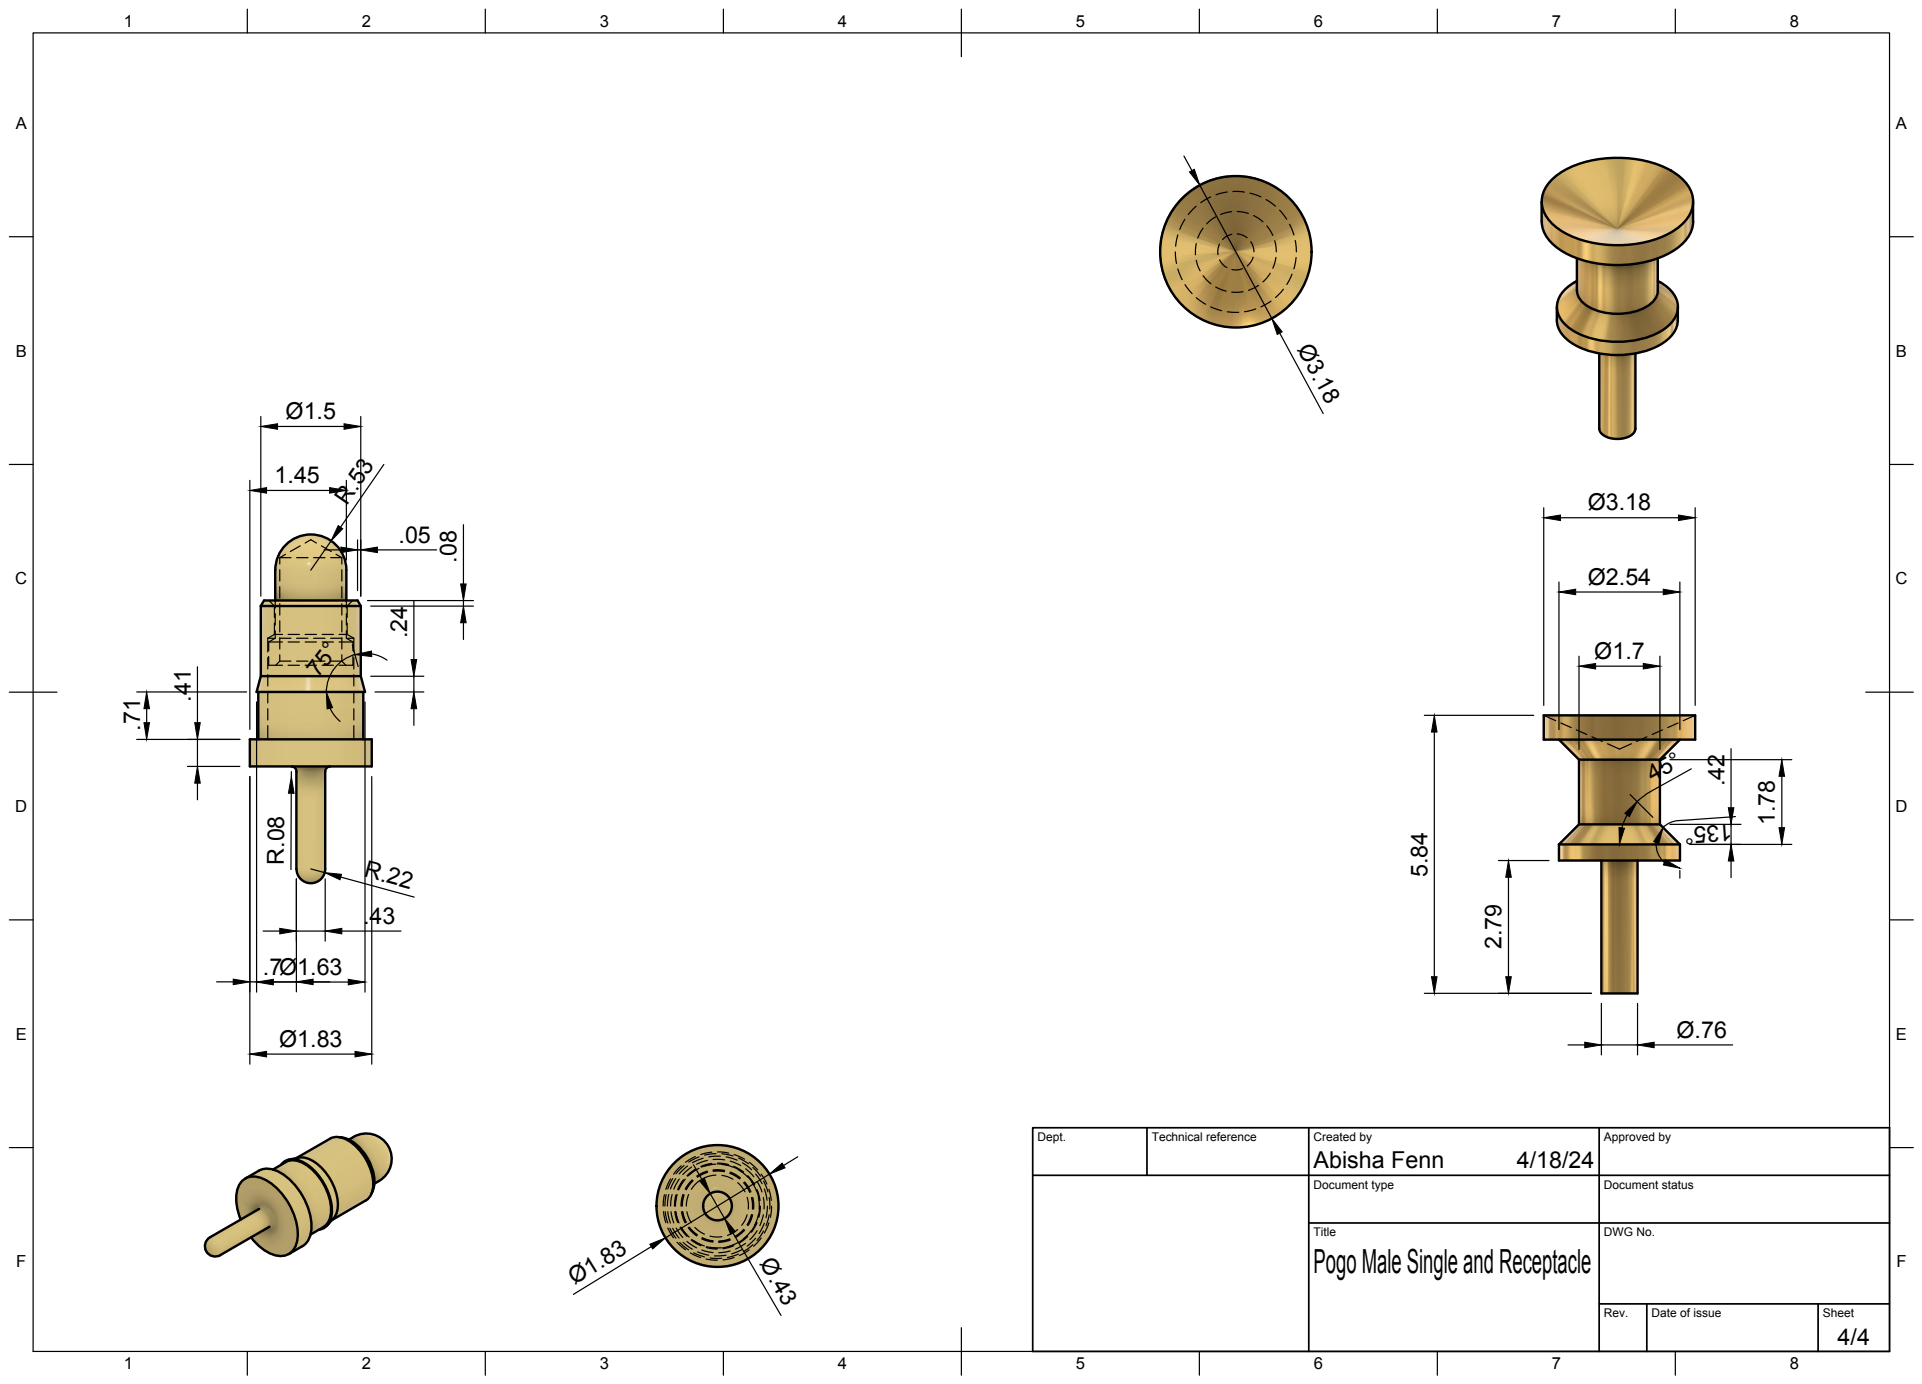
[picture p180: page 4]
Title; DWG No.

Dept. | Technical reference | Created by Abisha Fenn 4/18/24 | Approved by

Document type | Document status

Pogo Male Single and Receptacle
