ProtoControl/ProtoControl/38_ProtoControl_SD_Fall2023/UserDocumentation/EnclosureDrawings/RotaryEncoderEnclosureDrawings.pdf

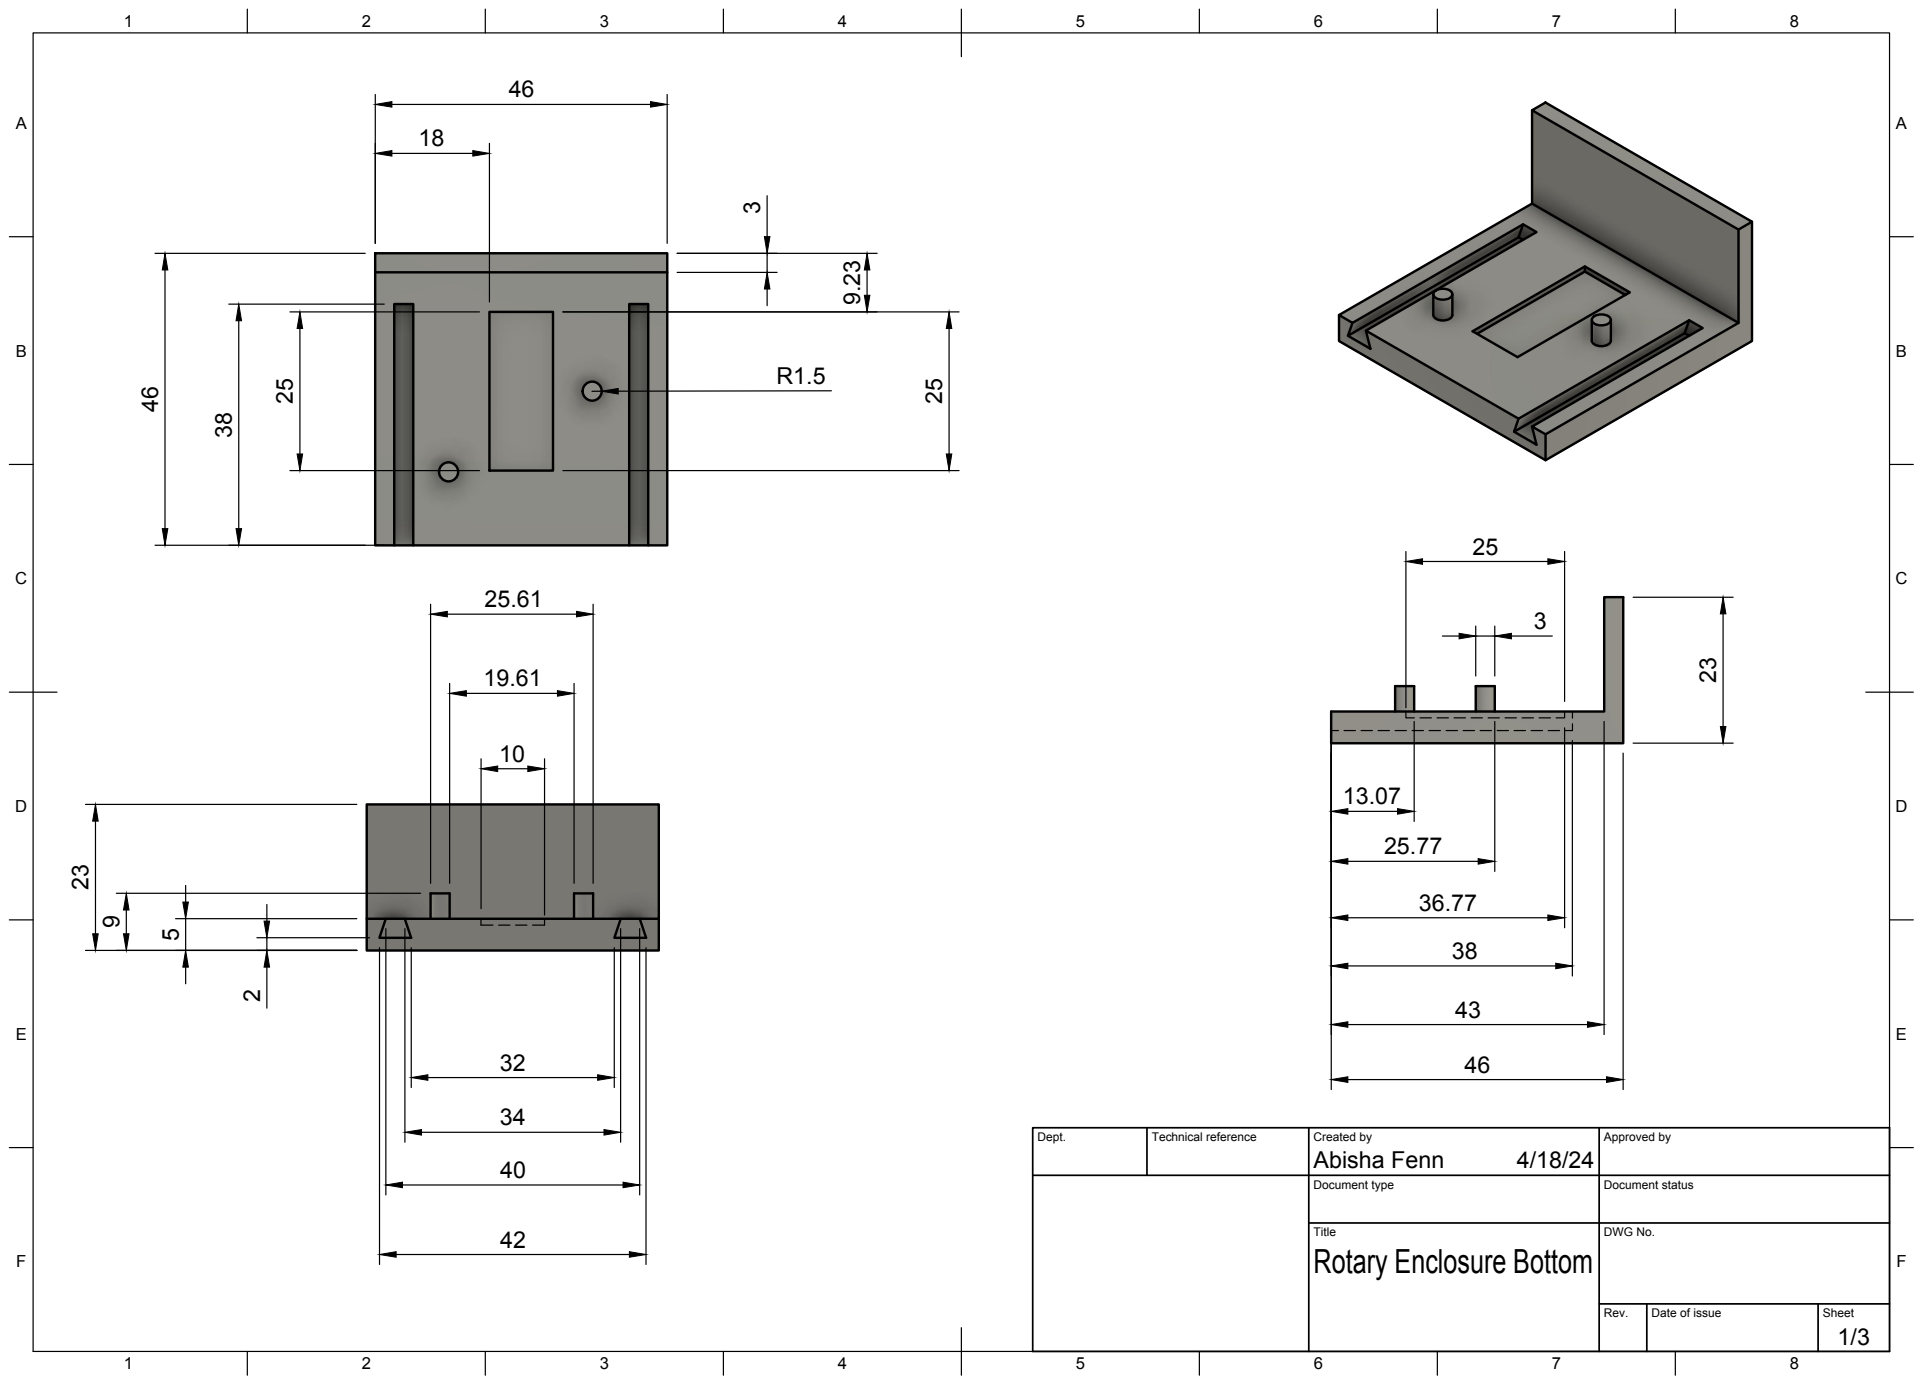
[picture p181: page 1]
Title; DWG No.; Rev.; Date of issue; Sheet

Dept. | Technical reference | Created by Abisha Fenn 4/18/24 | Approved by

Document type | Document status

Rotary Enclosure Bottom

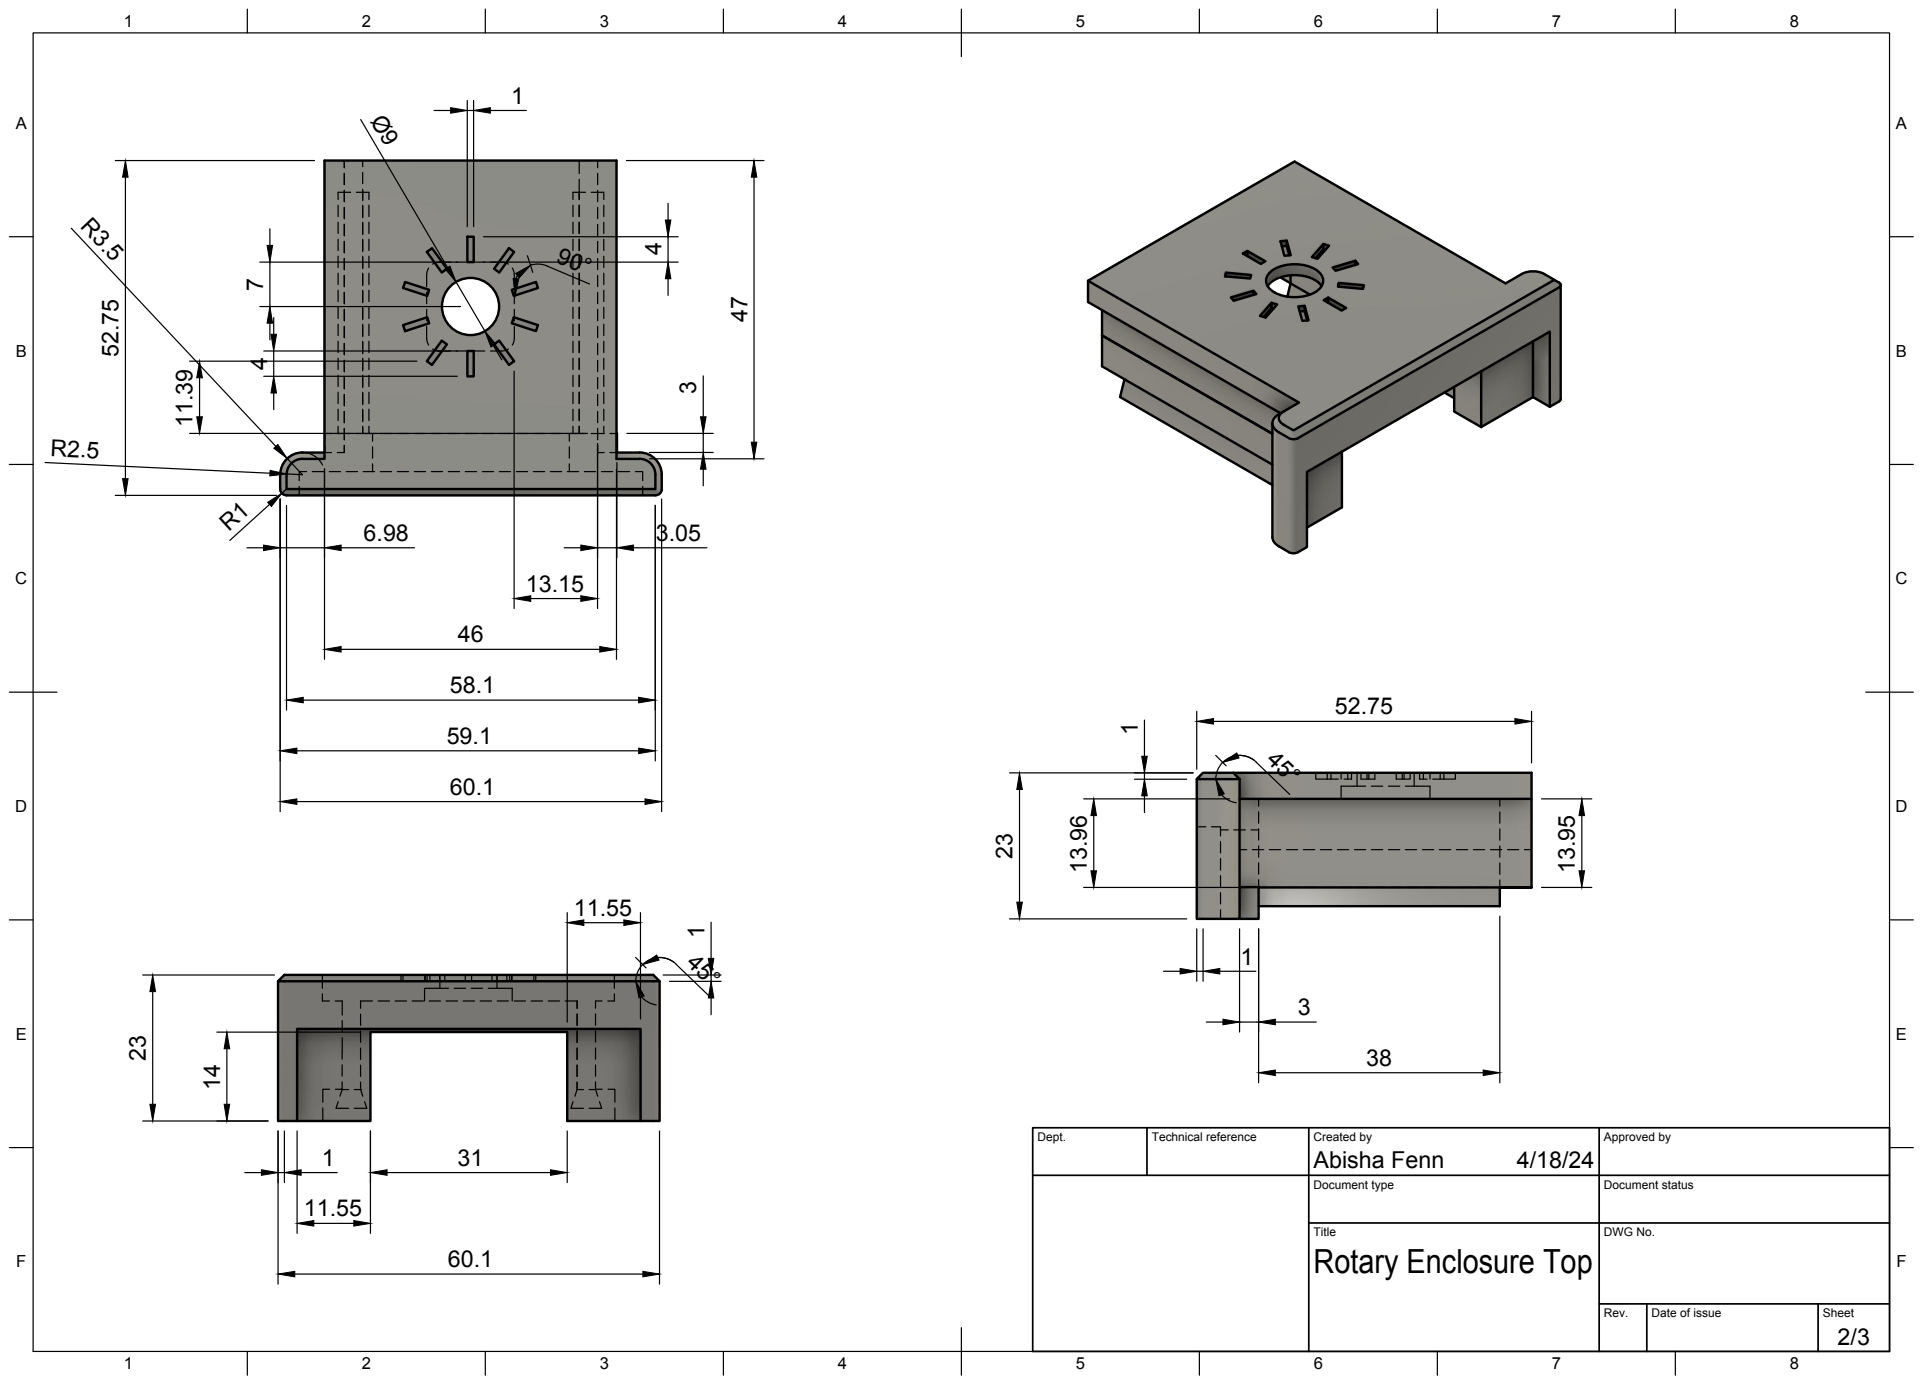
[picture p182: page 2]
Title; DWG No.

Dept. | Technical reference | Created by Abisha Fenn 4/18/24 | Approved by

Document type | Document status

Rotary Enclosure Top

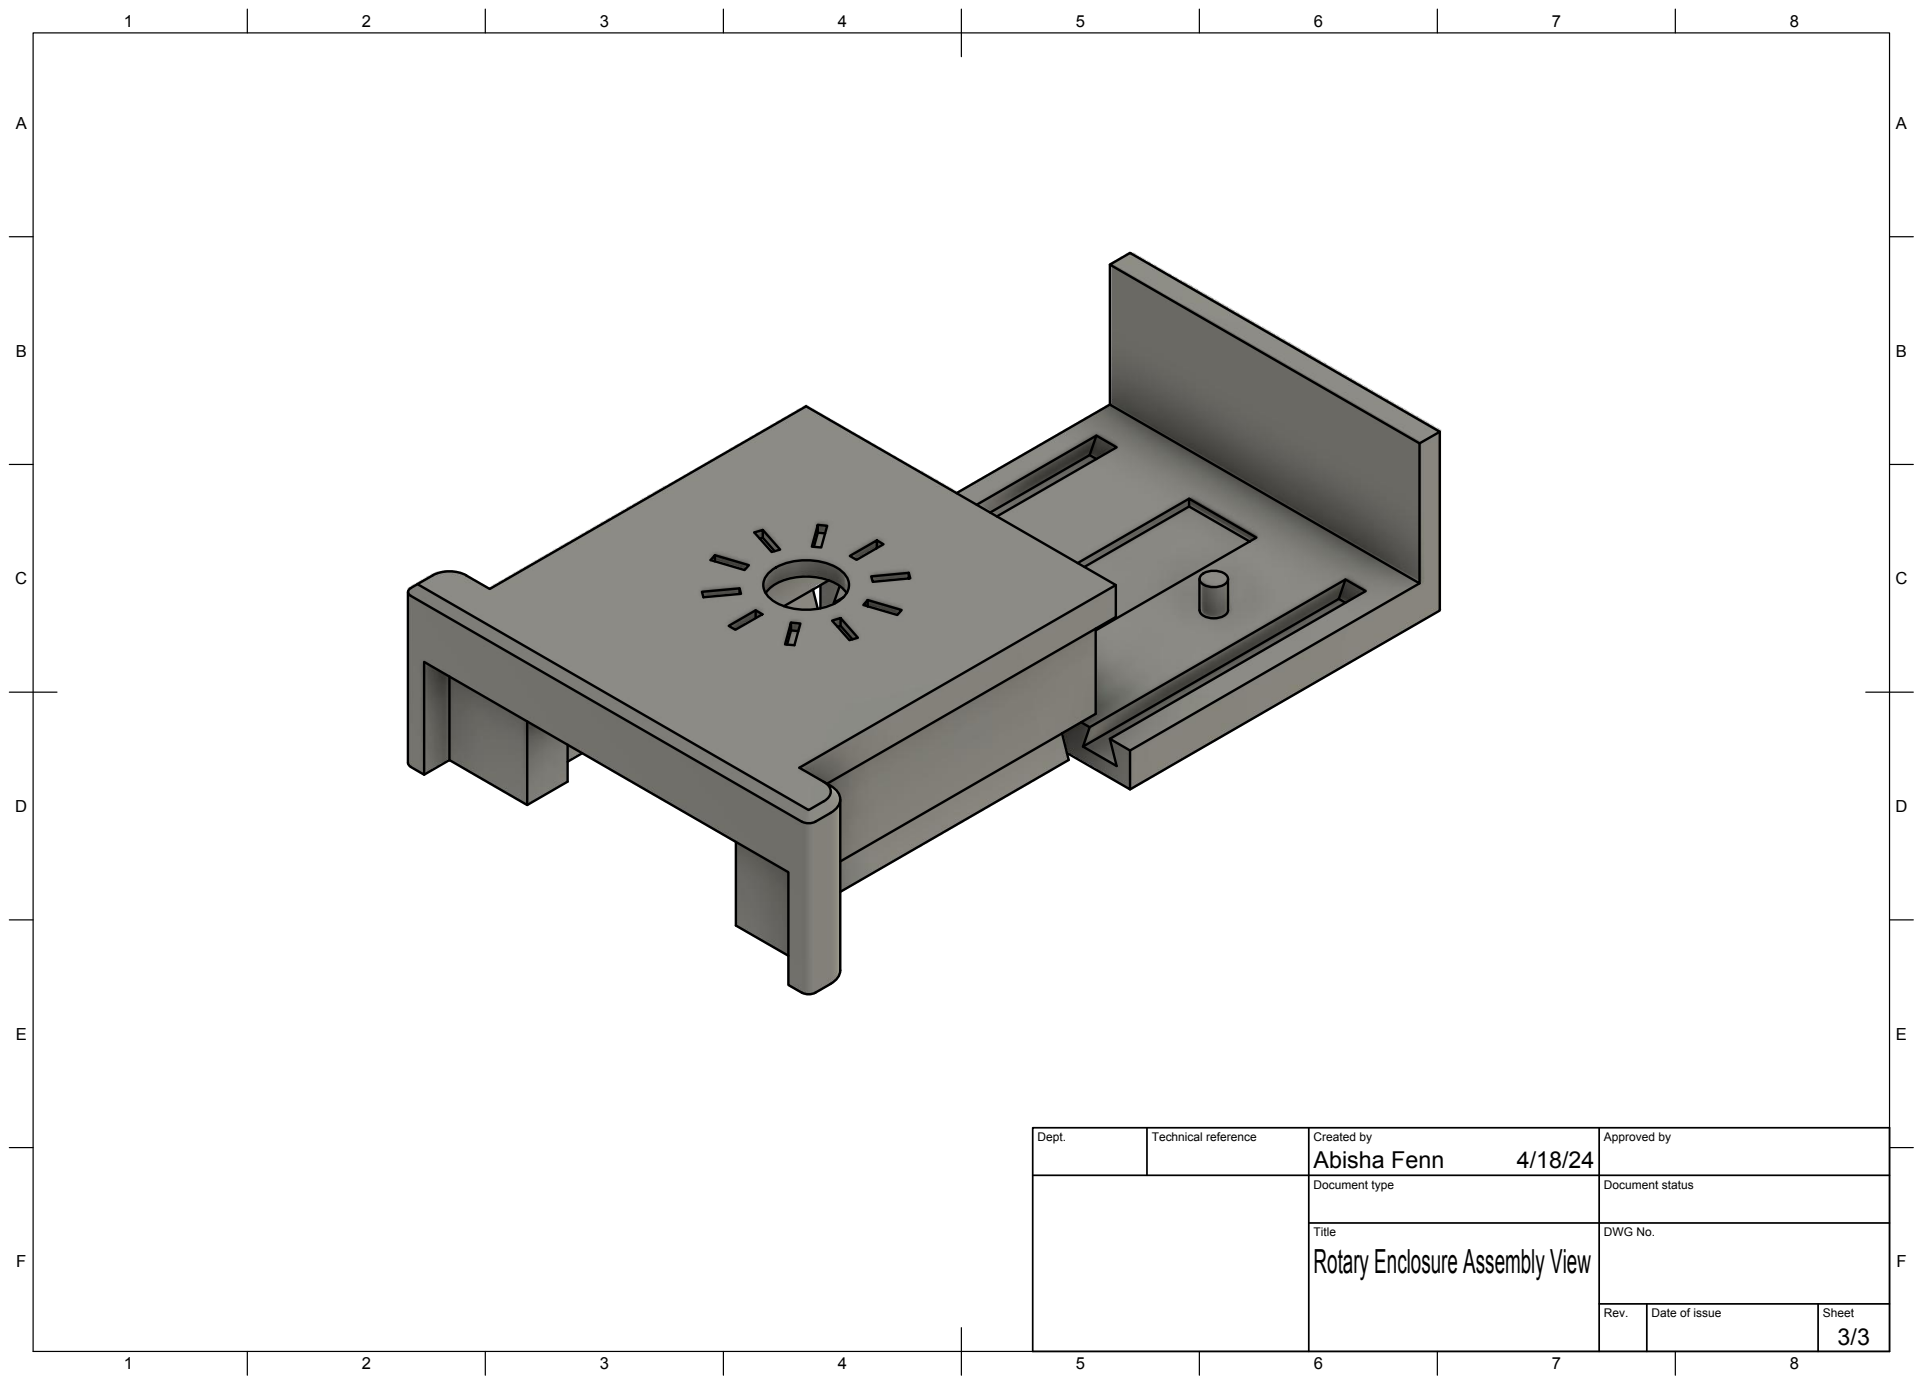
[picture p183: page 3]
Title; DWG No.

Dept. | Technical reference | Created by Abisha Fenn 4/18/24 | Approved by

Document type | Document status

Rotary Enclosure Assembly View
