ProtoControl/ProtoControl/38_ProtoControl_SD_Fall2023/Design Documents/YOLO_Training.pdf

# Sliders

# * Buttern

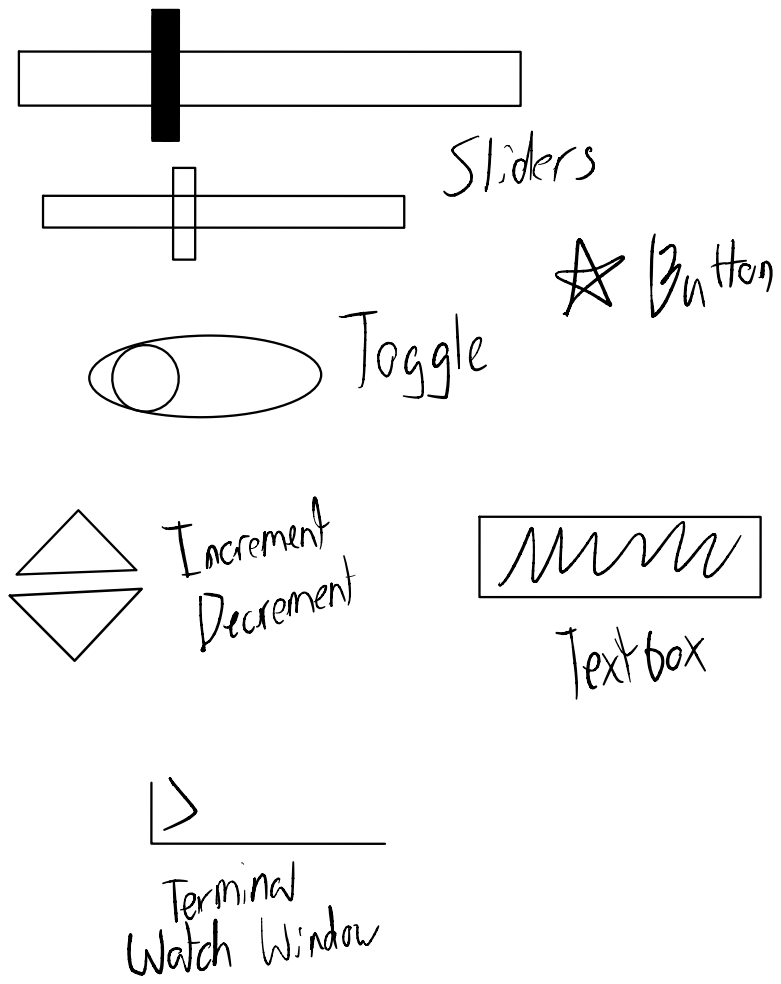
[picture p184: page 1]
Toggle; f-ncrement Decrement; m Textbox; > Terminal Watch Window

-100 drawings per component per person -Dark pen/pencil
-Plain white Background
-Enough space between components to be able to draw a bounding box around each component without overlapping boxes
