ProtoControl/ProtoControl/38_ProtoControl_SD_Fall2023/Design Documents/First Concept Diagrams/Preliminary Designs Parker.pdf

# Designs for ProtoControl

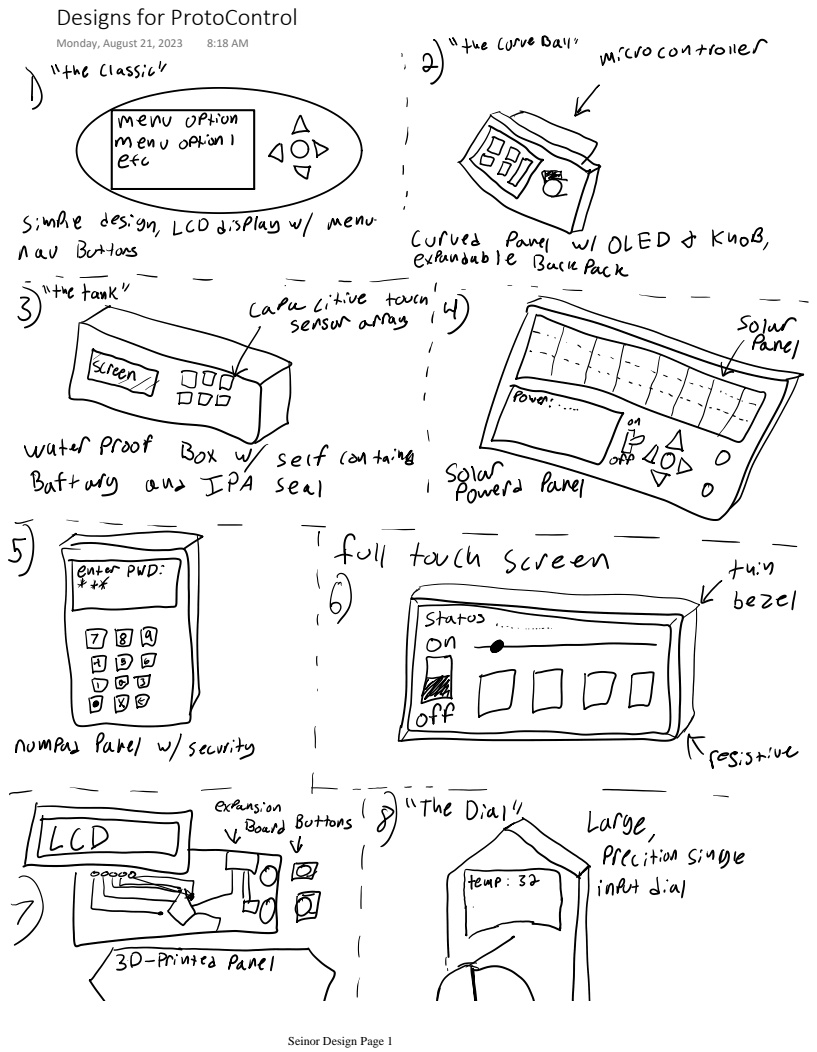
[picture p185: page 1]
Monday, August 21, 2023

Seinor Design Page 1

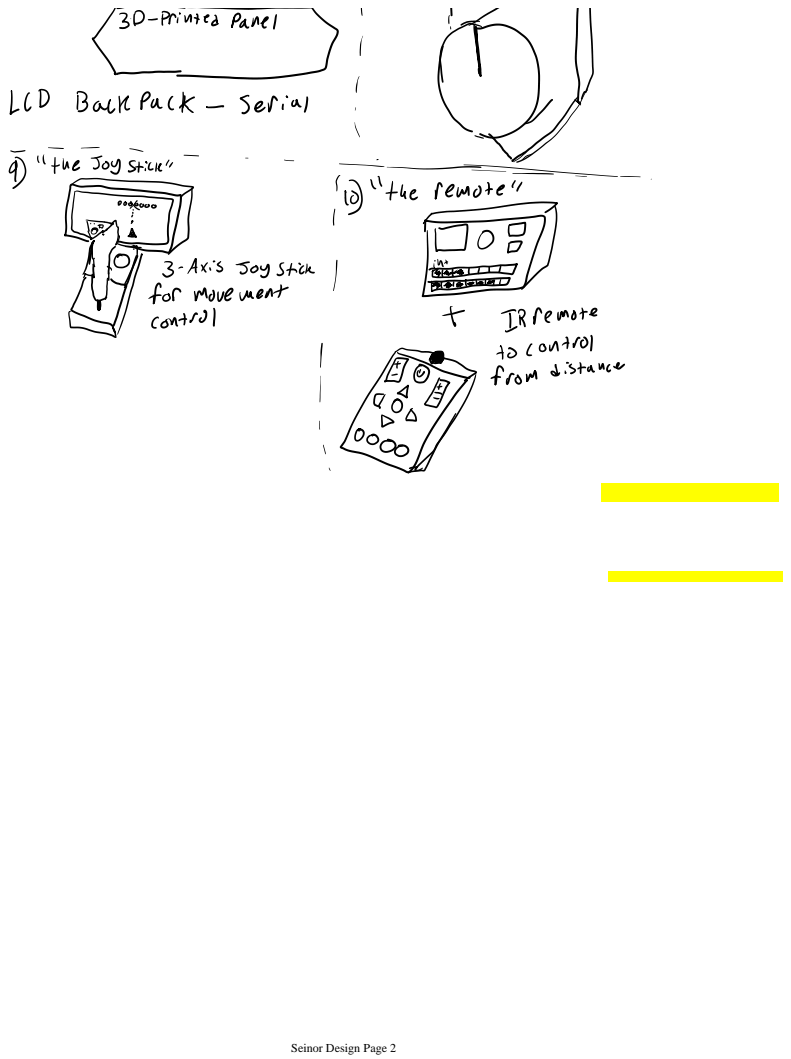
[picture p186: page 2]

Seinor Design Page 2
