ProtoControl/ProtoControl/38_ProtoControl_SD_Fall2023/Software Files/Training Photos/buttons .pdf

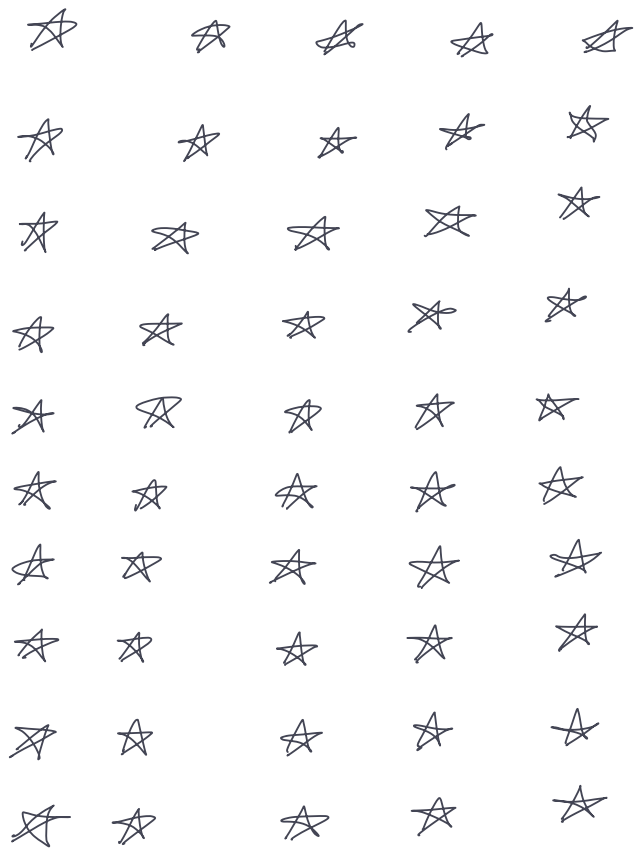
[picture p187: page 1]

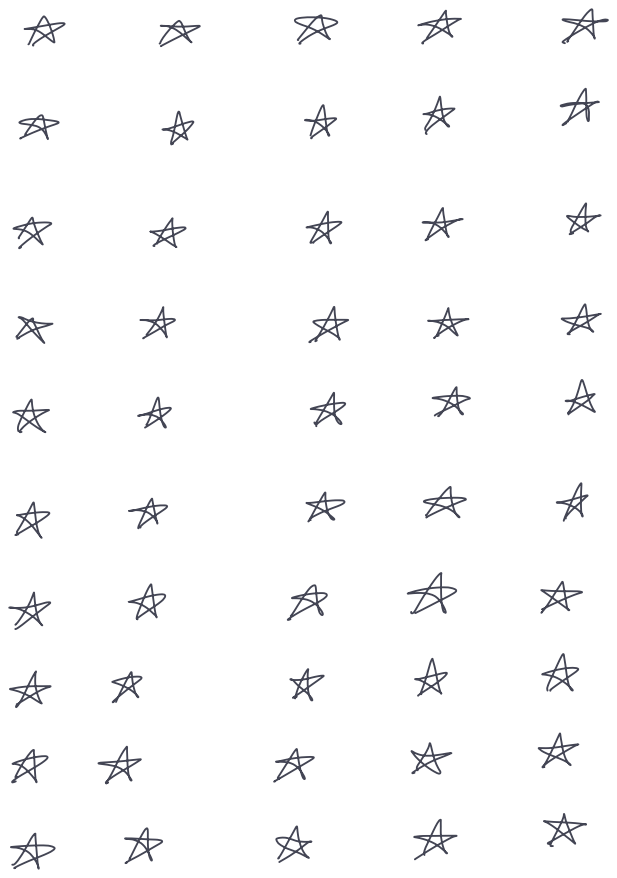
[picture p188: page 2]
AAA
