ProtoControl/ProtoControl/38_ProtoControl_SD_Fall2023/Software Files/Training Photos/increment _ decrement .pdf

E | EEE E | E
E

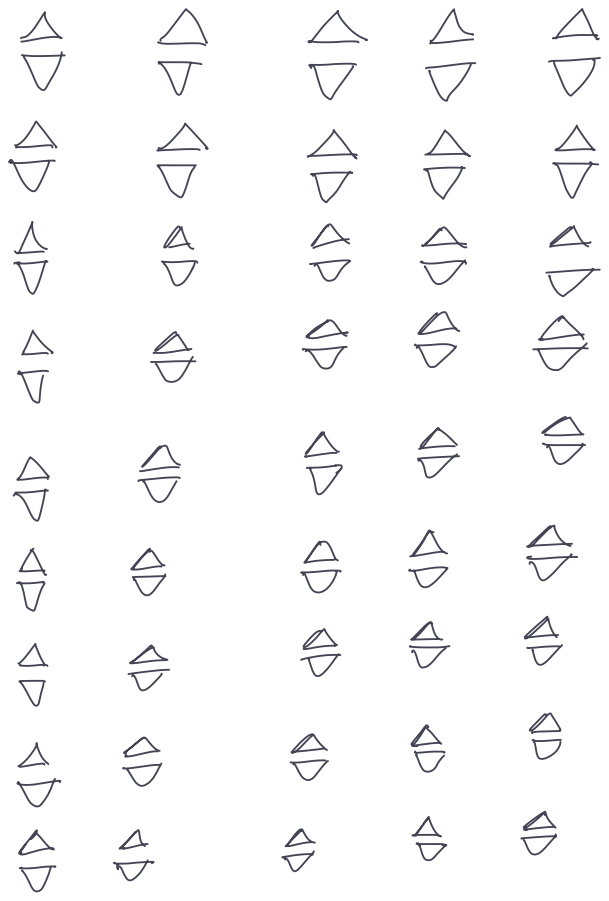
[picture p189: page 1]

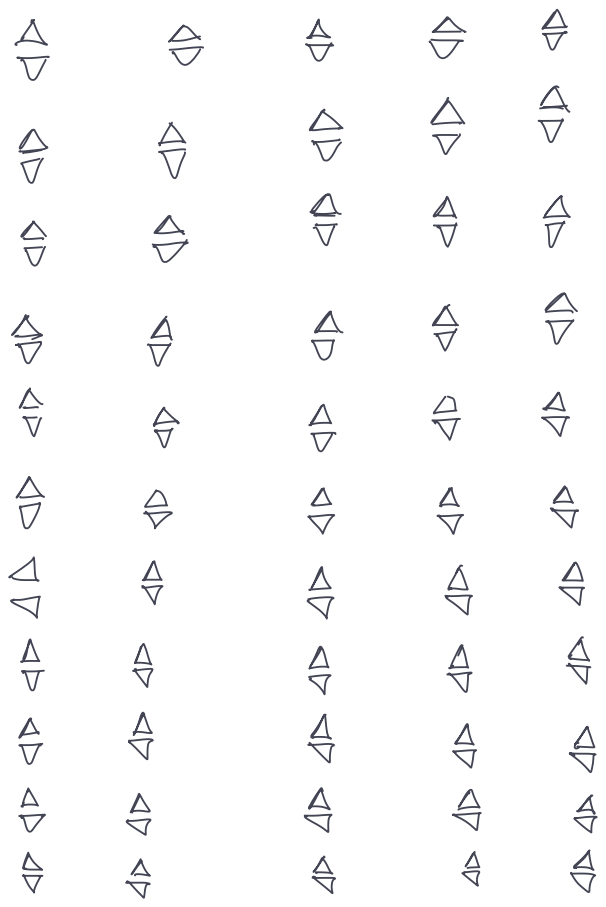
[picture p190: page 2]
