ProtoControl/ProtoControl/38_ProtoControl_SD_Fall2023/Software Files/Training Photos/sliders.pdf

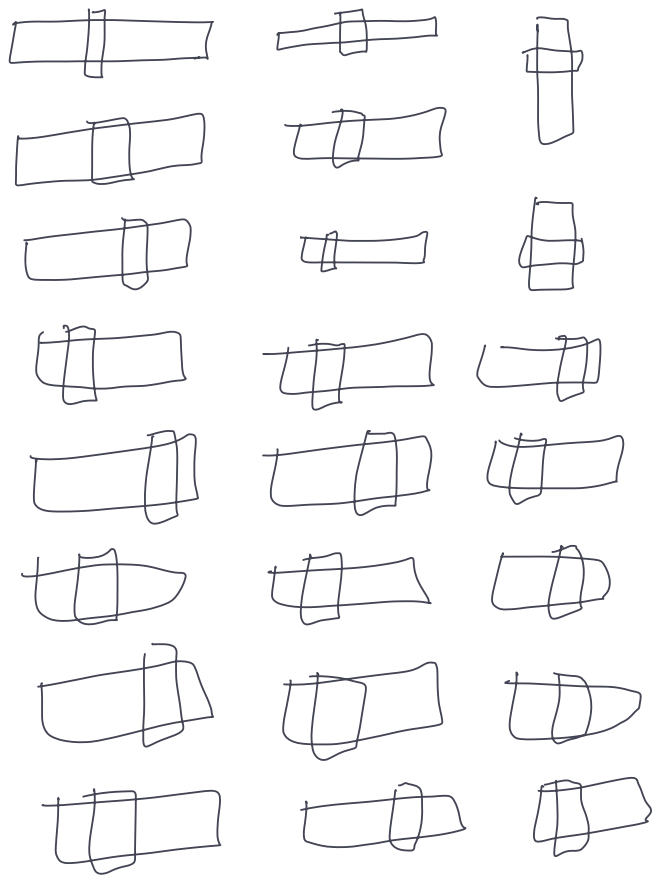
[picture p191: page 1]

100 A

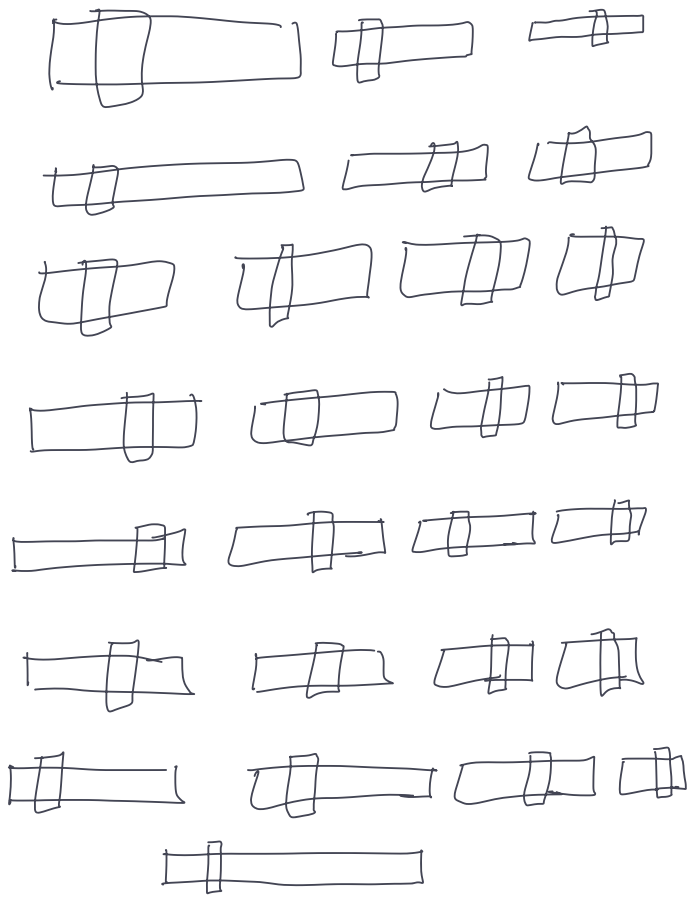
[picture p192: page 2]
FEED

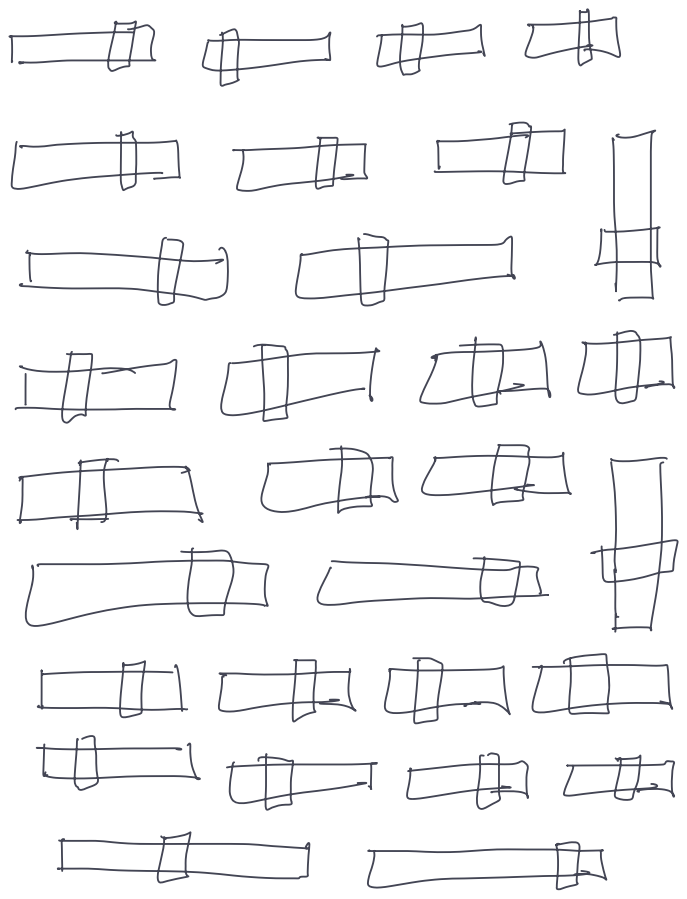
[picture p193: page 3]
III

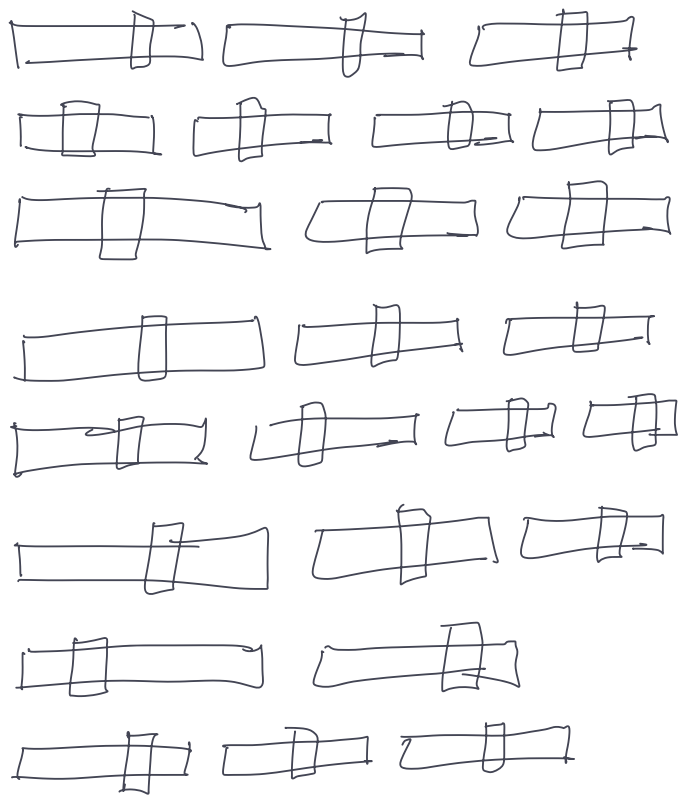
[picture p194: page 4]
