ProtoControl/ProtoControl/38_ProtoControl_SD_Fall2023/Software Files/Training Photos/terminal watch window .pdf

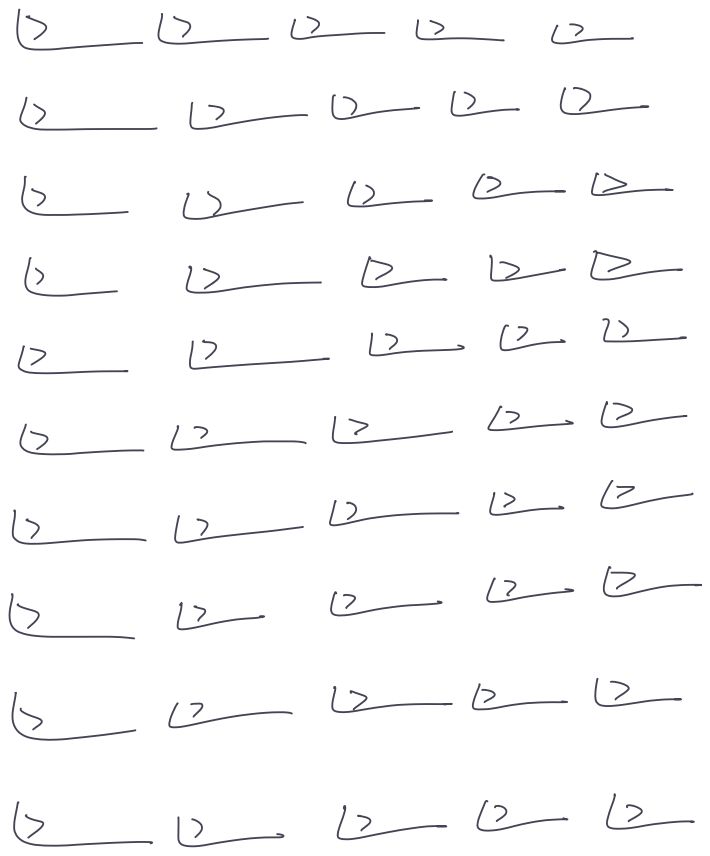
[picture p195: page 1]
een; ane; see; meee nee; hee; hence

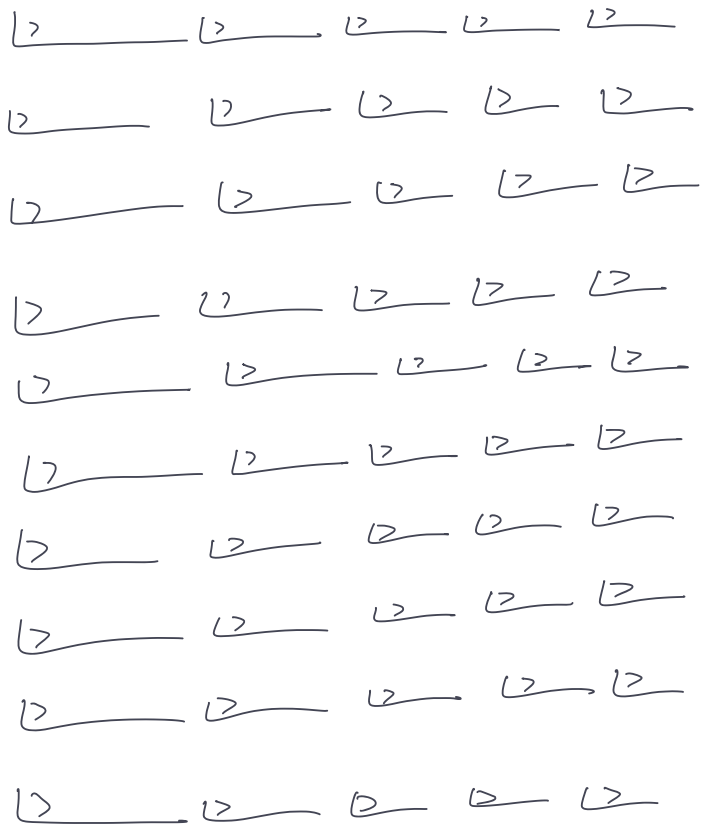
[picture p196: page 2]
nee; EEE
