ProtoControl/ProtoControl/38_ProtoControl_SD_Fall2023/Software Files/Training Photos/textbox.pdf

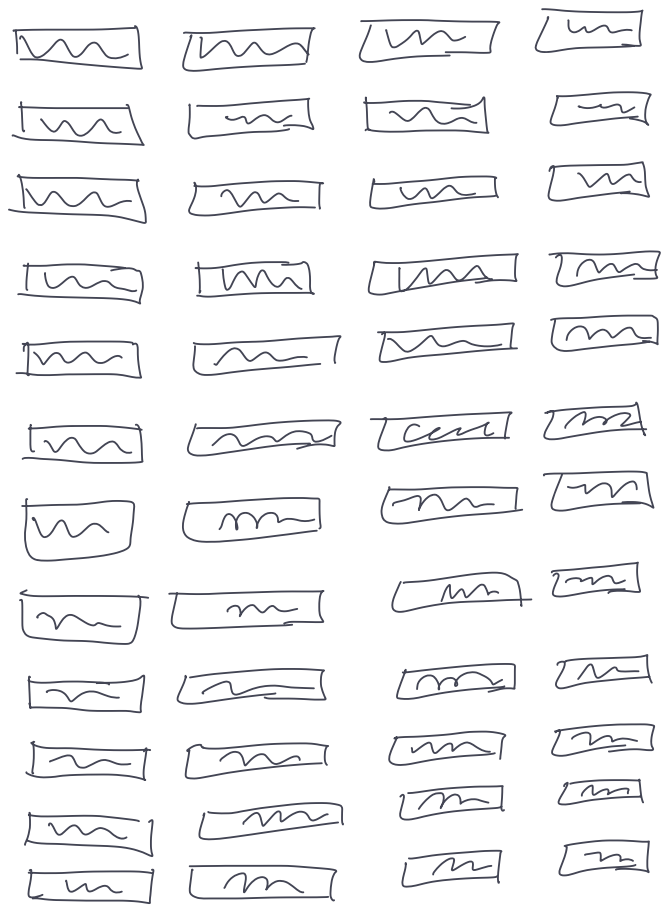
[picture p197: page 1]
Eth

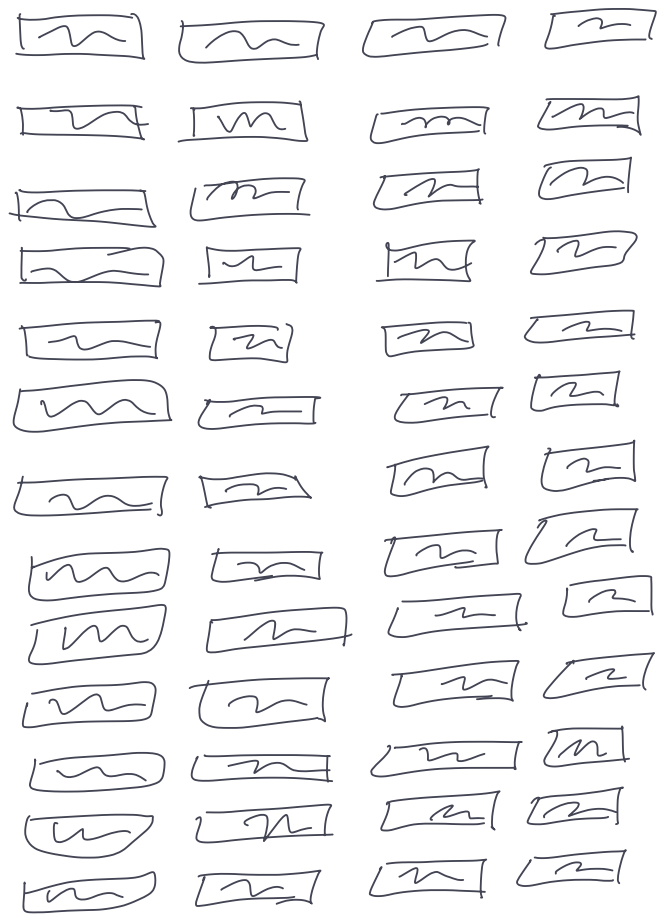
[picture p198: page 2]
INI; Este I; EET; LIFE
