ProtoControl/ProtoControl/38_ProtoControl_SD_Fall2023/Software Files/Training Photos/toggle.pdf

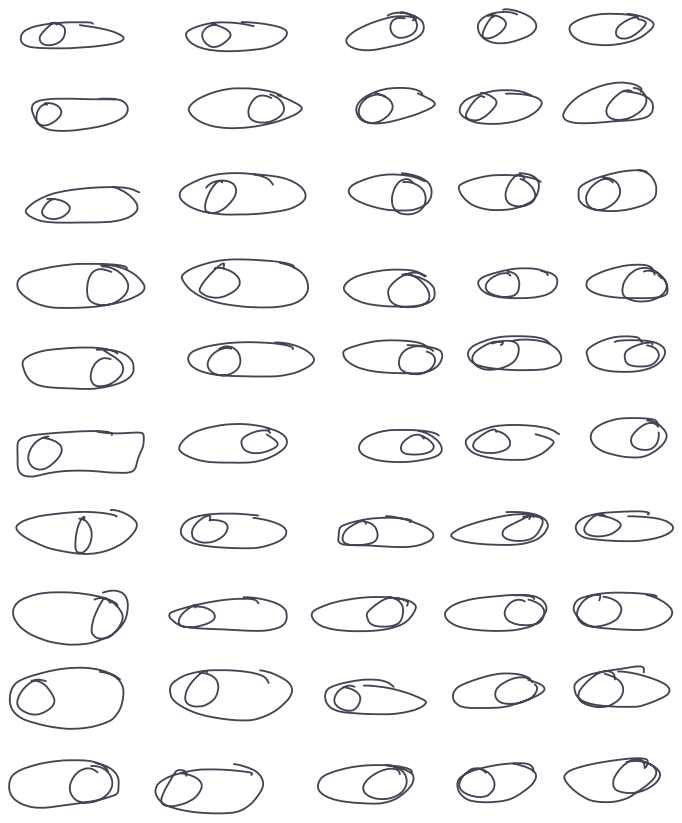
[picture p199: page 1]

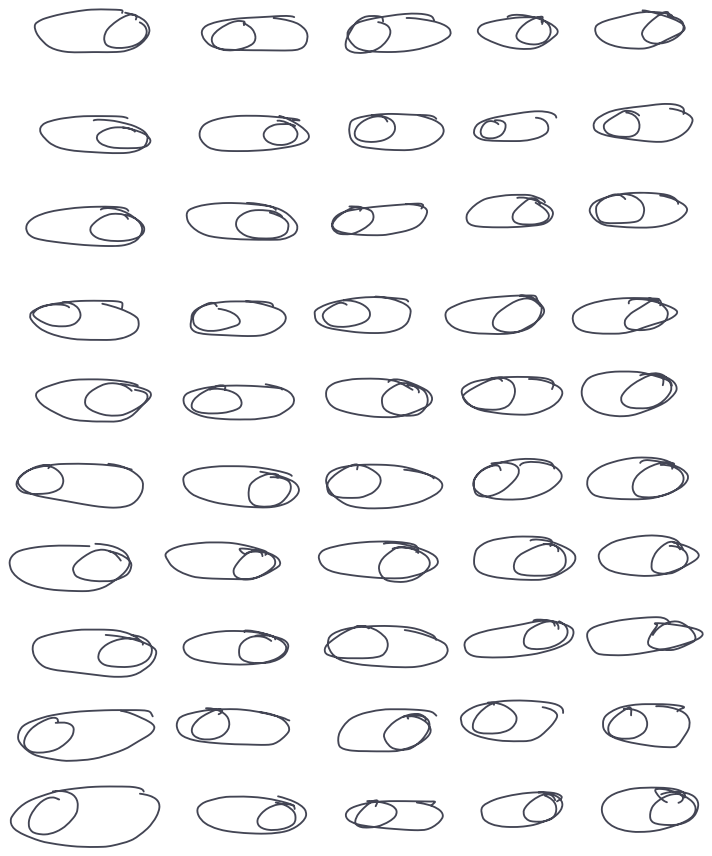
[picture p200: page 2]
