ProtoControl/ProtoControl/38_ProtoControl_SD_Fall2023/UserDocumentation/EnclosureDrawings/JoystickEnclosure.pdf

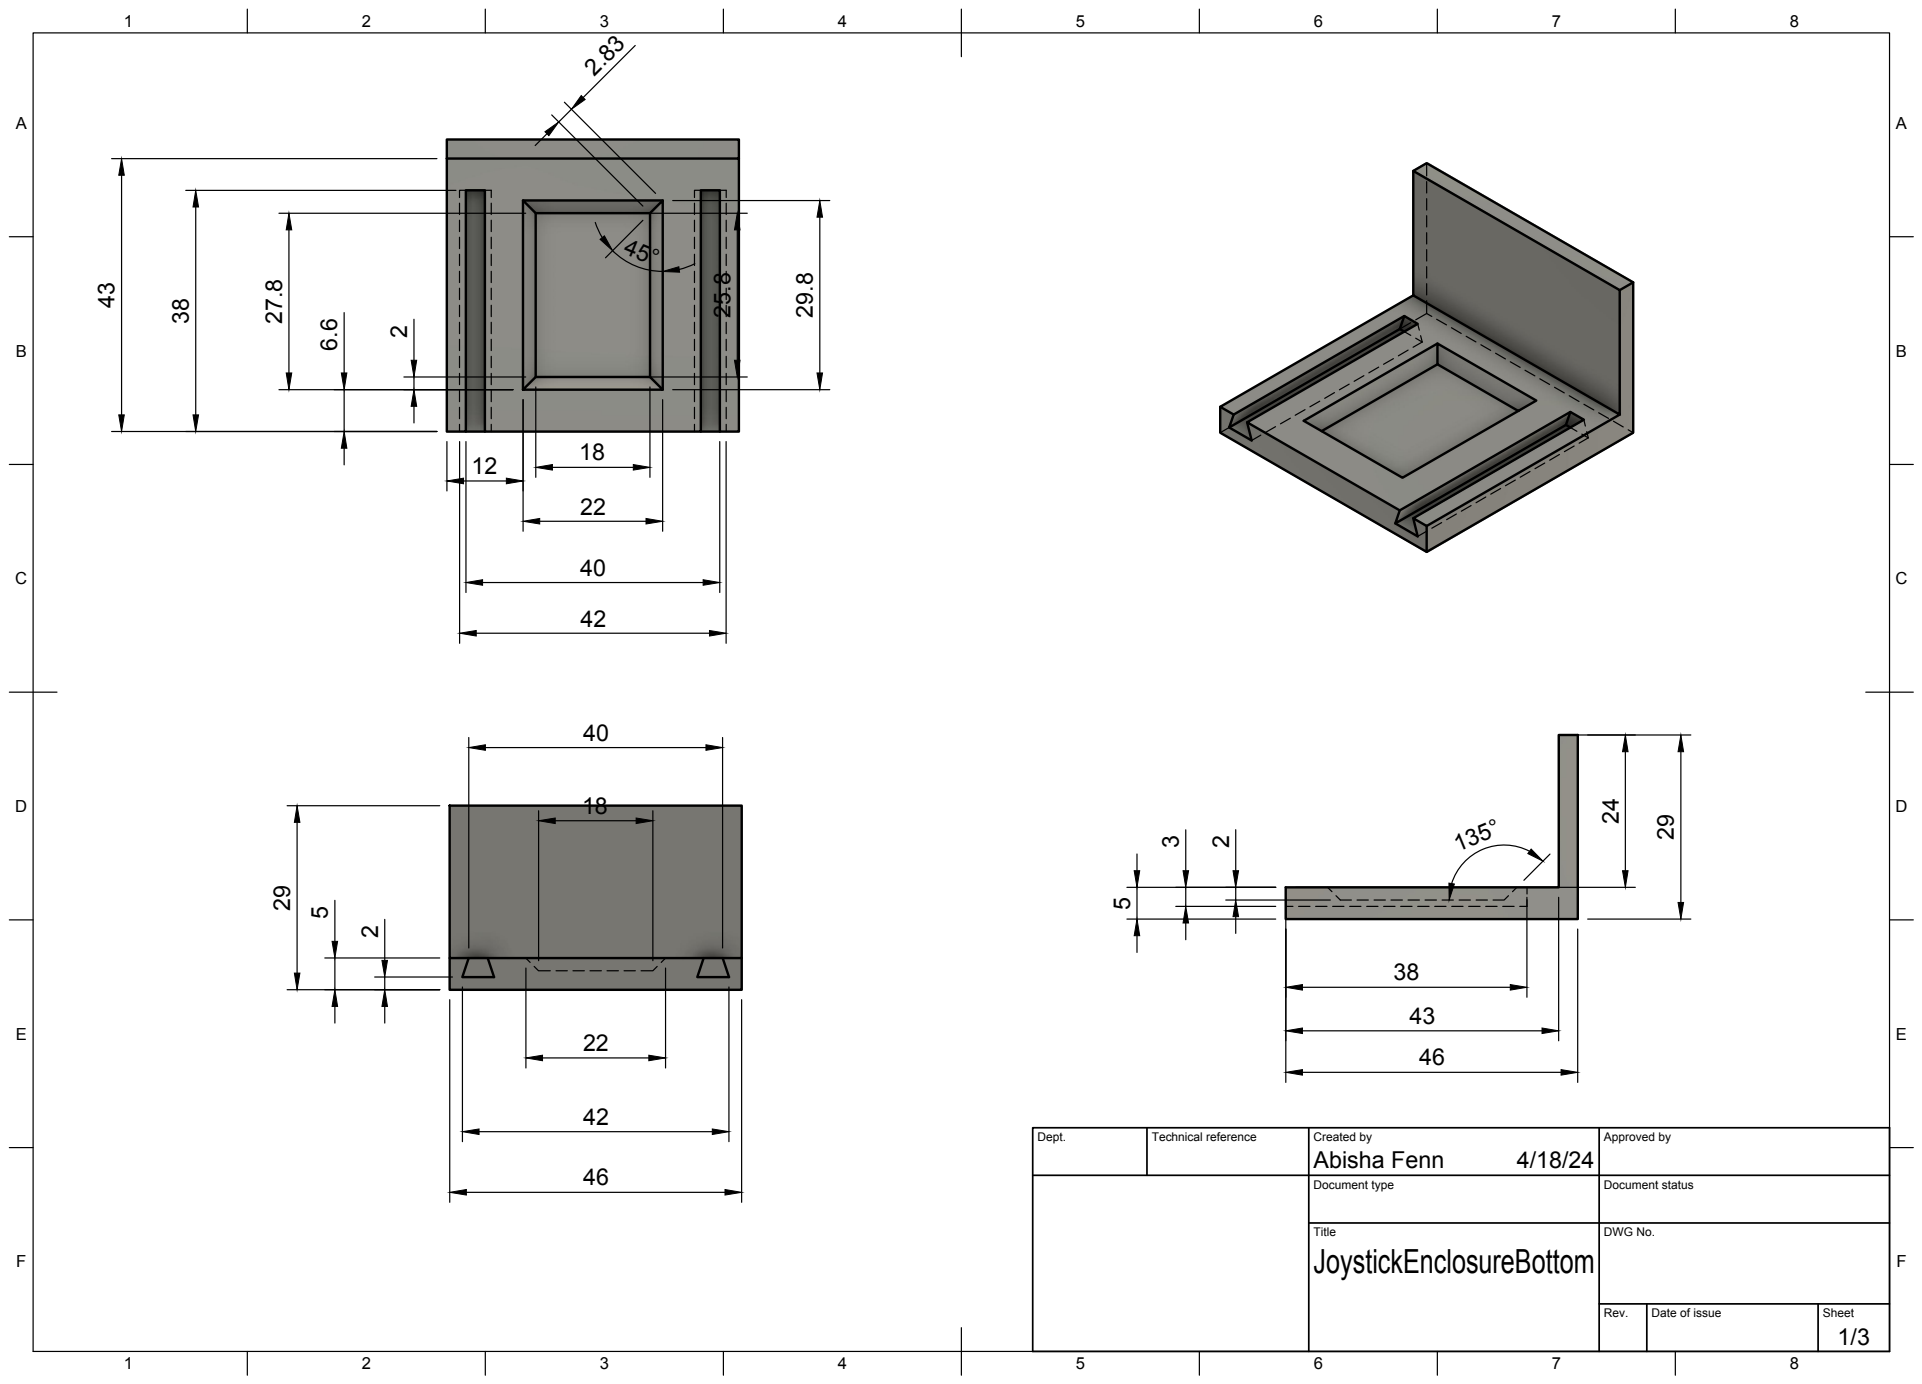
[picture p201: page 1]
Title; DWG No.; Rev.; Date of issue; Sheet

Dept. | Technical reference | Created by Abisha Fenn 4/18/24 | Approved by

Document type | Document status

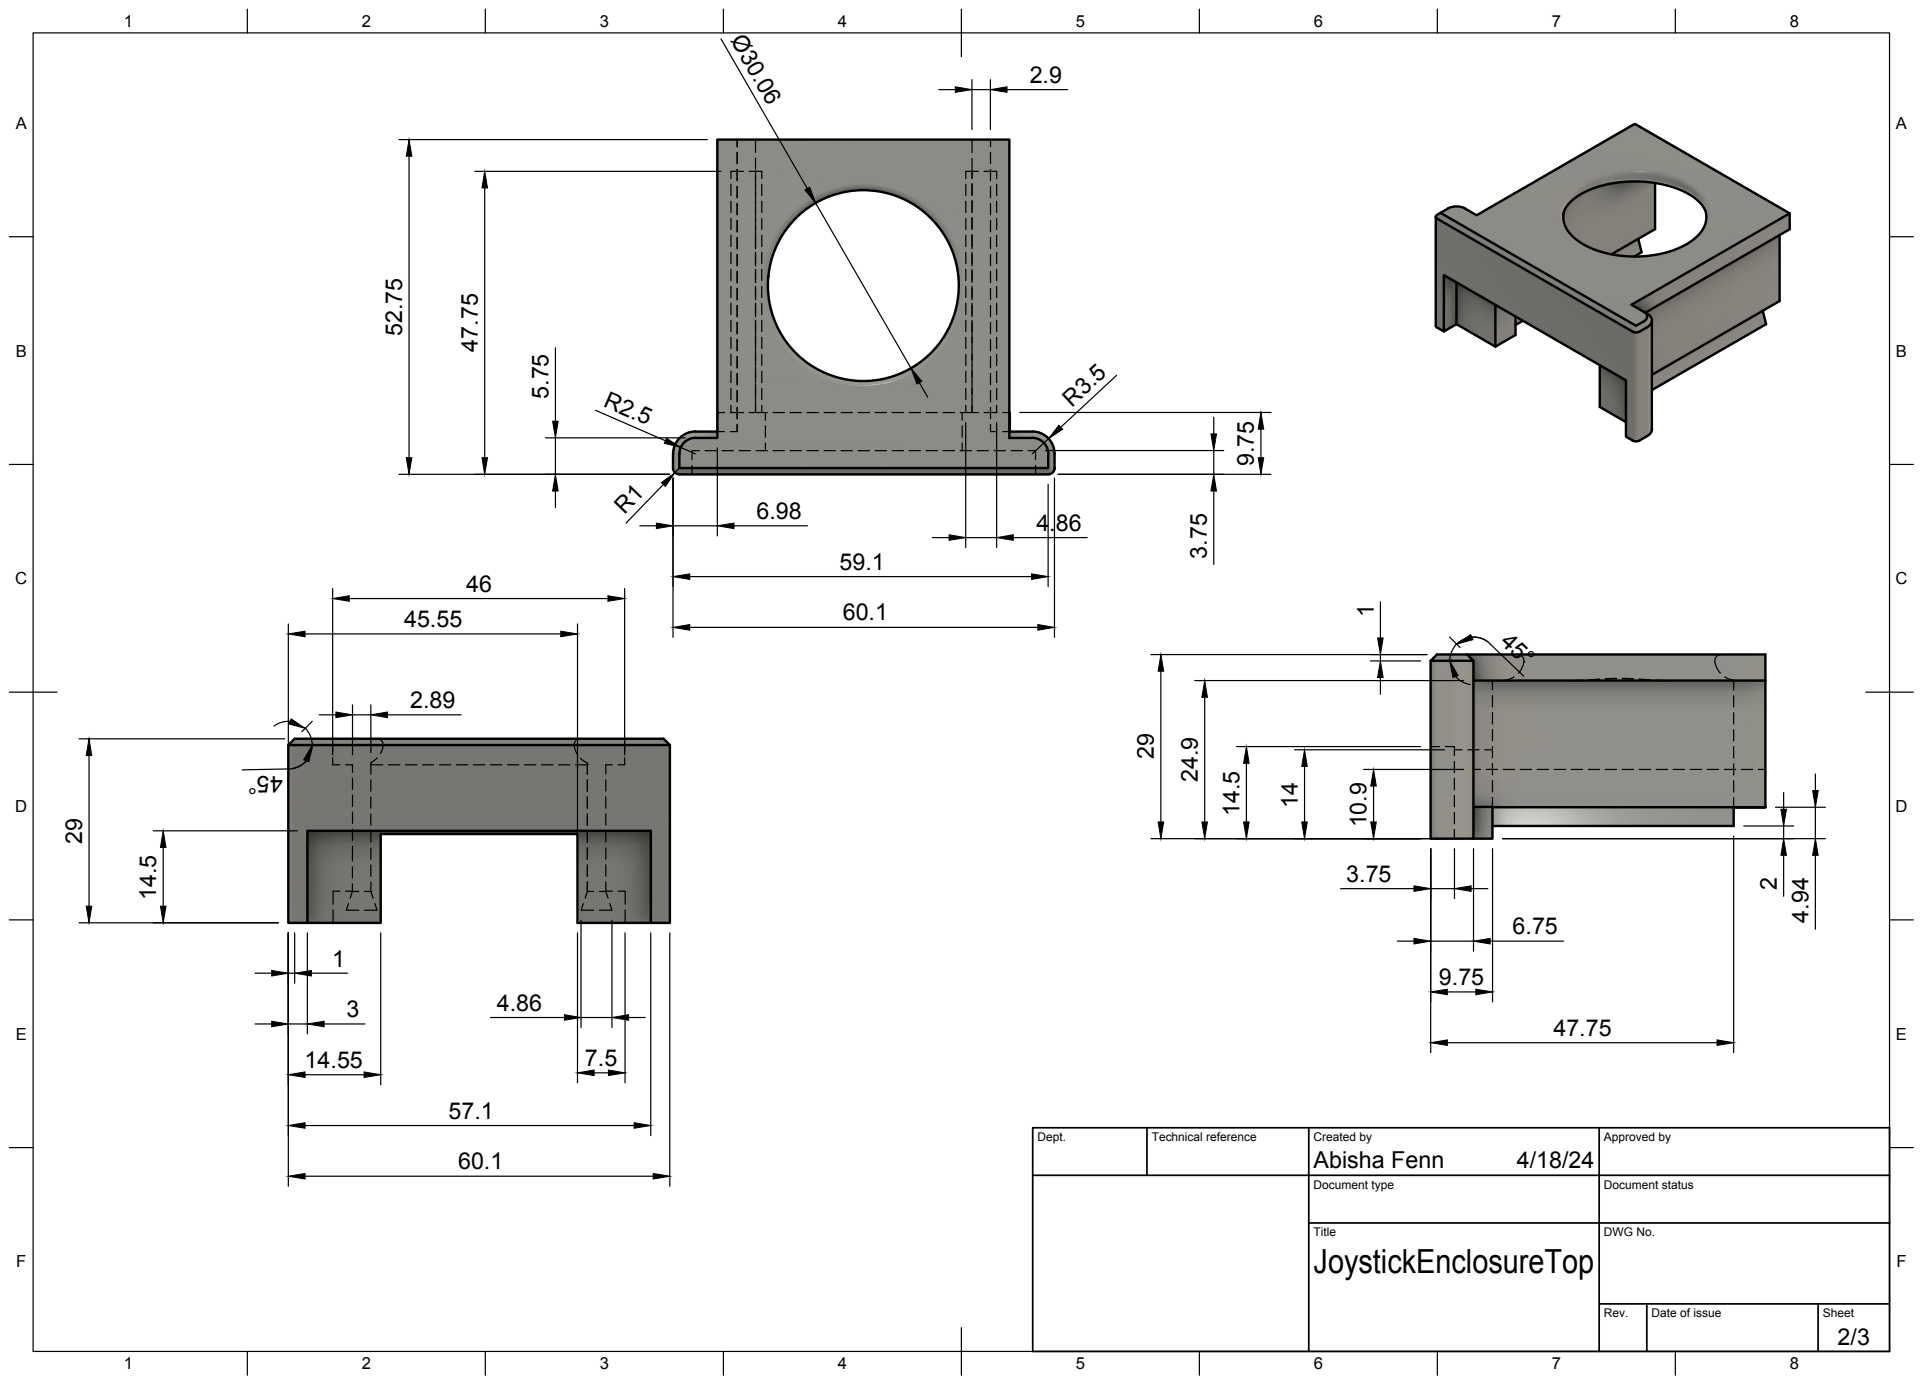
[picture p202: page 2]
8 BCDEF; ABCDEF; Title; DWG No.; Abisha Fenn 1

Dept. | Technical reference | Created by 4/18/24 | Approved by

Document type | Document status

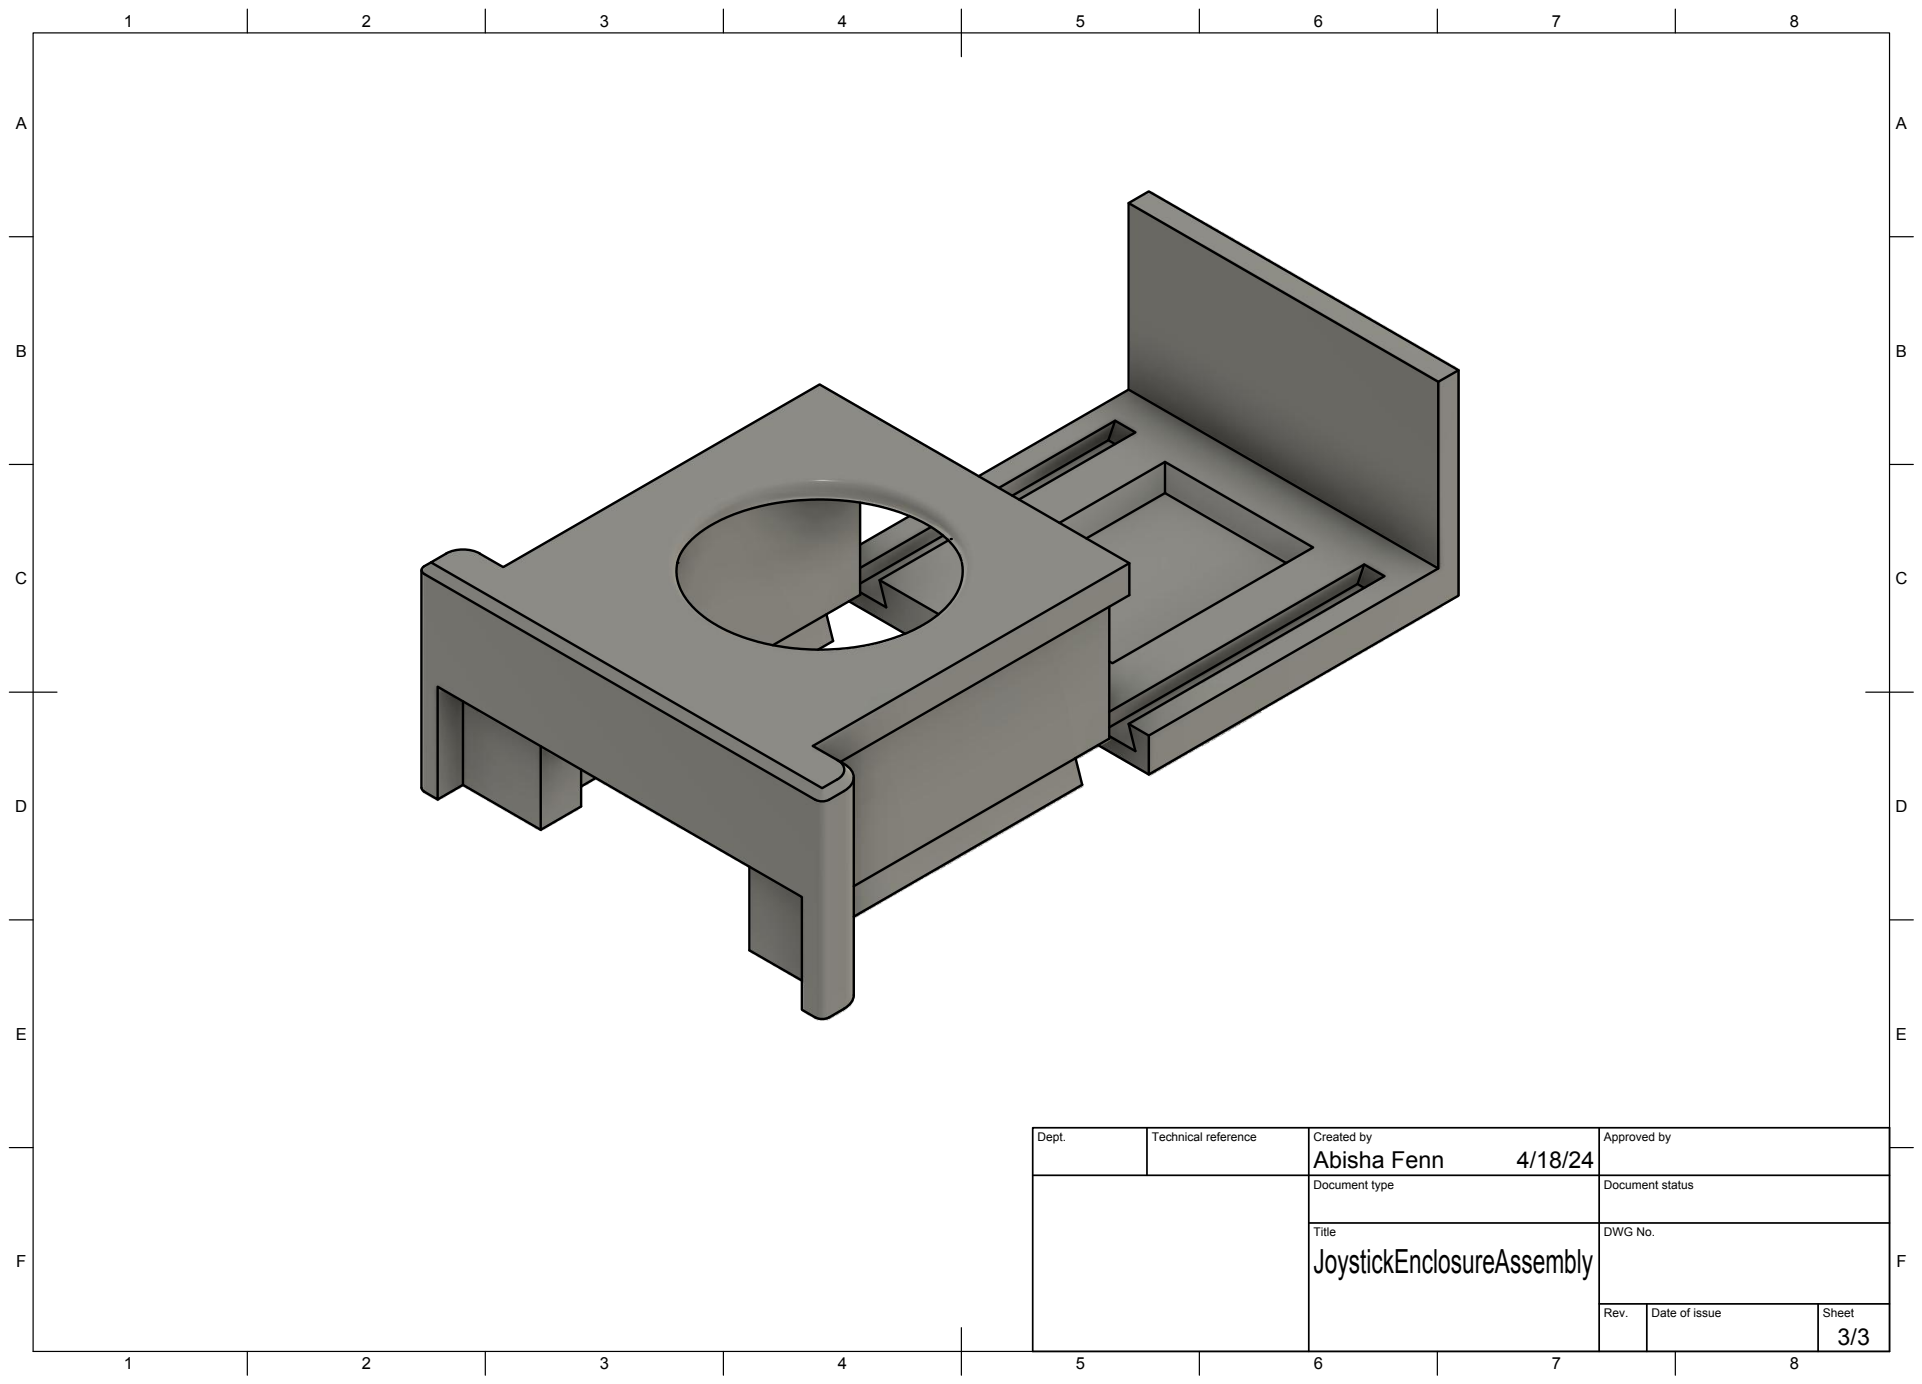
[picture p203: page 3]
Title; DWG No.

Dept. | Technical reference | Created by Abisha Fenn 4/18/24 | Approved by

Document type | Document status
