ProtoControl/ProtoControl/38_ProtoControl_SD_Fall2023/Hardware Files/Schematic_PCB_CAD Files/ProtoControl Ptype_spice.cir

ProtoControl Ptype

.TRAN 1ms 100ms
* .AC DEC 100 100 1MEG
.END
