ProtoControl/ProtoControl/38-Protocontrol-main/SEM 2/ARM_DEMO/ARM_DEMO.ino

#include <Arduino.h>
#include <HardwareSerial.h>


#define GET_LOW_BYTE(A) (uint8_t)((A))
//Macro function  get lower 8 bits of A
#define GET_HIGH_BYTE(A) (uint8_t)((A) >> 8)
//Macro function  get higher 8 bits of A
#define BYTE_TO_HW(A, B) ((((uint16_t)(A)) << 8) | (uint8_t)(B))


#define LOBOT_SERVO_FRAME_HEADER         0x55
#define LOBOT_SERVO_MOVE_TIME_WRITE      1
#define LOBOT_SERVO_MOVE_TIME_READ       2
#define LOBOT_SERVO_MOVE_TIME_WAIT_WRITE 7
#define LOBOT_SERVO_MOVE_TIME_WAIT_READ  8
#define LOBOT_SERVO_MOVE_START           11
#define LOBOT_SERVO_MOVE_STOP            12
#define LOBOT_SERVO_ID_WRITE             13
#define LOBOT_SERVO_ID_READ              14
#define LOBOT_SERVO_ANGLE_OFFSET_ADJUST  17
#define LOBOT_SERVO_ANGLE_OFFSET_WRITE   18
#define LOBOT_SERVO_ANGLE_OFFSET_READ    19
#define LOBOT_SERVO_ANGLE_LIMIT_WRITE    20
#define LOBOT_SERVO_ANGLE_LIMIT_READ     21
#define LOBOT_SERVO_VIN_LIMIT_WRITE      22
#define LOBOT_SERVO_VIN_LIMIT_READ       23
#define LOBOT_SERVO_TEMP_MAX_LIMIT_WRITE 24
#define LOBOT_SERVO_TEMP_MAX_LIMIT_READ  25
#define LOBOT_SERVO_TEMP_READ            26
#define LOBOT_SERVO_VIN_READ             27
#define LOBOT_SERVO_POS_READ             28
#define LOBOT_SERVO_OR_MOTOR_MODE_WRITE  29
#define LOBOT_SERVO_OR_MOTOR_MODE_READ   30
#define LOBOT_SERVO_LOAD_OR_UNLOAD_WRITE 31
#define LOBOT_SERVO_LOAD_OR_UNLOAD_READ  32
#define LOBOT_SERVO_LED_CTRL_WRITE       33
#define LOBOT_SERVO_LED_CTRL_READ        34
#define LOBOT_SERVO_LED_ERROR_WRITE      35
#define LOBOT_SERVO_LED_ERROR_READ       36

#define ID1   1 // Servo ID
#define POT_PIN A0 // Potentiometer connected to this pin
byte LobotCheckSum(byte buf[])
{
  byte i;
  uint16_t temp = 0;
  for (i = 2; i < buf[3] + 2; i++) {
    temp += buf[i];
  }
  temp = ~temp;
  i = (byte)temp;
  return i;
}

void LobotSerialServoMove(HardwareSerial &SerialX, uint8_t id, int16_t position, uint16_t time)
{
  byte buf[10];
  if(position < 0)
    position = 0;
  if(position > 1000)
    position = 1000;
  buf[0] = buf[1] = LOBOT_SERVO_FRAME_HEADER;
  buf[2] = id;
  buf[3] = 7;
  buf[4] = LOBOT_SERVO_MOVE_TIME_WRITE;
  buf[5] = GET_LOW_BYTE(position);
  buf[6] = GET_HIGH_BYTE(position);
  buf[7] = GET_LOW_BYTE(time);
  buf[8] = GET_HIGH_BYTE(time);
  buf[9] = LobotCheckSum(buf);
  SerialX.write(buf, 10);
}
// Function to move the servo based on potentiometer reading
void adjustServoAngle(HardwareSerial &SerialX, uint8_t id, int potValue) {
  // Map the potentiometer reading to the servo position (0-1000)
  int position = map(potValue, 0, 1023, 0, 1000);
  // Send the command to move the servo
  LobotSerialServoMove(SerialX, id, position, 500); // Adjust time as needed
}

// Function to read potentiometer value
int readPotentiometer() {
  return analogRead(POT_PIN);
}

void setup() {
  // Initialize serial communication
  Serial.begin(115200);
  // Initialize servo controller
  // You may need to adjust the baud rate and SerialX if necessary
  // For example: LobotSerialServoMove(Serial1, ...)
}

void loop() {
  // Read potentiometer value
  int potValue = readPotentiometer();

  Serial.println(potValue);
  // Adjust servo angle based on potentiometer reading
  adjustServoAngle(Serial, ID1, potValue);
  // Add some delay if needed
}
